DiegoCrUz-afk/Proyecto_Final_Electronica_UNIS/Reduccion2/README.md

# Reducción 2 · miniestación industrial (5 V directos)

Versión de **validación por fases** del proyecto (no es la entrega final): sensor IR, entradas E/G/RESET, pestillo de falla, lógica de decisión, LED de objeto, potencia con motor y LED rojo, alimentada con 5 V.

- **3D para armar y medir** (abre en el navegador): `2_Montaje_3D/Protoboards_3D_reduccion2.html` · en línea: https://diegocruz-afk.github.io/Proyecto_Final_Electronica_UNIS/Reduccion2/2_Montaje_3D/Protoboards_3D_reduccion2.html
- **Guía de pruebas** (40 pruebas, una por una, con la punta roja y la negra): `3_Pruebas/Guia_de_pruebas_Reduccion2.md`
- **Simulaciones y esquemáticos** (LTspice): `1_LTspice/`
- **Resumen de qué está validado y qué no**: `4_Documentacion/LEEME_Reduccion2.md`

Ojo: los valores esperados son de simulación (motor supuesto), no mediciones de la máquina. La potencia y todo lo que dependa del motor real (Steren MOT-125) **no está validado**.
