DiegoCrUz-afk/Proyecto_Final_Electronica_UNIS/CONTEXTO_PROYECTO.md

> Copia sin datos personales de CONTEXTO_SESION.md (sirve para que otra sesion de Claude Code entienda el proyecto). Los nombres de terceros y las rutas del PC estan censurados.

# Contexto: Proyecto Final Electronica UNIS (Miniestacion industrial automatizada)

Ultima actualizacion: 08/11/2026 (LEER la seccion 16 al final: v2 del 3D es la unica vigente, opto, maquina 3D, LED de objeto, motor Steren de 6 V; antes 02/11/2026 seccion 14) (ver seccion 13q al final) (LEER PRIMERO la seccion "12. ESTADO FINAL DE LA SESION 30-31/10/2026 Y PENDIENTES" al FINAL de este archivo, y antes la seccion "AVANCE 30-31/10"; reemplazan al punto 9 "DONDE NOS QUEDAMOS" en lo que se refiere a Multisim. La v6 de Multisim YA esta en el proyecto y en GitHub, commit 423621d). Carpeta: `C:\Users\<usuario>\Documents\Proyecto_Final_Electronica_UNIS`.
Enunciado original: `Enunciado_del_profesor.docx`. Proyecto anterior de referencia (amplificador): `..\electronica-1-amp\claude\CONTEXTO_SESION_ELECTRONICA.md`.

## COMO RETOMAR (leer primero)
- Estimacion de lo que falta: ~2 a 3 horas de trabajo (revisar esquematicos, esquematico jerarquico, Multisim, documento HTML explicativo, BOM, guia de pruebas). Lo mas largo es el documento explicativo.
- Multisim: pedir permiso explicito a Diego para ejecutar el codec ewd/ewe descargado; la prueba vence el 28/10/2026.
- Diego dio autonomia total ("tu elige todo lo mejor, usa LTspice o el MCP de Multisim, continua hasta terminar"). Prioridad de Diego: ENTENDER el esquematico.
- Nada esta corriendo en segundo plano. La simulacion grande ya termino (551 s). Se puede reiniciar el PC sin perder nada.
- Pendiente principal, en este orden: (1) revisar visualmente los 11 esquematicos (`scratch_img\*.png`, ver "Estado de los esquematicos"); (2) crear el esquematico jerarquico del sistema completo (`SISTEMA_COMPLETO.asc`) con simbolos de bloque; (3) Multisim (ver bloqueo abajo; la prueba vence el 28/10/2026); (4) documento explicativo HTML del esquematico por bloques con calculos y capturas; (5) BOM / lista de compras (sin inventar precios); (6) guia de pruebas/mediciones y video/defensa.
- Reglas de trabajo con Diego: responder en espanol, corto, lenguaje sencillo de alumno; no inventar mediciones (separar calculo / simulacion / medicion fisica); documentos sin look de IA; informe solo con datos reales y sin frases de "falta"; Multisim NO se menciona en el informe (solo en archivos de simulacion); componentes faciles de conseguir en Guatemala (La Electronica); no asumir existencias. Los nombres de los demas integrantes los dira Diego al final (hoy solo se sabe Diego; el otro integrante del proyecto anterior era [excompañero del proyecto anterior]; docente del curso anterior: [docente], sin confirmar para este).

## Herramientas, rutas y trampas (verificadas)
- LTspice 26.1.1: `%LOCALAPPDATA%\Programs\ADI\LTspice\LTspice.exe`. Lote: `-b archivo.cir|.asc`; netlist: `-netlist archivo.asc`. El MCP `spice` NO aparece en esta sesion; se usa la linea de comandos.
- Python 3.13: `py -3.13` (tiene PyMuPDF, reportlab; se instalaron numpy y matplotlib). Python 3.12-32 es el del multisim-mcp.
- Libreria de LTspice extraida: `%LOCALAPPDATA%\LTspice\lib` (sym\, sub\). Hay NE555.sub; NO hay modelos de LM358, LM393, LM2907, 74HC, IRLZ44N, BD139 (los modelos propios estan en `modelos.inc`).
- TRAMPA: la PRIMERA linea de un .cir es el titulo y se ignora (un `.include` en la linea 1 no se carga). Siempre empezar con `* comentario`.
- TRAMPA: `.step` con un solo valor da error; `.param` ya definido no se puede redefinir (usar `.step param`). `.meas` con tabla: el log tiene cabecera "step ..." (simlib ya lo maneja).
- TRAMPA: un proceso lanzado con `nohup ... &` desde Bash puede sobrevivir; para simulaciones largas usar `run_in_background` o lanzarlas y esperar (la de 4.6 s tarda ~9 min y genera un .raw de ~800 MB).
- TRAMPA: un interruptor `SW` de prueba con Vt=0/Vh=1m se queda pegado en 0 V; usar Vt=0.5 Vh=0.1.
- Pines de simbolos (verificados): res (16,16)/(16,96); cap, polcap, diode, zener, LED (16,0)/(16,64); npn C(64,0) B(0,48) E(64,96); pnp igual orden C,B,E (emisor abajo); nmos D(48,0) G(0,80) S(48,96); voltage (0,16)/(0,96); current (0,0)/(0,80); OpAmps/opamp2 In+(-32,80) In-(-32,48) V+(0,32) V-(0,96) OUT(32,64); Misc/NE555 GND(-112,-96) TRIG(-112,-32) OUT(-112,32) RST(-112,96) CV(112,96) THR(112,32) DIS(112,-32) VCC(112,-96). Rotaciones: R90 (a,b)->(-b,a); R180 (-a,-b); R270 (b,-a); M180 = espejo vertical.
- LTspice agrega al nombre de subcircuitos el prefijo `X§`; los simbolos propios no deben llevar `SpiceModel` (duplica el modelo en la linea).
- Multisim 14.3 instalado (prueba de 7 dias, VENCE 28/10/2026). `multisim-mcp 1.2.0` en `%LOCALAPPDATA%\Programs\Python\Python312-32\Scripts`, plantillas en `%LOCALAPPDATA%\multisim_pack` (tiene R, C, D, L, NPN, PNP, NMOS, PMOS, opamp5, compuertas dand5/dor5/dnot4, djk7, fuentes, osciloscopio, generador). `multisim-mcp doctor` dice: paquete de plantillas incompleto y codecs `.ms14` ausentes.
- BLOQUEO MULTISIM: el MCP necesita `ewd/ewe` (npm `electronics-workbench-decoder@0.2.0`, ISC, sin dependencias ni scripts de instalacion). El registro npm da ECONNRESET en este PC; se descargaron `ewd.js` y `ewe.js` desde jsDelivr a `%LOCALAPPDATA%\ewtools\dist\` (tamanos coinciden con el listado oficial: 530920 y 535843 bytes; sin llamadas de red/proceso en el codigo). El sistema (clasificador de permisos) BLOQUEO ejecutarlos ("code from external"). NO se debe evadir. Para seguir: pedir a Diego permiso explicito (p. ej. una regla de permiso de Bash o que ejecute el el mismo `multisim-mcp doctor` con `MULTISIM_MCP_EWD/EWE` apuntando a esos .js y `MULTISIM_MCP_TEMPLATE_DIR=%LOCALAPPDATA%\multisim_pack`). Alternativa sin codec: intentar abrir los `.cir` directamente en Multisim (File > Open) o armar a mano.

## AVANCE 26/10/2026 (noche) - hecho en esta sesion
- Revisados a ojo los 9 esquematicos pendientes: bien (Cout y Cd con + hacia el nodo correcto). Detalles esteticos pendientes: etiquetas que se montan en LOGICA/ERROR_AMP/TEMPERATURA/REFVEL (no cambian el circuito). Cpor, Cfv, Cfv2, Cac estan como capacitor sin polaridad (si se usan electroliticos, + hacia v5 / vf1 / vspd).
- Agregado LED rojo + Rl 470 en ALARMA (`Rl f nl 470`, `Dl nl 0 DLED` en sistema.inc y en el generador): el enunciado pide senal luminosa Y acustica. Las simulaciones largas son anteriores al LED (efecto ~8 mA en f, no se repitieron). `comprobar_esquematicos.py`: TODO COINCIDE (11 bloques).
- Creado `3_archivos_tecnicos\generar_sistema.py` -> `2_LTspice\SISTEMA_COMPLETO.asc` (jerarquico, simbolos BLOQUE_*.asy). `LTspice -netlist` lo arma y las conexiones de los 11 bloques coinciden con `sim\sistema_completo.cir`. OJO: LTspice en lote NO expande las hojas BLOQUE_*.asc ("sub-circuit name not defined"); no se probo abrirlo en la interfaz. Para simular se sigue usando `sim\sistema_completo.cir`.
- Prueba pendiente hecha: `sim\sistema_reset_calor.cir` (+ `run_reset_calor.py`, `analisis_reset_calor.py`): reset pulsado 3.40-3.55 s con NTC a 53-54 C NO limpia la falla; f sigue en 1 al enfriarse; reset a 4.20 s con 25 C limpia (1411 rpm a 4.5 s). Disparo termico a t=3.356 s.
- Actualizado `1_Arquitectura\Arquitectura_bloques.html` (sin LM2907, valores finales).
- Creado `4_Documentacion\Explicacion_por_bloques.html` (+ `img\`), `5_Compras_y_Pruebas\BOM_lista_de_compras.csv` (cantidades del esquematico, SIN precios; columnas de precio vacias) y `Guia_de_pruebas.md` (10 pruebas del enunciado con columnas "Medido" vacias).
- Pendiente: Multisim (no se hizo; sigue bloqueado y la prueba vence el 28/10/2026), nombres del equipo, video/defensa, precios reales, borrar `.raw` grandes (`sim\*.raw` ~2.5 GB, `scratch_img`), confirmar con el docente cubierta/encoder/motor, recalibrar con el motor real.

## AVANCE 26/10/2026 (noche, parte 2)
- Simulacion del sistema completo armada desde los esquematicos DIBUJADOS: `sim\armar_desde_asc.py` -> `bloques_desde_asc.inc`, `sistema_desde_asc.cir`, `analisis_desde_asc.py`. Resultados identicos a los de sistema.inc (1394 rpm, 789 rpm con objeto, disparo corriente 2.098 s, temperatura 49.9 C a 3.356 s, cubierta 1.4010 s, v5 5.012-5.018 V). Es la comprobacion de que lo dibujado funciona.
- MULTISIM RESUELTO: el multisim-mcp se maneja desde un cliente stdio propio (`3_archivos_tecnicos\multisim\scripts\mcp_call.py`; variables MULTISIM_MCP_EWD/EWE/TEMPLATE_DIR/WORK_DIR=C:\ms_work); el MCP NO esta registrado en Claude Code. Tool `run_spice_netlist` con commands "op" o "tran 2u 0.2" (sin punto). 11 archivos `multisim\BLOQUE_*.ms14` (abren en Multisim 14.3) y `LEEME_MULTISIM.md` con la tabla de resultados Multisim vs LTspice (todo coincide; 16/16 combinaciones logicas). Cambios de modelo: IRLZ44N -> NMOS nivel 1, NE555 -> 555 de comportamiento. `create_schematic_from_netlist` falla si se pasa `image_path` en ALARMA/POTENCIA (se omitio).
- Borrados los .raw grandes de `sim\` y `scratch_img` (el proyecto pesa ~300 MB). Imagenes de bloques en `4_Documentacion\img`.
- Limite real: el esquematico jerarquico SISTEMA_COMPLETO.asc no se ha abierto en la interfaz de LTspice (en lote no expande las hojas).

## Que es el proyecto
Minibanda transportadora de escritorio sin microcontroladores: motor DC 12 V (<=500 mA), fuente externa 12 V (>=2 A), electronica analogica + compuertas 74HC, montaje final soldado. Entradas: sensor IR (objeto), encoder, shunt, NTC, cubierta. Variables logicas E,G,P,F -> M,N,L,A. Entrega: maquina, esquematico, simulaciones, informe <=15 pags (sin anexos), BOM con costo, video 3-5 min, defensa individual; 10 pruebas en vivo.

## Archivos creados en esta sesion
- `1_Arquitectura\Arquitectura_bloques.html`: diagrama de bloques explicado, guia para leer esquematicos, ecuaciones logicas, lista preliminar de componentes (se escribio antes de decidir los valores finales: revisar contra los valores de abajo).
- `2_LTspice\1_regulador_5V.asc`: prueba del regulador con fuentes (version anterior, hecha a mano). `2_LTspice\BLOQUE_*.asc` (11 bloques) y simbolos `HC_AND2/HC_NAND2/HC_BUF/HC_SCHINV.asy`.
- `3_archivos_tecnicos\`: `modelos.inc` (modelos), `sistema.inc` (subcircuitos de los 11 bloques = FUENTE DE VERDAD del circuito), `simlib.py` (correr LTspice y leer .raw/.log), `asc_lib.py` (generar y dibujar .asc en SVG/PNG con Chrome), `crear_simbolos.py`, `generar_esquematicos.py` (genera los 11 .asc), `comprobar_esquematicos.py` (compara cada .asc con su subcircuito: conexiones y valores), `sim\` (decks y scripts de prueba: `b2_sensor.cir`, `b3_corriente.cir`, `t1_logica.py`, `t2_potencia.cir`, `t3_encoder.cir`, `t4_lazo.py`, `analisis_lazo.py`, `t5_err.cir`, `t7_bloques.py`, `t8_sensor.py`, `sistema_completo.cir`, `analisis_sistema.py`, `sistema_completo_resumen.npz`). El `sistema_completo.raw` (~800 MB) se puede borrar.
- `scratch_img\`: renders PNG/SVG temporales de los esquematicos (se pueden borrar al terminar).
- Los `.net`, `.raw`, `.log` generados en `2_LTspice` y `sim` son temporales.

## DISENO FINAL (valores simulados; nombres = refdes de sistema.inc)
Nodos: vin (12 V), vm (12 V tras D1), v5 (5 V), 0 (tierra). Entrada: V12 -> D1 1N4007 -> vm, Cin 1000 uF en vm. Todos los modelos propios estan marcados en `modelos.inc`.
1. REG5V (vm,v5): Rz 510, DZ Zener 5.6 V (1N4734A), Rtr trimpot 100 ohm en serie con el Zener (ajuste ~10 ohm), Q1 BD139 de paso, Cout 100 uF, C2 100 nF.
2. SENSOR_IR (v5,b,tin,p): LED IR con Rled 270 (~14 mA); fototransistor TCRT5000 (modelo: fuente de corriente en b: 2 uA sin objeto, 50 uA con objeto); R1 47k, R2 10k (Vb 0.82 V), Q2 2N3904 emisor comun, Rc 680, RE 150 (sin puentear), Cac 1 uF (puerto de prueba tin); umbral: Ra 10k + trimpot 10k + Rb 26.8k (20k+6.8k); LM393 con Rpu 10k y Rh 220k (histeresis).
3. SOBRECORRIENTE (vm,v5,sh,setn): Rsh 0.47 ohm 1 W (en POTENCIA), LM358 ganancia 7.8 (Rg 1k, Rf 6.8k), D1 1N4148 + Cpk 100 nF + Rbl 22k (detector de picos), Rd 10k + Cd 10 uF (retardo ~0.1 s), LM393 con referencia Ra 10k + trimpot 10k + Rb 10k (koc=0.2 -> Vref 2 V -> disparo ~0.7 A).
4. TEMPERATURA (v5,tnode,setn): NTC 10k (B 3950) de v5 a tnode, Rfix 10k a tierra; umbral Ra 22k + trimpot 10k + Rb 68k; LM393; Rh 1 Meg (histeresis ~2.6 C).
5. LOGICA (v5,ein,gin,rin,p,setn,m,n,l,f,fn): entradas con Rp 10k a tierra, Rs 10k + C 100 nF, dos inversores Schmitt 74HC14 por entrada; pestillo NAND 74HC00 (setn activa en bajo; reset_n = NAND(rst,setn): el reset solo actua si ya no hay falla); P' = NAND(P,P); 74HC08: M1=E.G, M=M1.F', N=M.P', L=M.P; A=F. Reset automatico al encender (Cpor 1 uF + Rpor 47k + Dpor). setn tiene pull-up 10k (Rsn) y es un AND cableado de los comparadores de corriente y temperatura (colector abierto).
6. PWM_GEN (v5,vctrl,pwm): NE555 astable (Ra5 1k, Rb5 10k, Ct 10 nF, Ccv 10 nF) ~6.9 kHz, rampa en el condensador (1.7-3.3 V); LM393 compara vctrl con la rampa; Rpu 10k.
7. POTENCIA (v5,vm,pwm,m,dm,sh): 74HC08 AND(pwm,m); seguidor complementario Q3 2N3904 / Q4 2N3906 desde 5 V; Rg 47, Rpd 10k; M1 IRLZ44N (nivel logico; NO usar IRF540N/IRFZ44N sin driver de 12 V); Dfw 1N5819 de dm a vm; Rsh 0.47.
8. ENCODER_FV (v5,enc,vspd): LED del optointerruptor Rled 220; fototransistor con Rpe 10k; LM393 (Ru1/Ru2 10k, Rhe 1 Meg); derivador Cd 1 nF + Rtg 10k + Dcl 1N4148; NE555 monoestable (Rt7 20k, Ct7 10 nF -> 220 us); buffer HC; filtro RC doble (10k+1 uF, 10k+1 uF). Vspd = 5 V x 220 us x f = 1.1 mV/Hz. Disco de 20 ranuras.
9. REFVEL (v5,l,vref): Rt 68k + trimpot Rp1 10k (kvn 0.8 -> Vref 0.526 V); Q5 2N3904 conectado por l con Rb5 10k pone Rp2 (10k, kvr 0.7) en paralelo -> reducida ~50 %.
10. ERROR_AMP (vm,v5,vref,vspd,vctrl): LM324 (4 amplificadores): 3 seguidores (Xbr, Xbs, Xbo) + resta Xu2b: vctrl = Kerr(vref-vspd)+Voff, Kerr=10 (R 10k/100k, Cf6 10 nF), Voff = 4.7k/5.1k desde 5 V = 2.6 V, Ro 1k + Cvc 100 nF. Lazo abierto = alimentar vctrl con un trimpot.
11. ALARMA (vm,f): Rb 1k, Q6 2N3904, buzzer 12 V (modelo Rbz 400 ohm). Ic/Ib = 7.5 (saturado).
Motor de simulacion (supuesto, NO es el motor real): Ra 12 ohm, La 3 mH, Ke=Kt=0.035 V.s/rad, J 1e-5, B 7.2e-6, carga 0.004 N.m (+0.004 de perturbacion), encoder 20 ranuras. Cuando se elija el motor real hay que recalibrar el trimpot de sobrecorriente y la referencia.
Chips: LM324 x1 (o 2 LM358) + LM358 x1 para el shunt; LM393 x2 (o LM339+LM393); NE555 x2; 74HC00, 74HC08 x2, 74HC14 x1. LM2907 NO se usa (se sustituyo por 555 monoestable + RC).

## RESULTADOS DE SIMULACION (todos son LTspice, no mediciones fisicas)
- Regulador (Vin 11-13 V, carga 30-120 mA, hFE 40-250): Zener 5.6 exacto 4.84-4.95 V (cumple 5 V +-5 %); Zener -5 % sin ajuste 4.56-4.68 V (NO cumple) y con Rtr 38-45 ohm 4.79-5.23 V (cumple); Zener +5 % 5.11-5.23 V (al limite). Disipacion del BD139 en el peor caso (13 V, 120 mA): 0.85-0.92 W -> disipador. En el sistema completo con motor: v5 = 5.012-5.018 V, vm minimo 11.13 V, I(D1) max 0.95 A.
- Sensor IR (hFE 100/200/400): sin objeto Vc 4.30/4.17/4.08 V, p=0.03 V; con objeto 50 uA Vc 3.22/2.86/2.61 V, p=4.93 V; umbrales 3.30 (baja) / 3.52 V (sube); Vce con objeto 2.1-2.8 V (sin saturacion; satura recien a >100 uA); corriente de 5 V del bloque ~15.5 mA. Ganancia AC -3.95 (11.9 dB, fase 180), Zin ~6.7 kohm (con Cac), Zout ~Rc 680 ohm.
- Sobrecorriente: disparo ~0.71 A (Vref 2.0 V); arranque 1.5 A durante 30 ms -> Vdl max 1.11 V (no dispara); 0.55 A sostenido no dispara (1.47 V); 0.9 A sostenido dispara a los 56 ms. En el sistema completo disparo a t=2.098 s (carga extra desde 1.9 s, Im max 0.82 A).
- Temperatura: umbral ajustable de 44.0 C a 56.8 C (cursor 0.02 a 0.98), centro 49.9 C; histeresis 2.5-2.7 C. En el sistema: disparo a 49.9 C.
- Logica: tabla de verdad de 16 combinaciones de E,G,P,F verificada con el circuito real (pestillo, reset, Schmitt): TODAS OK. El reset solo limpia cuando ya no hay falla.
- PWM y potencia (abierto): Vctrl 2.4 V -> ciclo 0.44 (teorico (2.4-1.67)/1.67); compuerta 0 a 4.36 V, Vds max 11.5 V.
- Encoder + F-V: lineal 1.1 mV/Hz (100 Hz 0.119 V, 500 Hz 0.557 V, 1 kHz 1.106 V), rizado 14-26 mV pp con el filtro doble.
- Lazo cerrado (motor supuesto): normal 147 rad/s (1403 rpm), error 2 % respecto a la referencia; reducida 82.4 rad/s (786 rpm) = 56 % de la normal; con carga extra baja 6.5 % (lazo ABIERTO con el mismo vctrl: baja 25.9 %); arranque al 95 % en 0.08 s, sobreimpulso 18 %, corriente de arranque 0.88 A; estabilizacion tras el cambio normal->reducida 0.19 s.
- Sistema completo (guion de eventos, 4.6 s): normal 1394 rpm Im 0.150 A; objeto presente: L=1, N=0, 789 rpm; objeto retirado 1415 rpm; cubierta abierta (t=1.40 s): M cae en 1.4010 s (motor 0 A); cubierta cerrada: reanuda 1392 rpm; falla de corriente: f=1 (alarma 4.8 V), M=0, motor parado, la falla sigue despues de quitar la carga; reset a 2.6 s limpia (1409 rpm); falla de temperatura a 49.9 C; el reset de 3.55-3.70 s fue efectivo porque el NTC ya habia bajado de ~47 C (esperado: el reset solo actua cuando la causa desaparecio). PENDIENTE: repetir la prueba de "reset con calor" pulsando el boton entre 3.40 y 3.55 s para mostrar que NO limpia mientras hace calor.
- Observacion: con el motor parado por falla, vctrl del amplificador de error sube a 7.65 V (sin integrador, no hay windup); al reanudar no hay golpe.

## ESTADO DE LOS ESQUEMATICOS
- `generar_esquematicos.py` genera los 11 `BLOQUE_*.asc` (con pines de bloque marcados con *); `comprobar_esquematicos.py` dice TODO COINCIDE (conexiones y valores iguales a sistema.inc; los capacitores se comparan sin polaridad: revisar a ojo los electroliticos: Cin, Cout, Cd, Cpor deben tener + hacia el nodo de mayor voltaje).
- Revisados visualmente: SENSOR_IR y POTENCIA (bien). Falta revisar a ojo: LOGICA, ENCODER_FV, ERROR_AMP, SOBRECORRIENTE, PWM_GEN, REG5V, TEMPERATURA, REFVEL, ALARMA (ya se re-renderizaron en `scratch_img`). Detalles a pulir: etiquetas que se montan, texto largo.
- Falta el esquematico del sistema completo (jerarquico con simbolos de bloque en `crear_simbolos.bloque()`, ya definida) y probar que `LTspice -netlist` lo arma. Los .asc de bloque son "puros" (sin fuentes): para simular se usa `sim\sistema_completo.cir`.

## Decisiones tomadas por la IA (Diego delego)
- Sin modulacion del LED IR (acople en continua, corriente inyectada en la base); regulador con trimpot de ajuste; LM2907 reemplazado por 555 monoestable; MOSFET de nivel logico con excitador complementario a 5 V (seguro: si falla el 5 V el MOSFET queda apagado); reset con POR; cubierta NO enclava (solo corta M); alarma = F.
- Falta confirmar con el docente: si la cubierta debe enclavarse; si el encoder puede ser un modulo con comparador; que motor usar.

## Inventario y compras
- Del proyecto anterior (cantidades sin confirmar): resistencias 10 a 1M casi todos los valores comunes; 2N3904 x5, 2N3906 x5, 1N4148 x10, 1N4007 x6, electroliticos 1 uF x5 y 10 uF x5, 100 uF, 1000 uF, 100 nF, 470 pF, BD139/BD140 x2 c/u, trimpot 3296W 100 ohm x2, 2N7000 x3, bocina 4 ohm. Equipo: NI ELVIS II, Rigol DP832, Analog Discovery 3, multimetro, bateria 9 V.
- Hay que comprar (no estan en el inventario): Zener 5.6 V 1N4734A, NE555 x2, LM324 (o LM358 x2), LM393 x2, 74HC00/08/08/14, IRLZ44N (o IRL540N/IRLZ34N), 1N5819 x2, Rsh 0.47 ohm 1 W, 220 ohm/270 ohm/47 ohm/22k/6.8k/56... (revisar con la lista), trimpots multivuelta 10k x5, NTC 10k, TCRT5000 (o LED IR + fototransistor), optointerruptor ranurado + disco de 20 ranuras, microswitch/lengueta, pulsador, interruptor, buzzer activo 12 V, LEDs, capacitores 10 nF/1 nF/1 uF, disipador TO-126/TO-220, motor DC 12 V con caja reductora, placa perforada, borneras, jack, fusible. Sin precios hasta tenerlos reales.

## Equipo
Diego + otros integrantes (Diego los dira al final).

## AVANCE 27/10/2026 (madrugada): jerarquia LTspice, Multisim completo y 3D
- LTspice jerarquico RESUELTO: los simbolos BLOQUE_*.asy NO deben llevar `SYMATTR Prefix/Value` (con eso LTspice lo trata como subcircuito normal). Cada hoja BLOQUE_*.asc lleva su `.param` (kir, koc, ktm, kvn/kvr, Kerr). `SISTEMA_COMPLETO.asc` trae fuente, eventos, NTC y motor y simula tal cual (`sim\run_jerarquico.py`, `analisis_jerarquico.py`): mismos resultados que sistema.inc.
- Multisim sistema completo: `multisim\scripts\ms_sistema.py` (555 de comportamiento, NMOS, compuertas suavizadas, `uic`); llego a 0.185 s (memoria): arranque, objeto, cubierta OK. Falla/temperatura/reset solo por bloque y en LTspice. Detalle en `multisim\LEEME_MULTISIM.md`.
- 3D: `6_Montaje_3D\Montaje_3D_miniestacion.html` (ver LEEME.md de esa carpeta). Codigo en `3_archivos_tecnicos\montaje3d\`. El modo funcionamiento usa `sim\sistema_desde_asc_resumen.npz`. Basado en el 3D del proyecto del amplificador (`electronica-1-amp`).
- Para abrir el 3D desde el navegador de Claude: `py -m http.server` en `6_Montaje_3D` y abrir http://127.0.0.1:8765/... (el Chrome headless se cuelga con WebGL).

## AVANCE 27/10/2026 (final de sesion)
- Diseno: MOSFET IRFZ44N (modelo IRFZ44N_P en modelos.inc) y shunt 0.5 ohm 5 W, porque La Electronica no vende IRLZ44N ni 0.47 ohm; sistema re-simulado OK (1393/789 rpm, disparos y reset). Compras solo en La Electronica (Tettsa = respaldo). Resistencias: todas con valores que Diego ya tiene (150=100+47, 270=220+47, 22k=20k+2k).
- LTspice: `2_LTspice\SISTEMA_COMPLETO.asc` = esquematico completo en una hoja con cables (se simula con Run, verificado); `SISTEMA_JERARQUICO.asc` = version por hojas. Cableado automatico: `asc_route.py`. Bloques con `.param` propios.
- PCB: `3_archivos_tecnicos\pcb\` (generar_pcb.py): 10 placas de cobre de 10x10 cm (la mas grande de la tienda), 1 cara, planchado; salida en `pcb\salida` (PDF espejo, componentes, taladros). Verificado por conectividad.
- 3D: `6_Montaje_3D\Placas_de_cobre_3D_miniestacion.html` (pistas, vista de cobre, modo funcionamiento) y `Montaje_3D_miniestacion.html` (prototipo con cables) con boton para cambiar entre ambos. PENDIENTE: version protoboard real (tiras de 5 agujeros).
- Compras: `5_Compras_y_Pruebas\Lista_de_compras_La_Electronica.pdf` (precios reales 27/10/2026).
- Multisim: los .ms14 generados salen con cajas genericas y layout feo; PENDIENTE hacerlos nitidos (el generador acepta OPAMP5 nativo con `X... LM358`, compuertas nativas con lineas `A... AND/NAND/NOT`, 555 con 8 nodos y modelo NE555; fuentes como `DC 12`). No usar V sin `DC`.

## ESTADO FINAL 27/10/2026 + PENDIENTES (leer primero al retomar)
Pedidos de Diego (todos vigentes): usar SOLO componentes de La Electronica (Tettsa = respaldo/investigar); usar las resistencias que ya tiene (valores del amplificador, ver arriba); placa de cobre de la tienda = 10x10 cm (la mas grande), sin perforar (Diego hace los agujeros, planchado); no crear archivos raros (.net/.raw/.op/.csv/.log) en las carpetas de entrega: solo lo que abre normal (.asc/.asy/.ms14/.pdf/.html/.png); verificar siempre que abre; ahorrar tokens (respuestas cortas).
HECHO: LTspice SISTEMA_COMPLETO.asc (hoja unica con cables, simula con Run; resultados 1393/789 rpm, disparos y reset OK) y SISTEMA_JERARQUICO.asc; 2_LTspice limpiada; PCB 10 placas 10x10 cm (pcb\salida); 3D de placas de cobre con pistas, vista de cobre y modo funcionamiento + 3D "prototipo con cables" con boton para alternar; lista de compras PDF (Q595.50, La Electronica); diseno con IRFZ44N y shunt 0.5 ohm 5 W.
PENDIENTE (orden): (1) 3D en PROTOBOARD REAL (2 a 4 protoboards, tiras de 5 agujeros, canal, rieles, cables numerados) como guia junto al esquematico, con boton a vista de placa de cobre; lo actual no se ve como protoboard. (2) Multisim NITIDO: .ms14 con piezas nativas (op-amps `X... LM358` 5 nodos; compuertas `A... AND/NAND/NOT`; 555 `X` 8 nodos NE555; fuentes `DC 12`), osciloscopio, y verificar que abren y corren en Multisim; los .ms14 actuales (3_archivos_tecnicos\multisim) salen con cajas genericas y desorden. En Multisim se pueden crear componentes si falta alguno. (3) Revisar a ojo que el esquematico de LTspice se entienda (p. ej. BLOQUE_ERROR_AMP desacomodado). (4) Consultar Tettsa (tienda.tettsa.gt) como respaldo. (5) Medir corriente del motor (la tienda no la publica; max 500 mA).
Herramientas: tienda = Chrome en laelectronica.com.gt con fetch a /search/suggest.json?q=... (leer salida en trozos de <800 caracteres); regenerar 3D: pcb\exportar_pcb3d.py y montaje3d\exportar_montaje3d.py; PCB: pcb\generar_pcb.py (~3 min); lista de compras: 5_Compras_y_Pruebas\generar_lista_de_compras.py.

## AVANCE 27/10 (mañana) - cierre
- Multisim: los 11 BLOQUE_*.ms14 con piezas nativas y acomodo ordenado; abren todos (open_circuit). Causas de los fallos: open_after_build=True fallaba en ERROR_AMP; el 555 se arma con partes (ne555() en multisim/scripts/ms_nativo.py); nodos/modelos con {B3904} se reemplazan por 200. Las imagenes necesitan open_circuit antes de get_circuit_image.
- Corregido en docs/3D: shunt 0.5 ohm 5 W, MOSFET IRFZ44N (Explicacion_por_bloques, Guia_de_pruebas, etiquetas 3D). LEEME del 3D reescrito (protoboards + 3 placas de cobre de una cara).
- pcb/salida verificado: solo placas A, B, C. Pendiente real: medir corriente del motor (<=500 mA) con el motor comprado.

## AVANCE 27/10 (cierre final)
- 555 en Multisim: armado con partes nativas (ne555() en 3_archivos_tecnicos/multisim/scripts/ms_nativo.py; posiciones en ms_lay.py). Probado en el motor de simulacion con comparadores/compuertas de comportamiento: PWM_GEN oscila ~6.6 kHz (LTspice 6.9 kHz); ENCODER_FV genera pulsos y vspd sube hacia ~0.56 V a 500 Hz. Los .ms14 no tienen sondas, asi que no se corrieron en el motor propio de Multisim. Los 11 .ms14 abren.
- LTspice: BLOQUE_ERROR_AMP recableado (Rf6, Cf6, R4 con cables; coordenadas en rejilla de 8; antes 700 caia fuera de rejilla y el router perdia la conexion). SISTEMA_COMPLETO/JERARQUICO regenerados; comprobar_esquematicos.py = TODO COINCIDE. Nodo voff queda por etiqueta.
- Limpieza: borrados .net (los crea comprobar_esquematicos.py en 2_LTspice, borrarlos despues), .cir de sim, __pycache__.
- Pendiente (para cuando se compren los materiales): medir corriente del motor (<=500 mA) y recalibrar.
- Revision visual de los 11 bloques LTspice (render con asc_lib.render_svg + fitz): todos conectados con cables. Se cablearon a mano TEMPERATURA (tnode, ref, Rh), SOBRECORRIENTE (ref), PWM_GEN (TRIG del 555 a tri), ENCODER_FV (Rhe a eref) y ERROR_AMP (voff). El router sigue listando esas redes como "sin cablear" porque no reconoce los cables manuales; comprobar_esquematicos.py da TODO COINCIDE.
- Multisim: create_schematic_from_netlist con probe_nets no genera salidas utilizables por run_transient (enum_outputs vacio), asi que los .ms14 no se pueden correr por herramienta; para correrlos en Multisim hay que poner un osciloscopio a mano.

## AVANCE 27/10 (esquematico unico)
- LTspice: SISTEMA_COMPLETO.asc ahora une los bloques con CABLES (22 redes entre bloques) y no solo etiquetas; v5, vm y GND siguen como etiquetas/simbolos. Se arreglaron coordenadas fuera de rejilla de dibujar_externos (generar_sistema.py) y asc_route.py ya no toca redes fuera de rejilla (las deja con etiqueta). Netlist verificado igual (98 redes, misma particion) con LTspice -netlist. PNG: 2_LTspice/SISTEMA_COMPLETO_esquematico.png (generado con asc_lib.render_svg + fitz, dpi 100).
- Multisim: MULTISIM_MCP_SHEET="ancho,alto" fija el tamano de hoja; ms_lay.layout() normaliza posiciones para que todo quede dentro (rieles a y=80, piezas desde x=100). ms_full.py arma SISTEMA_COMPLETO.ms14 (hoja 14061x1736, 153 piezas). No se simulo en el motor de Multisim (los .ms14 no tienen sondas).
- Verificacion de Multisim con su propio reporte de netlist (report_netlist): todas las redes coinciden con la esperada; v5 y GND difieren solo por las patas de alimentacion implicitas de las compuertas digitales. Guia de componentes: 4_Documentacion/Guia_de_componentes.html (generar_guia_componentes.py). PDF de placas copiados a 7_PCB_placas_de_cobre.
- LTspice: ahora v5, vm y GND tienen RIEL dibujado en cada bloque (asc_route.buses, se llama desde guardar()) y la hoja completa une los rieles v5 y vm entre bloques con cable; GND entre bloques queda con simbolos de tierra (el router no pudo unirlo). Netlist de la hoja completa verificado igual (98 redes). Pines fuera de rejilla (comparadores/NE555 en x=668, etc.) siguen con etiqueta. NE555 del bloque PWM movido a x=296 para quedar en rejilla.
- PCB regenerado (27/10 tarde): CLEAR 1.0 mm, pistas 1.0 mm, pads 1.8 mm, separacion minima entre pistas 2 celdas (2.54 mm centro a centro), margen 4 agujeros (10 mm), GND rayado cruzado 45 grados (zona rayada = tierra, pads de GND en azul en componentes), nombres de red junto a cada pad, y PLACA_X_guia_de_conexiones.pdf (a donde va cada pata + cables entre placas). Medidas: A 137.2x172.7 (21 puentes), B 137.2x193.0 (48), C 137.2x188.0 (33). generar_pcb.py tarda ~14 min. Los agujeros de la fila de arriba son los puntos de union entre placas (conectados a las piezas con puente de alambre, lineas magenta).
- Multisim: SC=1.9 en ms_lay.py, fuentes de prueba en columna izquierda, R/C horizontales solo si lo son en LTspice. Revision visual: legible pero con cables largos; Rg/Rpd de POTENCIA siguen muy juntas (conflicto de anclaje de simbolos horizontales).
- Multisim: ms_post.py retoca los .ms14 (decode_ms14 -> XML: Wire Width=3, Show Node Names=1, Pen-Width de cables=3 -> encode_ms14) para que los cables y los nombres de red se vean. decode_ms14 puede dejar un .xml junto al .ms14: borrarlo. Si se regeneran los .ms14 con ms_lay.py / ms_full.py hay que volver a correr ms_post.py y copiar.
- LTspice hoja completa: generar_sistema_plano.py ya NO une v5/vm entre bloques con cables largos y solo cablea redes entre bloques de hasta MAXLEN=1900 unidades (10 redes); las demas quedan con etiqueta. Netlist igual (98 redes). Multisim hoja completa: ms_full.py da a cada red entre bloques de 3+ pines un riel propio arriba (11 redes) y luego hay que correr ms_post.py; sigue con cables largos y cruces (limite del generador); la lectura clara es la de LTspice y los bloques sueltos.
- Multisim: ms_lay.separar() empuja las piezas que quedan montadas (tamanos aproximados por tipo) y el 555 armado usa una cuadricula de 5 columnas (300 x 250); luego ms_post.py. Revisado a ojo: POTENCIA (Rg/Rpd ya separadas), SENSOR_IR (Cac fuera de R2) y ENCODER_FV (partes del 555 separadas).
- PCB: Diego prefirio el diseno ANTERIOR del cobre (pistas 0.8 mm, separacion 0.5 mm, margen 3 agujeros, GND liso). Se volvio a ese diseno (132.1 x 167.6/188.0/182.9 mm; 19/49/29 puentes). Se conservaron solo los extras que no cambian el cobre: nombres de red en la vista de componentes, pads de GND azules y PLACA_X_guia_de_conexiones.pdf. La version con rayado/mas separacion esta guardada fuera del proyecto (no se entrega).

## Multisim: cables y rendimiento (27/10, tarde)
- ms_lay.py: cada red de 3+ pines tiene su propio carril (`canales()`), y `distintas_x()` evita que dos patas compartan columna (no se montan cables verticales). ms_post.py ya no activa "Show Node Names" (era lo que mas pesaba).
- Se regeneraron los 11 bloques + SISTEMA_COMPLETO y su PNG. Respaldo de la version que el usuario guardo a las 16:21: C:\ms_work\respaldo\SISTEMA_COMPLETO_usuario_1621.ms14 (fuera del proyecto).
- LED de banda (Rbanda 1k + Dbanda DLED, vm->nbanda->dm) agregado a BLOQUE_POTENCIA y SISTEMA_COMPLETO (ms_nativo.TB POTENCIA y ms_full ext). Se comprobo que el .ms14 que el usuario guardo (18:59) tenia las mismas posiciones que el generado, asi que se regenero (respaldo en C:\ms_work\respaldo\SISTEMA_COMPLETO_usuario_1859.ms14). Corriente del LED calculada a mano (~10 mA con el MOSFET encendido), no simulada.

## Decision: todo en protoboard (27/10)
- Ya no se hacen placas de cobre. Lista de compras sin placas de cobre, cloruro, papel, brocas ni pinheads (total Q503.75, antes Q629.25). Nada se compro en Tettsa. 7_PCB y la pagina 3D de cobre quedan como referencia.
- Lista: +2 paquetes Jumper 30 cm MxM (Q10 c/u, La Electronica, en existencia) para unir protoboards; total Q523.75. 3D: 20 uniones entre protoboards y 20 a piezas externas.
- Lista: quitados jumpers y borneras (el usuario ya tiene cable de protoboard y jumpers; sin placa no hay borneras). Total Q503.75 - borneras.

## Estado final (27/10/2026)
- Montaje: todo en protoboard (5 protoboards segun el 3D) con alambre de protoboard y jumpers que ya se tienen. No hay placas de cobre; la carpeta 7_PCB y la pagina 3D de cobre quedan solo de referencia.
- Compras: solo La Electronica, total Q493.75 (5_Compras_y_Pruebas/Lista_de_compras_La_Electronica.pdf).
- LTspice: 2_LTspice (esquematico completo + bloques + PNG). Multisim: 3_archivos_tecnicos/multisim (11 bloques + SISTEMA_COMPLETO; SISTEMA_COMPLETO_con_LED tiene el LED que indica banda funcionando; hoja agrandada para mover cables).
- Documentos: 4_Documentacion (guia de componentes, explicacion por bloques). Pruebas: 5_Compras_y_Pruebas/Guia_de_pruebas.md. 3D: 6_Montaje_3D.

## AVANCE 28-29/10/2026: lista solo protoboard, GitHub, Multisim
- Lista de compras SOLO protoboard (total Q495.00, PDF regenerado): jack de panel 5.5x2.5 (Q4, con cables), switch toggle SPDT 6 A (Q6), pulsador 6x6x15 de 4 pines (Q1), portafusible aereo 5x20 (Q5), CE100 de 25 V (Q1.25), estano 0.8 mm (Q3/m, agregado porque hay piezas con cables). Quitados del archivo de precios: placas de cobre, cloruro, papel, brocas, borneras. Generador sin codigo de placas. Arquitectura_bloques.html y 6_Montaje_3D/LEEME.md corregidos (montaje en protoboard).
- Precios y existencias revisados en laelectronica.com.gt (Chrome "DIEGO_CRUZ", 28/10). Todo lo de la lista existe. Sin confirmar: motorreductor 12 V 60 RPM (Q34) no aparecio en la busqueda (salio un N20 12 V 200 RPM a Q55). Fusible de 1 A de 5x20 no aparece (hay 0.5 A de 6x30 y 10 A de 5x20).
- Revision del esquematico contra la lista: cantidades y valores coinciden. Pendientes de decidir: (1) el LED de banda (Rbanda 1k + Dbanda) esta solo en Multisim, no en sistema.inc, y la lista trae un solo LED (el de alarma); (2) 5 LM393 en 5 chips y 3 chips 74HC08 (uno por bloque) se podrian reducir a 3 y 2 (unos Q13); (3) IRFZ44N con compuerta a ~4.3 V: medir Vds con el motor real.
- GitHub: commit 3903778 "Lista de compras solo para protoboard: quitar piezas de placa" subido a origin/main (DiegoCrUz-afk/Proyecto_Final_Electronica_UNIS). CONTEXTO_SESION.md y el enunciado estan en .gitignore y NO se suben (llevan nombres de terceros y rutas). El jack tambien se podria soldar con cables; no hay adaptador hembra a bornera en la tienda.
- Multisim 14.3 (prueba renovada por Diego a 48 dias). multisim.exe es de 32 bits: se aplico el parche Large Address Aware (hasta 4 GB) con `parche_multisim_4GB.ps1` (como administrador, con UAC). Respaldo del original: C:\ms_work\respaldo\multisim.exe.original; para deshacer, correr el script con -Deshacer. Diego dice que el parche ayudo. Se cerraron Epic, EOS overlay y Phone Experience (RAM libre 5.77 -> 6.12 GB).
- PROBLEMA ABIERTO: SISTEMA_COMPLETO.ms14 se cierra solo al empezar a crear un cable (se queda cargando y se cierra). Registro de Windows: acceso invalido (0xc0000005) en Od101dll.dll, mismo punto (desplazamiento 0x47278) el 28/10 19:08 y el 29/10 01:33 (este ya con el parche); el 27/10 20:03 fue parecido. Hoja del archivo: 18960 x 4754 (el dibujo llega a ~17460 x 2354); 1741 objetos, 494 cables, ancho de cable 3. Diego NO quiere dividir el esquematico ni achicar la hoja de ancho.
- Copias de prueba (fuera del proyecto, en C:\ms_work\prueba, abren bien en ~70 s): SISTEMA_C_hoja_18960x3000.ms14 (ancho completo, altura 3000), SISTEMA_A_ancho_global_1.ms14 (cables nuevos de ancho 1), SISTEMA_B_ancho_1_todo.ms14 (todos los cables de ancho 1). Falta que Diego diga cual NO se cierra al crear un cable. Si una funciona, pasarla como archivo principal con respaldo del original. Otra prueba: desactivar autowire en Options > Global Options > Preferences. No se pudo reproducir el cierre desde aqui (no hay control de la ventana de Multisim).
- Aviso: decode_ms14 deja un .xml junto al .ms14 que se lee (se borraron los de multisim\). El proyecto quedo con 0 archivos sin guardar en git tras todo esto.

## AVANCE 29-30/10/2026 (noche): cierre de Multisim, patas tapadas por cables, esquematico horizontal  (LEER COMPLETO)
Todo este bloque se hizo FUERA de la carpeta del proyecto. El proyecto y GitHub NO se tocaron (el esquematico bueno aun no esta en el proyecto).

### 1. El problema que costo que Claude entendiera (la explicacion que faltaba)
- Sintoma que veia Diego: en Multisim, una pieza (ej. R1 de 47k en SENSOR_IR) parece tener UNA pata sin cable (se ve un cuadrito azul en la pata de abajo y ningun cable sale de ahi). Al intentar tirar o mover un cable ahi, Multisim se congela y se cierra.
- Error mio al inicio: en el video vi la pata "sin cable" y dije que probablemente estaba suelta (sin conectar). ERA FALSO. Diego averiguo la causa real: la pata SI esta conectada, pero el cable de esa pata queda DIBUJADO ENCIMA de otro cable (o encima de la propia pieza), asi que visualmente parece que no hay cable. Eso pasa con muchas piezas, no solo con R1.
- Causa de fondo (confirmada en el PNG ampliado y en el esquematico regenerado): el generador ponia R/C en VERTICAL cuando eran verticales en LTspice. Una pieza vertical tiene las dos patas en la misma columna x; el cable de la pata de abajo sube por esa misma columna hacia el riel de arriba y pasa POR ENCIMA del cuerpo de la resistencia y de su otra pata. Por eso se ve "sin cable". Los cables montados unos sobre otros tambien son lo que no deja mover un cable a mano y probablemente lo que dispara el cierre.
- Solucion que Diego propuso y que funciono: poner TODAS las resistencias y capacitores en HORIZONTAL. Cada pata saca su cable hacia arriba por su propia columna y ningun cable tapa a otra pata.
- Por que costo entenderlo (para no repetirlo): (a) el video/captura solo muestra "pata sin cable", no "cable encima de la pieza"; (b) mi analisis automatico del XML calculaba mal la geometria: asumia pines horizontales segun Transformer-M00..M21 (identidad) y daba R1SEN horizontal, cuando en pantalla es vertical (la rotacion no esta en esos Transformer del CIITSymbolComp; solo coincidian 140 de 445 patas con extremos de cables). Conclusion: NO confiar en el XML decodificado para decidir que pata esta tapada; la verificacion confiable es VISUAL, sobre el PNG que genera Multisim (get_circuit_image) recortado y ampliado. Diego tenia razon al pedir "verificalo perfectamente" y al decir que yo no notaba esos cables.

### 2. Evidencia del cierre (para no volver a investigar)
- Video: `C:\Users\<usuario>\Videos\Captures\SISTEMA_COMPLETO - Multisim - [SISTEMA_COMPLETO _] 2026-10-29 22-26-16.mp4` (24 s). Se ve R1 con cuadrito azul en la pata de abajo, el cursor de cable (+) y la pantalla congelada desde 22.9 s hasta el final. Para verlo se sacaron fotogramas con OpenCV (instalado en una carpeta temporal de la sesion; Claude no lee .mp4 directo y ffmpeg no esta instalado).
- Registro de Windows (Application, Id 1000): multisim.exe 14.3.1500.0, modulo Od101dll.dll, excepcion 0xc0000005, desplazamiento 0x47278 en TODOS: 28/10 19:08, 29/10 01:33, 29/10 22:26 (el del video), 22:34 y 30/10 00:20. Mismo punto siempre, en la ruta de C:\ms_work y tambien en Documentos => NO depende de la carpeta; es un fallo interno de Multisim con este esquematico.
- Las 3 copias de prueba del archivo viejo (A, B, C en C:\ms_work\prueba) NO resolvieron el cierre (Diego probo C: mismo problema; B se abrio despues). Autowire off no se probo.

### 3. Lo que se hizo
- Se copiaron los scripts (mcp_call, ms_nativo, ms_lay, ms_full, ms_post) a una carpeta de sesion y se cambio SOLO en la copia: ms_lay.py agrega `vert.clear()` antes de `separar(pos, vert)` y ms_full.py cambia `vert += ["Rmot", "Rbanda"]` por `vert.clear()` (todo R/C horizontal), y las rutas de salida pasan a `C:\ms_work\horizontal\`. Se corrio ms_full (hoja 18005 x 2354, 156 piezas, incluye Rbanda/Dbanda = LED de banda) y luego ms_post (ancho de cable 1, nombres de red ocultos, 498 cables). Abre bien (open_circuit sin errores). Los scripts originales del proyecto NO se modificaron.
- Verificacion visual (get_circuit_image -> recortes): R1, R2, RcSEN, RESEN, RpuSEN, RhSEN, RfOC, RgOC, CacSEN y Q2 quedaron con las dos patas visibles y sin cables encima.
- Resultado para Diego: "funciono mil veces mejor": podia tocar un cable y se auto-ordenaba, sin cierres durante unos 20 min (22:57 a 23:15). Diego ademas arreglo a mano algunos cables de compuertas y guardo a las 23:15 (ese guardado es el bueno).
- Revision de lo guardado a las 23:15: R y C bien. Quedan MAL (cables encima o pegados a las patas; marcados con circulos en REVISION_marcado.png): 1 Xu1SEN (no verificado ampliado); LOGICA 2-9 Ag1-4LOG y Aa1-4LOG; PWM 10-13 A5bPWM, A5cPWM, A5dPWM, A5ePWM (cuatro compuertas seguidas con cables encimados) y 14 Xu6PWM; ERROR_AMP 15 XbrERR, 16 RzbrERR, 17 XbsERR, 18 XboERR, 19 RzboERR. Tambien hay muchos cables largos y cruces entre los rieles de arriba y los bloques de abajo (conectan bien pero cuesta leerlos).
- Tecnica de los circulos: centro = promedio de las patas leidas del XML; para los amplificadores (X...) hubo que sumar (+450, +190) porque el XML da mal su centro. La imagen es la hoja a escala 1:1 (18005 x 2354 px).

### 4. Archivos y rutas (donde esta cada cosa AHORA)
- CARPETA DE TRABAJO NUEVA (pedida por Diego, mas facil de encontrar): `C:\Users\<usuario>\Documents\Pruebas_Multisim\` con `esquematico_actual\SISTEMA_COMPLETO.ms14` (el bueno, copia del de las 23:15; Diego lo abre y guarda ahi), `imagenes_revision\REVISION.png` y `REVISION_marcado.png`, `respaldos\SISTEMA_COMPLETO_horizontal_usuario_2315.ms14`. Se le abrio en Multisim a las ~00:30 del 30/10.
- `C:\ms_work\` esta en la raiz del disco C: (por eso Diego no lo encontraba). Ahi quedan: `horizontal\` (original de 23:15 + "Security copy" automatica de Multisim), `revision\`, `respaldo\`, `post_h\`, `prueba\` (copias A/B/C del archivo viejo). El MCP de Multisim sigue usando C:\ms_work como carpeta de trabajo.
- Si Diego guarda en Documentos, el de `C:\ms_work\horizontal` queda desactualizado: trabajar siempre con el de Documentos.
- El proyecto aun tiene los viejos: `3_archivos_tecnicos\multisim\SISTEMA_COMPLETO.ms14`, `SISTEMA_COMPLETO_con_LED.ms14` y `SISTEMA_COMPLETO_multisim.png`.

### 5. Pendiente (en este orden)
1. Que Diego guarde con Ctrl+S tras cada arreglo y haga copias con hora; reportar si el cierre se repite en una pieza/pin concreto.
2. Arreglar los 19 puntos marcados (Diego a mano, o Claude en una COPIA editando el XML; nunca sobre el archivo abierto). Para verificar: abrir la copia con el MCP (open_circuit), get_circuit_image a bmp, convertir a PNG con OpenCV, recortar y ampliar, y revisar a ojo (no confiar en el analisis geometrico del XML).
3. Cuando Diego diga que termino (o lo pida ya): reemplazar en el proyecto el SISTEMA_COMPLETO.ms14 por el de Documentos, con respaldo de los 3 viejos en `C:\ms_work\respaldo`; quitar SISTEMA_COMPLETO_con_LED.ms14 (el nuevo ya trae el LED de banda); regenerar el PNG desde la version final; actualizar README.md y LEEME_MULTISIM.md; luego commit a GitHub. Se pidio confirmacion y Diego aun no la dio para el reemplazo.
4. Siguen los pendientes anteriores: LED de banda en sistema.inc, reducir chips, motorreductor y fusible, nombres del equipo, video/defensa, medir corriente del motor.

### 6. GitHub (esta sesion)
- Se invito a `[compañero]` como colaborador del repo `DiegoCrUz-afk/Proyecto_Final_Electronica_UNIS` con permiso de escritura (push). Invitacion pendiente hasta que la acepte en https://github.com/DiegoCrUz-afk/Proyecto_Final_Electronica_UNIS/invitations. El repo es publico.

### 7. Reglas aprendidas con Diego (esta sesion)
- Responder corto y sencillo; no afirmar cosas que solo se vieron en una captura sin decir que no estan verificadas en el archivo (lo de "pata sin conectar" fue un error mio).
- No tocar ni sobrescribir el archivo que Diego tiene abierto; trabajar en copias y avisar donde quedan. Abrirle el archivo en Multisim cuando lo pida (Start-Process con la ruta; tarda ~70 s).
- Claude no lee .mp4 directo: extraer fotogramas con OpenCV (`py -3.13`, instalar en carpeta temporal con pip --target). En Bash, los heredocs con `python3 -` se cuelgan: usar archivos .py.

### 8. Correccion automatica del .ms14 (30/10, madrugada) - archivo corregido v2
- Se trabaja SOLO sobre copias: `Pruebas_Multisim\esquematico_corregido\SISTEMA_COMPLETO_corregido_v2.ms14` (v1 = solo cables sobre patas). El guardado de Diego (`esquematico_actual`, 23:15) y su respaldo NO se tocaron. Scripts usados en `Pruebas_Multisim\scripts_correccion\` (reruta.py, juntos.py, ovfix.py; analisis ov.py, junt.py).
- Metodo: decode_ms14 -> editar XML como TEXTO (no reescribir con ElementTree) -> encode_ms14 -> open_circuit -> report_netlist (el parametro `path` de report_netlist es el ARCHIVO DE SALIDA: pasar un .ms14 lo SOBREESCRIBE) -> comparar redes (100 redes, mismos pines) -> render con get_circuit_image y revisar a ojo.
- Estructura del XML util: cada cable es CIITLinkComp con <Points> (coordenadas del mundo, pueden ser fraccionarias: conservar el texto original de los puntos que no se mueven), Connect1/Connect2 (ids de extremo) y Node (red). Los puntos de union son CODPinComp con Transformer-M20/M21 (posicion) y ConnectList (ids de los extremos). Conectividad electrica = ids/Node, NO la geometria; por eso se puede mover la geometria sin romper redes.
- reruta.py: 18 cables que pasaban sobre una pata se desplazaron (jog de 18-54 unidades); 41 no se pudieron. juntos.py: 24 puntos de union estaban lejos de donde se juntan sus cables (causa de "el punto no esta en su lugar"); se movieron al extremo comun de sus cables y se subio Pen-Width de 1 a 6 en todas las uniones (puntos visibles). 5 uniones con 2 cables a 2-3 unidades de diferencia no se tocaron.
- ovfix.py: en CADA amplificador (Xu1..Xu7, Xbr/Xbs/Xbo, X5...) los cables de alimentacion de redes distintas iban encimados 90 unidades por dentro del cuerpo (ej. Xu1 en x=2437: pata de arriba baja hasta el riel de abajo y pata de abajo sube al riel de arriba). Por eso Diego no podia mover el cable de Xu1. Se separaron con jogs: pares de redes distintas encimados bajaron de 14 a 2 (quedan 2: fuentes de prueba en y=4131 y otro par).
- Verificado en v2: abre (open_circuit sin error), 100 redes con los mismos pines que el original, y revision visual de Xu1 y ERROR_AMP.
- Pendiente tras v2: 51 extremos de cable que terminan en medio de otro sin punto de union (no se agregaron puntos: requiere partir cables), Ag1LOG/Ag2LOG y R3/R4 de PWM, y revisar v2 completo a ojo en Multisim; luego el reemplazo en el proyecto (confirmar con Diego).

### 9. DONDE NOS QUEDAMOS (cierre de la noche del 29-30/10, ~01:15) - LEER PRIMERO AL RETOMAR
Estado en una frase: el esquematico Multisim bueno es el de Diego (guardado 23:15) y hay una version corregida v2 hecha por Claude; Multisim se sigue cerrando de vez en cuando (mismo error interno) y falta decidir cual de los dos pasa al proyecto.

**Archivos (todo en `C:\Users\<usuario>\Documents\Pruebas_Multisim\`):**
- `esquematico_actual\SISTEMA_COMPLETO.ms14` = guardado de Diego de las 23:15 (R y C horizontales, con sus arreglos a mano). Respaldo identico en `respaldos\`.
- `esquematico_corregido\SISTEMA_COMPLETO_corregido_v1.ms14` (solo cables sobre patas) y `..._v2.ms14` (v1 + puntos de union movidos/mas grandes + cables de alimentacion de amplificadores separados). v2 es la ultima. Diego aun NO la ha podido usar bien: se cerro al abrirla (01:06:19, mismo error 0xc0000005 en Od101dll.dll, offset 0x47207). El mismo contenido de v2 SI abrio sin error con el MCP (open_circuit), asi que lo mas probable es que el cierre fue al interactuar; Diego no dijo que hizo.
- `imagenes_revision\`: REVISION.png (guardado 23:15), REVISION_marcado.png (19 circulos de piezas con cables encima), REVISION_uniones.png (puntos de union: magenta=sin cable, azul=1 cable, rojo=en cruce, amarillo=T sin punto), CORREGIDO_v1.png, CORREGIDO_v2.png.
- `scripts_correccion\`: reruta.py, juntos.py, ovfix.py (correcciones) y ov.py, junt.py (analisis). Los scripts del proyecto (3_archivos_tecnicos\multisim\scripts) NO se modificaron.
- El proyecto y GitHub siguen SIN cambios en Multisim: aun tiene los 3 archivos viejos (SISTEMA_COMPLETO.ms14, _con_LED.ms14, _multisim.png).

**Que probar manana (en orden):**
1. Abrir v2 con doble clic, ESPERAR a que cargue del todo (~70 s) y guardar con Ctrl+S antes de tocar nada. Decirle a Claude que hizo justo antes si se cierra (pieza y pin). Si v2 no se deja usar, volver a `esquematico_actual` (23:15), que si se pudo trabajar ~20 min sin cierres.
2. Revisar v2 a ojo en Multisim (Claude solo reviso Xu1 y ERROR_AMP): compuertas de LOGICA y PWM, ERROR_AMP, y que los puntos de union (ahora Pen-Width 6) se vean donde deben.
3. Pendientes de correccion que Claude NO resolvio: 51 extremos de cable que terminan en medio de otro sin punto (agregar punto requiere partir cables; riesgo alto), Ag1LOG/Ag2LOG, R3/R4 de PWM, 2 pares de cables encimados de redes distintas (fuentes de prueba y=4131 y otro). Xu1 si quedo separado.
4. Si Multisim sigue cerrandose con v2: probar desactivar autowire (Options > Global Options > Preferences), revisar el parche de 4 GB (`parche_multisim_4GB.ps1`, original en C:\ms_work\respaldo\multisim.exe.original), reducir el tamano de la hoja (Diego NO quiere dividir el esquematico ni achicar el ancho) o trabajar los cambios por bloques.
5. Cuando Diego elija la version final: reemplazar en el proyecto `3_archivos_tecnicos\multisim\SISTEMA_COMPLETO.ms14` (respaldo de los 3 viejos en `C:\ms_work\respaldo`), quitar `SISTEMA_COMPLETO_con_LED.ms14` (el nuevo ya trae el LED de banda), regenerar `SISTEMA_COMPLETO_multisim.png` desde la version final, actualizar README.md y LEEME_MULTISIM.md y hacer commit. Diego aun NO ha confirmado el reemplazo.

**Otros pendientes del proyecto (siguen igual):** aceptar la invitacion de GitHub ([compañero], pendiente de su lado); LED de banda en sistema.inc; reducir chips (5 LM393 a 3, 3x 74HC08 a 2); motorreductor 12 V 60 RPM y fusible 1 A 5x20 sin confirmar; nombres del equipo; video y defensa; medir corriente del motor real y recalibrar.

**Reglas para Claude al retomar:** responder corto y sencillo en espanol; no tocar el archivo que Diego tiene abierto ni sus guardados (trabajar en copias y decir donde quedan); verificar siempre a ojo con PNG ampliado, no solo con analisis del XML; confirmar con Diego antes de reemplazar archivos del proyecto o subir a GitHub; abrirle el .ms14 cuando lo pida con Start-Process (cargar ~70 s).

## AVANCE 30-31/10/2026: versiones v3 a v5 del esquematico Multisim  (LEER PRIMERO AL RETOMAR)
Estado en una frase: Diego da por BUENA y nitida la v5 (la que el guardo en Multisim); falta decidir si se corrigen las fuentes de prueba (ver 6) y luego pasarla a la carpeta principal del proyecto. NADA de esto se ha copiado aun al proyecto ni a GitHub (Diego pidio que se le cuente antes de pasarla). Todo el trabajo esta en `C:\Users\<usuario>\Documents\Pruebas_Multisim\`.

### 1. Archivos (Pruebas_Multisim\esquematico_corregido\)
- `SISTEMA_COMPLETO_corregido_v2.ms14`: la que Diego guardo a las 00:25 del 31/10 (base de v3). Las v1 y v2 que arme yo pesaban 2.5 MB y se le cerraban; la que guarda Multisim pesa ~1.4 MB y va fluida.
- `..._v3.ms14` (base: v2 guardada por Diego): arreglos en Xu3/RfixTMP, X5, A7dENC, A7eENC.
- `..._v4.ms14` (base: v3 guardada): arreglos en XbrERR, XbsERR y RprLOG.
- `..._v5.ms14` (base: v4 guardada): zona A7dENC / 4081BT_5V (A7eENC) / X7. ES LA ELEGIDA. Diego la guardo con retoques propios y dice que se ve nitida. Su version guardada se bajo a `C:\ms_work\v6\base.*` (31/10 01:38).
- Los archivos `... (Security copy)` son el respaldo automatico de Multisim (contenido anterior al guardado); se pueden ignorar.
- `imagenes_revision\`: V2_guardado_por_Diego.png, V3.png, V3_guardado_por_Diego.png, V4.png, V4_guardado_por_Diego.png, V5.png (hojas completas 18005x2354 a escala 1:1) y comparaciones `COMPARA_*`, `V4_COMPARA_*`, `V5_COMPARA_A7d_A7e_X7.png` (antes / despues).
- Carpetas de trabajo fuera del proyecto: `C:\ms_work\v3`, `v4`, `v5`, `v6` (base.ms14/.xml/.png, vN.ms14/.xml/.png y reportes de redes `*_net.txt`).

### 2. Que significa "no se ve la pata" y como se verifica (para no repetir errores)
- El problema nunca fue una pata sin conectar: es un CABLE DE OTRA RED (o de la misma) DIBUJADO ENCIMA de otro cable o de la pata, y se ve como si la pata no tuviera cable. Que un cable pase por encima del cuerpo de un componente NO le molesta a Diego; lo que le molesta es que los cables vayan uno encima de otro.
- Causa tipica: en los amplificadores (y en las fuentes) las dos patas estan una sobre otra en la misma columna x; el cable de la pata de arriba baja recto al riel de abajo y el de la pata de abajo sube recto al riel de arriba, y se montan encima del cuerpo y de la otra pata. Solucion usada: "ganchos": cada pata sale 6 a 18 unidades hacia fuera, se desplaza horizontalmente a una columna libre y recien ahi sube o baja. Columna libre = ningun otro cable vertical a menos de 10 unidades que se solape en y, y que no caiga dentro del cuerpo de un componente.
- VERIFICACION (la que vale): (a) `open_circuit` sin error; (b) `report_netlist` identico al de la version anterior (normalizando: quitar cabecera, fecha y nombre del documento, comparar columnas red/componente/pin ordenadas; diff = 0; son 448 filas); (c) `get_circuit_image` -> BMP -> PNG con PIL, recortar y ampliar y REVISAR A OJO. No confiar solo en el XML.
- TRAMPAS DE GEOMETRIA DEL XML (verificadas): las posiciones de pines de los AMPLIFICADORES salen del XML corridas: sumar (+396,+225) para Xu3 (y los Xu*, X5, X7, X1, X2...), (+432,+198) en otros; el pin real se ve en el PNG. Los simbolos de fuente de corriente (Iph) tambien salen corridos. Los pines de R, C, compuertas (A...LOG, A7d, A7e) y fuentes V SI coinciden con el dibujo. Ante la duda: PNG y coordenadas de los extremos de los cables (lista `<Points>` de cada CIITLinkComp).
- Al abrir y guardar, Multisim REASIGNA los ID de todos los cables (comparar versiones por la lista de puntos, no por ID) y a veces mete saltos de 2 a 4 unidades en algunos cables (cosmetico: entre mi v4 y la v4 guardada por Diego cambiaron 5 cables asi). Las conexiones no cambian.
- Un `.ms14` armado por mi con `encode_ms14` pesa ~2.6 MB y abre pesado; cuando Diego lo abre y lo guarda con Ctrl+S queda en ~1.4 MB y va fluido (como su v2). Siempre pedirle que guarde una vez al abrir una version nueva mia.

### 3. Que se cambio en cada version (solo geometria; las conexiones NO cambian)
- v3: (1) Xu3 (el amplificador junto a RfixTMP; Diego lo llamo Xu2 por error): el cable de su pata de arriba iba a 3 unidades del cable de RfixTMP, movido a x=4113 (era 4131). (2) X5aPWM: el cable de la pata de abajo subia recto por encima de la pata de arriba; ahora sale a la derecha (x=11228); un cable de otra red pasaba a 7 unidades bajo la pata y se desvio a y=1790. (3) A7dENC: los cables de las entradas de A7e pasaban por encima del inversor y a 4 unidades de la linea de tierra x=16814; ahora van por y=1642 con codo en x=16866. (4) A7eENC: la compuerta se corrio 63 unidades a la izquierda (Transformer-M20 16975 a 16912) para separarla de los cables de X7; se ajustaron sus 3 cables (2 entradas y salida).
- v4: XbrERR y XbsERR: ganchos de alimentacion (arriba y abajo) en columnas libres. RprLOG (Diego lo llamo Rp3: es la 3a Rp de LOGICA): los cables de tierra de RpeLOG y RpgLOG bajaban pegados a su pata izquierda y sobre su cuerpo; movidos a x=5560 y 5586.
- v5: zona A7dENC / A7eENC / X7: (1) una linea larga a y=1613 (x 17759 a 15674) atravesaba los cuerpos de X7 y X2; subida a y=1575. (2) El cable de la entrada - de X2 corria por la fila de componentes; ahora sube a y=1555 por x=17240. (3) Las dos entradas de A7e tenian rutas distintas (una con diagonal rara); ahora ambas por y=1642 / x=16866, y la salida de A7e sube por y=1625 (antes compartia linea con otro cable a y=1638). Quedan tres verticales juntas a la izquierda de X7 (ganchos de alimentacion mas la entrada); no se movio X7 por riesgo.
- Antes (secciones de arriba): v1 = solo cables sobre patas; v2 = puntos de union y separacion de la alimentacion de los amplificadores.

### 4. Salida N de Aa3LOG (74HC08 con N = M.P')
- Diego noto que su salida "no tiene cable". Es cierto y esta bien dentro del diseno: el pin 1Y de Aa3A no aparece en ninguna red del reporte (no existe la red `n`), y en LTspice (`sistema.inc`, `Xa3 m pn n v5 HC_AND2`) `n` se genera pero nada la usa. El enunciado pide N como salida (seleccion de velocidad normal) y la velocidad normal es lo que queda cuando L=0; por eso la compuerta cubre el requisito y entra en la tabla de verdad, pero electricamente no maneja nada.
- Opciones dadas a Diego (SIN decidir): (1) dejarla sin cable; (2) LED + resistencia como indicador de velocidad normal (agregar pieza a la lista de compras y a LTspice); (3) solo una etiqueta "N". Yo recomende la 2 o la 3. Esperar su respuesta.

### 5. Verificacion de "si todo funciona" (lo que SI y lo que NO esta comprobado)
- SI: LTspice (SISTEMA_COMPLETO.asc, hoja unica con cables, y el jerarquico) simula el sistema completo con los resultados de arriba (1393/789 rpm, disparos, reset). El esquematico de Multisim tiene las mismas redes con los mismos pines en todas las versiones (448 filas del reporte, diff = 0 entre v2, v3, v4, v5 y la v5 guardada por Diego). Cada version abre sin error con el MCP.
- NO: el SISTEMA_COMPLETO de Multisim no se ha SIMULADO en el motor de Multisim (los .ms14 no llevan sondas ni osciloscopio; por herramienta no se pueden correr); solo se corrieron por bloque (LEEME_MULTISIM.md). Tampoco hay prueba fisica (aun no hay materiales ni motor).
- Multisim se cierra a veces (0xc0000005 en Od101dll.dll); con las versiones horizontales y corregidas Diego pudo trabajar ratos largos. Las v3, v4 y v5 las abrio y guardo sin reportar cierres.

### 6. Hallazgo ABIERTO (31/10, antes de pasar la v5 al proyecto): fuentes de prueba con el cable "pasadito"
Diego pregunto si es normal que en las fuentes y senales de entrada se vea el cable pasando por encima. NO es normal: es el mismo problema de siempre. Revisado a ojo (PNG de la hoja) y con un render propio del XML (script temporal `rend.py`: dibuja cables, pines y cajas de simbolos de una region):
- Las fuentes de prueba Venc (x=1134, y 3060-3114), Ve (x=1134, y 3978-4014), Vg (x=306, y 4131-4167) y Vr (x=720, y 4131-4167) estan FUERA de la hoja (la hoja mide 18005 x 2354; ellas estan en y 3000 a 4300, debajo del marco), por eso get_circuit_image no las muestra y solo se ven en Multisim bajando por fuera de la hoja. El "0" de tierra esta en (504,4284).
- En cada una el cable de la pata de ABAJO sube recto hasta el riel de tierra y=2154, pasando por encima de su propio cuerpo y de su pata de arriba (de donde sale el cable de la senal hacia la derecha). Ve y Venc estan en la misma columna x=1134: el cable de tierra de Ve (1134,4014 a 2154) pasa por encima de Venc y de su cable de tierra (misma red, 0). Los cables de senal de Vg (306,4131 hacia 2112,4131) y de Vr (720,4131 hacia 2412,4131) van por la MISMA linea y=4131 durante 1392 unidades (redes distintas: gin y rin) y se ven como un solo cable. Son los "2 pares de redes distintas encimados" que ya figuraban desde v2.
- Iph (fuente de corriente de 50 uA del fototransistor, arriba a la izquierda, x~387, y 414-468): el cable de la pata de arriba (387,414 a 387,562) atraviesa todo el circulo hasta la union en y=466; en el PNG se ve la linea sobre el simbolo. V12 (720,1989-2025) esta bien (arriba y abajo por separado).
- PLAN PROPUESTO (no hecho, esperar OK de Diego): v6 = v5 guardada por Diego + ganchos en los cables de tierra de Ve, Venc, Vg, Vr (columnas libres a la izquierda, p. ej. x=1090 para Ve y x=1112 para Venc), separar la senal de Vr de la de Vg (y=4131 a otra y libre) y desplazar el cable de Iph. Verificar igual: abrir, report_netlist (diff 0) y PNG de las fuentes con rend.py (get_circuit_image NO muestra lo que esta fuera de la hoja).

### 7. Siguientes pasos (en orden)
1. Que Diego decida: (a) corregir las fuentes (punto 6) en una v6, (b) la salida N (punto 4).
2. Cuando Diego confirme: copiar la version final al proyecto como `3_archivos_tecnicos\multisim\SISTEMA_COMPLETO.ms14` (respaldo de los 3 archivos viejos en `C:\ms_work\respaldo`), quitar `SISTEMA_COMPLETO_con_LED.ms14` (la nueva ya trae el LED de banda Rbanda 1k + Dbanda), regenerar `SISTEMA_COMPLETO_multisim.png` desde la version final (open_circuit + get_circuit_image y convertir a PNG), actualizar README.md y `multisim\LEEME_MULTISIM.md`, y recien ahi `git commit` y push (no subir CONTEXTO_SESION.md ni el enunciado: estan en .gitignore). Confirmar con Diego antes de reemplazar y antes de subir.
3. Pendientes del proyecto que siguen igual: LED de banda en sistema.inc; reducir chips (5 LM393 a 3, 3 74HC08 a 2); motorreductor 12 V 60 RPM y fusible 1 A 5x20 sin confirmar; nombres del equipo; video y defensa; medir la corriente del motor real y recalibrar; aceptar la invitacion de GitHub ([compañero]).

### 8. Herramientas y comandos de esta sesion
- Cliente MCP propio: `3_archivos_tecnicos\multisim\scripts\mcp_call.py` (start() y call()); se corre con `py -3.12-32` (Python de 32 bits del multisim-mcp). Herramientas usadas: open_circuit, get_circuit_image (path = .bmp de ~170 MB; convertir a PNG con PIL en `py -3.13` con `Image.MAX_IMAGE_PIXELS=None`), report_netlist (`path` = archivo .txt de SALIDA; nunca pasar un .ms14: lo sobreescribe), decode_ms14 (`path`, `output_xml`), encode_ms14 (`source_xml`, `output_ms14`).
- Decodificar tambien se puede con `node %LOCALAPPDATA%\ewtools\dist\ewd.js archivo.ms14` (crea archivo.ms14.xml al lado). Diego autorizo ejecutar ewd/ewe.
- Editar el XML como TEXTO (no reescribirlo con ElementTree): cada cable es un `<Item ID="..." Class="CIITLinkComp">` con un bloque `<Points>`; se reemplaza solo ese bloque. Respetar el salto de linea del archivo (abrir con `newline=""`). Mover un simbolo = cambiar `Transformer-M20/M21` de su `<CIITSymbolComp ...>` y ajustar el primer y el ultimo punto de sus cables.
- En esta PC: `py -3.13` tiene PIL y OpenCV; `py -3.13 -I` NO ve los paquetes de usuario (no usar -I para esos scripts); los heredocs con `python3 -` se cuelgan en Bash, y un heredoc largo con apostrofes puede romper el comando: escribir el .py o .md con la herramienta Write y correrlo o anexarlo con cat.
- Abrirle un .ms14 a Diego: `Start-Process "<ruta>"` (carga ~70 s). Nunca tocar el archivo que Diego tiene abierto ni sus guardados: trabajar en copias y avisar donde quedan.

### 9. Reglas de trabajo con Diego (reforzadas esta sesion)
- Responder corto, sencillo y en espanol; decir con honestidad lo que NO esta verificado (no afirmar "pata suelta" ni "ya funciona" sin comprobarlo). Cuando Diego pregunta "revisaste bien?", mostrar la evidencia (redes, XML y PNG) en vez de reafirmar.
- Su criterio visual: importan los cables encimados sobre OTROS cables (esconden una conexion); los cables sobre componentes no le molestan; prefiere trabajar sobre SU archivo guardado y que Claude le diga exactamente que cambio. No dividir el esquematico ni achicar el ancho de la hoja.
- Pedir confirmacion antes de reemplazar archivos del proyecto o de subir a GitHub.

### 10. v6 (31/10, ~02:30): fuentes de prueba corregidas  (base: la v5 guardada por Diego, identica a C:\ms_work\v6\base.ms14)
- Archivo: `Pruebas_Multisim\esquematico_corregido\SISTEMA_COMPLETO_corregido_v6.ms14` (armado por Claude con encode: pesa ~2.6 MB, pedir a Diego que la guarde con Ctrl+S al abrirla). Imagenes: `imagenes_revision\V6.png`, `V6_FUENTES_render_despues.png` (render propio del XML de las 4 fuentes de prueba, fuera de la hoja) y `V6_Iph_zoom_despues.png`.
- Cambios (solo geometria, reporte de redes igual a la v5: diff 0): ganchos en los cables de tierra de Ve (columna x=1112), Venc (x=1097), Vg (x=263) y Vr (x=698), con el gancho saliendo hacia abajo de la pata de abajo; el cable de la pata de arriba de Iph (387,414) sale 10 unidades hacia arriba y baja por x=365 (ya no atraviesa el circulo); la senal de Vg ahora sale por y=4100 (antes compartia la linea y=4131 con la de Vr).
- Las fuentes Ve, Vg, Vr y Venc siguen FUERA de la hoja (y 3000 a 4300); no se movieron. Si Diego quiere, se pueden subir dentro de la hoja o agrandar la hoja.
- Pendiente: que Diego la revise en Multisim; si la aprueba, esa (guardada por el) pasa al proyecto segun el punto 7.

### 11. Ajuste dentro de la MISMA v6 (31/10, ~02:15): Ag4LOG y revision de puntos de union
- Diego pidio corregirlo en la v6 sin crear v7. Se reemplazo `esquematico_corregido\SISTEMA_COMPLETO_corregido_v6.ms14` (respaldo de la anterior en `Pruebas_Multisim\respaldos\SISTEMA_COMPLETO_corregido_v6_antes_de_Ag4.ms14`; el disco tenia la v6 sin cambios de Diego).
- Ag4LOG (74HC08 de LOGICA, entradas atadas a la misma red): el cable de la entrada de abajo (6727,1517) subia por x=6727 por encima de la entrada de arriba (6727,1499). Ahora sale a la izquierda por x=6709 y sube a y=430 (mismo patron que Ag3LOG). Redes iguales (diff 0). Imagenes: V6_Ag4LOG_antes.png / V6_Ag4LOG_despues.png / V6_corregida_Ag4.png.
- Revision de puntos de union en la v6 guardada (script temporal jdist.py: distancia de cada punto a los cables): 203 puntos, TODOS tienen 2 o mas cables cerca, al menos un cable que termina ahi y el cable mas cercano a <=1.5 unidades; ninguno huerfano. 5 puntos parecen "de un solo cable" pero el otro cable termina a 1-2 unidades (ok). (11772,1584) tiene el punto en x=11776 (4 unidades), se ve bien en el PNG. (5537,2154): el punto esta donde terminan 3 cables, y un cable de tierra de misma red pasa por encima (ok).
- Observacion NO tocada: Ag1LOG tiene el mismo patron (cable de la entrada de abajo (6558,826) sube por x=6558 sobre la entrada de arriba (6558,808), que es de OTRA red y llega desde la izquierda). No se corrigio porque Diego solo pidio Ag4LOG y los vecinos estan muy juntos (x=6533, 6566, 6584); si se pide, hace falta una columna libre.

## 12. ESTADO FINAL DE LA SESION 30-31/10/2026 Y PENDIENTES  (LEER PRIMERO AL RETOMAR; reemplaza al punto 7 de esta misma seccion)

### 12.1 Lo que quedo HECHO (todo verificado)
- El esquematico completo de Multisim ya esta en el proyecto y en GitHub: `3_archivos_tecnicos\multisim\SISTEMA_COMPLETO.ms14` = la v6 que Diego guardo en Multisim el 31/10 a las 02:08 (1.46 MB, formato liviano de Multisim; abre en ~70 s y Diego la uso sin cierres). Se verifico antes de copiarla: abre con el MCP sin error, reporte de redes igual al de la v6 verificada (448 filas, 0 diferencias) y PNG identico pixel por pixel.
- `SISTEMA_COMPLETO_multisim.png` regenerado desde esa version (18005 x 2354, 473 KB). `SISTEMA_COMPLETO_con_LED.ms14` BORRADO (la nueva ya trae el LED de banda: Rbanda 1k + Dbanda). `LEEME_MULTISIM.md` y `README.md` actualizados.
- GitHub: commit `423621d` "Multisim: esquematico completo ordenado a mano (v6), PNG nuevo y LEEME actualizado" subido a `origin/main` (antes `3903778`). Solo se subieron esos 5 archivos; `CONTEXTO_SESION.md` y el enunciado siguen en .gitignore (no se suben).
- Respaldos de lo que habia en el proyecto (fuera del repo): `C:\ms_work\respaldo\SISTEMA_COMPLETO_proyecto_antes_v6.ms14`, `SISTEMA_COMPLETO_con_LED_proyecto_antes_v6.ms14`, `SISTEMA_COMPLETO_multisim_proyecto_antes_v6.png`. Respaldo previo del archivo de Diego: `Pruebas_Multisim\respaldos\SISTEMA_COMPLETO_corregido_v6_antes_de_Ag4.ms14` y `SISTEMA_COMPLETO_horizontal_usuario_2315.ms14`.
- Carpeta de trabajo de Diego: `Documents\Pruebas_Multisim\` (esquematico_actual, esquematico_corregido con v1 a v6, imagenes_revision con todos los PNG antes/despues, respaldos, scripts_correccion). `C:\ms_work\` (raiz de C:) guarda las carpetas de trabajo v3, v4, v5, v6, v6b, final (XML decodificados, PNG, reportes de redes). Todo eso esta FUERA del proyecto y se puede borrar cuando ya no haga falta (pesa cientos de MB por los BMP de 170 MB).

### 12.2 Lo que SI se trabo en esta sesion (y como se resolvio; para no repetirlo)
1. Multisim se cerraba solo al crear o mover un cable (0xc0000005 en Od101dll.dll, siempre el mismo punto). Causa de fondo: cables dibujados unos sobre otros (R y C en vertical dejaban cables encima de patas; patas de alimentacion de amplificadores y compuertas en la misma columna). Con R y C en horizontal y los cables separados Diego pudo trabajar ratos largos sin cierres. Se sigue considerando un fallo interno de Multisim: si reaparece, anotar la pieza y el pin y guardar con Ctrl+S antes de tocar.
2. "No se ve la pata / el cable pasadito": NUNCA fue una pata suelta; es un cable dibujado encima de otro (ver seccion 2 de "AVANCE 30-31/10"). Se corrigio caso por caso en v3 (Xu3/RfixTMP, X5, A7dENC, A7eENC), v4 (XbrERR, XbsERR, RprLOG), v5 (zona A7dENC/A7eENC/X7) y v6 (fuentes de prueba Ve, Venc, Vg, Vr, Iph; y Ag4LOG dentro de la misma v6).
3. Lentitud de Multisim: el archivo que arma el encoder (2.6 MB) abre pesado; el que guarda Multisim con Ctrl+S (1.4 MB) va fluido. Siempre pedir a Diego que abra y guarde una vez cada version mia. No es problema de la carpeta (Documentos no esta en OneDrive; el cierre tambien ocurria en C:\ms_work). Sospecha SIN comprobar: Defender escaneando el archivo al guardar.
4. Errores mios para no repetir: (a) decir que una pata estaba suelta sin verificarlo; (b) confiar en el XML para decidir que pata esta tapada (las posiciones de amplificadores y de fuentes de corriente salen corridas); (c) pasar `.ms14` a `report_netlist` como path (lo sobreescribe); (d) asumir que una salida sin cable era un cable escondido (Aa3LOG: la salida N nunca tuvo cable; esta bien por diseno).
5. Herramientas: heredocs de Bash con apostrofes largos o `python3 -` se cuelgan o rompen; escribir los scripts/markdown con la herramienta Write y correrlos. `py -3.13 -I` no ve PIL.

### 12.3 PENDIENTES (en orden de prioridad)
A. DECISION de Diego sobre la pregunta abierta del final: Diego dijo "agrega el ms14 porque asi puedo abrirlo mas facil y sin trabarse". El .ms14 YA esta en el repo (`3_archivos_tecnicos\multisim\SISTEMA_COMPLETO.ms14`, la version liviana guardada por Multisim). Se le ofrecieron 3 lecturas, SIN respuesta: (1) copia en la raiz del proyecto junto al README (dos copias de 1.4 MB en el repo); (2) version que abra mas rapido (no depende de la carpeta; carga ~70 s por las 156 piezas y 498 cables); (3) que un companero lo baje suelto desde GitHub (boton "Download raw file"). Si responde 1: copiar a la raiz y hacer otro commit.
B. Salida N de Aa3LOG (74HC08, N = M.P' = velocidad normal): sin cable por diseno (ninguna etapa la usa; en LTspice tampoco). Opciones sin decidir: dejarla; LED + resistencia como indicador de velocidad normal (agregar a lista de compras, a sistema.inc y a LTspice y Multisim); o solo una etiqueta "N". Recomendado: LED o etiqueta, para que en la defensa se vean las cuatro salidas M, N, L, A.
C. Ag1LOG (LOGICA): mismo patron que tenia Ag4LOG; el cable de la entrada de abajo (6558,826) sube por x=6558 sobre la entrada de arriba (6558,808, otra red, llega desde la izquierda). No corregido: vecinos muy juntos (x=6533, 6566, 6584); hace falta una columna libre. Menor prioridad.
D. Fuentes de prueba Ve, Vg, Vr, Venc quedan FUERA de la hoja (y 3000 a 4300, hoja de 2354); si Diego quiere, subirlas dentro de la hoja o agrandar la hoja (MULTISIM_MCP_SHEET="ancho,alto").
E. A la izquierda de X7 quedan 3 verticales juntas (ganchos de alimentacion + entrada); separarlas implica mover X7 (riesgoso). Solo si Diego lo pide.
F. Multisim: el SISTEMA_COMPLETO NO esta simulado en el motor de Multisim (sin sondas/osciloscopio); solo por bloque. Si se quiere, poner un osciloscopio a mano y correr; Venc es senoidal 5 kHz (cambiarla a pulsos para probar el encoder).
G. Pendientes del proyecto que siguen igual: LED de banda en `sistema.inc` y en LTspice; reducir chips (5 LM393 a 3, 3 74HC08 a 2; ahorro ~Q13); motorreductor 12 V 60 RPM y fusible 1 A 5x20 sin confirmar en La Electronica (hay N20 12 V 200 RPM a Q55 y fusibles 0.5 A 6x30 y 10 A 5x20); IRFZ44N con compuerta a ~4.3 V (medir Vds con el motor real); nombres del equipo (hoy solo Diego; el otro integrante del proyecto anterior era [excompañero del proyecto anterior]); video 3-5 min y defensa individual; medir la corriente del motor real (<=500 mA) y recalibrar disparo de sobrecorriente y referencia; confirmar con el docente si la cubierta enclava, si el encoder puede ser modulo con comparador y que motor usar; aceptar la invitacion de GitHub ([compañero] la tiene pendiente de su lado); informe tecnico <=15 paginas y BOM con costo (la lista de compras en PDF suma Q495.00 segun el 28/10; revisar precios antes de entregar).
H. Limpieza opcional: borrar `C:\ms_work\v3, v4, v5, v6, v6b, final` (BMP de 170 MB) y los PNG intermedios de `Pruebas_Multisim\imagenes_revision` cuando Diego ya no los necesite; las carpetas de respaldo conviene conservarlas.

### 12.4 Como seguir trabajando "de la misma manera" (receta)
1. Pedir a Diego que guarde y cierre; trabajar SOLO sobre copias (nunca sobre el archivo que tiene abierto ni sobre sus guardados). Copiar su ultimo guardado a una carpeta nueva `C:\ms_work\vN\base.ms14`.
2. Bajar datos con el cliente MCP (`mcp_call.py`, `py -3.12-32`): open_circuit, report_netlist (path = .txt de salida), get_circuit_image (.bmp) y decode_ms14 -> `base.xml`. Convertir el BMP a PNG con PIL (`py -3.13`). Mirar a ojo el PNG recortado y ampliado de las zonas que Diego senala.
3. Ubicar cables y pines con scripts pequenos sobre el XML (listar cables por zona, pines de un simbolo con su transformacion; recordar las trampas de posiciones de amplificadores y de Iph). Disenar el cambio: gancho a una columna libre (ningun otro vertical a menos de 10-12 unidades, fuera de cuerpos de componentes) o cambiar la ruta de un cable.
4. Editar el XML como TEXTO (solo el bloque `<Points>` del cable; respetar saltos de linea), `encode_ms14` -> nuevo .ms14, `open_circuit`, `report_netlist` y comparar con el anterior (normalizado; diff debe ser 0), nuevo PNG y revision a ojo (antes/despues).
5. Guardar en `Pruebas_Multisim\esquematico_corregido\` (nombre nuevo o, si Diego pide "en la misma version", respaldar primero en `respaldos\` y reemplazar), copiar las imagenes a `imagenes_revision\`, abrirselo con `Start-Process` y pedirle que lo guarde con Ctrl+S (queda liviano). Anotar todo en este .md.
6. Antes de reemplazar archivos del proyecto o subir a GitHub: confirmar con Diego. Para subir: solo los archivos pedidos (`git add` explicito), commit con la linea `Co-Authored-By: Claude Sonnet 5.5 <noreply@anthropic.com>` y `git push origin main`.
7. Estilo: respuestas cortas, sencillas y en espanol; decir con honestidad que se verifico y que no (evidencia: redes, XML y PNG); no afirmar sin comprobar; mostrar los archivos y rutas exactas.

## 13. SESION 31/10/2026 (tarde): revision Multisim/BOM, guia con capturas y 3D ordenado  (todo en Pruebas_Multisim, NADA copiado al proyecto)
- `Pruebas_Multisim\Revision_componentes_y_Multisim.md`: resultados (Multisim = LTspice salvo diferencias explicadas; BOM coincide, falta LED de banda + 1k; sistema completo NO simulado en motor Multisim: fallo a 346 s).
- `Pruebas_Multisim\documento_esquematico\Guia_del_esquematico_por_bloques.html` (+img): capturas Multisim y LTspice por bloque + texto de Explicacion_por_bloques.
- `Pruebas_Multisim\montaje_3d\`: Protoboards_3D_ordenado.html, generar_protoboard.py (espaciar(), rail_y, GND izq-der), exportar_protoboard3d.py (asignar_alturas por capas), plantilla_proto3d.html (cables ortogonales), verificar_3d.py (OK). El 3D original del proyecto tenia GND en 6 grupos.
- Pendiente: Diego revisa el 3D y la guia; luego decidir si pasan al proyecto/GitHub.

### 13b. Mas cambios 31/10 (tarde-noche), todo en Pruebas_Multisim
- Guia_del_esquematico_por_bloques.html ahora usa SOLO recortes de la hoja v6 de Multisim (img\v6_*.png); sin imagenes de LTspice ni de los BLOQUE_*.ms14. Diego pidio no usar LTspice hasta que su esquematico completo quede legible.
- 3D (montaje_3d): clic en pieza ahora muestra "conectada con" por pata (tira de 5 agujeros + cables + otras tiras, sin pasar por rieles) y resalta esas piezas/cables (funcion conecta() en plantilla_proto3d.html). Cables bajos pegados a la placa con saltos solo sobre piezas (ruteo_bajo.py: candidatas L/Z, niveles de 1.2 mm, hops). 19 de 280 cables no encontraron lugar libre (niveles altos hasta ~22 mm). Los cables a dispositivos externos (ext) siguen altos (17 mm+). verificar_3d.py = OK.
- PENDIENTE: esquematico completo de LTspice legible como el de Multisim (hoy: SISTEMA_COMPLETO.asc 6217x8189 px, bloques dispersos en 2D, componentes diminutos). Falta definir con Diego: una fila ancha como Multisim o varias filas, y si todas las conexiones con cable.

### 13c. LTspice en una fila (31/10, noche) - Pruebas_Multisim\ltspice_fila\
- SISTEMA_COMPLETO_fila.asc (+ .png 17277x1600, generar_fila.py ~5 min, render.py): fuente/entradas/motor a la izquierda, 11 bloques en una fila (orden de Multisim), rieles globales v5/vm/GND arriba y abajo, redes entre bloques con cable (22) y rieles de cada bloque unidos al global. Netlist de LTspice = identico al de SISTEMA_COMPLETO.asc (90 redes, mismas particiones). NO se simulo (Run) esta version ni se abrio en la interfaz de LTspice; revisado solo en PNG: bloques legibles, pero hay cables largos que cruzan los textos de notas.
- 3D: al tocar un CABLE ahora muestra las patas que une (conectaCable/conectaDesde en plantilla_proto3d.html); probado con cables 102, 161, 235, 260.

### 13d. Revision y arreglo de SISTEMA_COMPLETO_fila.asc (31/10 noche, Pruebas_Multisim\ltspice_fila)
- Antes: 617 cables, 71 patas sin cable (unidas solo por etiqueta/simbolo GND), 28 redes con partes unidas solo por etiqueta, 7 extremos sueltos, 18 pares encimados. Ahora: GND, 5 V y 12 V con cable en todos los pines; 0 pares encimados; 2 extremos sueltos (9344-9488,944 y 17704-19296,464); netlist identico al original (90 redes). Quedan por etiqueta: vref (pata Xbr_ERR.1), pwm (entre PWM_GEN y POTENCIA) y 4 etiquetas de un solo pin (tc, tl, tin, pwm_tri_o: puntos de prueba/expresiones).
- LECCION: en LTspice NO fusionar cables colineales que se tocan en punta (rompe uniones en cruz). Solo quitar los contenidos dentro de otro. Verificar siempre con `LTspice -netlist` y comparar particiones (chk.py / test3.py en C:\ms_work\chk).
- Resistencias: LTspice 67 vs Multisim 80 (+6 del divisor de los 2 NE555, +3 Rz de salida, Rbanda, Rtin, etc.).
- Respaldo del paso anterior: SISTEMA_COMPLETO_fila_antes_de_arreglar.asc. NO se simulo con Run ni se abrio en la interfaz de LTspice.

### 13e. LTspice fila: vref y pwm con cable + leyenda (31/10 noche)
- ruta_extra.py unio con cable vref (Xbr_ERR.1) y pwm (Xu6_PWM.5 -> Xa5_POT.1) con un ruteador que cruza cables en perpendicular; netlist identico (90 redes). nombres_fuentes.py: leyenda de las piezas de prueba (V12, D1, Cin, Ve, Vg, Vr, Iph, Vtc+Bn, Bsl+Renc, motor Lm/Rm/Eb/Cw/Bw/Vtl/Cph/Bph) en el espacio vacio de la izquierda; quito etiquetas tin y pwm_tri_o.
- Quedan por etiqueta solo tc y tl (nombres de nodo usados en formulas de las fuentes Bn y Bw, un solo pin) y 2 extremos de cable sueltos.

### 13f. PASO A LA CARPETA PRINCIPAL (31/10 tarde) y LTspice con Run
- Pasado al proyecto (SIN commit/push todavia): 6_Montaje_3D\Protoboards_3D_miniestacion.html regenerado + LEEME.md; 3_archivos_tecnicos\protoboard\ (generar_protoboard.py, exportar_protoboard3d.py, plantilla_proto3d.html, ruteo_bajo.py, verificar_3d.py; rutas ahora relativas); 4_Documentacion\Guia_del_esquematico_por_bloques.html + img\v6_*.png. Respaldos de lo anterior: C:\ms_work\respaldo_principal. La lista de compras NO se toco.
- Los esquematicos de LTspice en una fila SIGUEN en Pruebas_Multisim\ltspice_fila (a pedido de Diego): SISTEMA_SOLO_CIRCUITO.asc (sin fuentes, con terminales vin/ein/gin/rin/b/tnode/enc/dm/tin; sin etiquetas sobre patas; no simula) y SISTEMA_COMPLETO_fila.asc (con fuentes; simula). LEEME.md ahi.
- Run de SISTEMA_COMPLETO_fila.asc (4.6 s, ~9 min, 2 corridas iguales, antes y despues de limpiar etiquetas): v5 5.012-5.018 V; normal 1402 rpm; objeto 777 rpm; objeto retirado 1393; M cae a 0 en 1.401 s; falla de corriente F=1 a 2.074 s; reset 2.8 s -> 1355 rpm; calor: F=1, setn=0.03 V a 3.5 s; reset con frio 4.5 s -> 1402 rpm.
- Verificado: las 90 piezas discretas del 3D (R, C, D, Q, MOSFET, shunt) coinciden una a una con las de SISTEMA_SOLO_CIRCUITO y quedan unidas en los mismos 43 grupos (script C:\ms_work\chk\cmp3d.py). Trimpots, CI y conectores no se compararon por esta via.
- Condensador "conectado a una etiqueta": era Cac_SEN (pata 2 = entrada de prueba AC 'tin', queda libre) y las etiquetas de nombre sobre patas de condensadores (Cef/Cgf/Crf_LOG, Ccv/Ct_PWM, Cfv_ENC, Cd_OC...), todas quitadas; el resto tenia cable.

### 13g. Se quito el condensador Cac (1 uF) de todo (31/10/2026)
- Motivo: Cac (pata `tin` libre) solo era una entrada de prueba AC; en la maquina real el fototransistor entra directo al nodo `b`. Su pata `tin` no iba a nada. Diego pidio quitarlo de todo y revisar Multisim (alli estaba como CacSEN + Rtin 100 Meg a tierra, que tambien se quitaron).
- sistema.inc: `.subckt SENSOR_IR v5 b p` (sin tin ni Cac). Tambien sim/bloques_desde_asc.inc, generar_sistema.py, generar_esquematicos.py, generar_guia_componentes.py y scripts ms_*.py.
- Regenerado con los scripts: protoboard (118 piezas, 278 cables, 81 redes, verificar_3d OK), PCB (placas A/B/C verificadas), Placas_de_cobre_3D, 2_LTspice (BLOQUE_SENSOR_IR, SISTEMA_JERARQUICO, SISTEMA_COMPLETO), Guia_de_componentes.html, lista de compras (solo cambia la cantidad de 1 uF: 5 -> 4; total igual Q495.00).
- Multisim: SISTEMA_COMPLETO.ms14 y BLOQUE_SENSOR_IR.ms14 sin Cac/Rtin (editado el XML con ewd/ewe, comprobado con report_netlist: solo desaparecen esas 2 piezas). Version nueva tambien en Pruebas_Multisim\esquematico_corregido\SISTEMA_COMPLETO_corregido_v7.ms14. Imagenes v6_SENSOR_IR.png y v6_SISTEMA_COMPLETO.png regeneradas (mismo recorte). Respaldo de todo el proyecto antes del cambio: C:\ms_work\respaldo_antes_de_quitar_cac.
- Guia_de_pruebas.md: la prueba 03 ahora inyecta la senoidal en `b` con un capacitor de 1 uF suelto (no va en la placa).
- LTspice fila (pruebas): quitar_cac.py; terminales renombradas (J1_JACK_12V, INTERRUPTOR_E, CUBIERTA_G, BOTON_RESET, SENSOR_IR_TCRT5000, NTC_10k, ENCODER_SALIDA, MOTOR_NEGATIVO); textos RIEL corregidos (les faltaba el ';').
- Sin commit ni push.

### 13h. PCB eliminado y esquematico mas legible (31/10/2026)
- Diego pidio eliminar todo lo de PCB (ya no se hace): borrados 7_PCB_placas_de_cobre, 3_archivos_tecnicos/pcb y 6_Montaje_3D/Placas_de_cobre_3D_miniestacion.html; README y 6_Montaje_3D/LEEME.md actualizados. Sigue en git (HEAD) y en C:\ms_work\respaldo_antes_de_quitar_cac.
- Esquematico mas legible: 2_LTspice\SISTEMA_SOLO_CIRCUITO_legible.asc/.png (script pruebas\ltspice_fila\legible.py): titulos de bloque sobre los rieles, notas largas abajo, valor de compuertas HC_* oculto (WINDOW 3 0 0 Left 0; asc_lib ahora lo lee/escribe/dibuja). Mismas 82 redes (comprobado con -netlist). No se movieron nombres de piezas (no se pudo comprobar como interpreta LTspice los WINDOW de piezas rotadas).
- OJO: Diego tenia SISTEMA_SOLO_CIRCUITO abierto en LTspice; por eso la version nueva se guardo con otro nombre en vez de pisar el archivo.
- Error mio: para probar WINDOW tome una captura de TODA la pantalla (se vio el chat de WhatsApp de Diego); la borre sin usarla. No volver a capturar pantalla completa.
- (13h, cont.) Letra mas chica: nombre y valor de las piezas en tamano 1 (WINDOW n x y just 1) para piezas R0 (posicion = la del .asy) y resistencias R90 (nombre arriba y valor abajo, centrados: antes el nombre de Rse/Rsg/Rsr_LOG se montaba sobre Cef/Cgf/Crf_LOG). Piezas R180/R270/cap R90/pnp M180 (7+2) quedan con letra normal por no conocer su posicion por defecto. Leyenda de terminales pequena al inicio (legible.py). asc_lib: Comp.win/hidden leidos, guardados y dibujados.

### 13i. Multisim ahora en 7_Multisim (31/10/2026)
- 3_archivos_tecnicos\multisim -> 7_Multisim (11 BLOQUE_*.ms14, SISTEMA_COMPLETO.ms14 + png, LEEME_MULTISIM.md, scripts\). Los scripts ms_*.py siguen apuntando a 3_archivos_tecnicos para sistema.inc/modelos.inc (no cambia). No renumerar las demas carpetas: los .asc de 2_LTspice incluyen ..\3_archivos_tecnicos\modelos.inc.
- exportar_montaje3d.py NO se puede borrar: exportar_protoboard3d.py lo importa (E.nets, E.MEAS, E.POWER, E.datos_sim).

### 13j. Revision completa (31/10/2026)
- Borrado: exportar_montaje3d.py (solo su bloque __main__ viejo) y plantilla_montaje3d.html; __pycache__. NO se borro sim\sistema_desde_asc_resumen.npz (lo lee exportar_montaje3d.datos_sim; se restauro de git). Quitado de plantilla_proto3d.html el enlace a las placas de cobre.
- Pruebas OK: sintaxis de todos los .py; JS del 3D; 3D (118 piezas, 278 cables, 81 redes; 118/118 piezas muestran sus conexiones; clic en cable muestra "este cable une estas patas"; sin errores de consola); regenerar esquematicos LTspice = archivos identicos; comprobar_esquematicos TODO COINCIDE (11 bloques); SISTEMA_SOLO_CIRCUITO = 3D (89 piezas, 43 grupos) = SISTEMA_COMPLETO.asc (82 redes); simulacion de 2_LTspice\SISTEMA_COMPLETO.asc (4.6 s): v5 5.012-5.018 V, 1402 rpm normal, 777 con objeto, M cae 1.401 s, falla 2.074 s; lista de compras (Q495.00) y guia de componentes regeneradas; enlaces de los html sin rotos.
- Multisim (7_Multisim): los 11 bloques + SISTEMA_COMPLETO abren y dan netlist. Redes de senal iguales a LTspice en REG5V, SENSOR_IR, SOBRECORRIENTE, TEMPERATURA, LOGICA, POTENCIA, REFVEL, ALARMA; ERROR_AMP/PWM_GEN/ENCODER_FV difieren por como se dibujan (media op-amp, 555 con piezas internas); hoja completa: 58 de 77 redes de senal coinciden por nombre automatico, el resto es por nombres distintos (no revisado una a una). ms_suite (motor de Multisim, por bloque): regulador, sensor, refvel, error, alarma, temperatura, logica 8/8 y 8/8. Se corrigio ms_suite: la prueba F=1 pulsaba setn dentro de la ventana del reset de encendido (3-4 ms); ahora a 300 ms.
- No se pudo: simular SISTEMA_COMPLETO.ms14 entero en Multisim (ya fallaba antes).

### 13k. Comprobaciones extra y Multisim corriendo el sistema (31/10/2026)
- Chips del 3D vs sistema.inc: los 28 circuitos integrados/compuertas del netlist tienen su lugar exacto (chip + compuerta + patas) en el 3D, sin repetir (script C:\ms_work\chk\ic_check.py). Los 6 trimpots coinciden (revisado a mano).
- Multisim, hoja completa: resistencias = mismos valores que LTspice; sobran solo piezas propias de Multisim (555 con piezas internas, 3 Rz de 1 mOhm, Rmot 12, Rn 10k del NTC, Rbanda 1k + Dbanda). FALTAN en la hoja de Multisim el diodo de entrada D1 (1N4007) y Cin (1000 uF): V12 entra directo a vm. (Ademas Multisim tiene el LED de banda que LTspice/3D/lista no tienen.)
- Pruebas\multisim_run: el SISTEMA COMPLETO corre en el motor de Multisim (run_spice_netlist con netlist de sistema.inc) 150 ms con `tran 50u 150m 0 100u uic` (con paso 10 us se atora en Q6 de la alarma). El MCP falla al convertir el result.raw ASCII de ~860 MB pero el archivo queda completo (C:\msre_exp\...): se lee con leer_raw_ascii.py. Resultado: v5 5.014-5.021, vm min 11.13, N/L/M correctos, M cae a 131.0 ms al abrir cubierta. La hoja .ms14 no tiene probes (enum_outputs vacio) -> run_transient de Multisim no aplica sin agregarlos.
- Corregida ms_suite (F=1 a 300 ms). Servidor http viejo del puerto 8765 sigue abierto (no es nuestro).

### 13l. Din y Cin agregados a la hoja de Multisim, solo en pruebas (31/10/2026)
- Pruebas_Multisim\multisim_agregar\SISTEMA_COMPLETO_con_Din_Cin.ms14: V12+ -> Din (D1N4007) -> vm; Cin 1000 uF vm-tierra. Netlist: 3 redes cambian de 99 (vin nueva, vm, tierra). Hoja de 7_Multisim intacta (mismo md5 que la copia original).
- Modelo de datos del .ms14 (XML): posicion real de una pata = transformada del simbolo aplicada a la transformada interna (CIITPinSymbolComp) aplicada a ptCenter; los cables se unen a patas por Connect1/Connect2 (IDs de CODPinComp); cada red tiene CODNodeTextComp con Links; no se puede cambiar Connect1 de un cable existente (el archivo no abre): se crea un cable nuevo y se borra el viejo.
- Falta decidir: copiar esa hoja a 7_Multisim (reemplazando SISTEMA_COMPLETO.ms14) y el LED de banda.

### 13m. Hoja principal de Multisim actualizada con Din y Cin (01/11/2026)
- 7_Multisim\SISTEMA_COMPLETO.ms14 = version con Din + Cin (respaldo anterior en C:\ms_work\respaldo_antes_Din_Cin). PNG de la hoja, v6_SISTEMA_COMPLETO.png y v6_REG5V.png (recorte x=106,y=378,678x1965) regenerados; la guia de Multisim tiene filas nuevas Din y Cin. LEEME_MULTISIM al dia.
- Pendiente: version "solo circuito" de Multisim (en pruebas, trabajarla como v7): quitar fuentes/NTC/motor/LED banda/3 Rz y cambiar las piezas internas de los 2 NE555 por una pieza 555 (idea: caja de 8 patas via create_schematic_from_netlist con XSUBN, o un 555 real colocado a mano).

### 13n. Multisim "solo circuito" v7 (pruebas, 01/11/2026)
- Pruebas_Multisim\multisim_solo_circuito\SISTEMA_SOLO_CIRCUITO_v7.ms14: sin fuentes, Rn, Rmot, Rbanda/Dbanda y 3 Rz (cable directo OUT-red); tierra nueva junto a Cin; netlist comprobado igual al esperado. LEEME ahi.
- NE555 de 1 pieza: NO logrado. Caja de 8 patas se obtiene con create_schematic_from_netlist usando un .subckt NE555 con un dispositivo A (queda como carrier XSUBN, patas P1..P8 = gnd,trig,out,rst,cv,thr,dis,vcc). Unir sus patas a rieles abre bien; unir patas de redes pequenas (pwm_tri/cv/dis, enc_*) hace que Multisim se cierre al abrir (WorkerUnavailableError). Causa no encontrada (descartado: geometria, NodeText/Links, puertos en nodos, junciones huerfanas, cambiar Connect).
- Aprendido: Multisim recalcula las redes a partir de los cables (Connect1/Connect2 -> ids de CODPinComp en ConnectList de patas o de juntas del dibujo), no de las listas Ports/Nodes; no se puede cambiar Connect1 de un cable existente.

### 13o. Estado al 01/11/2026 (final de sesion)
- Hecho: hoja de simulacion de 7_Multisim con Din + Cin (principal). v7 "solo circuito" en pruebas (sin fuentes/NTC/motor/LED banda/3 Rz, con tierra en Cin), redes verificadas.
- Pedido por Diego: poner un NE555 real (LM555CM, grupo Mixed > TIMER) a mano en la v7 y yo reviso despues (netlist + simulacion). Se abrio la v7 en su Multisim; el no veia la ventana (proceso multisim abierto pero sin ventana visible). Se cerraron procesos multisim viejos, Taskmgr y PhoneExperienceHost.
- FALTA: (1) que Diego ponga los 2 NE555 en la v7 (o decidir dejar la v7 con 555 internos); (2) yo verifico netlist/simulacion de esa v7; (3) decidir si la v7 va a 7_Multisim (y si reemplaza SISTEMA_COMPLETO.ms14 o queda aparte); (4) LEEME_MULTISIM mencionar v7; (5) imagenes BLOQUE_*.png de 4_Documentacion\img algo desactualizadas; (6) COMMIT Y PUSH sin hacer (CONTEXTO_SESION.md y Enunciado_del_profesor.docx NO se suben); (7) pendientes viejos: motorreductor 12 V 60 RPM / fusible 1 A, nombres del equipo, video/defensa, medir corriente real del motor (<=500 mA), confirmar con el profesor, informe <=15 paginas.

### 13p. Pendiente al reiniciar la PC (01/11/2026)
- PENDIENTE: Multisim "solo circuito" para la carpeta principal. Esta en pruebas: Pruebas_Multisim\multisim_solo_circuito\SISTEMA_SOLO_CIRCUITO_v7.ms14 (con los 555 con piezas internas). Opciones: A) copiarla tal cual a 7_Multisim; B) Diego pone 2 LM555CM a mano, guarda, y se verifica netlist/simulacion antes de copiar.
- LTspice: SISTEMA_COMPLETO.asc (simulacion) y SISTEMA_SOLO_CIRCUITO.asc (solo circuito) ya estan en 2_LTspice.
- Se hizo commit y push de la carpeta principal (ver git log).

### 13q. Multisim "solo circuito" terminado y subido (01/11/2026, tarde)
- `7_Multisim\SISTEMA_SOLO_CIRCUITO.ms14` (+ `SISTEMA_SOLO_CIRCUITO_multisim.png`) = la v8 que Diego guardo con Ctrl+S (1.29 MB). Sin fuentes/NTC/motor/LED banda/3 Rz; con Din + Cin; 2 LM555CM reales (U1 = PWM, U2 = encoder) ya cableados (se quitaron las 12 piezas internas de cada NE555); 9 textos libres junto a los terminales (Interruptor E, Cubierta G, Boton de reset R, NTC, Fototransistor TCRT5000 x2, Entrada 12 V (jack), Salida N (no se usa), OUT (no se usa)). Faltan sin texto: ENCODER_SALIDA (red enc, 10277,1625) y MOTOR_NEGATIVO (red dm, 13590,1185); Diego dijo "dejalo asi".
- Verificado: 79 redes de Multisim = las de LTspice SISTEMA_SOLO_CIRCUITO.asc (script C:\ms_work
8\cmp_lt3.py; las 3 de LTspice sin par son patas sueltas a proposito: Din A, Aa3LOG 1Y, U1 OUT); auditoria de cables 0 problemas (audit.py); los 11 BLOQUE y SISTEMA_COMPLETO abren; ms_suite por bloque OK (logica 8/8 y 8/8); LTspice SISTEMA_COMPLETO.asc simulado (7 min): v5 5.012-5.018 V, M cae a 1.401 s, falla de corriente 2.074 s, falla de temperatura 3.356 s (~50 C), reset limpia; PNG de LTspice al dia (identicos pixel a pixel); 0 enlaces rotos.
- Se regeneraron los 11 `4_Documentacion\img\BLOQUE_*.png` desde los .asc actuales (recortados) y se hizo tolerante `3_archivos_tecnicos\simnalisis_desde_asc.py` (si falta V(xpot:gate)).
- GitHub: commits c46e51a (circuito solo), 833be1f (PNG + LEEME/README), 477ecd9 (BLOQUE png + script). Todo subido a origin/main.
- Trabajo: Diego pidio trabajar SIEMPRE sobre la misma v8 (sin versiones nuevas por cada cambio). Scripts de trabajo en C:\ms_work
8 (cablear2.py, detour.py, textos.py, limpiar2.py, snap.py, cmp_lt3.py, audit.py, flot.py). El MCP de Multisim abre un archivo por sesion de forma fiable; hacer abrir + netlist + imagen en una sola sesion. Quedan procesos multisim viejos (lanzados por mis pruebas) que no se pudieron cerrar por permisos.
- NO verificado: simulacion de SISTEMA_SOLO_CIRCUITO en Multisim (no tiene fuentes); VDD/VSS de compuertas (Multisim los conecta solo).
- Pendientes que siguen: motorreductor 12 V 60 RPM y fusible 1 A sin confirmar; nombres del equipo; video 3-5 min y defensa; medir corriente del motor real (<=500 mA) y recalibrar; confirmar con el docente (cubierta enclava, encoder modulo, motor); informe <=15 paginas y BOM con costo (lista de compras Q495.00, revisar precios); aceptar invitacion de GitHub ([compañero]). 7_Multisim\scripts siguen apuntando a 3_archivos_tecnicos para sistema.inc.

## 14. SESION 02/11/2026: GitHub Pages y materiales por protoboard
- GitHub Pages activado (rama main, raiz) con `gh api`: el 3D se abre sin descargar en https://diegocruz-afk.github.io/Proyecto_Final_Electronica_UNIS/6_Montaje_3D/Protoboards_3D_miniestacion.html (responde 200). Enlace agregado al README (commit "README: enlace al 3D en GitHub Pages"). El repo es publico, asi que Pages tambien publica el resto de .html.
- `5_Compras_y_Pruebas\Materiales_por_protoboard.pdf` (4 pag.): piezas por protoboard A-E y total (118 piezas), sacadas de `const DATA` del HTML del 3D (A 23, B 32, C 25, D 20, E 18). Subido: commit c27dfaf. Traduce kinds internos (TB=Externo con cables, RW=shunt, TRIM=trimpot, TCRT=sensor IR, OPTO) y `{Kerr*10k}`=100k.
- Diferencia con la lista de compras: 5 LM393 / 3 74HC08 (se podrian reducir a 3 y 2); el LED de banda sigue solo en Multisim.
- Trampas: `py -3.13 -I` NO ve reportlab/PIL (usar sin -I para PDF); no encadenar `rm` con `;` tras generar un archivo (borre por error el .md intermedio); Bash en Windows imprime mal Ω/µ (usar PYTHONIOENCODING=utf-8 y escribir a archivo).
- Pendientes: los de la seccion 13q (motor/fusible, nombres del equipo, video/defensa, medir corriente del motor, confirmar con docente, informe <=15 pag, BOM con costos, invitacion GitHub [compañero]).

## 15. SESION 03/11/2026: indicadores LED (solo propuesta) y 3D v2 con menos cables
- LED de objeto (PROPUESTA, NO implementada, esperando confirmacion de Diego y color): 1 LED + 1 resistencia 1 kohm de v5 a `pn` (salida de Xg4 = P', bloque LOGICA, linea 121 de sistema.inc): `Rob v5 nob 1k` / `Dob nob pn DLED`. Se enciende cuando hay objeto (pn=0), ~3 mA. No conectar a P (pull-up 10k del LM393, muy debil). Va en la protoboard B (SENSOR_IR, SOBRECORRIENTE, TEMPERATURA, LOGICA segun generar_montaje3d.py). Alternativa de 5 LED (alimentacion, M, N, L, objeto) tambien propuesta, sin hacer. Lista de compras hoy: 1 solo LED rojo (alarma, 470 ohm en f). Los LED IR vienen dentro del TCRT5000 y del optointerruptor.
- 3D v2 (pedido de Diego: menos cables sin cambiar el esquematico). Probado en `Documents\Pruebas_Multisim\montaje_3d_v2\` y pasado al principal: `6_Montaje_3D\Protoboards_3D_miniestacion_v2.html` + `3_archivos_tecnicos\protoboard_v2\` (generar_protoboard.py modificado, exportar_protoboard3d.py con salida _v2.html, verificar_3d.py, ruteo_bajo.py, plantilla). La v1 y su generador quedan intactos (278 cables).
- Cambios del generador v2: try_attach tambien cuelga piezas de tiras de GND/5 V/12 V; place_free busca la posicion que deja mas patas en tiras con su red; se deja 1 agujero libre por tira (len(cols)>=4 se evita).
- Resultado v2: cables 278 -> 225 (193 senal/alimentacion, 12 puentes entre rieles, 20 externos); 5 protoboards, 118 piezas, 373 patas, 81 redes. verificar_3d OK; pata->red identica a la v1 (script revisar.py en la carpeta de pruebas); sin solapes de cuerpos; Chrome headless carga la pagina sin errores JS. NO se reviso a ojo (la extension de Chrome no estaba conectada y la captura headless no termina por el render continuo). El chequeo interno de generar_protoboard.py imprime "mezcladas" (el original tambien); vale el verificar_3d.
- README.md y 6_Montaje_3D/LEEME.md actualizados con la v2. SIN commit ni push todavia (pendiente: confirmar con Diego). El enlace de GitHub Pages de la v2 funciona solo despues del push.
- Posible mejora no hecha: patas directo a los rieles (exige cambiar el dibujo y la verificacion del 3D).
- Trampas: `sleep` largo en Bash esta bloqueado (usar Monitor); Chrome headless con `--screenshot` se cuelga con esta pagina WebGL.

## 16. SESION 07-08/11/2026: 3D v2 como unica version, opto, maquina 3D, LED de objeto, motor Steren
- DECISION: la v1 (`6_Montaje_3D\Protoboards_3D_miniestacion.html`) queda RETIRADA. Se conserva en el repo pero ya no se publica en GitHub Pages (se excluye en `_config.yml`) ni se actualiza, salvo que Diego lo pida. Todo el trabajo sigue en la v2 (`Protoboards_3D_miniestacion_v2.html`). Los generadores de la v1 siguen en `3_archivos_tecnicos\protoboard\`.
- Protoboards del 3D como las reales (foto de Diego): 63 filas numeradas con 0 abajo; letras J I H G F | E D C B A arriba y A-J abajo; rieles con azul (-) a la izquierda y rojo (+) a la derecha, cortados a la mitad y unidos con puentes dibujados; los agujeros se nombran como esta impreso (p. ej. F33). Riel izq: GND y 5 V; riel der: GND y 12 V.
- Opciones del 3D v2: Enfocar una placa (botones Solo A-E o teclas 1-5, 0 = todas; muestra otras placas solo si tienen cables hacia ella), ocultar cables que salen a otras placas o a dispositivos, ocultar cables de alimentacion, "Por donde empezar" por placa, WASD y flechas, Armado paso a paso por placa (pieza + el cable que ya se puede poner; al final conexiones con otras placas, puentes de alimentacion y dispositivos externos; las piezas anteriores se quedan puestas). Los cables a dispositivos entran directo a los agujeros (sin bornera).
- OPTO (optointerruptor ranurado, en U): va junto al disco del motor, NO en la protoboard; 4 cables lo unen a la placa D. A = anodo (+, red ENC.nled), K = catodo (GND): brazo del LED; C = colector (red enc), E = emisor (GND): brazo del fototransistor. Tiene polaridad. En la placa D hay 4 agujeros con marca plana de color y letra (v2: F33, F32, E33, E32), 2 a cada lado del canal. El disco de 20 ranuras se FABRICA (no se compra: en la lista solo sale como nota en la fila del OPTO); gira con el eje y su borde pasa por la ranura del opto fijo.
- Cables: 20 a dispositivos externos (sensor IR 4 en placa B, opto 4 en D, motor 2 en A: M+ H58 y M- H56, NTC 2 en B, micro-switch cubierta 2, interruptor E 2 y reset 2 en C, fuente 12 V 2 en A). Solo 2 van al motor; con el NTC (pegado a su carcasa) y el opto quedan 8 junto al motor.
- `ruteo_bajo.py` (v1 y v2): segunda pasada que vuelve a trazar los cables que tocan a otros usando las alturas reales de las patas. Medido con chequeo propio: pares de cables de redes distintas a menos de 1 mm, v1 7 -> 0 y v2 10 -> 0; ningun cable pasa por encima del opto. Costos: generar el 3D tarda ~3 min por version; en la v2 3 cables suben a mas de 21 mm (maximo ~42 mm). El ruteador sigue marcando 4 (v1) y 10 (v2) como "sin_lugar" con su criterio mas estricto. Ojo: ese archivo paso de CRLF a LF.
- Valores: `{Kerr*10k}` ahora se ve como 100k en el 3D (R4 y Rf6, Kerr = 10); R1 y R3 son 10k. `generar_esquematicos.py` y `sistema.inc` siguen con la formula (se usa para simular).
- LED de objeto: implementado SOLO en el 3D v2, placa B: `LOG.Rlo` 470 ohm de v5 a `LOG.lo` y `LOG.Dlo` LED verde de `LOG.lo` a `LOG.pn` (salida de la NAND que invierte P; 0 con objeto -> enciende, ~6 mA). En la propuesta de la seccion 15 la resistencia era 1 kohm (~3 mA): decidir cual. En la simulacion del 3D el LED se ilumina con V(p) > 2.5. NO esta en esquematicos, `sistema.inc`, simulaciones, Multisim ni lista de compras. Con el LED la v2 tiene 120 piezas, 82 redes y 229 cables, y los numeros de cable cambiaron (dispositivos externos 198-217).
- `Maquina_3D_banda.html` (generador `3_archivos_tecnicos\maquina3d\exportar_maquina3d.py`, lee los cables de la v2): banda, motor, disco, opto, sensor IR, micro-switch, NTC, fuente, interruptor, reset y las 5 protoboards, con los 20 cables numerados como en el 3D v2; WASD (Q/E suben y bajan, Shift rapido); vista desarmable tipo explosionada; clic en pieza o cable da sus datos. Los engranes extra (3:1) son una propuesta ilustrativa, NO estan en el diseno.
- `Motor_opto_desmontado.html`: diagrama de las piezas (motorreductor, disco, opto, cables), tabla de a donde va cada cable y avisos del motor. RETIRADO de GitHub Pages por decision de Diego (basta con la v2 y la maquina 3D desarmable); el archivo se conserva en el repo.
- MOTOR ELEGIDO por Diego: Steren MOT-125 "Motor reductor metalico con eje tipo D, 6 Vcc", Q59. Datos de la pagina: 0.014 A sin carga, relacion 100:1, torque 0.0687 N.m, eje D de 3 mm x 10 mm, 35.5 x 12 x 10 mm, 9 g; velocidad 100 r/min en las especificaciones y 320 RPM en la descripcion (se contradice); la ficha dice NO DISPONIBLE; no publica corriente a plena carga. NO coincide con el diseno ni con la lista de compras (12 V, 60 RPM, Q34): el circuito entrega hasta 12 V, asi que hay que limitar el PWM, regular a 6 V o usar un motor de 12 V, y recalibrar la sobrecorriente. Con 100 rpm y 20 ranuras salen ~33 pulsos/s (calculo), contra ~500 Hz que supone el encoder (vspd ~ 1.1 mV/Hz): revisar.
- GitHub: commit 2b23a91 (todo lo anterior). Despues: v1 fuera de Pages (`_config.yml`), README, `6_Montaje_3D\LEEME.md` y estos CONTEXTO actualizados.
- Trampas: heredoc de Bash con muchas comillas falla (escribir el script con la herramienta de archivos); `open(f, "w")` vacia el archivo ANTES de evaluar lo que se escribe (si la funcion falla queda en 0 bytes: calcular primero); el navegador de Claude no abre file:// (usar `py -3.13 -m http.server 8771` en `6_Montaje_3D`); regenerar el 3D tarda ~3 min (correr en segundo plano); Chrome WebGL con la camara quieta a veces muestra capturas viejas.
- Pendientes: los de 13q y 14, mas: decidir motor (6 V vs 12 V) y recalibrar; confirmar con el docente donde va el disco y como se acopla el motor a la banda (y si hacen engranes extra); decidir si el LED de objeto entra al diseno (resistencia 470 o 1 k, color) y, si si, pasarlo a esquematicos, `sistema.inc`, simulacion, Multisim y lista de compras; pasar R4/Rf6 a "100k" tambien en los esquematicos si se quiere.
