DiegoCrUz-afk/Proyecto_Final_Electronica_UNIS/7_PCB_placas_de_cobre/PLACA_A_cobre_para_planchado_ESPEJO.pdf

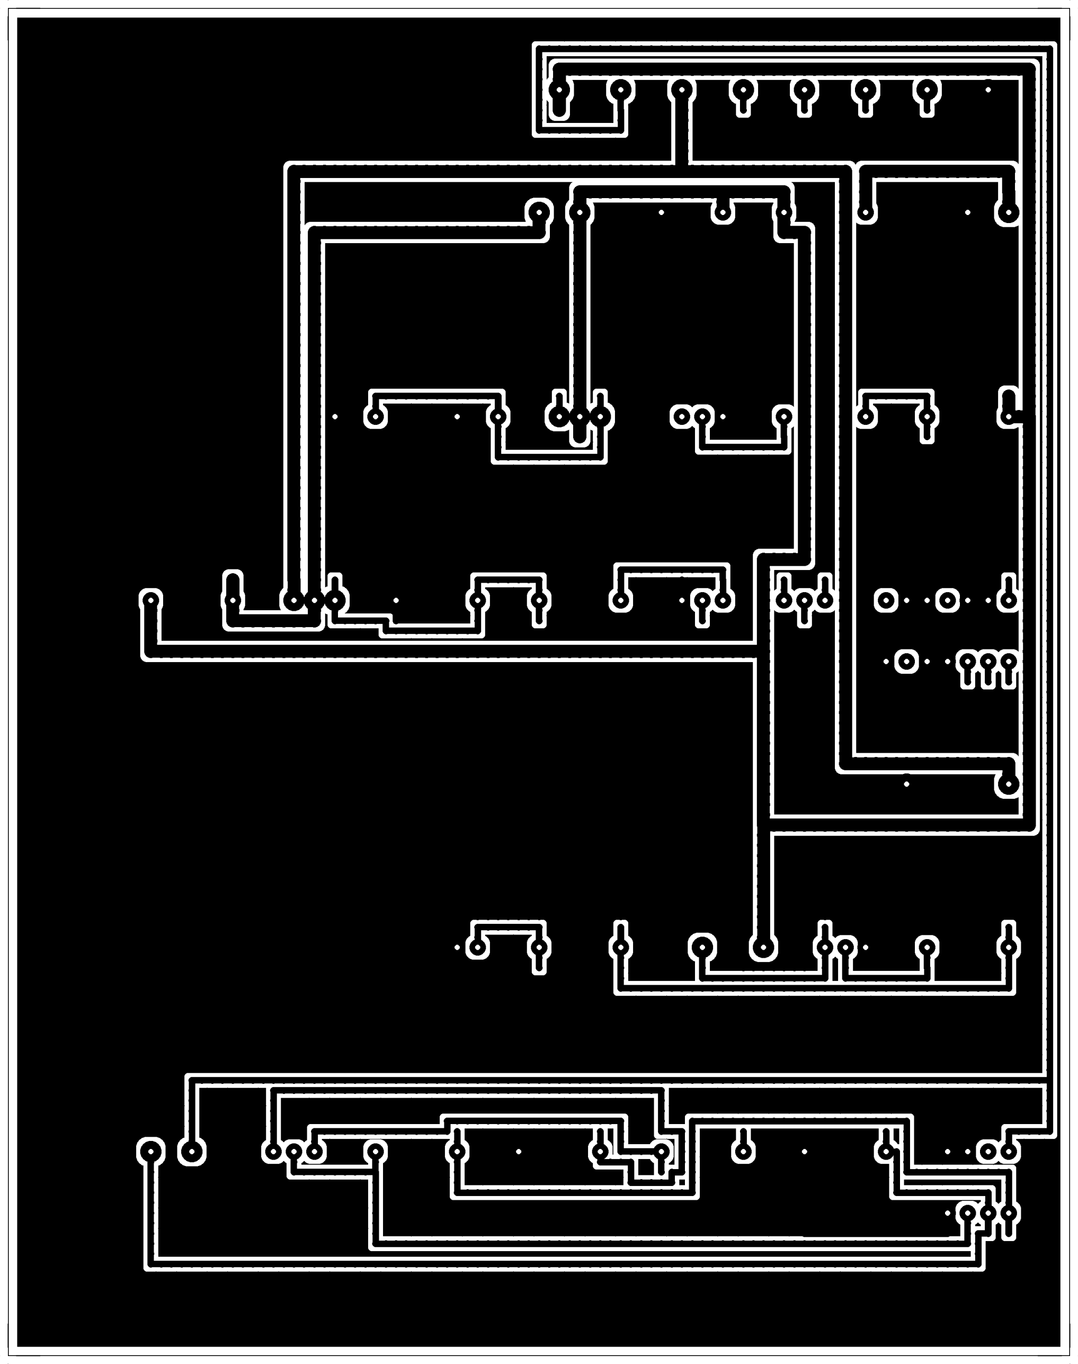
[picture p24: figure]

PLACA A cobre ESPEJADO (toner) - imprimir al 100 por ciento (sin ajustar a la pagina). Ancho 132.1 mm, alto 167.6 mm.
