DiegoCrUz-afk/Proyecto_Final_Electronica_UNIS/7_PCB_placas_de_cobre/PLACA_B_cobre_para_planchado_ESPEJO.pdf

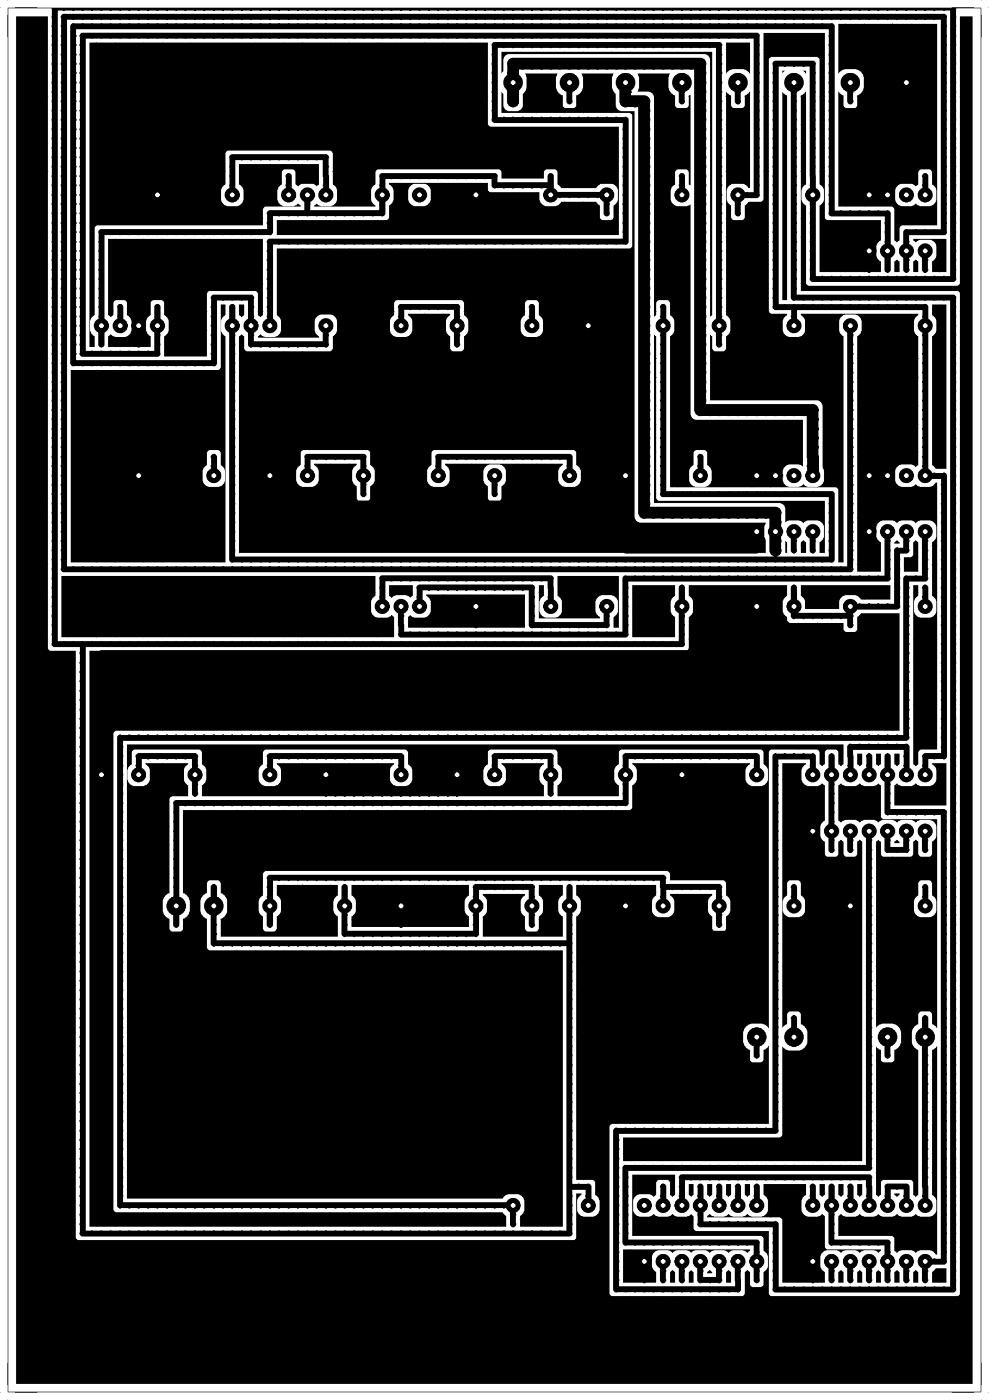
[picture p25: figure]

PLACA B cobre ESPEJADO (toner) - imprimir al 100 por ciento (sin ajustar a la pagina). Ancho 132.1 mm, alto 188.0 mm.
