DiegoCrUz-afk/Proyecto_Final_Electronica_UNIS/7_PCB_placas_de_cobre/PLACA_B_guia_de_conexiones.pdf

## PLACA B - a donde va cada pata (cada agujero)

Agujeros de la fila de arriba: son los puntos para unir las placas entre si con cable (GND, +5 V, +12 V y las senales). Cada uno se conecta a las piezas de esta placa (con pista o con el puente de alambre magenta que sale de el) y, por fuera, con un cable al agujero del mismo nombre de la otra placa.
Red | Agujero de esta placa | Se une con cable a
GND (tierra) | agujero rotulado 'GND (tierra)' en la fila de arriba | el mismo agujero rotulado 'GND (tierra)' de la placa A, placa C
f | agujero rotulado 'f' en la fila de arriba | el mismo agujero rotulado 'f' de la placa A
l | agujero rotulado 'l' en la fila de arriba | el mismo agujero rotulado 'l' de la placa C
m | agujero rotulado 'm' en la fila de arriba | el mismo agujero rotulado 'm' de la placa A
setn | agujero rotulado 'setn' en la fila de arriba | el mismo agujero rotulado 'setn' de la placa A
sh | agujero rotulado 'sh' en la fila de arriba | el mismo agujero rotulado 'sh' de la placa A
+5 V | agujero rotulado '+5 V' en la fila de arriba | el mismo agujero rotulado '+5 V' de la placa A, placa C
+12 V | agujero rotulado '+12 V' en la fila de arriba | el mismo agujero rotulado '+12 V' de la placa A, placa C

El cobre que rodea las pistas es GND (tierra). Los puentes P1, P2... son alambres por el lado de piezas (ver vista de componentes).

Pieza | Pata | Red | Se une con
ENT.TBE | 5V | +5 V | LOG.Cpor.1, SEN.TCRT.C, LOG.Rsn.1, ENT.TBR.5V, OC.Ra.1, ENT.TBG.5V y 11 mas
ENT.TBE | E | ein | LOG.Rse.1, LOG.Rpe.1
ENT.TBG | 5V | +5 V | ENT.TBR.5V, U8.14, U11.14, U9.14, LOG.Cpor.1, LOG.Rsn.1 y 11 mas [puente de alambre P33]
ENT.TBG | G | gin | LOG.Rpg.1, LOG.Rsg.1 [puente de alambre P10]
ENT.TBR | 5V | +5 V | ENT.TBG.5V, U9.14, U8.14, LOG.Cpor.1, LOG.Rsn.1, U11.14 y 11 mas [puente de alambre P33]
ENT.TBR | RST | rin | LOG.Rsr.1, LOG.Rpr.1 [puente de alambre P7]
LOG.Cef | 1 | LOG.ef | LOG.Rse.2, U11.1
LOG.Cef | 2 | GND (tierra) | toda la zona de cobre de GND (29 patas) [puente de alambre P43]
LOG.Cgf | 1 | LOG.gf | LOG.Rsg.2, U11.5
LOG.Cgf | 2 | GND (tierra) | toda la zona de cobre de GND (29 patas)
LOG.Cpor | 1 | +5 V | LOG.Rsn.1, ENT.TBE.5V, ENT.TBR.5V, OC.Ra.1, ENT.TBG.5V, U9.14 y 11 mas
LOG.Cpor | 2 | LOG.por | LOG.Rpor.1, LOG.Dpor.A
LOG.Crf | 1 | LOG.rf | LOG.Rsr.2, U11.11, LOG.Dpor.K
LOG.Crf | 2 | GND (tierra) | toda la zona de cobre de GND (29 patas) [puente de alambre P48]
LOG.Dpor | A | LOG.por | LOG.Rpor.1, LOG.Cpor.2
LOG.Dpor | K | LOG.rf | LOG.Crf.1, LOG.Rsr.2, U11.11
LOG.Rpe | 1 | ein | LOG.Rse.1, ENT.TBE.E
LOG.Rpe | 2 | GND (tierra) | toda la zona de cobre de GND (29 patas) [puente de alambre P44]
LOG.Rpg | 1 | gin | LOG.Rsg.1, ENT.TBG.G [puente de alambre P10]
LOG.Rpg | 2 | GND (tierra) | toda la zona de cobre de GND (29 patas)
LOG.Rpor | 1 | LOG.por | LOG.Cpor.2, LOG.Dpor.A
LOG.Rpor | 2 | GND (tierra) | toda la zona de cobre de GND (29 patas) [puente de alambre P40]
LOG.Rpr | 1 | rin | LOG.Rsr.1, ENT.TBR.RST [puente de alambre P6]

Pieza | Pata | Red | Se une con
LOG.Rpr | 2 | GND (tierra) | toda la zona de cobre de GND (29 patas)
LOG.Rse | 1 | ein | LOG.Rpe.1, ENT.TBE.E
LOG.Rse | 2 | LOG.ef | LOG.Cef.1, U11.1 [puente de alambre P8]
LOG.Rsg | 1 | gin | LOG.Rpg.1, ENT.TBG.G
LOG.Rsg | 2 | LOG.gf | LOG.Cgf.1, U11.5 [puente de alambre P9]
LOG.Rsn | 1 | +5 V | U9.14, LOG.Cpor.1, U8.14, ENT.TBR.5V, ENT.TBG.5V, ENT.TBE.5V y 11 mas [puente de alambre P31]
LOG.Rsn | 2 | setn | U8.4, U8.2, U14.1, X.setn [puente de alambre P20]
LOG.Rsr | 1 | rin | LOG.Rpr.1, ENT.TBR.RST [puente de alambre P7]
LOG.Rsr | 2 | LOG.rf | LOG.Crf.1, U11.11, LOG.Dpor.K [puente de alambre P14]
OC.Cd | + | OC.dl | OC.Rd.2, U14.2
OC.Cd | - | GND (tierra) | toda la zona de cobre de GND (29 patas) [puente de alambre P36]
OC.Cpk | 1 | OC.pk | OC.D1.K, OC.Rbl.1, OC.Rd.1 [puente de alambre P15]
OC.Cpk | 2 | GND (tierra) | toda la zona de cobre de GND (29 patas) [puente de alambre P45]
OC.D1 | A | OC.oa | OC.Rf.1, U4.1
OC.D1 | K | OC.pk | OC.Cpk.1, OC.Rbl.1, OC.Rd.1 [puente de alambre P16]
OC.Ra | 1 | +5 V | U14.8, SEN.Ra.1, SEN.R1.1, LOG.Cpor.1, U11.14, SEN.Rpu.1 y 11 mas
OC.Ra | 2 | OC.rt | OC.T1.1
OC.Rb | 1 | OC.rb2 | OC.T1.3
OC.Rb | 2 | GND (tierra) | toda la zona de cobre de GND (29 patas) [puente de alambre P39]
OC.Rbl | 1 | OC.pk | OC.Cpk.1, OC.D1.K, OC.Rd.1 [puente de alambre P15]
OC.Rbl | 2 | GND (tierra) | toda la zona de cobre de GND (29 patas) [puente de alambre P46]
OC.Rd | 1 | OC.pk | OC.D1.K, OC.Cpk.1, OC.Rbl.1 [puente de alambre P16]
OC.Rd | 2 | OC.dl | OC.Cd.+, U14.2
OC.Rf | 1 | OC.oa | OC.D1.A, U4.1 [puente de alambre P5]
OC.Rf | 2 | OC.fb | OC.Rg.1, U4.2 [puente de alambre P4]
OC.Rg | 1 | OC.fb | U4.2, OC.Rf.2 [puente de alambre P4]
OC.Rg | 2 | GND (tierra) | toda la zona de cobre de GND (29 patas) [puente de alambre P38]
OC.T1 | 1 | OC.rt | OC.Ra.2
OC.T1 | 3 | OC.rb2 | OC.Rb.1
OC.T1 | W | OC.ref | U14.3
SEN.Cac | 1 | tin | sale de esta placa (conector entre placas)
SEN.Cac | 2 | b | SEN.Q2.B, SEN.R2.1, SEN.R1.2, SEN.TCRT.E
SEN.Q2 | B | b | SEN.Cac.2, SEN.R2.1, SEN.R1.2, SEN.TCRT.E
SEN.Q2 | C | SEN.c | U1.2, SEN.Rc.2 [puente de alambre P13]
SEN.Q2 | E | SEN.e | SEN.RE.1
SEN.R1 | 1 | +5 V | SEN.Rled.1, X.+5V, SEN.Ra.1, U1.8, SEN.Rpu.1, SEN.Rc.1 y 11 mas [puente de alambre P29]
SEN.R1 | 2 | b | SEN.R2.1, SEN.Cac.2, SEN.Q2.B, SEN.TCRT.E
SEN.R2 | 1 | b | SEN.R1.2, SEN.Cac.2, SEN.Q2.B, SEN.TCRT.E
SEN.R2 | 2 | GND (tierra) | toda la zona de cobre de GND (29 patas) [puente de alambre P34]

SEN.RE | 1 | SEN.e | SEN.Q2.E
SEN.RE | 2 | GND (tierra) | toda la zona de cobre de GND (29 patas) [puente de alambre P47]
SEN.Ra | 1 | +5 V | SEN.Rc.1, SEN.Rled.1, SEN.R1.1, SEN.Rpu.1, U1.8, U14.8 y 11 mas
SEN.Ra | 2 | SEN.th1 | SEN.T1.1
SEN.Rb | 1 | SEN.th2 | SEN.T1.3
SEN.Rb | 2 | GND (tierra) | toda la zona de cobre de GND (29 patas) [puente de alambre P34]
SEN.Rc | 1 | +5 V | SEN.Ra.1, U1.8, U14.8, SEN.Rled.1, SEN.R1.1, SEN.Rpu.1 y 11 mas
SEN.Rc | 2 | SEN.c | U1.2, SEN.Q2.C
SEN.Rh | 1 | p | SEN.Rpu.2, U1.1, U9.13, U8.12, U8.13
SEN.Rh | 2 | SEN.th | SEN.T1.W, U1.3
SEN.Rled | 1 | +5 V | U1.8, SEN.R1.1, SEN.Ra.1, SEN.Rc.1, X.+5V, U14.8 y 11 mas [puente de alambre P27]
SEN.Rled | 2 | SEN.nled | SEN.TCRT.A
SEN.Rpu | 1 | +5 V | SEN.Ra.1, SEN.R1.1, X.+5V, SEN.Rc.1, SEN.Rled.1, SEN.TCRT.C y 11 mas [puente de alambre P30]
SEN.Rpu | 2 | p | SEN.Rh.1, U1.1, U9.13, U8.12, U8.13 [puente de alambre P23]
SEN.T1 | 1 | SEN.th1 | SEN.Ra.2
SEN.T1 | 3 | SEN.th2 | SEN.Rb.1
SEN.T1 | W | SEN.th | SEN.Rh.2, U1.3
SEN.TCRT | A | SEN.nled | SEN.Rled.2
SEN.TCRT | C | +5 V | SEN.Rpu.1, SEN.Ra.1, ENT.TBE.5V, SEN.R1.1, X.+5V, SEN.Rc.1 y 11 mas [puente de alambre P30]
SEN.TCRT | E | b | SEN.Q2.B, SEN.Cac.2, SEN.R2.1, SEN.R1.2
SEN.TCRT | K | GND (tierra) | toda la zona de cobre de GND (29 patas) [puente de alambre P47]
U1 | 1 | p | SEN.Rpu.2, SEN.Rh.1, U8.13, U8.12, U9.13 [puente de alambre P24]
U1 | 2 | SEN.c | SEN.Rc.2, SEN.Q2.C [puente de alambre P13]
U1 | 3 | SEN.th | SEN.Rh.2, SEN.T1.W
U1 | 4 | GND (tierra) | toda la zona de cobre de GND (29 patas) [puente de alambre P42]
U1 | 5 | GND (tierra) | toda la zona de cobre de GND (29 patas) [puente de alambre P42]
U1 | 6 | GND (tierra) | toda la zona de cobre de GND (29 patas)
U1 | 7 | NC | sin conexion (solo soldar la pata)
U1 | 8 | +5 V | SEN.Rled.1, SEN.Rc.1, SEN.R1.1, SEN.Ra.1, U14.8, X.+5V y 11 mas [puente de alambre P26]
U11 | 1 | LOG.ef | LOG.Rse.2, LOG.Cef.1 [puente de alambre P8]
U11 | 10 | LOG.rin_n | U11.13
U11 | 11 | LOG.rf | LOG.Rsr.2, LOG.Crf.1, LOG.Dpor.K [puente de alambre P14]
U11 | 12 | LOG.rst | U8.1
U11 | 13 | LOG.rin_n | U11.10
U11 | 14 | +5 V | ENT.TBG.5V, U14.8, ENT.TBR.5V, OC.Ra.1, U8.14, SEN.Rc.1 y 11 mas

U11 | 2 | LOG.ein_n | U11.3
U11 | 3 | LOG.ein_n | U11.2
U11 | 4 | LOG.e | U9.1
U11 | 5 | LOG.gf | LOG.Rsg.2, LOG.Cgf.1 [puente de alambre P9]
U11 | 6 | LOG.gin_n | U11.9
U11 | 7 | GND (tierra) | toda la zona de cobre de GND (29 patas) [puente de alambre P44]
U11 | 8 | LOG.g | U9.2
U11 | 9 | LOG.gin_n | U11.6
U14 | 1 | setn | X.setn, U8.2, U8.4, LOG.Rsn.2 [puente de alambre P22]
U14 | 2 | OC.dl | OC.Rd.2, OC.Cd.+
U14 | 3 | OC.ref | OC.T1.W
U14 | 4 | GND (tierra) | toda la zona de cobre de GND (29 patas)
U14 | 5 | GND (tierra) | toda la zona de cobre de GND (29 patas) [puente de alambre P41]
U14 | 6 | GND (tierra) | toda la zona de cobre de GND (29 patas)
U14 | 7 | NC | sin conexion (solo soldar la pata)
U14 | 8 | +5 V | SEN.Rc.1, SEN.Ra.1, U1.8, U11.14, OC.Ra.1, SEN.Rled.1 y 11 mas
U4 | 1 | OC.oa | OC.Rf.1, OC.D1.A [puente de alambre P5]
U4 | 2 | OC.fb | OC.Rg.1, OC.Rf.2 [puente de alambre P3]
U4 | 3 | sh | X.sh
U4 | 4 | GND (tierra) | toda la zona de cobre de GND (29 patas) [puente de alambre P36]
U4 | 5 | GND (tierra) | toda la zona de cobre de GND (29 patas) [puente de alambre P35]
U4 | 6 | GND (tierra) | toda la zona de cobre de GND (29 patas) [puente de alambre P37]
U4 | 7 | NC | sin conexion (solo soldar la pata)
U4 | 8 | +12 V | X.+12V
U8 | 1 | LOG.rst | U11.12
U8 | 10 | f | U8.6, X.f [puente de alambre P12]
U8 | 11 | LOG.pn | U9.10
U8 | 12 | p | U8.13, U9.13, U1.1, SEN.Rpu.2, SEN.Rh.1 [puente de alambre P25]
U8 | 13 | p | U8.12, U9.13, U1.1, SEN.Rpu.2, SEN.Rh.1 [puente de alambre P24]
U8 | 14 | +5 V | ENT.TBG.5V, U9.14, ENT.TBR.5V, LOG.Rsn.1, U11.14, LOG.Cpor.1 y 11 mas [puente de alambre P32]
U8 | 2 | setn | U8.4, LOG.Rsn.2, U14.1, X.setn [puente de alambre P21]
U8 | 3 | LOG.reset_n | U8.9
U8 | 4 | setn | U8.2, LOG.Rsn.2, U14.1, X.setn [puente de alambre P21]
U8 | 5 | fn | U8.8, U9.5 [puente de alambre P2]
U8 | 6 | f | U8.10, X.f [puente de alambre P11]
U8 | 7 | GND (tierra) | toda la zona de cobre de GND (29 patas) [puente de alambre P49]
U8 | 8 | fn | U8.5, U9.5 [puente de alambre P1]
U8 | 9 | LOG.reset_n | U8.3

U9 | 1 | LOG.e | U11.4
U9 | 10 | LOG.pn | U8.11
U9 | 11 | l | X.l
U9 | 12 | m | U9.9, U9.6, X.m [puente de alambre P19]
U9 | 13 | p | U8.12, U8.13, U1.1, SEN.Rpu.2, SEN.Rh.1 [puente de alambre P25]
U9 | 14 | +5 V | LOG.Rsn.1, U8.14, ENT.TBR.5V, ENT.TBG.5V, LOG.Cpor.1, U11.14 y 11 mas [puente de alambre P32]
U9 | 2 | LOG.g | U11.8
U9 | 3 | LOG.m1 | U9.4
U9 | 4 | LOG.m1 | U9.3
U9 | 5 | fn | U8.5, U8.8 [puente de alambre P2]
U9 | 6 | m | U9.9, U9.12, X.m [puente de alambre P17]
U9 | 7 | GND (tierra) | toda la zona de cobre de GND (29 patas) [puente de alambre P49]
U9 | 8 | n | sale de esta placa (conector entre placas)
U9 | 9 | m | U9.6, U9.12, X.m [puente de alambre P18]
X | +12V | +12 V | U4.8
X | +5V | +5 V | SEN.R1.1, SEN.Rpu.1, SEN.Rled.1, SEN.Ra.1, U1.8, SEN.Rc.1 y 11 mas [puente de alambre P28]
X | GND | GND (tierra) | toda la zona de cobre de GND (29 patas)
X | f | f | U8.10, U8.6 [puente de alambre P12]
X | l | l | U9.11
X | m | m | U9.12, U9.9, U9.6 [puente de alambre P19]
X | setn | setn | U14.1, LOG.Rsn.2, U8.4, U8.2 [puente de alambre P22]
X | sh | sh | U4.3
