DiegoCrUz-afk/Proyecto_Final_Electronica_UNIS/7_PCB_placas_de_cobre/PLACA_C_guia_de_conexiones.pdf

## PLACA C - a donde va cada pata (cada agujero)

Agujeros de la fila de arriba: son los puntos para unir las placas entre si con cable (GND, +5 V, +12 V y las senales). Cada uno se conecta a las piezas de esta placa (con pista o con el puente de alambre magenta que sale de el) y, por fuera, con un cable al agujero del mismo nombre de la otra placa.
Red | Agujero de esta placa | Se une con cable a
GND (tierra) | agujero rotulado 'GND (tierra)' en la fila de arriba | el mismo agujero rotulado 'GND (tierra)' de la placa A, placa B
l | agujero rotulado 'l' en la fila de arriba | el mismo agujero rotulado 'l' de la placa B
pwm | agujero rotulado 'pwm' en la fila de arriba | el mismo agujero rotulado 'pwm' de la placa A
+5 V | agujero rotulado '+5 V' en la fila de arriba | el mismo agujero rotulado '+5 V' de la placa A, placa B
+12 V | agujero rotulado '+12 V' en la fila de arriba | el mismo agujero rotulado '+12 V' de la placa A, placa B

El cobre que rodea las pistas es GND (tierra). Los puentes P1, P2... son alambres por el lado de piezas (ver vista de componentes).

Pieza | Pata | Red | Se une con
ENC.Ccvm | 1 | ENC.cvm | U7.5
ENC.Ccvm | 2 | GND (tierra) | toda la zona de cobre de GND (32 patas)
ENC.Cd | 1 | ENC.eq | U3.1, ENC.Rpq.2, ENC.Rhe.1 [puente de alambre P5]
ENC.Cd | 2 | ENC.tg | ENC.Rtg.2, ENC.Dcl.A, U7.2
ENC.Cfv | 1 | ENC.vf1 | ENC.Rfv.2, ENC.Rfv2.1
ENC.Cfv | 2 | GND (tierra) | toda la zona de cobre de GND (32 patas)
ENC.Cfv2 | 1 | vspd | ENC.Rfv2.2, U5.5
ENC.Cfv2 | 2 | GND (tierra) | toda la zona de cobre de GND (32 patas)
ENC.Ct7 | 1 | ENC.dis7 | ENC.Rt7.2, U7.6, U7.7
ENC.Ct7 | 2 | GND (tierra) | toda la zona de cobre de GND (32 patas)
ENC.Dcl | A | ENC.tg | ENC.Rtg.2, ENC.Cd.2, U7.2
ENC.Dcl | K | +5 V | ENC.Rt7.1, ENC.Rtg.1, ENC.Rpq.1, ENC.Ru1.1, U12.14, PWM.Rpu.1 y 12 mas
ENC.OPTO | A | ENC.nled | ENC.Rled.2
ENC.OPTO | C | enc | U3.2, ENC.Rpe.2
ENC.OPTO | E | GND (tierra) | toda la zona de cobre de GND (32 patas) [puente de alambre P26]
ENC.OPTO | K | GND (tierra) | toda la zona de cobre de GND (32 patas) [puente de alambre P27]
ENC.Rfv | 1 | ENC.mq | U12.3
ENC.Rfv | 2 | ENC.vf1 | ENC.Cfv.1, ENC.Rfv2.1
ENC.Rfv2 | 1 | ENC.vf1 | ENC.Cfv.1, ENC.Rfv.2
ENC.Rfv2 | 2 | vspd | ENC.Cfv2.1, U5.5
ENC.Rhe | 1 | ENC.eq | ENC.Rpq.2, ENC.Cd.1, U3.1
ENC.Rhe | 2 | ENC.eref | ENC.Ru2.1, ENC.Ru1.2, U3.3
ENC.Rled | 1 | +5 V | ENC.Rpe.1, ENC.Ru1.1, PWM.Ra5.1, U6.4, U3.8, U6.8 y 12 mas
ENC.Rled | 2 | ENC.nled | ENC.OPTO.A
ENC.Rpe | 1 | +5 V | U3.8, ENC.Rled.1, U6.4, U6.8, ENC.Ru1.1, U12.14 y 12 mas
ENC.Rpe | 2 | enc | U3.2, ENC.OPTO.C
ENC.Rpq | 1 | +5 V | PWM.Rpu.1, ENC.Ru1.1, ENC.Rt7.1, ENC.Dcl.K, ENC.Rled.1, ENC.Rpe.1 y 12 mas

Pieza | Pata | Red | Se une con
ENC.Rpq | 2 | ENC.eq | ENC.Rhe.1, ENC.Cd.1, U3.1 [puente de alambre P4]
ENC.Rt7 | 1 | +5 V | ENC.Dcl.K, ENC.Rpq.1, ENC.Rtg.1, PWM.Rpu.1, ENC.Ru1.1, U12.14 y 12 mas
ENC.Rt7 | 2 | ENC.dis7 | ENC.Ct7.1, U7.6, U7.7
ENC.Rtg | 1 | +5 V | ENC.Dcl.K, ENC.Ru1.1, ENC.Rt7.1, U12.14, U7.4, U7.8 y 12 mas [puente de alambre P12]
ENC.Rtg | 2 | ENC.tg | ENC.Dcl.A, ENC.Cd.2, U7.2
ENC.Ru1 | 1 | +5 V | ENC.Rled.1, ENC.Rpe.1, ENC.Rpq.1, ENC.Rtg.1, PWM.Ra5.1, U6.4 y 12 mas [puente de alambre P12]
ENC.Ru1 | 2 | ENC.eref | ENC.Ru2.1, ENC.Rhe.2, U3.3
ENC.Ru2 | 1 | ENC.eref | ENC.Ru1.2, ENC.Rhe.2, U3.3
ENC.Ru2 | 2 | GND (tierra) | toda la zona de cobre de GND (32 patas) [puente de alambre P15]
ERR.Cf6 | 1 | ERR.oa | ERR.Rf6.1, ERR.Ro.1, U5.14
ERR.Cf6 | 2 | ERR.inn | ERR.Rf6.2, ERR.R1.2, U5.13
ERR.Cv | 1 | ERR.voff | ERR.Rv2.1, ERR.Rv1.2, U5.10
ERR.Cv | 2 | GND (tierra) | toda la zona de cobre de GND (32 patas) [puente de alambre P16]
ERR.Cvc | 1 | vctrl | ERR.Ro.2, U13.3
ERR.Cvc | 2 | GND (tierra) | toda la zona de cobre de GND (32 patas)
ERR.R1 | 1 | ERR.vsb | U5.7, U5.6 [puente de alambre P1]
ERR.R1 | 2 | ERR.inn | ERR.Rf6.2, ERR.Cf6.2, U5.13 [puente de alambre P2]
ERR.R3 | 1 | ERR.vrb | U5.1, U5.2
ERR.R3 | 2 | ERR.inp | ERR.R4.1, U5.12
ERR.R4 | 1 | ERR.inp | ERR.R3.2, U5.12
ERR.R4 | 2 | ERR.vob | U5.8, U5.9
ERR.Rf6 | 1 | ERR.oa | ERR.Cf6.1, ERR.Ro.1, U5.14 [puente de alambre P3]
ERR.Rf6 | 2 | ERR.inn | ERR.Cf6.2, ERR.R1.2, U5.13
ERR.Ro | 1 | ERR.oa | U5.14, ERR.Rf6.1, ERR.Cf6.1 [puente de alambre P3]
ERR.Ro | 2 | vctrl | ERR.Cvc.1, U13.3
ERR.Rv1 | 1 | +5 V | X.+5V, REF.Rt.1, PWM.Ra5.1, U6.4, U6.8, U13.8 y 12 mas
ERR.Rv1 | 2 | ERR.voff | ERR.Rv2.1, U5.10, ERR.Cv.1
ERR.Rv2 | 1 | ERR.voff | ERR.Rv1.2, ERR.Cv.1, U5.10
ERR.Rv2 | 2 | GND (tierra) | toda la zona de cobre de GND (32 patas) [puente de alambre P17]
PWM.Ccv | 1 | PWM.cv | U6.5
PWM.Ccv | 2 | GND (tierra) | toda la zona de cobre de GND (32 patas) [puente de alambre P15]
PWM.Ct | 1 | PWM.tri | PWM.Rb5.2, U6.6, U6.2, U13.2
PWM.Ct | 2 | GND (tierra) | toda la zona de cobre de GND (32 patas) [puente de alambre P14]
PWM.Ra5 | 1 | +5 V | U6.4, U6.8, ENC.Rled.1, U13.8, ENC.Rpe.1, ENC.Ru1.1 y 12 mas [puente de alambre P10]
PWM.Ra5 | 2 | PWM.dis | PWM.Rb5.1, U6.7
PWM.Rb5 | 1 | PWM.dis | PWM.Ra5.2, U6.7
PWM.Rb5 | 2 | PWM.tri | PWM.Ct.1, U6.6, U6.2, U13.2 [puente de alambre P6]

PWM.Rpu | 1 | +5 V | ENC.Rpq.1, PWM.Ra5.1, ENC.Ru1.1, ENC.Rt7.1, ENC.Dcl.K, U6.4 y 12 mas
PWM.Rpu | 2 | pwm | U13.1, X.pwm
REF.Cr | 1 | vref | REF.T2.1, REF.T1.1, REF.Rt.2, U5.3 [puente de alambre P8]
REF.Cr | 2 | GND (tierra) | toda la zona de cobre de GND (32 patas) [puente de alambre P20]
REF.Q5 | B | REF.bq | REF.Rb5.2
REF.Q5 | C | REF.cq | REF.T2.W
REF.Q5 | E | GND (tierra) | toda la zona de cobre de GND (32 patas) [puente de alambre P20]
REF.Rb5 | 1 | l | X.l
REF.Rb5 | 2 | REF.bq | REF.Q5.B
REF.Rt | 1 | +5 V | X.+5V, ERR.Rv1.1, U13.8, U6.8, U3.8, PWM.Ra5.1 y 12 mas [puente de alambre P13]
REF.Rt | 2 | vref | REF.T1.1, U5.3, REF.T2.1, REF.Cr.1
REF.T1 | 1 | vref | REF.Rt.2, U5.3, REF.T2.1, REF.Cr.1
REF.T1 | 3 | NC | sin conexion (solo soldar la pata)
REF.T1 | W | GND (tierra) | toda la zona de cobre de GND (32 patas) [puente de alambre P21]
REF.T2 | 1 | vref | REF.Cr.1, REF.T1.1, REF.Rt.2, U5.3 [puente de alambre P8]
REF.T2 | 3 | NC | sin conexion (solo soldar la pata)
REF.T2 | W | REF.cq | REF.Q5.C
U12 | 1 | ENC.mono | U12.2, U7.3
U12 | 10 | GND (tierra) | toda la zona de cobre de GND (32 patas) [puente de alambre P29]
U12 | 11 | NC | sin conexion (solo soldar la pata)
U12 | 12 | GND (tierra) | toda la zona de cobre de GND (32 patas)
U12 | 13 | GND (tierra) | toda la zona de cobre de GND (32 patas)
U12 | 14 | +5 V | U7.4, U7.8, ENC.Rpe.1, ENC.Rtg.1, U3.8, ENC.Rled.1 y 12 mas
U12 | 2 | ENC.mono | U12.1, U7.3
U12 | 3 | ENC.mq | ENC.Rfv.1
U12 | 4 | GND (tierra) | toda la zona de cobre de GND (32 patas) [puente de alambre P28]
U12 | 5 | GND (tierra) | toda la zona de cobre de GND (32 patas) [puente de alambre P29]
U12 | 6 | NC | sin conexion (solo soldar la pata)
U12 | 7 | GND (tierra) | toda la zona de cobre de GND (32 patas)
U12 | 8 | NC | sin conexion (solo soldar la pata)
U12 | 9 | GND (tierra) | toda la zona de cobre de GND (32 patas)
U13 | 1 | pwm | X.pwm, PWM.Rpu.2
U13 | 2 | PWM.tri | U6.2, U6.6, PWM.Rb5.2, PWM.Ct.1 [puente de alambre P7]
U13 | 3 | vctrl | ERR.Ro.2, ERR.Cvc.1
U13 | 4 | GND (tierra) | toda la zona de cobre de GND (32 patas) [puente de alambre P24]
U13 | 5 | GND (tierra) | toda la zona de cobre de GND (32 patas) [puente de alambre P23]
U13 | 6 | GND (tierra) | toda la zona de cobre de GND (32 patas)
U13 | 7 | NC | sin conexion (solo soldar la pata)
U13 | 8 | +5 V | U6.8, U3.8, PWM.Ra5.1, U6.4, ENC.Rpe.1, ENC.Rled.1 y 12 mas [puente de alambre P11]

U3 | 1 | ENC.eq | ENC.Cd.1, ENC.Rpq.2, ENC.Rhe.1 [puente de alambre P5]
U3 | 2 | enc | ENC.OPTO.C, ENC.Rpe.2
U3 | 3 | ENC.eref | ENC.Ru1.2, ENC.Ru2.1, ENC.Rhe.2
U3 | 4 | GND (tierra) | toda la zona de cobre de GND (32 patas) [puente de alambre P26]
U3 | 5 | GND (tierra) | toda la zona de cobre de GND (32 patas) [puente de alambre P25]
U3 | 6 | GND (tierra) | toda la zona de cobre de GND (32 patas)
U3 | 7 | NC | sin conexion (solo soldar la pata)
U3 | 8 | +5 V | ENC.Rpe.1, U13.8, ENC.Rled.1, U7.8, U6.4, U6.8 y 12 mas
U5 | 1 | ERR.vrb | U5.2, ERR.R3.1
U5 | 10 | ERR.voff | ERR.Rv1.2, ERR.Rv2.1, ERR.Cv.1
U5 | 11 | GND (tierra) | toda la zona de cobre de GND (32 patas) [puente de alambre P22]
U5 | 12 | ERR.inp | ERR.R3.2, ERR.R4.1
U5 | 13 | ERR.inn | ERR.R1.2, ERR.Rf6.2, ERR.Cf6.2 [puente de alambre P2]
U5 | 14 | ERR.oa | ERR.Ro.1, ERR.Rf6.1, ERR.Cf6.1
U5 | 2 | ERR.vrb | U5.1, ERR.R3.1
U5 | 3 | vref | REF.Rt.2, REF.T1.1, REF.T2.1, REF.Cr.1
U5 | 4 | +12 V | X.+12V
U5 | 5 | vspd | ENC.Rfv2.2, ENC.Cfv2.1
U5 | 6 | ERR.vsb | U5.7, ERR.R1.1
U5 | 7 | ERR.vsb | U5.6, ERR.R1.1 [puente de alambre P1]
U5 | 8 | ERR.vob | U5.9, ERR.R4.2
U5 | 9 | ERR.vob | U5.8, ERR.R4.2
U6 | 1 | GND (tierra) | toda la zona de cobre de GND (32 patas)
U6 | 2 | PWM.tri | U6.6, U13.2, PWM.Rb5.2, PWM.Ct.1 [puente de alambre P7]
U6 | 3 | NC | sin conexion (solo soldar la pata)
U6 | 4 | +5 V | PWM.Ra5.1, U6.8, ENC.Rpe.1, ENC.Rled.1, U13.8, U3.8 y 12 mas [puente de alambre P9]
U6 | 5 | PWM.cv | PWM.Ccv.1
U6 | 6 | PWM.tri | U6.2, U13.2, PWM.Rb5.2, PWM.Ct.1 [puente de alambre P6]
U6 | 7 | PWM.dis | PWM.Ra5.2, PWM.Rb5.1
U6 | 8 | +5 V | PWM.Ra5.1, U13.8, U6.4, ENC.Rpe.1, U3.8, ENC.Rled.1 y 12 mas [puente de alambre P11]
U7 | 1 | GND (tierra) | toda la zona de cobre de GND (32 patas) [puente de alambre P28]
U7 | 2 | ENC.tg | ENC.Cd.2, ENC.Rtg.2, ENC.Dcl.A
U7 | 3 | ENC.mono | U12.1, U12.2
U7 | 4 | +5 V | U7.8, U12.14, ENC.Rpe.1, ENC.Rtg.1, U3.8, ENC.Rled.1 y 12 mas
U7 | 5 | ENC.cvm | ENC.Ccvm.1
U7 | 6 | ENC.dis7 | U7.7, ENC.Rt7.2, ENC.Ct7.1
U7 | 7 | ENC.dis7 | U7.6, ENC.Rt7.2, ENC.Ct7.1
U7 | 8 | +5 V | U7.4, U12.14, U3.8, ENC.Rpe.1, ENC.Rtg.1, U13.8 y 12 mas
X | +12V | +12 V | U5.4

X | +5V | +5 V | ERR.Rv1.1, REF.Rt.1, PWM.Ra5.1, U6.4, U6.8, U13.8 y 12 mas [puente de alambre P13]
X | GND | GND (tierra) | toda la zona de cobre de GND (32 patas) [puente de alambre P21]
X | l | l | REF.Rb5.1
X | pwm | pwm | U13.1, PWM.Rpu.2
