DiegoCrUz-afk/Proyecto_Final_Electronica_UNIS/3_archivos_tecnicos/pcb/salida/PLACA_A_guia_de_conexiones.pdf

## PLACA A - a donde va cada pata (cada agujero)

Agujeros de la fila de arriba: son los puntos para unir las placas entre si con cable (GND, +5 V, +12 V y las senales). Cada uno se conecta a las piezas de esta placa (con pista o con el puente de alambre magenta que sale de el) y, por fuera, con un cable al agujero del mismo nombre de la otra placa.
Red | Agujero de esta placa | Se une con cable a
GND (tierra) | agujero rotulado 'GND (tierra)' en la fila de arriba | el mismo agujero rotulado 'GND (tierra)' de la placa B, placa C
f | agujero rotulado 'f' en la fila de arriba | el mismo agujero rotulado 'f' de la placa B
m | agujero rotulado 'm' en la fila de arriba | el mismo agujero rotulado 'm' de la placa B
pwm | agujero rotulado 'pwm' en la fila de arriba | el mismo agujero rotulado 'pwm' de la placa C
setn | agujero rotulado 'setn' en la fila de arriba | el mismo agujero rotulado 'setn' de la placa B
sh | agujero rotulado 'sh' en la fila de arriba | el mismo agujero rotulado 'sh' de la placa B
+5 V | agujero rotulado '+5 V' en la fila de arriba | el mismo agujero rotulado '+5 V' de la placa B, placa C
+12 V | agujero rotulado '+12 V' en la fila de arriba | el mismo agujero rotulado '+12 V' de la placa B, placa C

El cobre que rodea las pistas es GND (tierra). Los puentes P1, P2... son alambres por el lado de piezas (ver vista de componentes).

Pieza | Pata | Red | Se une con
ALA.BZ | + | +12 V | REG.Q1.C, ENT.D1.K, REG.Rz.1, ENT.Cin.+, ENT.TBM.M+, POT.Dfw.K y 1 mas
ALA.BZ | - | ALA.cz | ALA.Q6.C
ALA.Dl | A | ALA.nl | ALA.Rl.2
ALA.Dl | K | GND (tierra) | toda la zona de cobre de GND (23 patas)
ALA.Q6 | B | ALA.ba | ALA.Rb.2
ALA.Q6 | C | ALA.cz | ALA.BZ.-
ALA.Q6 | E | GND (tierra) | toda la zona de cobre de GND (23 patas) [puente de alambre P16]
ALA.Rb | 1 | f | ALA.Rl.1, X.f [puente de alambre P7]
ALA.Rb | 2 | ALA.ba | ALA.Q6.B
ALA.Rl | 1 | f | ALA.Rb.1, X.f
ALA.Rl | 2 | ALA.nl | ALA.Dl.A
ENT.Cin | + | +12 V | ENT.D1.K, ENT.TBM.M+, X.+12V, REG.Q1.C, REG.Rz.1, ALA.BZ.+ y 1 mas
ENT.Cin | - | GND (tierra) | toda la zona de cobre de GND (23 patas)
ENT.D1 | A | vin | ENT.J1.+12V
ENT.D1 | K | +12 V | ENT.Cin.+, ENT.TBM.M+, X.+12V, REG.Q1.C, REG.Rz.1, ALA.BZ.+ y 1 mas
ENT.J1 | +12V | vin | ENT.D1.A
ENT.J1 | GND | GND (tierra) | toda la zona de cobre de GND (23 patas) [puente de alambre P19]
ENT.TBM | M+ | +12 V | ENT.Cin.+, X.+12V, REG.Q1.C, ENT.D1.K, REG.Rz.1, POT.Dfw.K y 1 mas
ENT.TBM | M- | dm | POT.M1.D, POT.Dfw.A
ENT.TBN | 5V | +5 V | TMP.Ra.1, U2.8, REG.C2.1, REG.Cout.+, REG.Q1.E, POT.Q3.C y 2 mas
ENT.TBN | NTC | tnode | TMP.Rfix.1, U2.2
POT.Dfw | A | dm | POT.M1.D, ENT.TBM.M-

Pieza | Pata | Red | Se une con
POT.Dfw | K | +12 V | REG.Q1.C, ENT.TBM.M+, X.+12V, ALA.BZ.+, ENT.Cin.+, ENT.D1.K y 1 mas
POT.M1 | D | dm | POT.Dfw.A, ENT.TBM.M-
POT.M1 | G | POT.gate | POT.Rpd.1, POT.Rg.2
POT.M1 | S | sh | POT.Rsh.1, X.sh
POT.Q3 | B | POT.pwmg | POT.Q4.B, U10.3 [puente de alambre P5]
POT.Q3 | C | +5 V | U10.14, REG.Q1.E, REG.Cout.+, REG.C2.1, TMP.Ra.1, X.+5V y 2 mas [puente de alambre P10]
POT.Q3 | E | POT.g | POT.Q4.E, POT.Rg.1 [puente de alambre P3]
POT.Q4 | B | POT.pwmg | POT.Q3.B, U10.3 [puente de alambre P4]
POT.Q4 | C | GND (tierra) | toda la zona de cobre de GND (23 patas) [puente de alambre P13]
POT.Q4 | E | POT.g | POT.Q3.E, POT.Rg.1 [puente de alambre P3]
POT.Rg | 1 | POT.g | POT.Q4.E, POT.Q3.E
POT.Rg | 2 | POT.gate | POT.Rpd.1, POT.M1.G
POT.Rpd | 1 | POT.gate | POT.Rg.2, POT.M1.G
POT.Rpd | 2 | GND (tierra) | toda la zona de cobre de GND (23 patas)
POT.Rsh | 1 | sh | POT.M1.S, X.sh
POT.Rsh | 2 | GND (tierra) | toda la zona de cobre de GND (23 patas) [puente de alambre P15]
REG.C2 | 1 | +5 V | REG.Cout.+, REG.Q1.E, X.+5V, POT.Q3.C, U10.14, ENT.TBN.5V y 2 mas
REG.C2 | 2 | GND (tierra) | toda la zona de cobre de GND (23 patas)
REG.Cout | + | +5 V | REG.Q1.E, REG.C2.1, X.+5V, POT.Q3.C, U10.14, TMP.Ra.1 y 2 mas
REG.Cout | - | GND (tierra) | toda la zona de cobre de GND (23 patas)
REG.DZ | A | REG.N1 | REG.Rtr.W
REG.DZ | K | REG.bz | REG.Rz.2, REG.Q1.B [puente de alambre P6]
REG.Q1 | B | REG.bz | REG.DZ.K, REG.Rz.2 [puente de alambre P6]
REG.Q1 | C | +12 V | ENT.TBM.M+, ENT.Cin.+, X.+12V, ENT.D1.K, REG.Rz.1, POT.Dfw.K y 1 mas
REG.Q1 | E | +5 V | REG.Cout.+, REG.C2.1, X.+5V, POT.Q3.C, U10.14, TMP.Ra.1 y 2 mas [puente de alambre P11]
REG.Rtr | 1 | GND (tierra) | toda la zona de cobre de GND (23 patas)
REG.Rtr | 3 | NC | sin conexion (solo soldar la pata)
REG.Rtr | W | REG.N1 | REG.DZ.A
REG.Rz | 1 | +12 V | REG.Q1.C, ENT.D1.K, ENT.Cin.+, ENT.TBM.M+, ALA.BZ.+, X.+12V y 1 mas
REG.Rz | 2 | REG.bz | REG.DZ.K, REG.Q1.B
TMP.Ra | 1 | +5 V | U2.8, ENT.TBN.5V, POT.Q3.C, U10.14, REG.Q1.E, REG.Cout.+ y 2 mas [puente de alambre P12]
TMP.Ra | 2 | TMP.rt | TMP.T1.1
TMP.Rb | 1 | TMP.rb2 | TMP.T1.3
TMP.Rb | 2 | GND (tierra) | toda la zona de cobre de GND (23 patas) [puente de alambre P18]
TMP.Rfix | 1 | tnode | U2.2, ENT.TBN.NTC

Pieza | Pata | Red | Se une con
TMP.Rfix | 2 | GND (tierra) | toda la zona de cobre de GND (23 patas) [puente de alambre P18]
TMP.Rh | 1 | setn | U2.1, X.setn [puente de alambre P8]
TMP.Rh | 2 | TMP.ref | TMP.T1.W, U2.3
TMP.T1 | 1 | TMP.rt | TMP.Ra.2
TMP.T1 | 3 | TMP.rb2 | TMP.Rb.1
TMP.T1 | W | TMP.ref | TMP.Rh.2, U2.3
U10 | 1 | pwm | X.pwm [puente de alambre P2]
U10 | 10 | GND (tierra) | toda la zona de cobre de GND (23 patas)
U10 | 11 | NC | sin conexion (solo soldar la pata)
U10 | 12 | GND (tierra) | toda la zona de cobre de GND (23 patas)
U10 | 13 | GND (tierra) | toda la zona de cobre de GND (23 patas)
U10 | 14 | +5 V | POT.Q3.C, U2.8, REG.Q1.E, REG.Cout.+, REG.C2.1, TMP.Ra.1 y 2 mas [puente de alambre P10]
U10 | 2 | m | X.m [puente de alambre P1]
U10 | 3 | POT.pwmg | POT.Q3.B, POT.Q4.B [puente de alambre P5]
U10 | 4 | GND (tierra) | toda la zona de cobre de GND (23 patas)
U10 | 5 | GND (tierra) | toda la zona de cobre de GND (23 patas) [puente de alambre P14]
U10 | 6 | NC | sin conexion (solo soldar la pata)
U10 | 7 | GND (tierra) | toda la zona de cobre de GND (23 patas)
U10 | 8 | NC | sin conexion (solo soldar la pata)
U10 | 9 | GND (tierra) | toda la zona de cobre de GND (23 patas) [puente de alambre P13]
U2 | 1 | setn | TMP.Rh.1, X.setn
U2 | 2 | tnode | TMP.Rfix.1, ENT.TBN.NTC
U2 | 3 | TMP.ref | TMP.Rh.2, TMP.T1.W
U2 | 4 | GND (tierra) | toda la zona de cobre de GND (23 patas)
U2 | 5 | GND (tierra) | toda la zona de cobre de GND (23 patas) [puente de alambre P17]
U2 | 6 | GND (tierra) | toda la zona de cobre de GND (23 patas)
U2 | 7 | NC | sin conexion (solo soldar la pata)
U2 | 8 | +5 V | TMP.Ra.1, U10.14, POT.Q3.C, ENT.TBN.5V, REG.Q1.E, REG.Cout.+ y 2 mas [puente de alambre P12]
X | +12V | +12 V | ENT.TBM.M+, ENT.Cin.+, REG.Q1.C, ENT.D1.K, REG.Rz.1, POT.Dfw.K y 1 mas
X | +5V | +5 V | REG.Q1.E, REG.Cout.+, REG.C2.1, POT.Q3.C, U10.14, TMP.Ra.1 y 2 mas [puente de alambre P11]
X | GND | GND (tierra) | toda la zona de cobre de GND (23 patas) [puente de alambre P19]
X | f | f | ALA.Rb.1, ALA.Rl.1 [puente de alambre P7]
X | m | m | U10.2 [puente de alambre P1]
X | pwm | pwm | U10.1 [puente de alambre P2]
X | setn | setn | TMP.Rh.1, U2.1 [puente de alambre P8]
X | sh | sh | POT.M1.S, POT.Rsh.1
