DiegoCrUz-afk/Proyecto_Final_Electronica_UNIS/3_archivos_tecnicos/pcb/salida/PLACA_C_cobre_para_planchado_ESPEJO.pdf

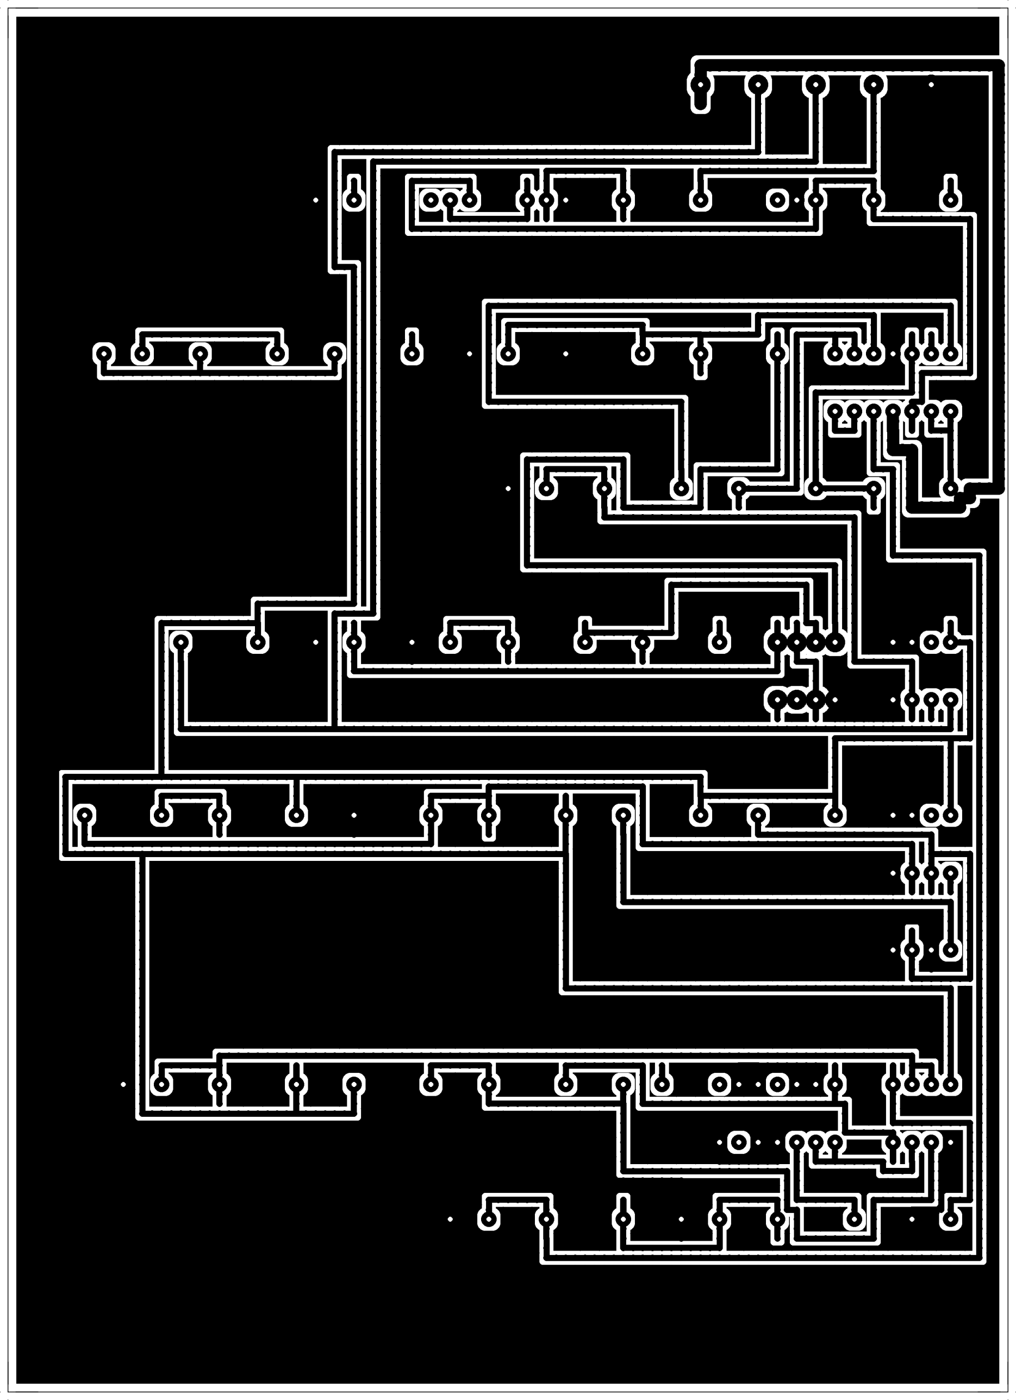
[picture p29: figure]

PLACA C cobre ESPEJADO (toner) - imprimir al 100 por ciento (sin ajustar a la pagina). Ancho 132.1 mm, alto 182.9 mm.
