DiegoCrUz-afk/Proyecto_Final_Electronica_UNIS/2_LTspice/SISTEMA_COMPLETO_esquematico.png

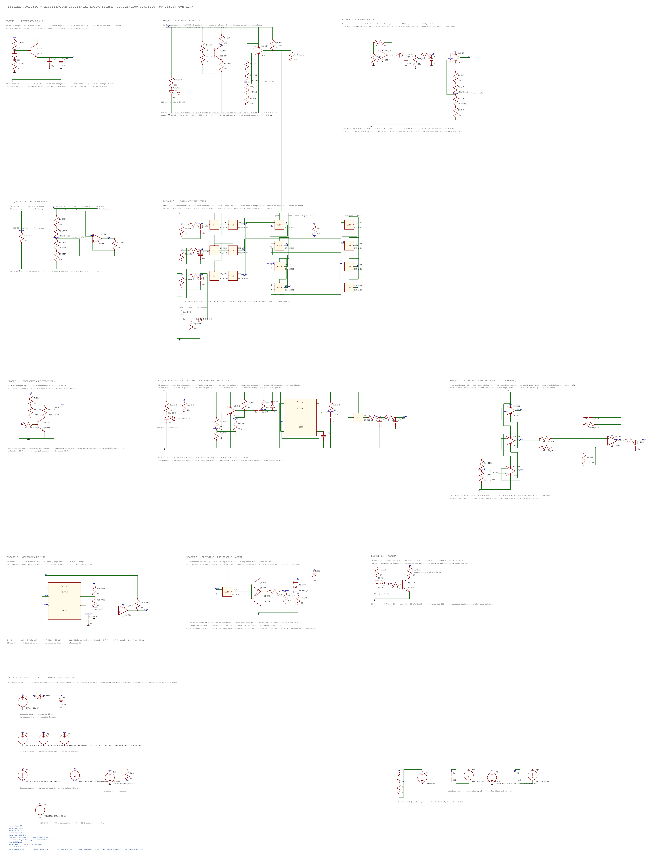
2_LTspice/SISTEMA_COMPLETO_esquematico.png
