DiegoCrUz-afk/Proyecto_Final_Electronica_UNIS/3_archivos_tecnicos/multisim/SISTEMA_COMPLETO_multisim.png

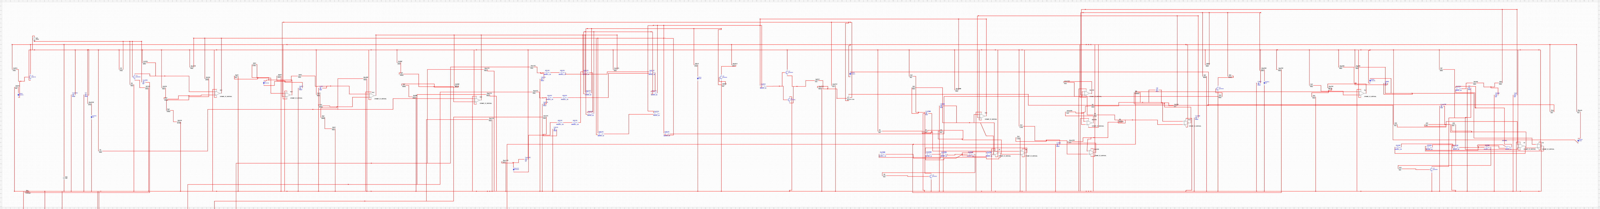
3_archivos_tecnicos/multisim/SISTEMA_COMPLETO_multisim.png
