DiegoCrUz-afk/Proyecto_Final_Electronica_UNIS/3_archivos_tecnicos/pcb/salida/PLACA_A_cobre_para_planchado_ESPEJO.png

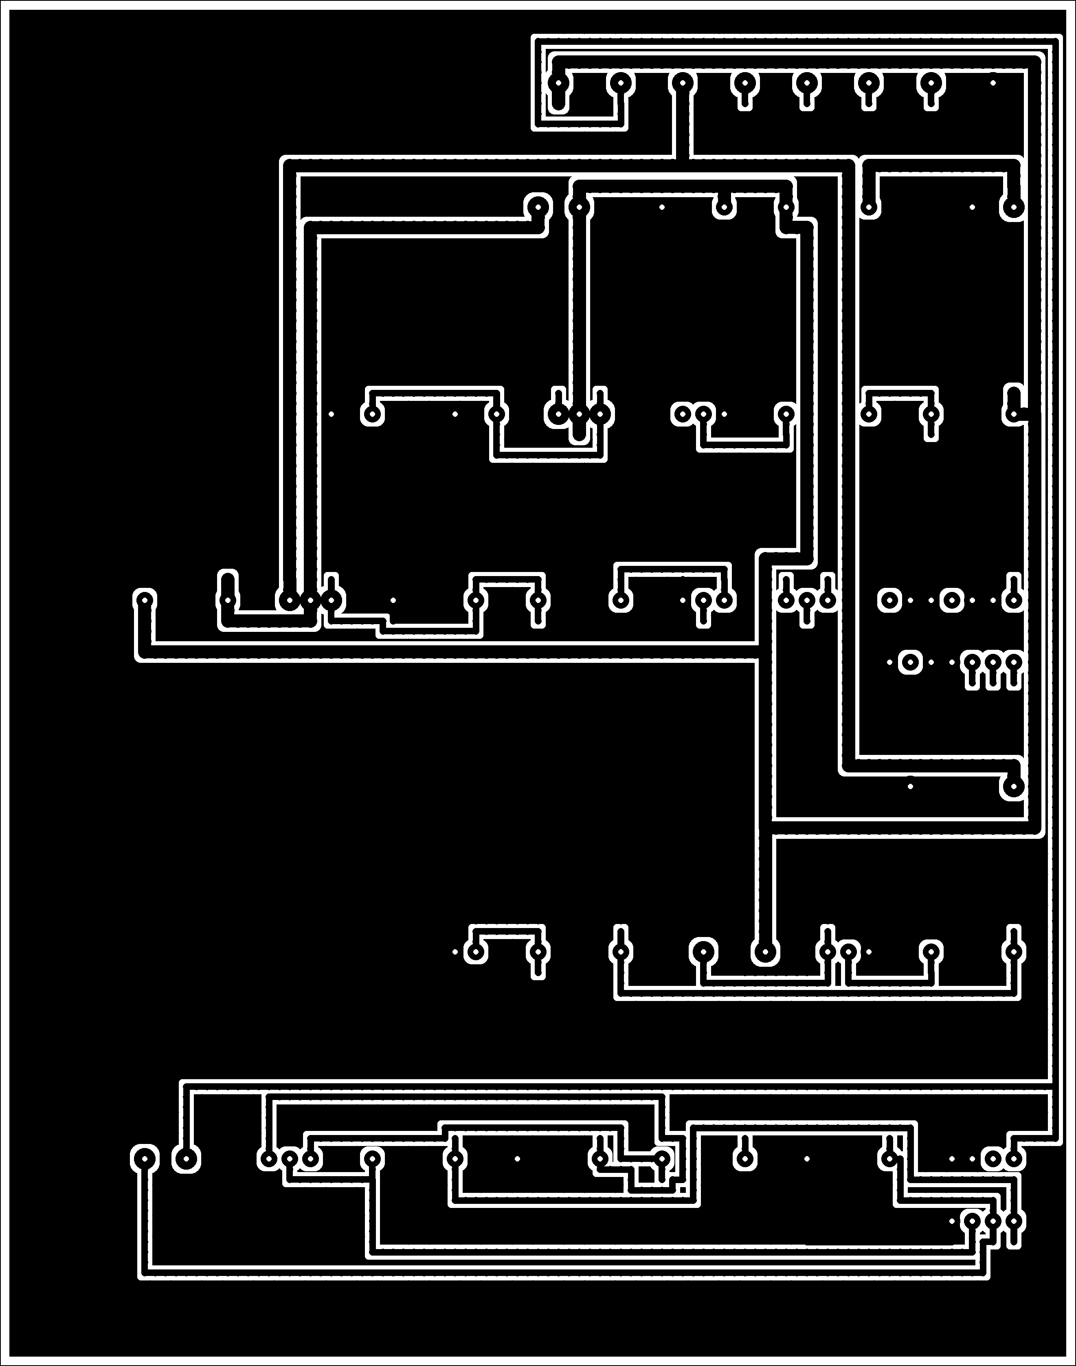
3_archivos_tecnicos/pcb/salida/PLACA_A_cobre_para_planchado_ESPEJO.png
