DiegoCrUz-afk/Proyecto_Final_Electronica_UNIS/3_archivos_tecnicos/pcb/salida/PLACA_A_cobre_vista_normal.png

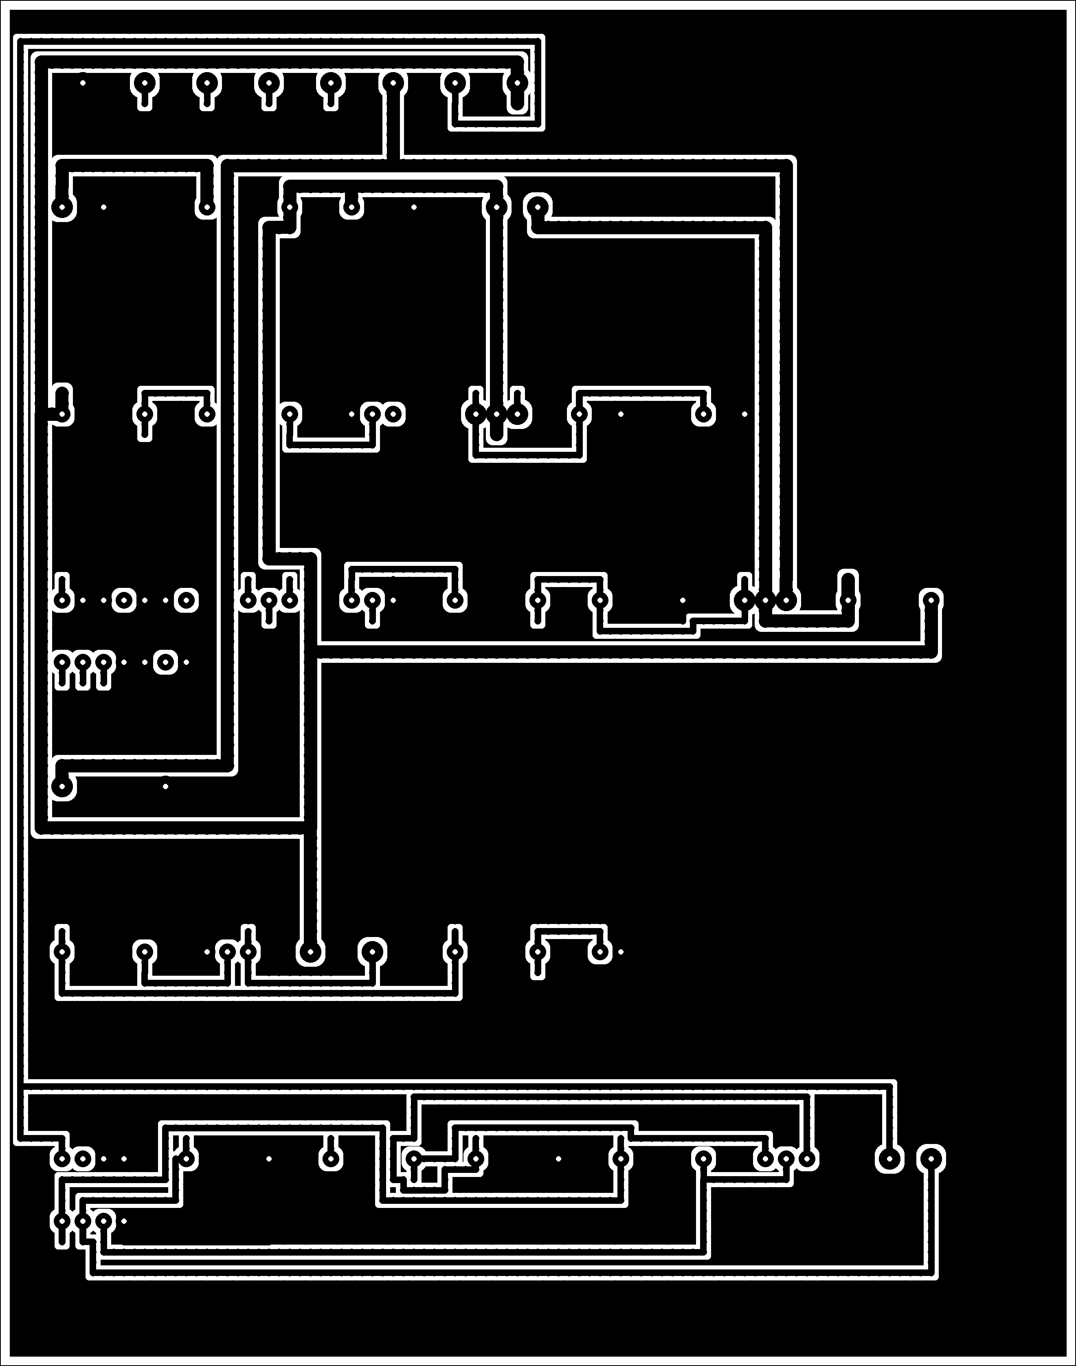
3_archivos_tecnicos/pcb/salida/PLACA_A_cobre_vista_normal.png
