DiegoCrUz-afk/Proyecto_Final_Electronica_UNIS/4_Documentacion/img/BLOQUE_ALARMA.png

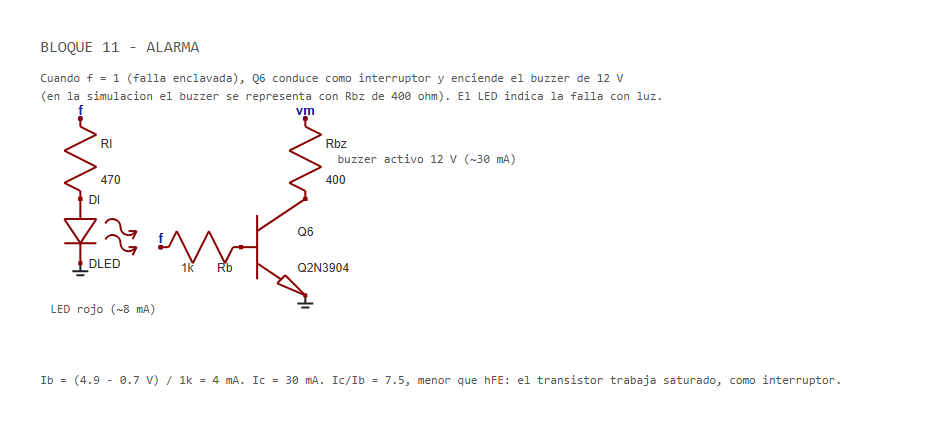
4_Documentacion/img/BLOQUE_ALARMA.png
