DiegoCrUz-afk/Proyecto_Final_Electronica_UNIS/4_Documentacion/img/BLOQUE_ERROR_AMP.png

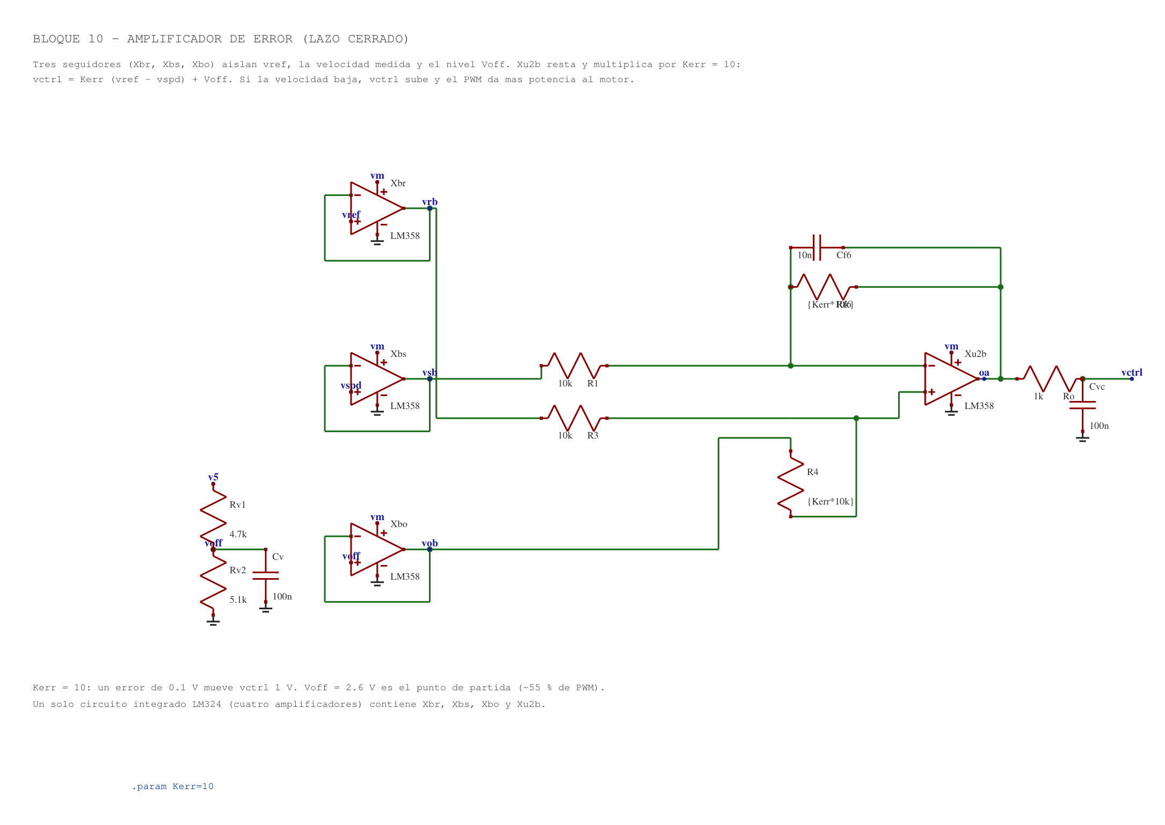
4_Documentacion/img/BLOQUE_ERROR_AMP.png
