DiegoCrUz-afk/Proyecto_Final_Electronica_UNIS/4_Documentacion/img/lt_ALARMA.png

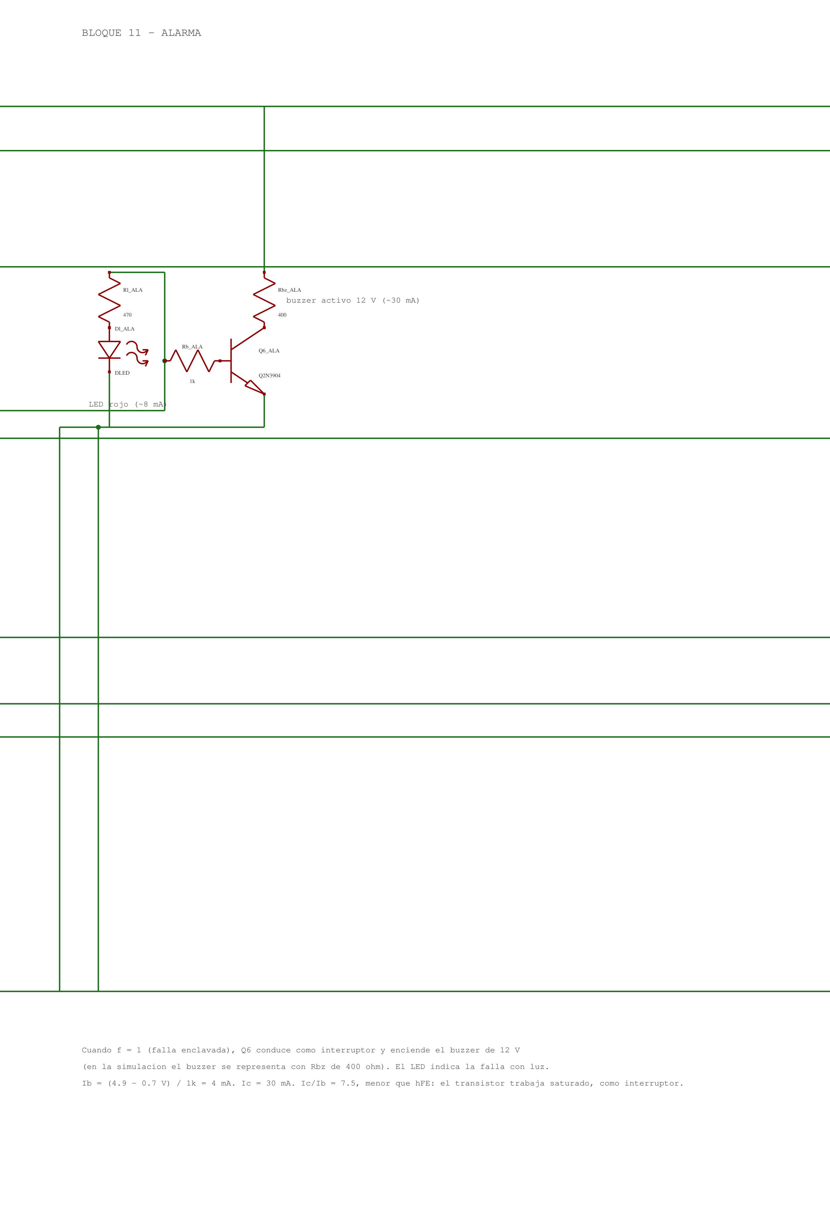
4_Documentacion/img/lt_ALARMA.png
