DiegoCrUz-afk/Proyecto_Final_Electronica_UNIS/4_Documentacion/img/lt_ENCODER_FV.png

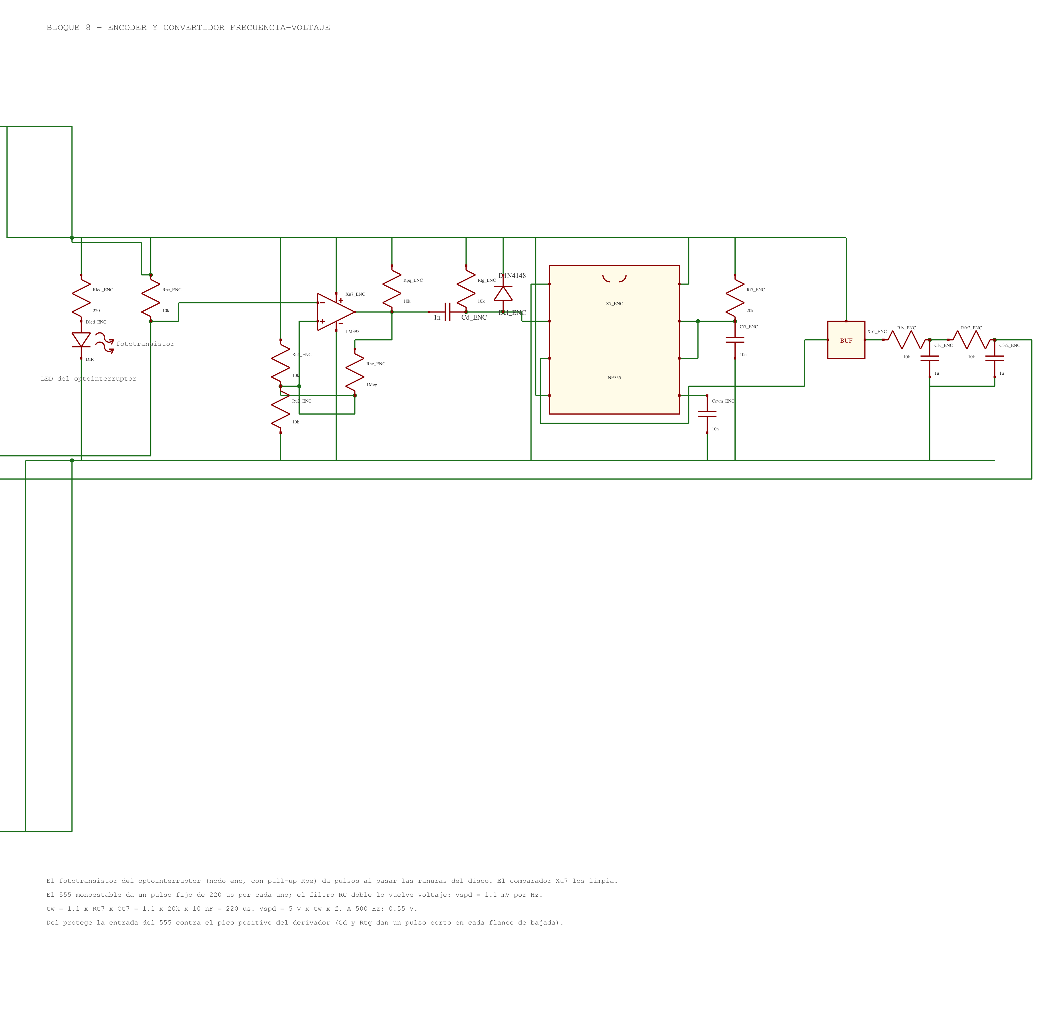
4_Documentacion/img/lt_ENCODER_FV.png
