DiegoCrUz-afk/Proyecto_Final_Electronica_UNIS/4_Documentacion/img/lt_ENTRADA.png

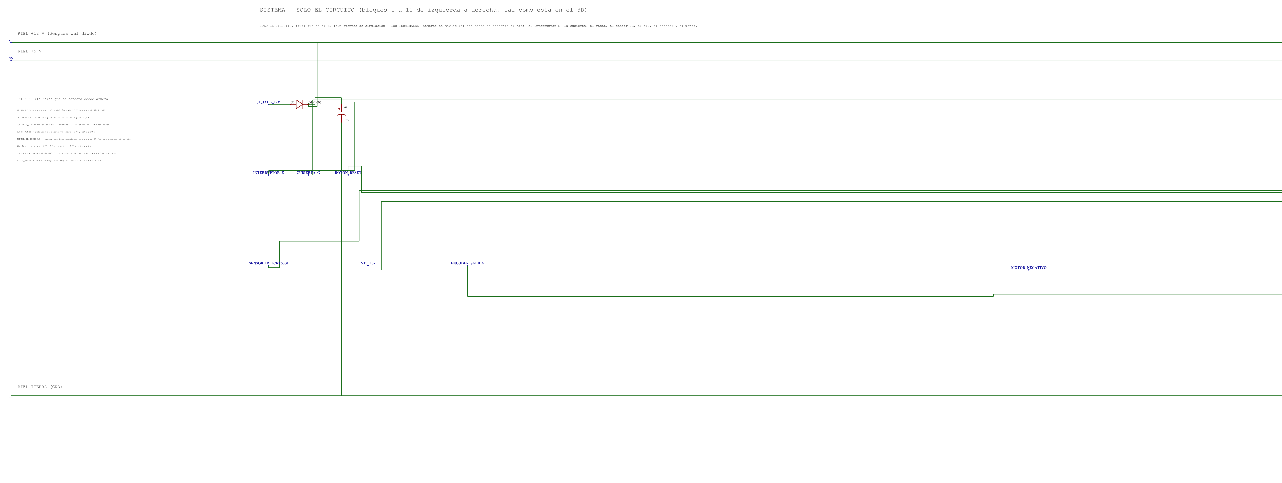
4_Documentacion/img/lt_ENTRADA.png
