DiegoCrUz-afk/Proyecto_Final_Electronica_UNIS/4_Documentacion/img/lt_LOGICA.png

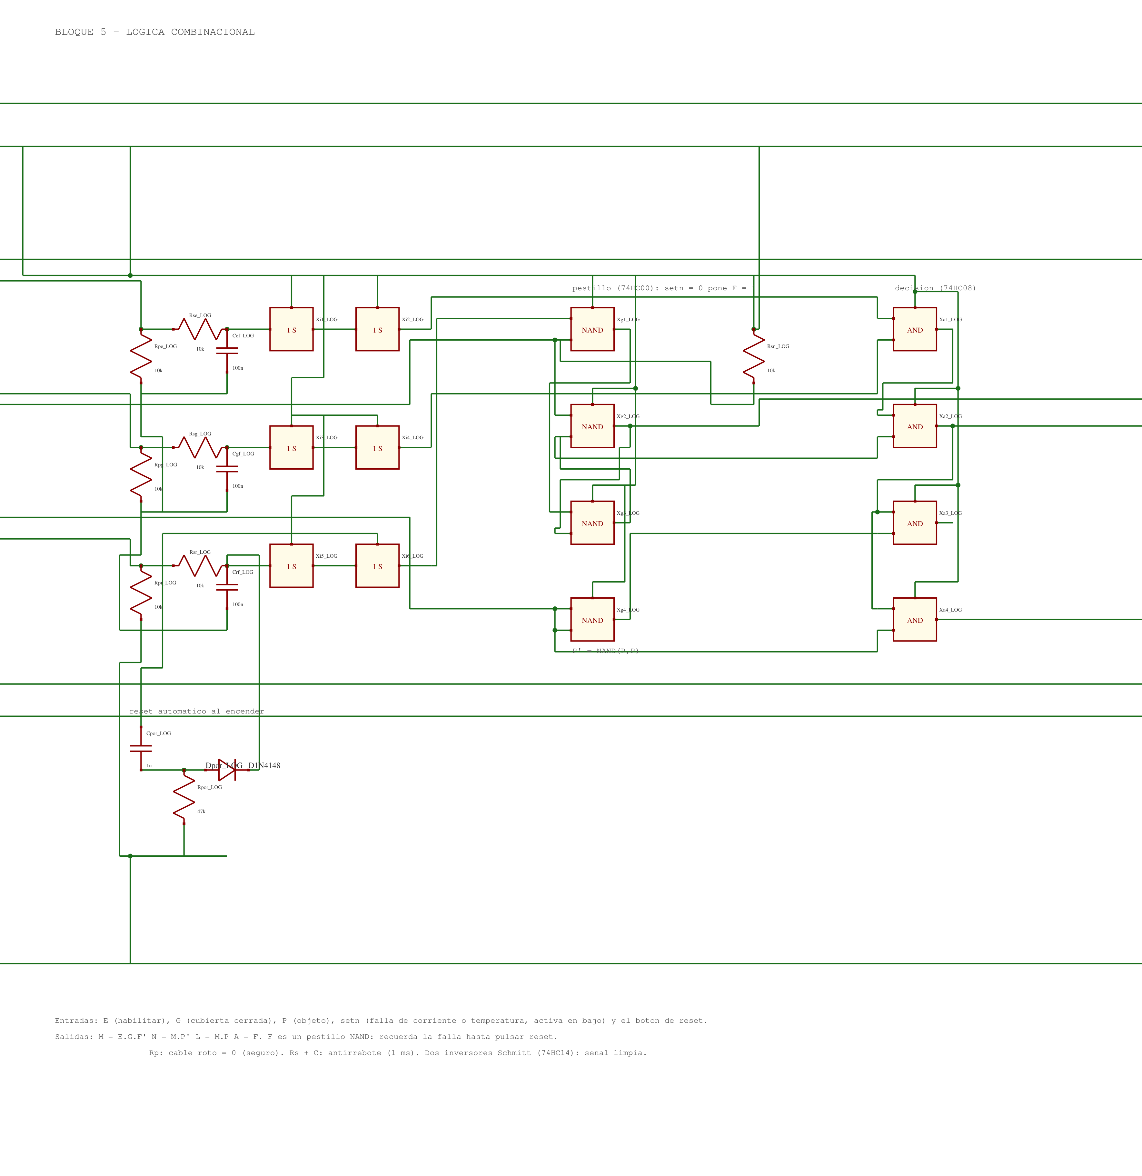
4_Documentacion/img/lt_LOGICA.png
