DiegoCrUz-afk/Proyecto_Final_Electronica_UNIS/4_Documentacion/img/lt_REG5V.png

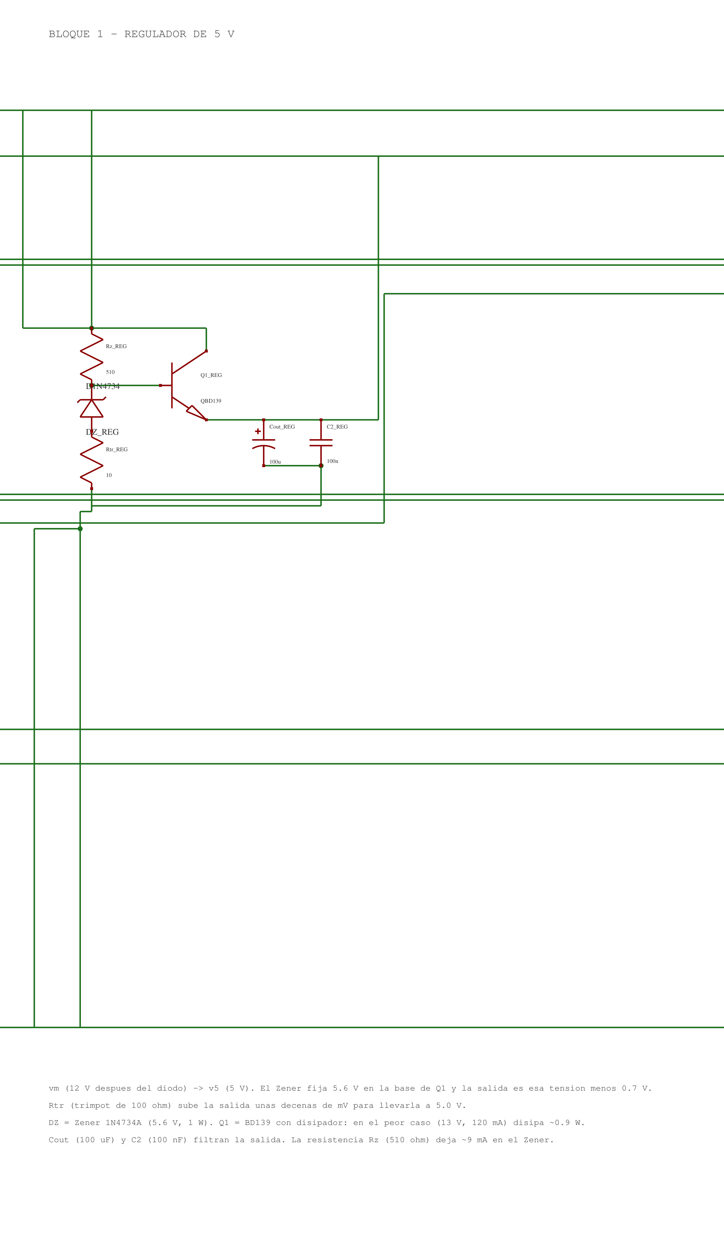
4_Documentacion/img/lt_REG5V.png
