DiegoCrUz-afk/Proyecto_Final_Electronica_UNIS/4_Documentacion/img/lt_SENSOR_IR.png

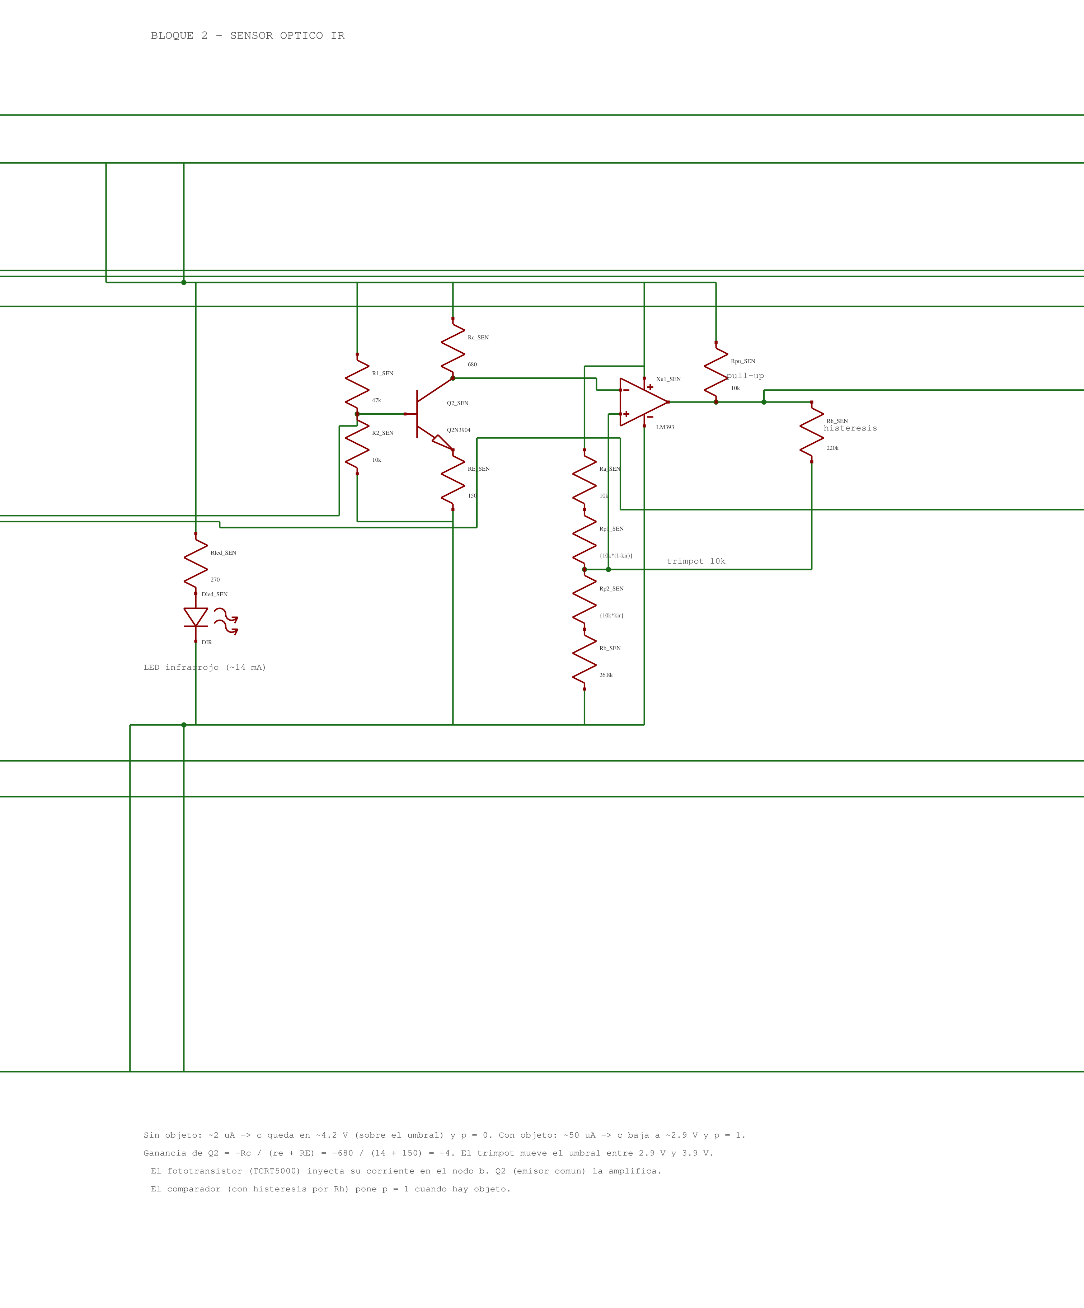
4_Documentacion/img/lt_SENSOR_IR.png
