DiegoCrUz-afk/Proyecto_Final_Electronica_UNIS/4_Documentacion/img/lt_TEMPERATURA.png

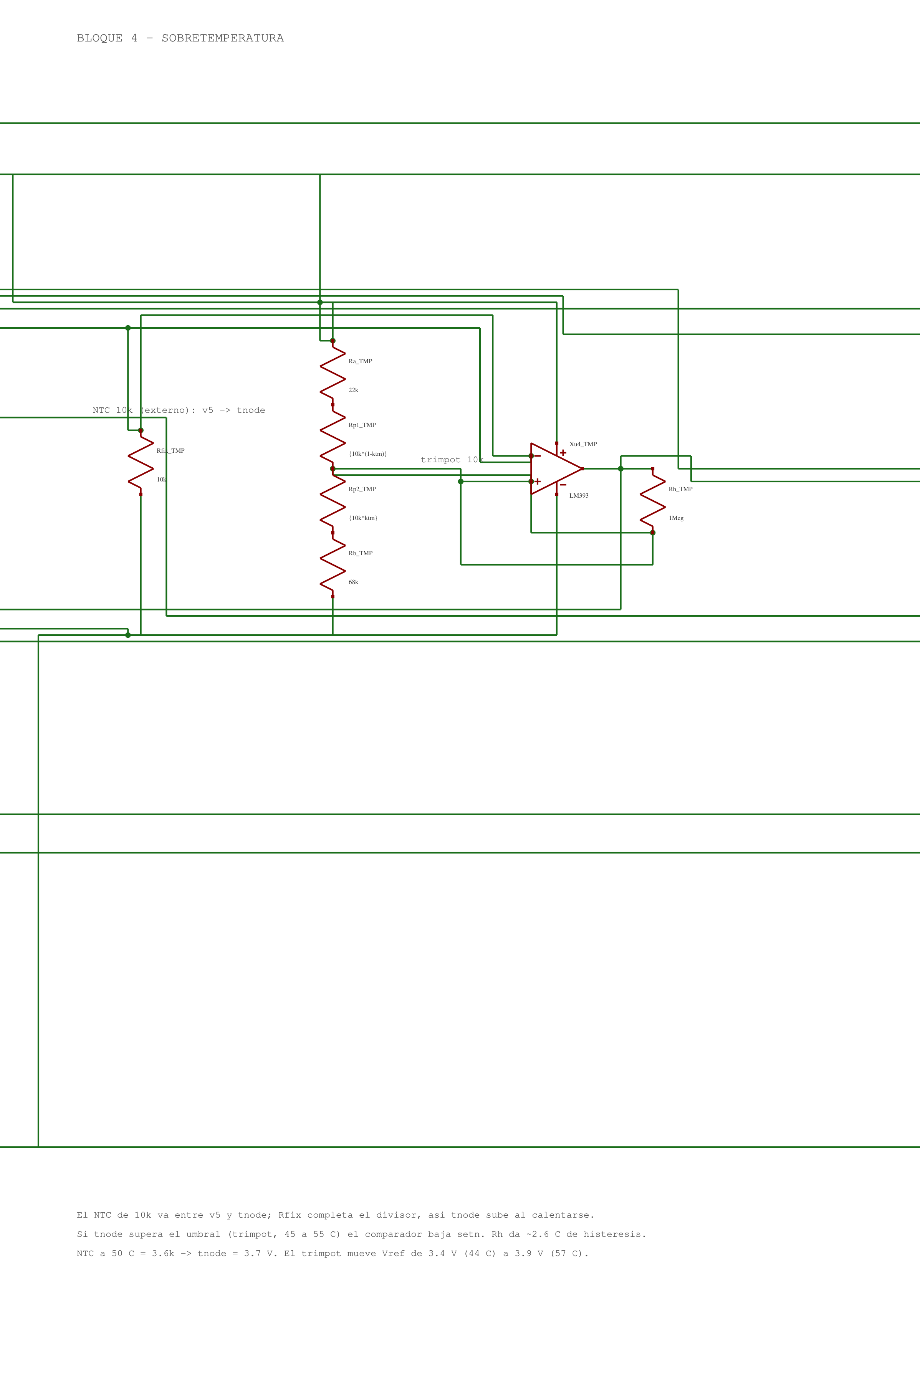
4_Documentacion/img/lt_TEMPERATURA.png
