DiegoCrUz-afk/Proyecto_Final_Electronica_UNIS/4_Documentacion/img/SISTEMA_COMPLETO.png

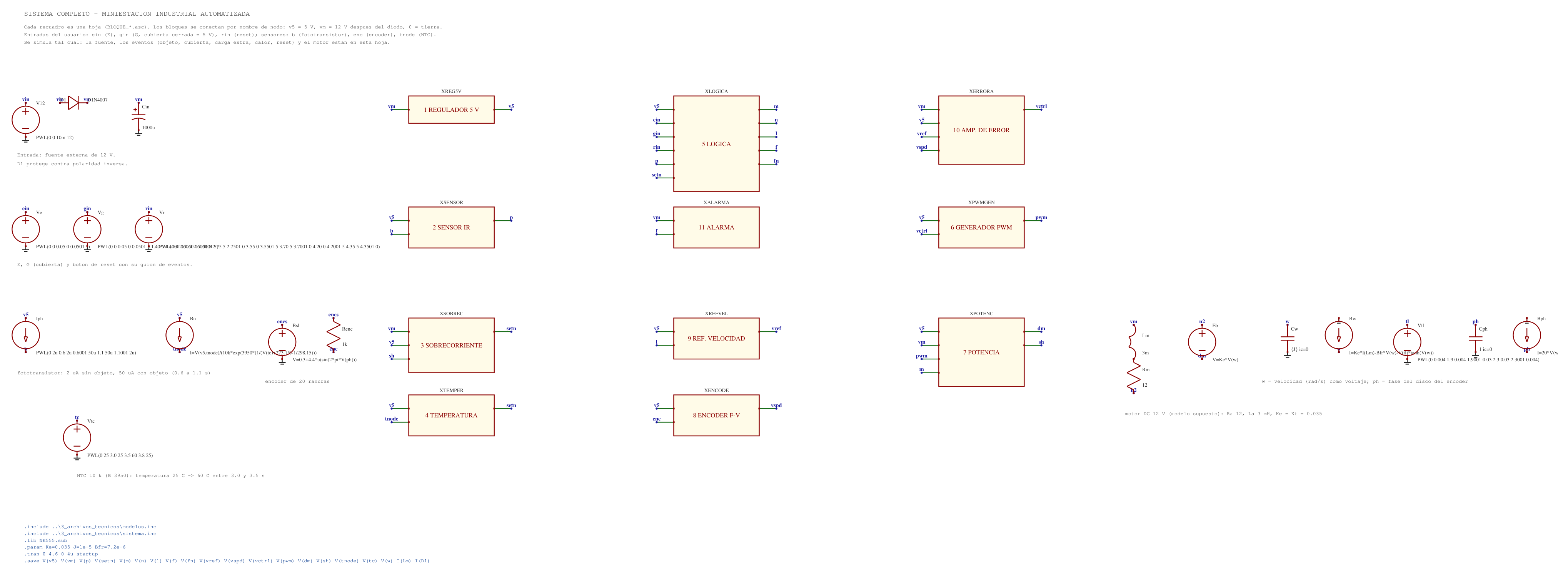
4_Documentacion/img/SISTEMA_COMPLETO.png
