DiegoCrUz-afk/Proyecto_Final_Electronica_UNIS/4_Documentacion/img/v6_LOGICA.png

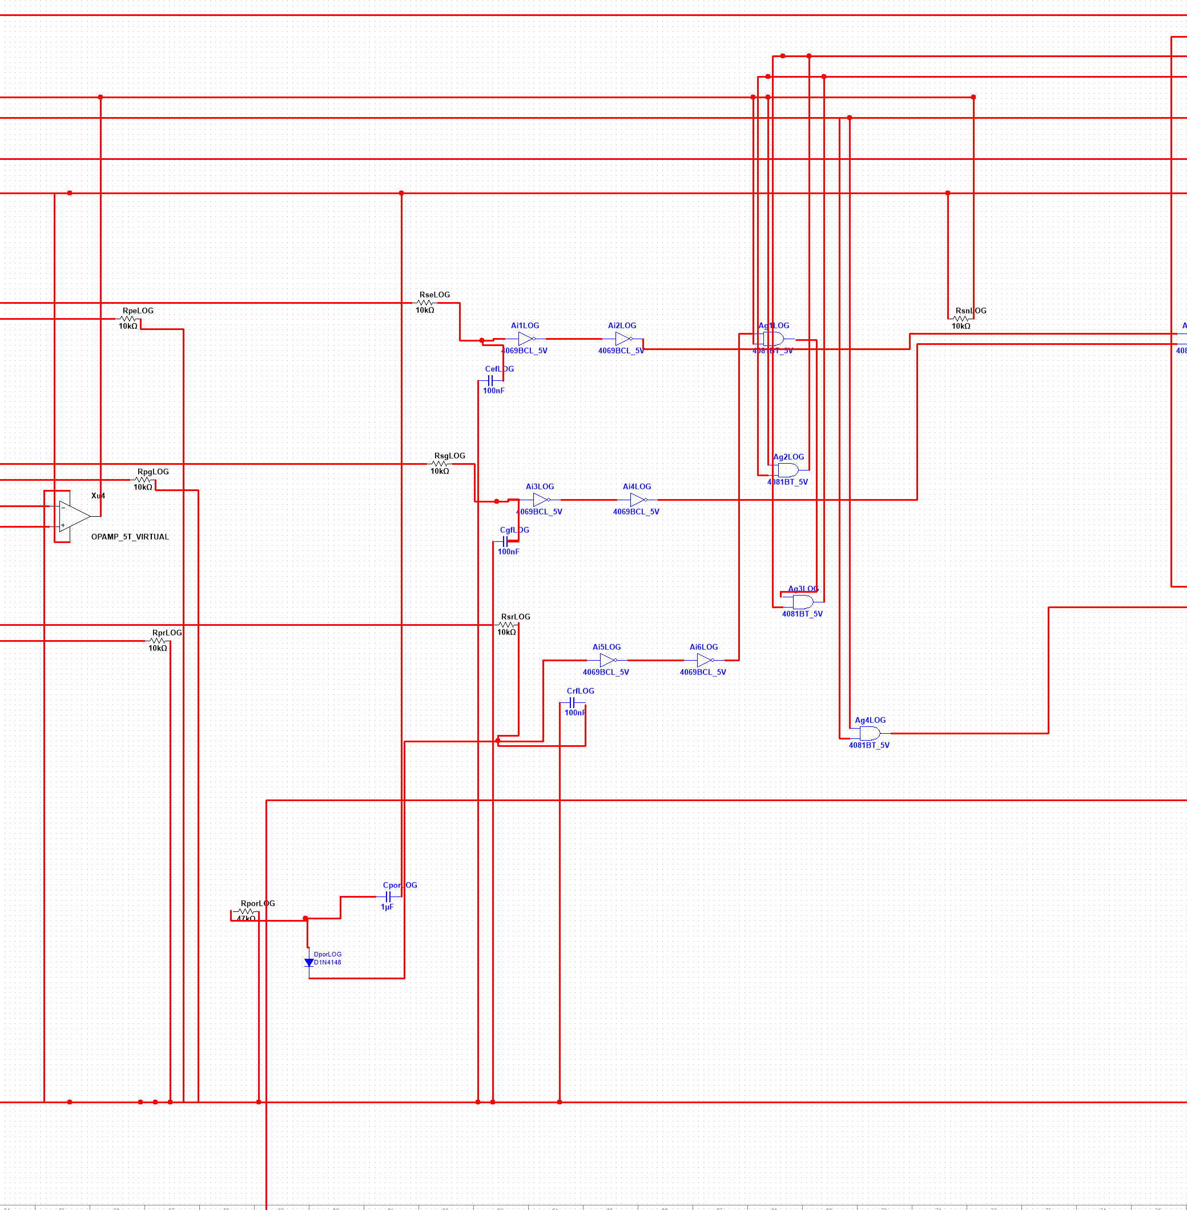
4_Documentacion/img/v6_LOGICA.png
