DiegoCrUz-afk/Proyecto_Final_Electronica_UNIS/4_Documentacion/img/v6_PWM_GEN.png

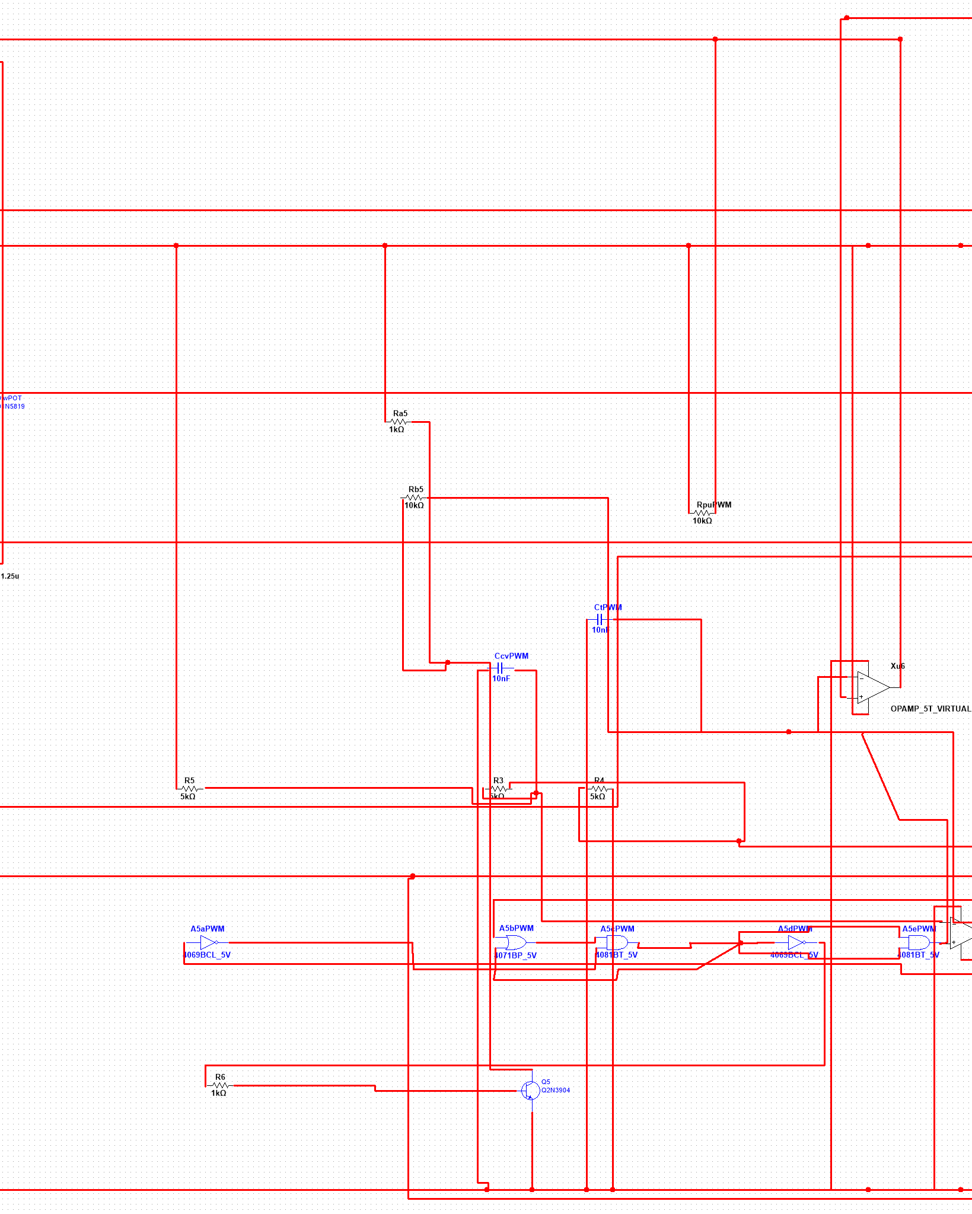
4_Documentacion/img/v6_PWM_GEN.png
