DiegoCrUz-afk/Proyecto_Final_Electronica_UNIS/4_Documentacion/img/v6_REFVEL.png

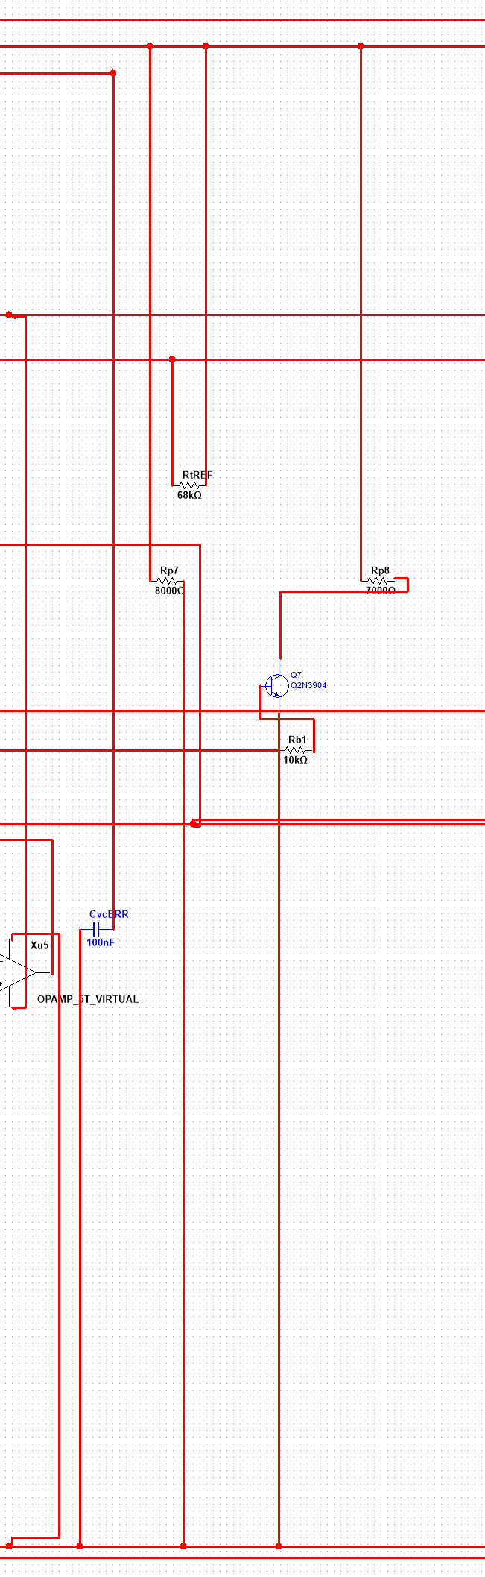
4_Documentacion/img/v6_REFVEL.png
