DiegoCrUz-afk/Proyecto_Final_Electronica_UNIS/4_Documentacion/img/v6_SENSOR_IR.png

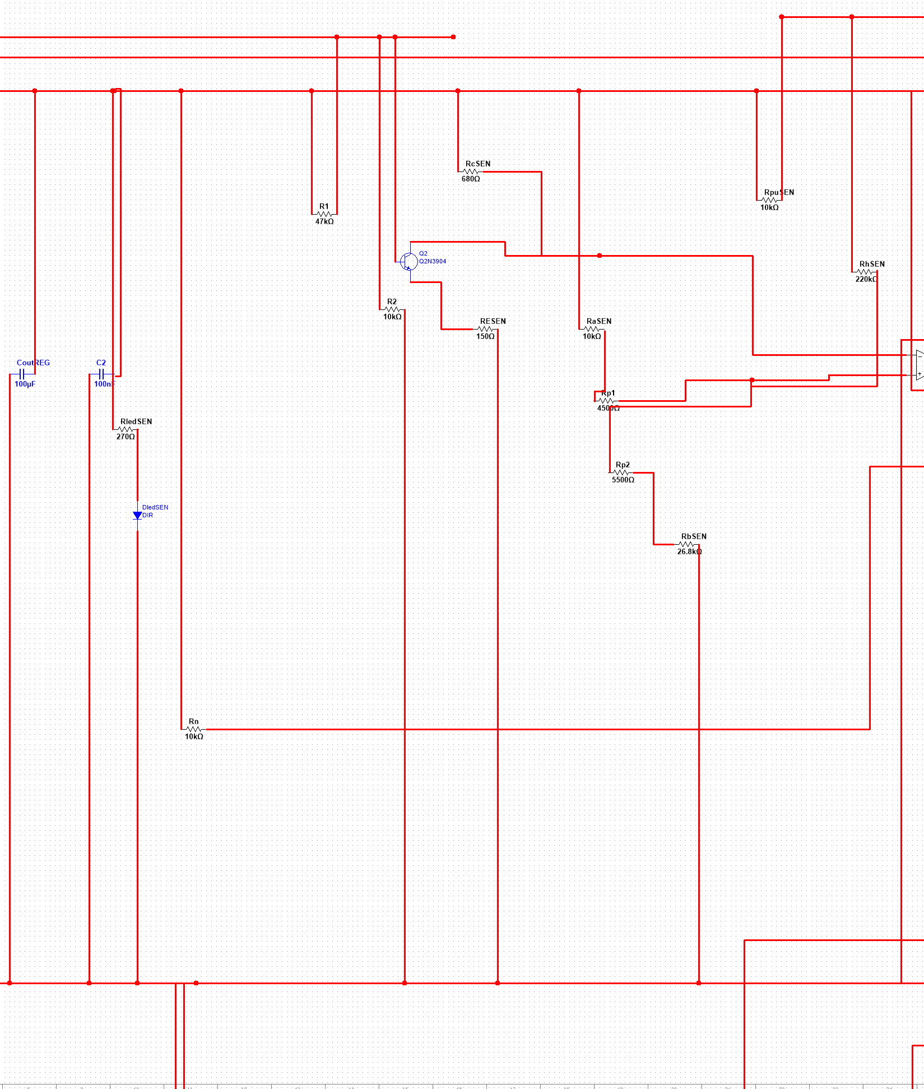
4_Documentacion/img/v6_SENSOR_IR.png
