DiegoCrUz-afk/Proyecto_Final_Electronica_UNIS/4_Documentacion/img_revision/Compuertas_74HC08_marcadas/zoom_74HC08_rojo.png

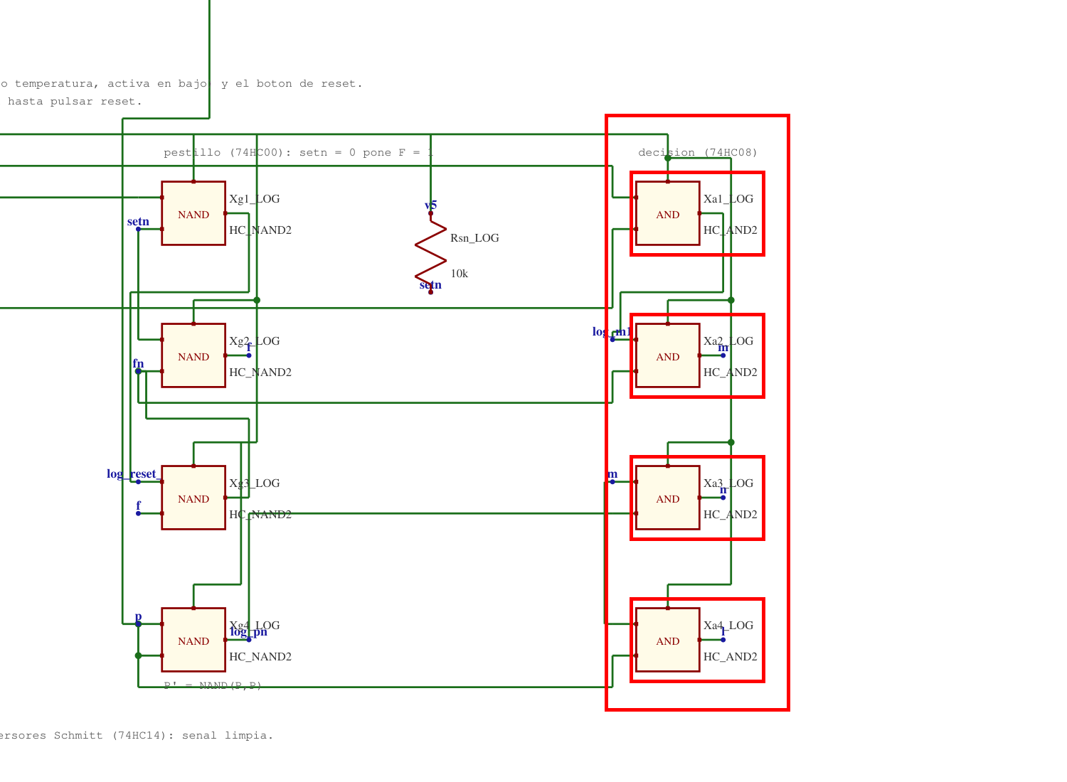
4_Documentacion/img_revision/Compuertas_74HC08_marcadas/zoom_74HC08_rojo.png
