DiegoCrUz-afk/Proyecto_Final_Electronica_UNIS/9_Entregables_profesor/02_Simulacion_y_capturas/Multisim/SISTEMA_SOLO_CIRCUITO_multisim.png

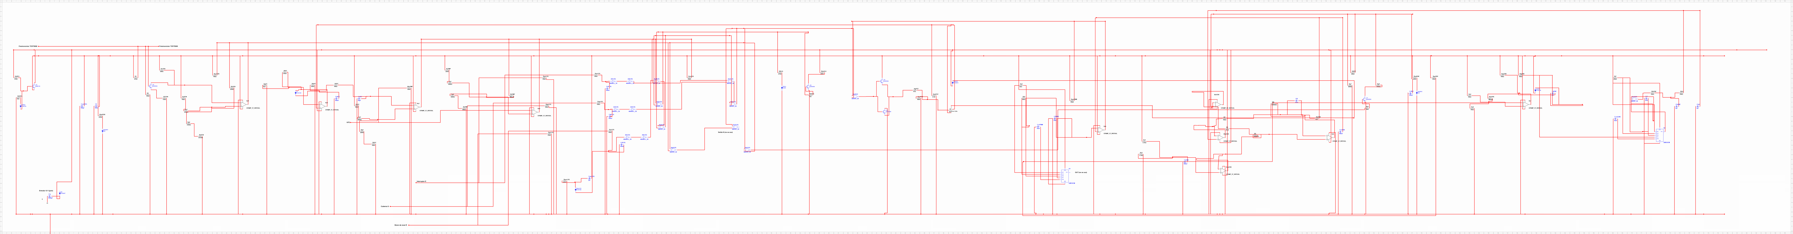
9_Entregables_profesor/02_Simulacion_y_capturas/Multisim/SISTEMA_SOLO_CIRCUITO_multisim.png
