DiegoCrUz-afk/Proyecto_Final_Electronica_UNIS/Entrega_Final/5_Fotos_y_Video/Modelo_3D/3D_placa_C.png

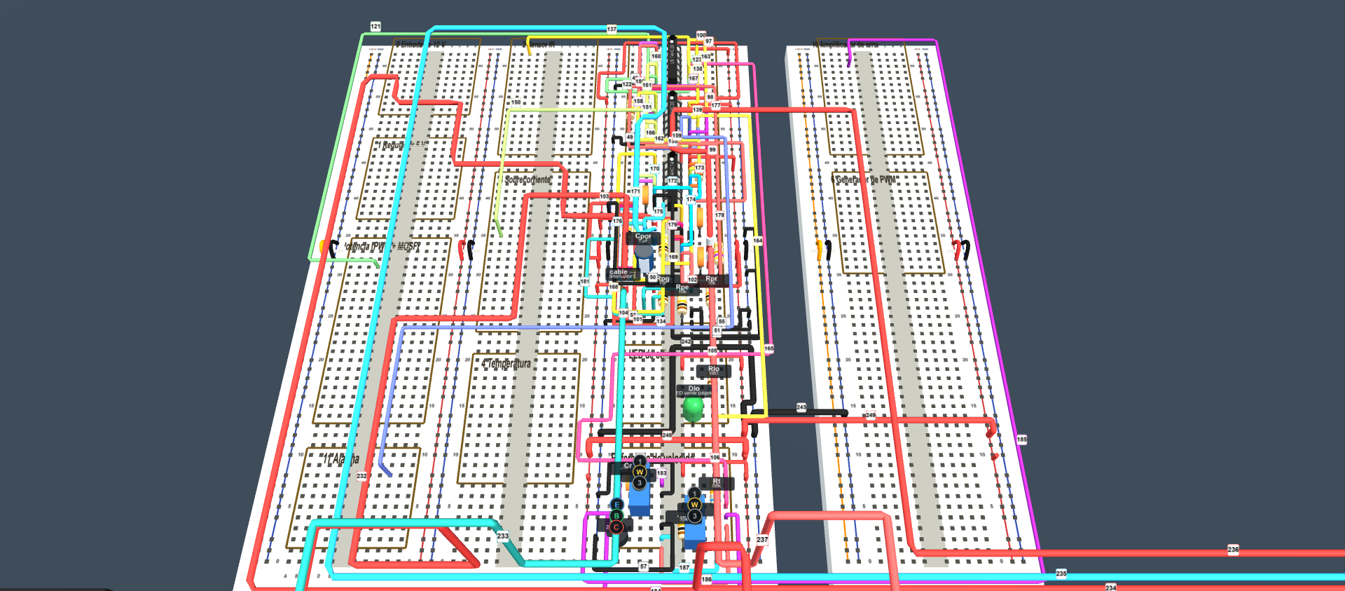
Entrega_Final/5_Fotos_y_Video/Modelo_3D/3D_placa_C.png
