DiegoCrUz-afk/Proyecto_Final_Electronica_UNIS/Reduccion2/1_LTspice/capturas/esq_BLOQUE_LOGICA.png

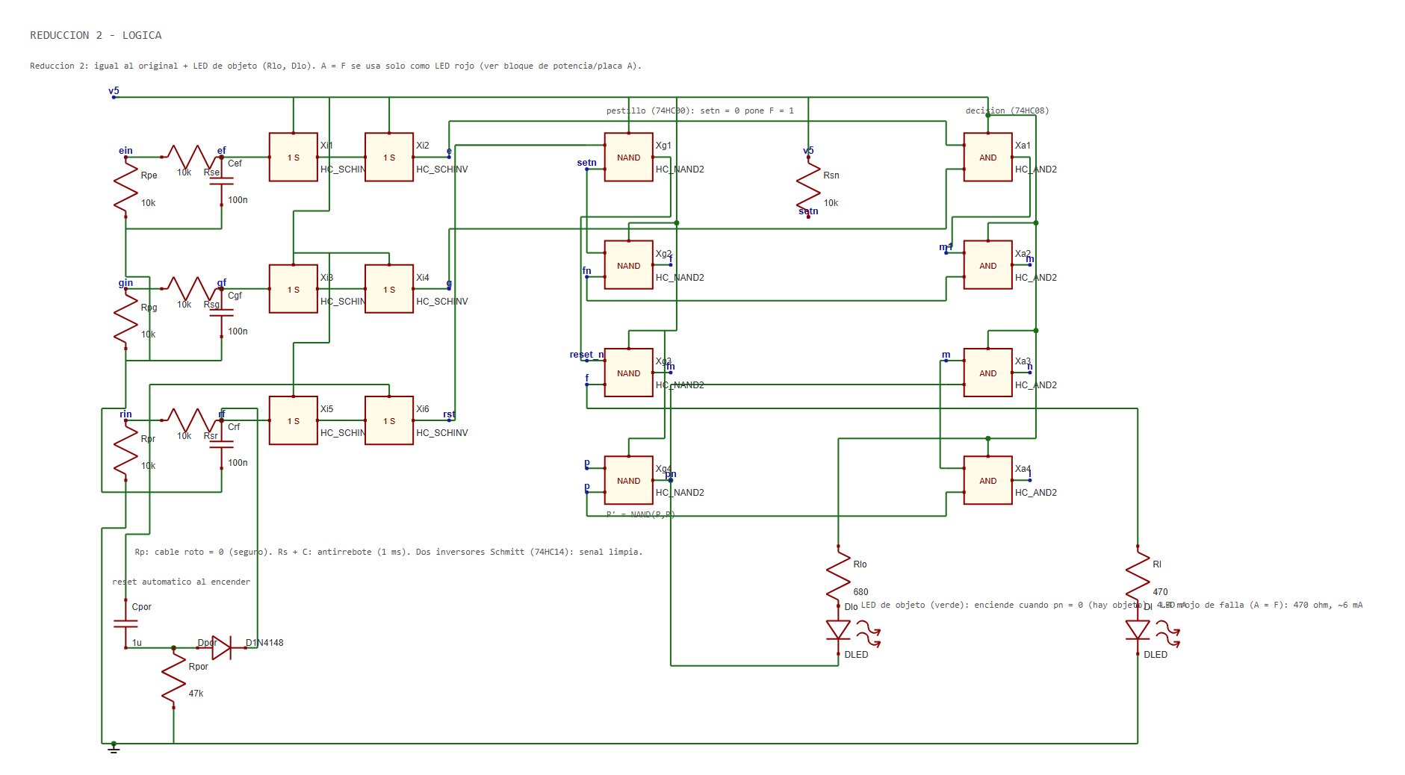
Reduccion2/1_LTspice/capturas/esq_BLOQUE_LOGICA.png
