DiegoCrUz-afk/Proyecto_Final_Electronica_UNIS/Reduccion2/1_LTspice/capturas/esq_BLOQUE_SENSOR_IR.png

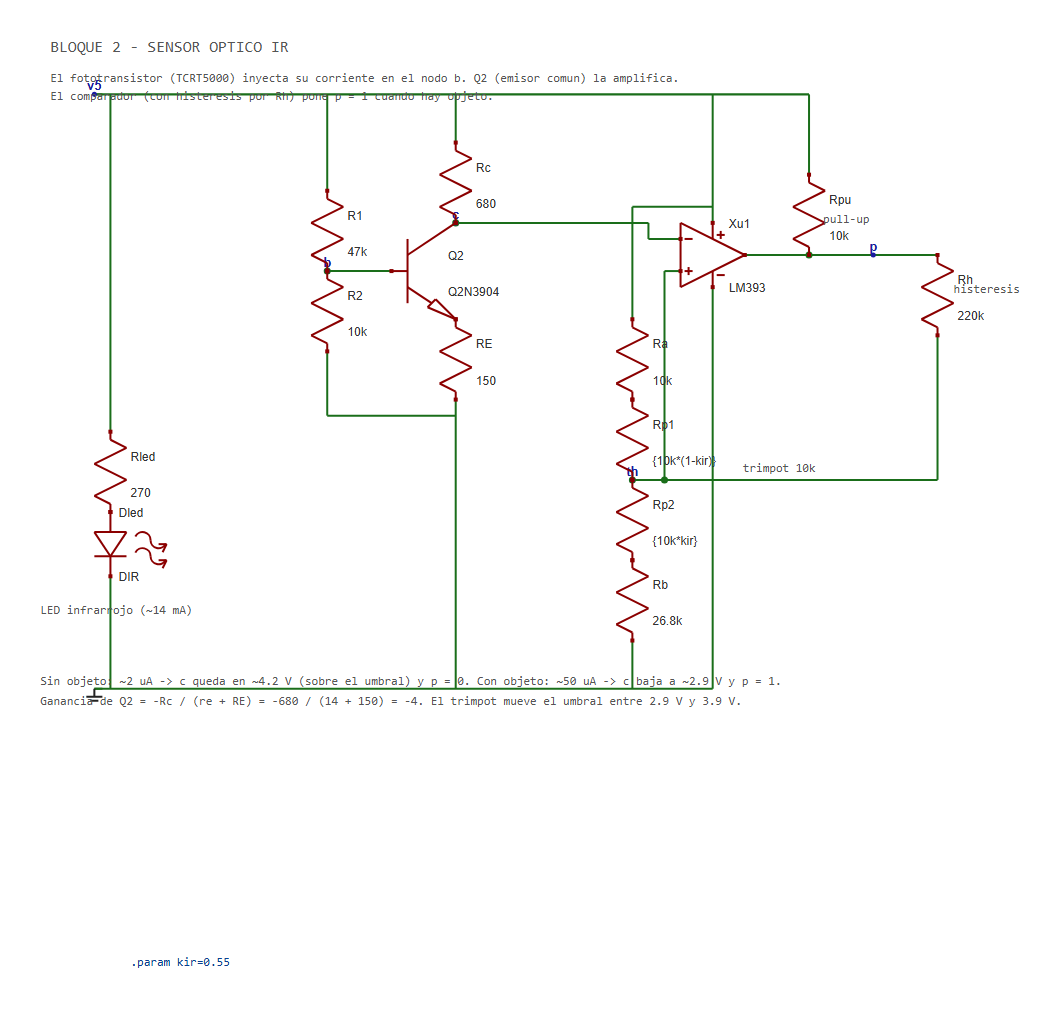
Reduccion2/1_LTspice/capturas/esq_BLOQUE_SENSOR_IR.png
