DiegoCrUz-afk/Proyecto_Final_Electronica_UNIS/Reduccion2/1_LTspice/capturas/logica.png

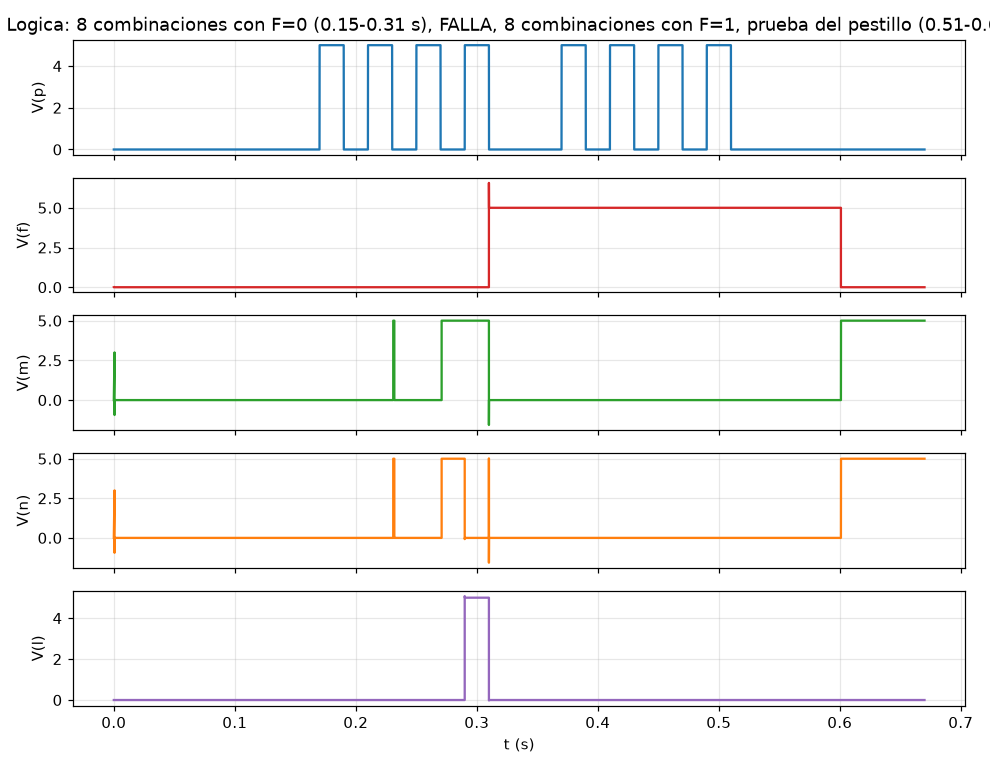
Reduccion2/1_LTspice/capturas/logica.png
