DiegoCrUz-afk/Proyecto_Final_Electronica_UNIS/Reduccion2/1_LTspice/capturas/potencia_Rs15_bjt.png

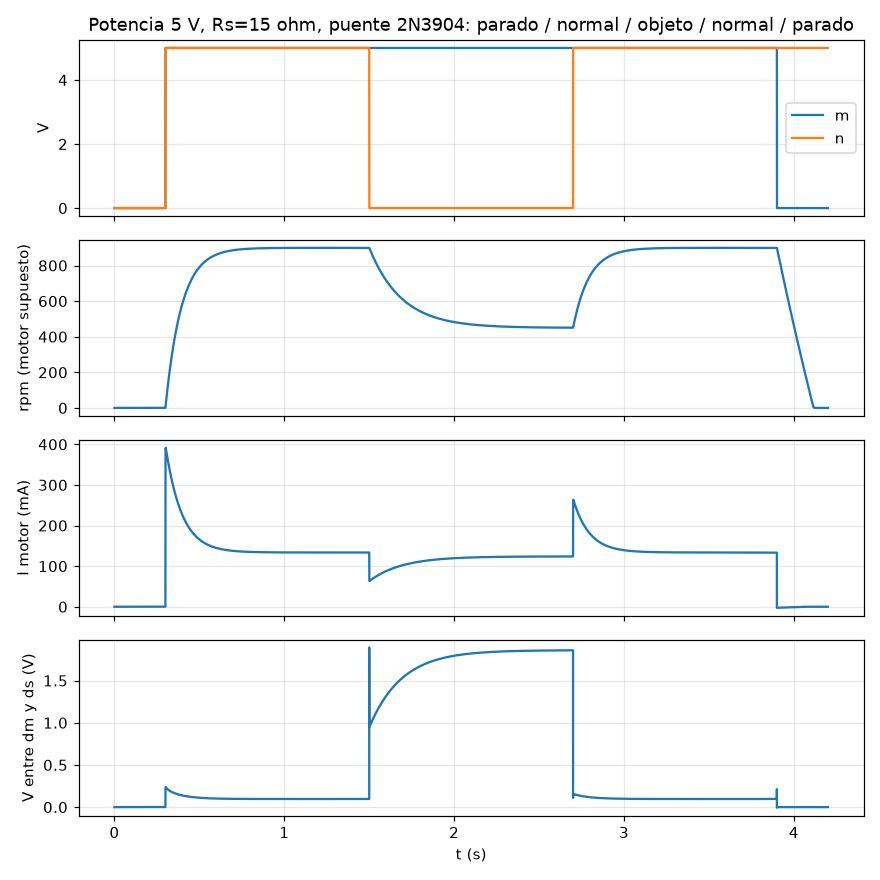
Reduccion2/1_LTspice/capturas/potencia_Rs15_bjt.png
