DiegoCrUz-afk/Proyecto_Final_Electronica_UNIS/Reduccion2/1_LTspice/capturas/sensor_ir.png

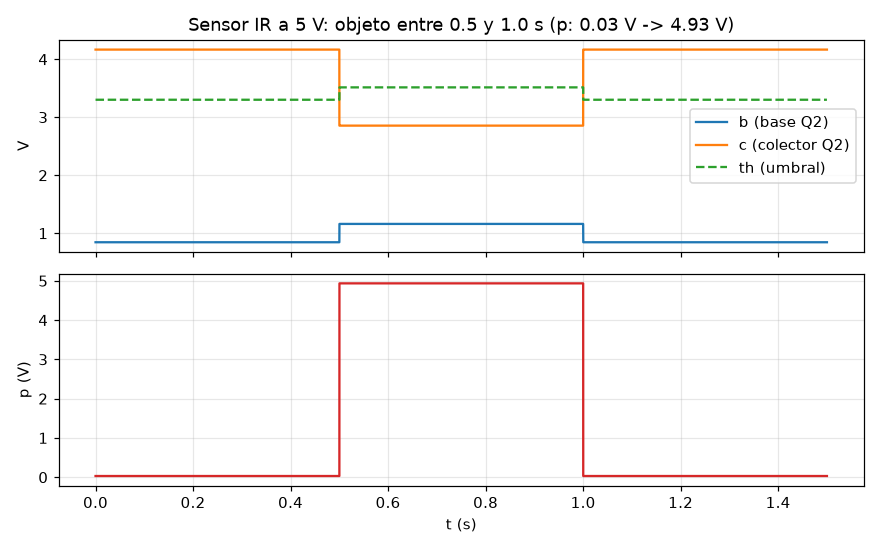
Reduccion2/1_LTspice/capturas/sensor_ir.png
