DiegoCrUz-afk/Proyecto_Final_Electronica_UNIS/Reduccion2/1_LTspice/capturas/SISTEMA_COMPLETO_R2_esquematico.png

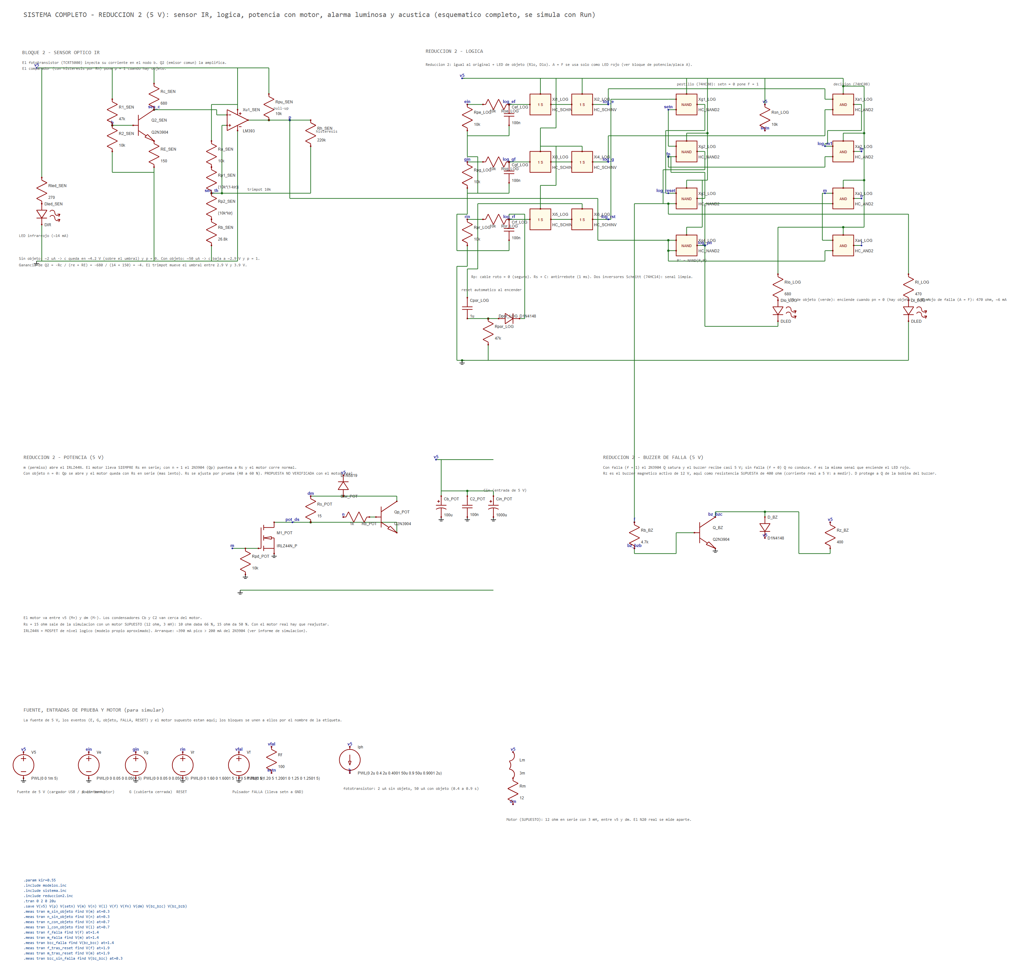
Reduccion2/1_LTspice/capturas/SISTEMA_COMPLETO_R2_esquematico.png
