DiegoCrUz-afk/Proyecto_Final_Electronica_UNIS/Entrega_Final/4_BOM_y_datasheets/BOM.md

# Lista de materiales (BOM) y costo

Precios de La Electrónica (Guatemala, laelectronica.com.gt), consultados el 12/11/2026. Pueden cambiar.

## Diseño 1

| Cant. | Pieza | Origen | Precio unit. (Q) | Subtotal (Q) | Nota |
|---|---|---|---|---|---|
| 5 | LM393P (comparador) | Comprado | 4.00 | 20.00 | uno por protoboard |
| 1 | LM358P (amplificador operacional) | Comprado | 5.00 | 5.00 |  |
| 1 | LM324N (amplificador operacional) | Comprado | 6.00 | 6.00 |  |
| 2 | NE555N (temporizador) | Comprado | 3.00 | 6.00 |  |
| 1 | 74HC00N (NAND) | Comprado | 5.00 | 5.00 |  |
| 3 | 74HC08N (AND) | Comprado | 5.00 | 15.00 |  |
| 1 | 74HC14N (Schmitt) | Comprado | 6.00 | 6.00 |  |
| 8 | Base para IC de 8 pines | Comprado | 1.00 | 8.00 | LM393 ×5, LM358, NE555 ×2 |
| 6 | Base para IC de 16 pines (para los chips de 14 patas) | Comprado | 1.50 | 9.00 | LM324 y 74HC ×5 |
| 4 | Transistor 2N3904 | Comprado | 1.00 | 4.00 |  |
| 1 | Transistor 2N3906 | Comprado | 1.00 | 1.00 |  |
| 1 | Transistor BD139 (paso del regulador) | Comprado | 2.75 | 2.75 |  |
| 1 | MOSFET IRFZ44N (potencia) | Comprado | 10.00 | 10.00 | MOSFET de potencia que vende la tienda |
| 1 | Diodo rectificador 1N4007 | Comprado | 0.75 | 0.75 |  |
| 3 | Diodo 1N4148 | Comprado | 0.75 | 2.25 |  |
| 1 | Diodo Schottky 1N5819 | Comprado | 1.00 | 1.00 |  |
| 1 | Diodo Zener 5.6 V 1 W (equivale al 1N4734A) | Comprado | 1.50 | 1.50 |  |
| 1 | LED rojo 5 mm (alarma) | Comprado | 1.00 | 1.00 |  |
| 1 | Sensor óptico TCRT5000L | Comprado | 6.00 | 6.00 |  |
| 1 | Optointerruptor infrarrojo (encoder) | Comprado | 7.00 | 7.00 |  |
| 1 | Termistor NTC 10 kΩ | Comprado | 4.50 | 4.50 |  |
| 5 | Trimpot 3296W 10 kΩ | Comprado | 4.00 | 20.00 |  |
| 1 | Trimpot 3296W 100 Ω | Comprado | 4.00 | 4.00 |  |
| 1 | Buzzer magnético activo 12 V, 85 dB | Comprado | 5.00 | 5.00 |  |
| 54 | Resistencias 1/4 W (10k×27, 1k×4, 1M×2, 22k×2, 47k×2, 68k×2, 100k×2 y 13 valores de una pieza cada uno) | Comprado | 0.75 | 40.50 |  |
| 1 | Resistencia shunt 0.5 Ω, 5 W | Comprado | 4.00 | 4.00 |  |
| 8 | Cerámico monolítico 100 nF | Comprado | 0.75 | 6.00 |  |
| 5 | Cerámico 10 nF | Comprado | 0.50 | 2.50 |  |
| 1 | Cerámico 1 nF | Comprado | 0.50 | 0.50 |  |
| 3 | Electrolítico 1 µF 63 V | Comprado | 1.00 | 3.00 |  |
| 1 | Electrolítico 10 µF 25 V | Comprado | 1.00 | 1.00 |  |
| 1 | Electrolítico 100 µF 25 V | Comprado | 1.25 | 1.25 |  |
| 1 | Electrolítico 1000 µF 16 V | Comprado | 2.75 | 2.75 |  |
| 1 | Jack DC para panel 5.5 × 2.5 mm | Comprado | 4.00 | 4.00 | entrada de 12 V |
| 1 | Interruptor toggle SPDT 6 A (E, marcha) | Comprado | 6.00 | 6.00 |  |
| 1 | Pulsador NA de 4 pines 6×6×15 mm (RESET) | Comprado | 1.00 | 1.00 |  |
| 1 | Final de carrera SPDT mediano (cubierta) | Comprado | 12.00 | 12.00 |  |
| 2 | Disipador de 24×15×10 mm para TO-220 | Comprado | 4.00 | 8.00 | BD139 e IRFZ44N |
| 1 | Portafusible aéreo para fusible 5×20 mm | Comprado | 5.00 | 5.00 |  |
| 1 | Motorreductor N20 12 V, 200 RPM | Comprado | 55.00 | 55.00 |  |
| 1 | Adaptador AC-DC 12 V 2 A | Comprado | 59.00 | 59.00 |  |
| 5 | Protoboard de 1 galleta (830 puntos) | Comprado | 39.00 | 195.00 | el montaje usa 5 protoboards |
| 1 | Jumpers 20 cm macho-macho, paquete de 10 (referencia de cables) | Comprado | 8.00 | 8.00 | el montaje usa 252 cables |
|  | COSTO TOTAL del proyecto (con precios de referencia) |  |  | 565.25 |  |
|  | LO QUE SE COMPRÓ (origen Comprado) |  |  | 565.25 |  |

**Costo total del proyecto: Q565.25. Lo que se compró: Q565.25.** Precios de La Electrónica. Las piezas de inventario llevan precio de referencia (o — si no se encontró).
