DiegoCrUz-afk/Proyecto_Final_Electronica_UNIS/5_Compras_y_Pruebas/Materiales_por_protoboard.pdf

# Materiales por protoboard

Segun el 3D (Protoboards_3D_miniestacion.html). Solo piezas montadas en protoboard; las marcadas "Externo" van con cables. No incluye motor, encoder, jack, fusible ni cables de protoboard.

## Protoboard A (23 piezas)

Pieza | Valor / modelo | Cant.
Buzzer | buzzer activo 12 V | 1
Capacitor | 100 nF | 1
Capacitor electrolitico | 100 µF | 1
Capacitor electrolitico | 1000 µF | 1
Circuito integrado | 74HC08 | 1
Diodo | 1N4007 | 1
Diodo | 1N5819 | 1
Externo (con cables) | Entrada 12 V (jack) | 1
Externo (con cables) | Motor 12 V | 1
LED | LED rojo | 1
MOSFET | IRFZ44N | 1
Resistencia | 10k | 1
Resistencia | 1k | 1
Resistencia | 47 | 1
Resistencia | 470 | 1
Resistencia | 510 | 1
Resistencia de potencia (shunt) | 0.5 ohm 5 W | 1
Transistor | 2N3904 | 2
Transistor | 2N3906 | 1
Transistor | BD139 | 1
Trimpot | 100 ohm | 1
Zener | Zener 1N4734A 5.6 V | 1

## Protoboard B (32 piezas)

Pieza | Valor / modelo | Cant.
Capacitor | 100 nF | 1
Capacitor electrolitico | 10 µF | 1
Circuito integrado | LM358 | 1
Circuito integrado | LM393 | 3
Diodo | 1N4148 | 1
Externo (con cables) | NTC 10 k | 1
Resistencia | 10k | 7
Resistencia | 150 | 1
Resistencia | 1M | 1

Pieza | Valor / modelo | Cant.
Resistencia | 1k | 1
Resistencia | 220k | 1
Resistencia | 22k | 2
Resistencia | 26.8k | 1
Resistencia | 270 | 1
Resistencia | 47k | 1
Resistencia | 6.8k | 1
Resistencia | 680 | 1
Resistencia | 68k | 1
Sensor IR | TCRT5000 | 1
Transistor | 2N3904 | 1
Trimpot | 10k | 3

## Protoboard C (25 piezas)

Pieza | Valor / modelo | Cant.
Capacitor | 1 µF | 1
Capacitor | 100 nF | 4
Circuito integrado | 74HC00 | 1
Circuito integrado | 74HC08 | 1
Circuito integrado | 74HC14 | 1
Diodo | 1N4148 | 1
Externo (con cables) | Interruptor E | 1
Externo (con cables) | Micro-switch cubierta | 1
Externo (con cables) | Pulsador reset | 1
Resistencia | 10k | 8
Resistencia | 47k | 1
Resistencia | 68k | 1
Transistor | 2N3904 | 1
Trimpot | 10k | 2

## Protoboard D (20 piezas)

Pieza | Valor / modelo | Cant.
Capacitor | 1 nF | 1
Capacitor | 1 µF | 2
Capacitor | 10 nF | 2
Circuito integrado | 74HC08 | 1
Circuito integrado | LM393 | 1
Circuito integrado | NE555 | 1
Diodo | 1N4148 | 1

Optointerruptor | optointerruptor ranurado | 1
Resistencia | 10k | 7
Resistencia | 1M | 1
Resistencia | 20k | 1
Resistencia | 220 | 1

## Protoboard E (18 piezas)

Pieza | Valor / modelo | Cant.
Capacitor | 10 nF | 3
Capacitor | 100 nF | 2
Circuito integrado | LM324 | 1
Circuito integrado | LM393 | 1
Circuito integrado | NE555 | 1
Resistencia | 100k | 2
Resistencia | 10k | 4
Resistencia | 1k | 2
Resistencia | 4.7k | 1
Resistencia | 5.1k | 1

## Total (118 piezas)

Pieza | Valor / modelo | Cant.
Buzzer | buzzer activo 12 V | 1
Capacitor | 1 nF | 1
Capacitor | 1 µF | 3
Capacitor | 10 nF | 5
Capacitor | 100 nF | 8
Capacitor electrolitico | 10 µF | 1
Capacitor electrolitico | 100 µF | 1
Capacitor electrolitico | 1000 µF | 1
Circuito integrado | 74HC00 | 1
Circuito integrado | 74HC08 | 3
Circuito integrado | 74HC14 | 1
Circuito integrado | LM324 | 1
Circuito integrado | LM358 | 1
Circuito integrado | LM393 | 5
Circuito integrado | NE555 | 2
Diodo | 1N4007 | 1
Diodo | 1N4148 | 3
Diodo | 1N5819 | 1

Externo (con cables) | Entrada 12 V (jack) | 1
Externo (con cables) | Interruptor E | 1
Externo (con cables) | Micro-switch cubierta | 1
Externo (con cables) | Motor 12 V | 1
Externo (con cables) | NTC 10 k | 1
Externo (con cables) | Pulsador reset | 1
LED | LED rojo | 1
MOSFET | IRFZ44N | 1
Optointerruptor | optointerruptor ranurado | 1
Resistencia | 100k | 2
Resistencia | 10k | 27
Resistencia | 150 | 1
Resistencia | 1M | 2
Resistencia | 1k | 4
Resistencia | 20k | 1
Resistencia | 220 | 1
Resistencia | 220k | 1
Resistencia | 22k | 2
Resistencia | 26.8k | 1
Resistencia | 270 | 1
Resistencia | 4.7k | 1
Resistencia | 47 | 1
Resistencia | 470 | 1
Resistencia | 47k | 2
Resistencia | 5.1k | 1
Resistencia | 510 | 1
Resistencia | 6.8k | 1
Resistencia | 680 | 1
Resistencia | 68k | 2
Resistencia de potencia (shunt) | 0.5 ohm 5 W | 1
Sensor IR | TCRT5000 | 1
Transistor | 2N3904 | 4
Transistor | 2N3906 | 1
Transistor | BD139 | 1
Trimpot | 100 ohm | 1
Trimpot | 10k | 5
Zener | Zener 1N4734A 5.6 V | 1
