DiegoCrUz-afk/Proyecto_Final_Electronica_UNIS/3_archivos_tecnicos/pcb/salida/PLACA_A_componentes.png

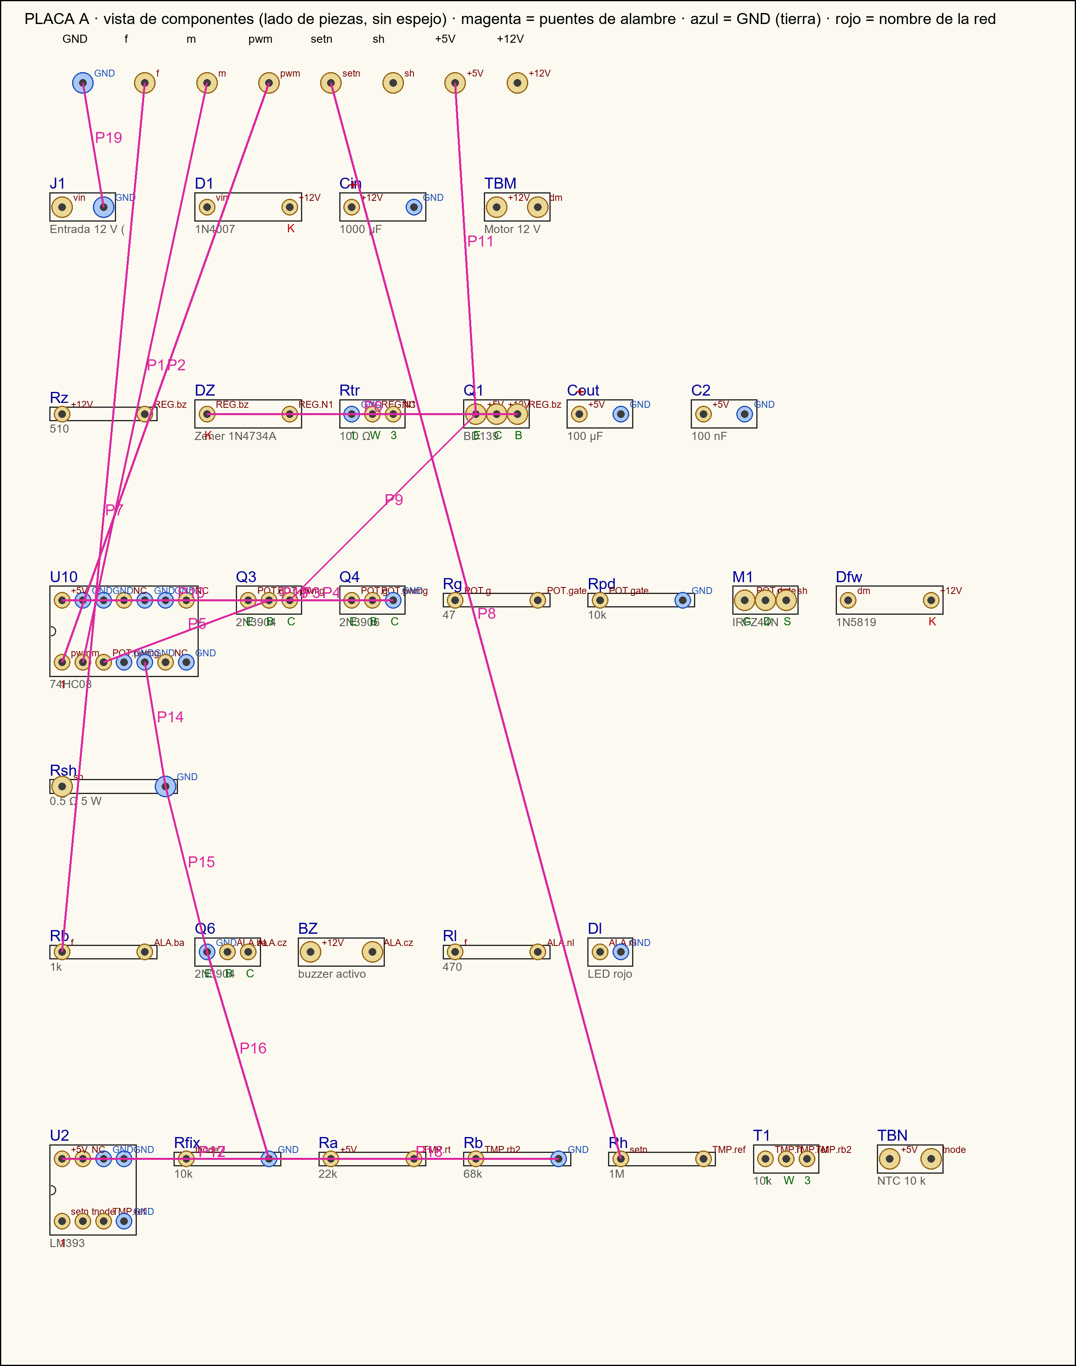
3_archivos_tecnicos/pcb/salida/PLACA_A_componentes.png
