DiegoCrUz-afk/Proyecto_Final_Electronica_UNIS/8_Maqueta_corte_laser/anterior_primera_version/Piezas_corte_laser/disco_encoder_R2010.dxf

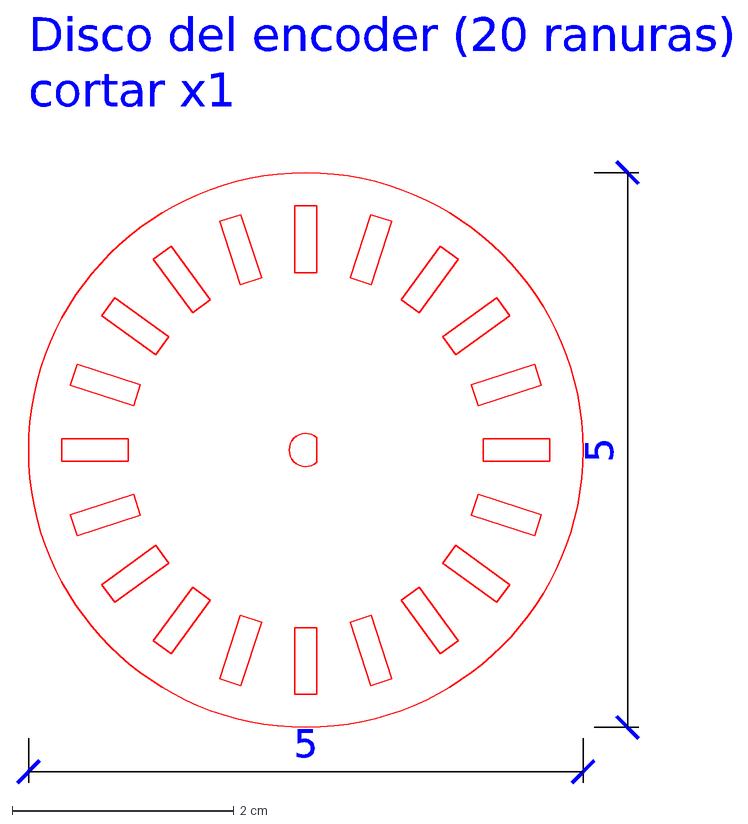
[picture p83: CAD file, 2026-11-11]
8_Maqueta_corte_laser/anterior_primera_version/Piezas_corte_laser/disco_encoder_R2010.dxf
5
Disco del encoder (20 ranuras)
cortar x1
