DiegoCrUz-afk/Proyecto_Final_Electronica_UNIS/8_Maqueta_corte_laser/DXF_respaldo/tapa_tubo_40mm.dxf

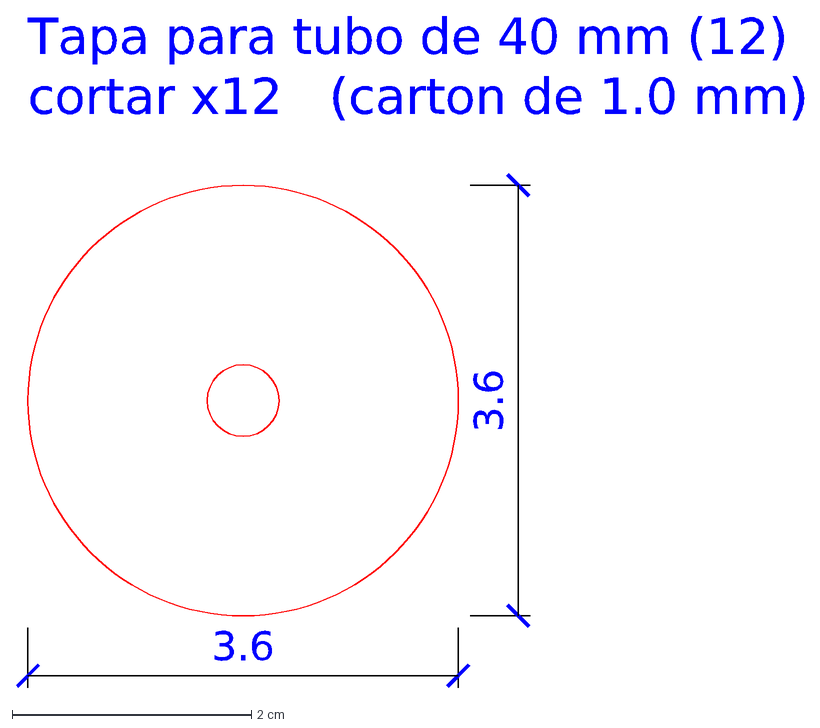
[picture p84: CAD file, 2026-11-11]
8_Maqueta_corte_laser/DXF_respaldo/tapa_tubo_40mm.dxf
3.6
Tapa para tubo de 40 mm (12)
cortar x12 (carton de 1.0 mm)
