DiegoCrUz-afk/Proyecto_Final_Electronica_UNIS/9_Entregables_profesor/03_Montaje_y_maqueta/Maqueta_corte_laser/DXF_respaldo/calza_opto.dxf

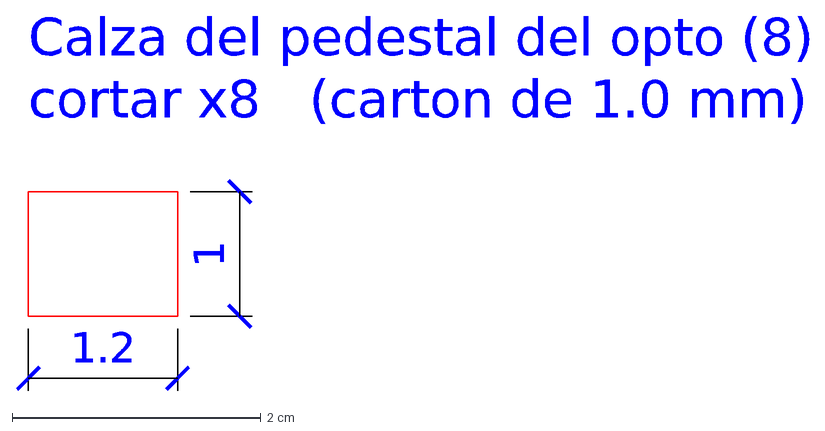
[picture p85: CAD file, 2026-11-11]
9_Entregables_profesor/03_Montaje_y_maqueta/Maqueta_corte_laser/DXF_respaldo/calza_opto.dxf
1.2
1
Calza del pedestal del opto (8)
cortar x8 (carton de 1.0 mm)
