DiegoCrUz-afk/Proyecto_Final_Electronica_UNIS/8_Maqueta_corte_laser/anterior_primera_version/Piezas_corte_laser/disco_rodillo_R2010.dxf

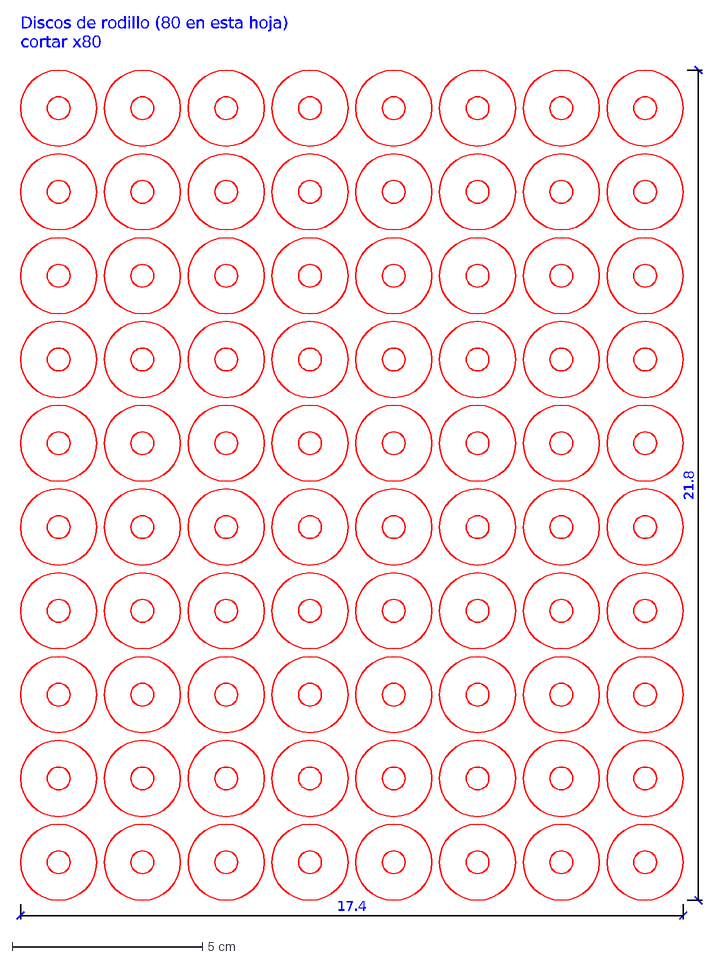
[picture p86: CAD file, 2026-11-11]
8_Maqueta_corte_laser/anterior_primera_version/Piezas_corte_laser/disco_rodillo_R2010.dxf
17.4
21.8
Discos de rodillo (80 en esta hoja)
cortar x80
