DiegoCrUz-afk/Proyecto_Final_Electronica_UNIS/8_Maqueta_corte_laser/DXF_respaldo/rueda.dxf

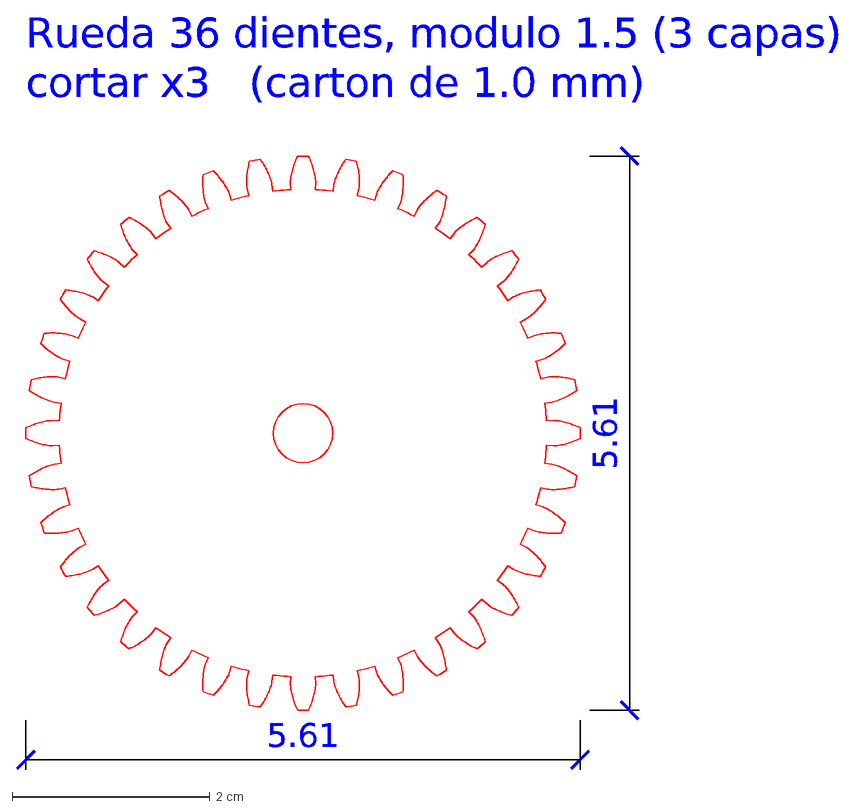
[picture p87: CAD file, 2026-11-11]
8_Maqueta_corte_laser/DXF_respaldo/rueda.dxf
5.61
Rueda 36 dientes, modulo 1.5 (3 capas)
cortar x3 (carton de 1.0 mm)
