DiegoCrUz-afk/Proyecto_Final_Electronica_UNIS/9_Entregables_profesor/03_Montaje_y_maqueta/Maqueta_corte_laser/DXF_respaldo/disco_encoder.dxf

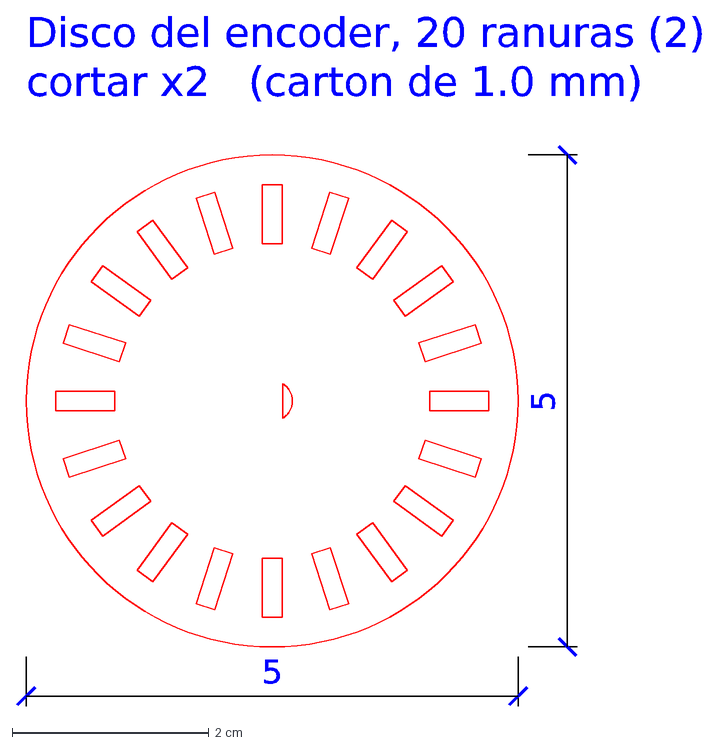
[picture p88: CAD file, 2026-11-11]
9_Entregables_profesor/03_Montaje_y_maqueta/Maqueta_corte_laser/DXF_respaldo/disco_encoder.dxf
5
Disco del encoder, 20 ranuras (2)
cortar x2 (carton de 1.0 mm)
