DiegoCrUz-afk/Proyecto_Final_Electronica_UNIS/8_Maqueta_corte_laser/anterior_primera_version/Piezas_corte_laser/soporte_motor_R2010.dxf

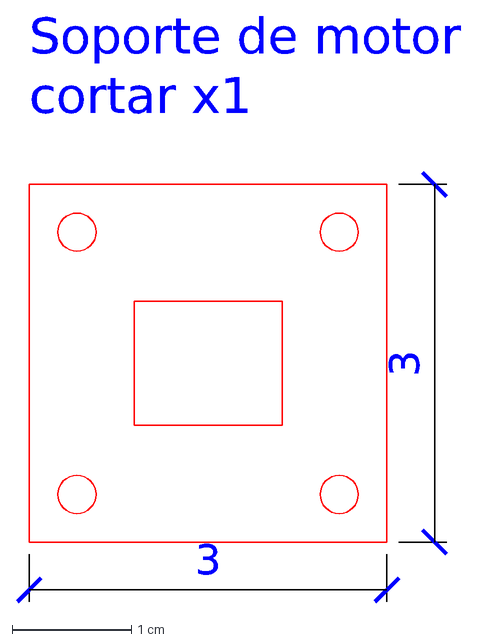
[picture p89: CAD file, 2026-11-11]
8_Maqueta_corte_laser/anterior_primera_version/Piezas_corte_laser/soporte_motor_R2010.dxf
3
Soporte de motor
cortar x1
