DiegoCrUz-afk/Proyecto_Final_Electronica_UNIS/8_Maqueta_corte_laser/DXF_respaldo/lateral.dxf

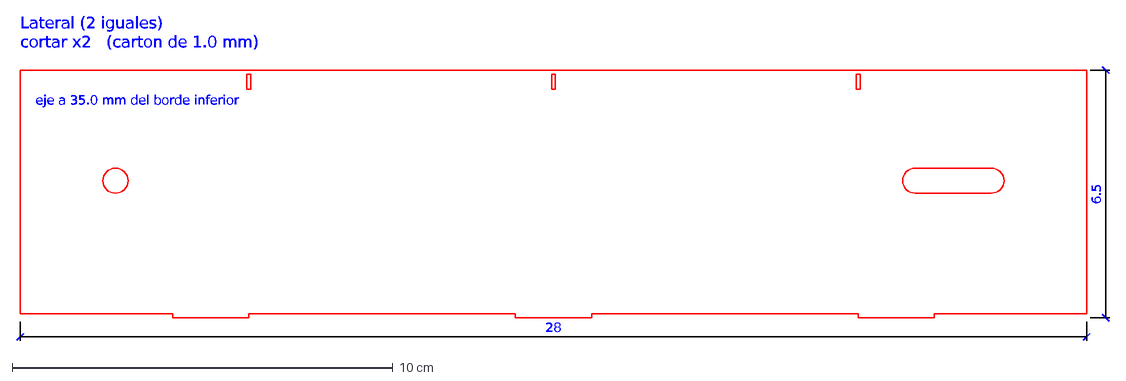
[picture p90: CAD file, 2026-11-11]
8_Maqueta_corte_laser/DXF_respaldo/lateral.dxf
eje a 35.0 mm del borde inferior
28
6.5
Lateral (2 iguales)
cortar x2 (carton de 1.0 mm)
