DiegoCrUz-afk/Proyecto_Final_Electronica_UNIS/9_Entregables_profesor/03_Montaje_y_maqueta/Maqueta_corte_laser/DXF_respaldo/pared_motor.dxf

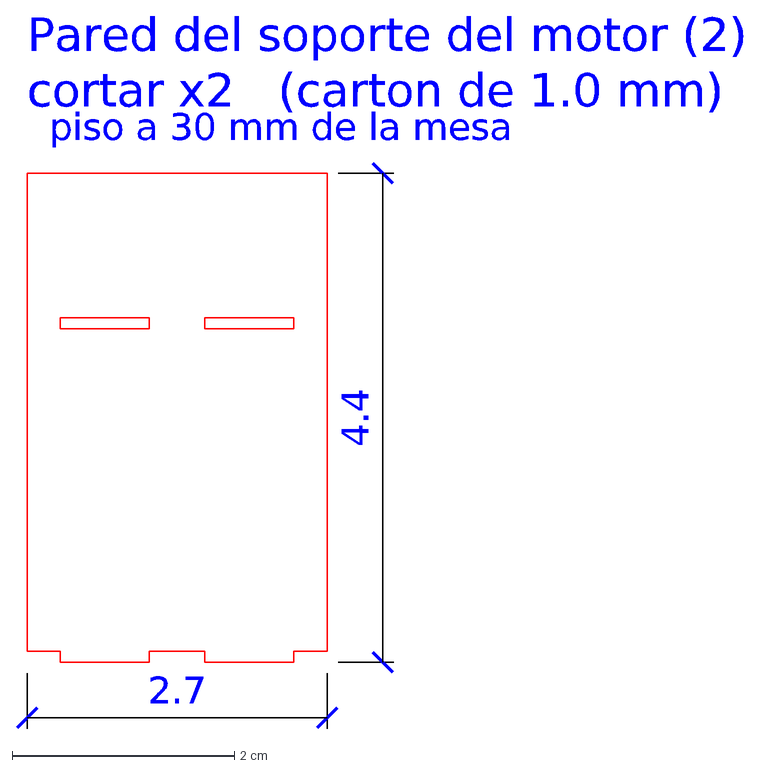
[picture p91: CAD file, 2026-11-11]
9_Entregables_profesor/03_Montaje_y_maqueta/Maqueta_corte_laser/DXF_respaldo/pared_motor.dxf
piso a 30 mm de la mesa
2.7
4.4
Pared del soporte del motor (2)
cortar x2 (carton de 1.0 mm)
