DiegoCrUz-afk/Proyecto_Final_Electronica_UNIS/8_Maqueta_corte_laser/anterior_primera_version/Piezas_corte_laser/pinon_R2010.dxf

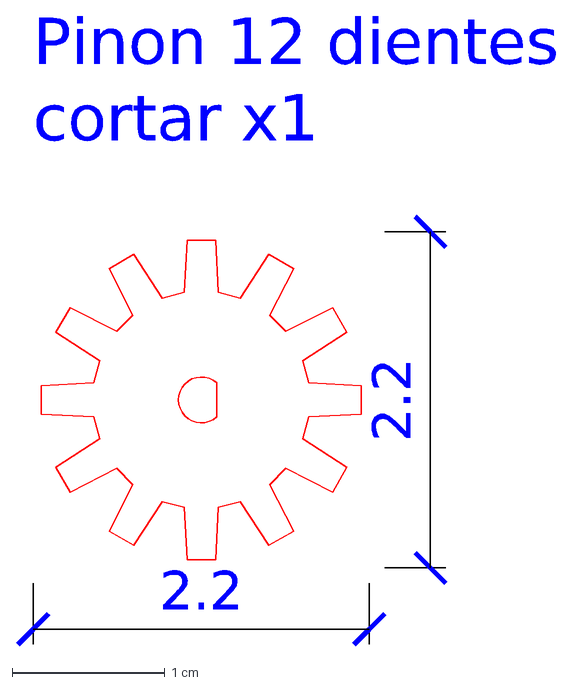
[picture p92: CAD file, 2026-11-11]
8_Maqueta_corte_laser/anterior_primera_version/Piezas_corte_laser/pinon_R2010.dxf
2.2
Pinon 12 dientes
cortar x1
