DiegoCrUz-afk/Proyecto_Final_Electronica_UNIS/8_Maqueta_corte_laser/DXF_respaldo/pinon.dxf

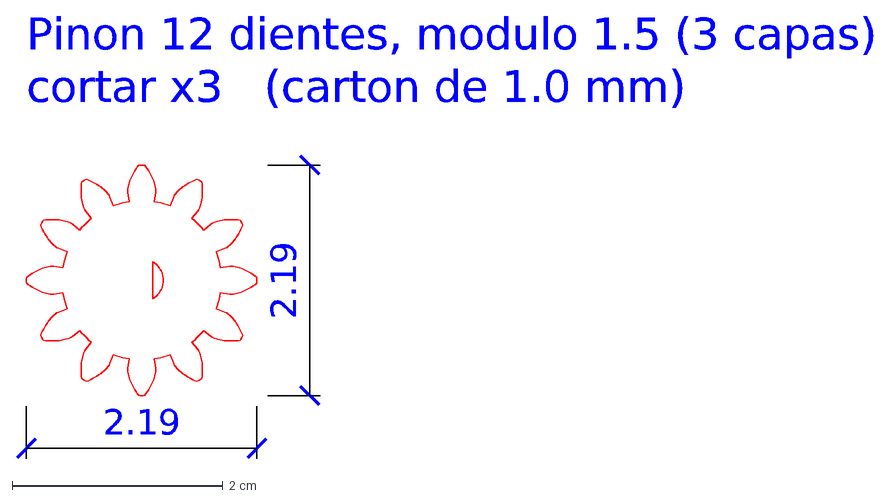
[picture p93: CAD file, 2026-11-11]
8_Maqueta_corte_laser/DXF_respaldo/pinon.dxf
2.19
Pinon 12 dientes, modulo 1.5 (3 capas)
cortar x3 (carton de 1.0 mm)
