DiegoCrUz-afk/Proyecto_Final_Electronica_UNIS/9_Entregables_profesor/03_Montaje_y_maqueta/Maqueta_corte_laser/DXF_respaldo/placa_base.dxf

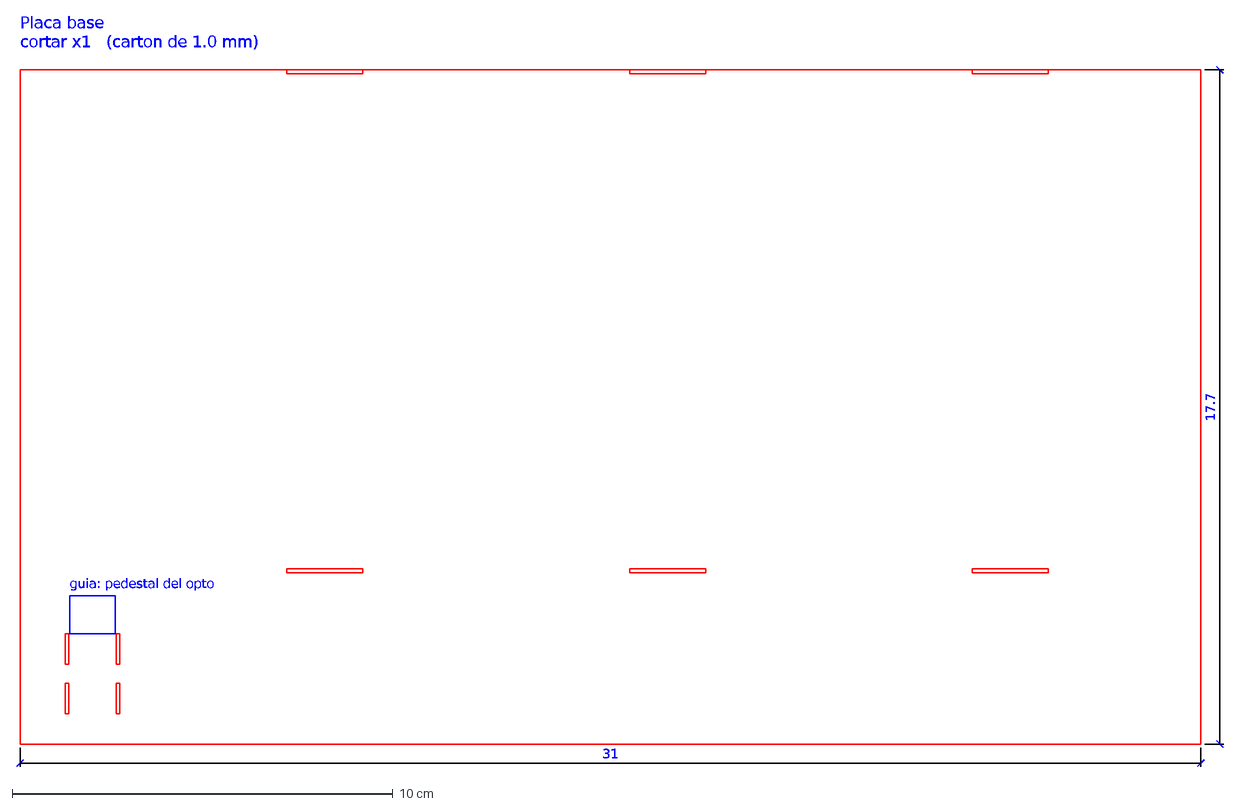
[picture p94: CAD file, 2026-11-11]
9_Entregables_profesor/03_Montaje_y_maqueta/Maqueta_corte_laser/DXF_respaldo/placa_base.dxf
guia: pedestal del opto
31
17.7
Placa base
cortar x1 (carton de 1.0 mm)
