DiegoCrUz-afk/Proyecto_Final_Electronica_UNIS/8_Maqueta_corte_laser/anterior_primera_version/Piezas_corte_laser/soporte_opto_R2010.dxf

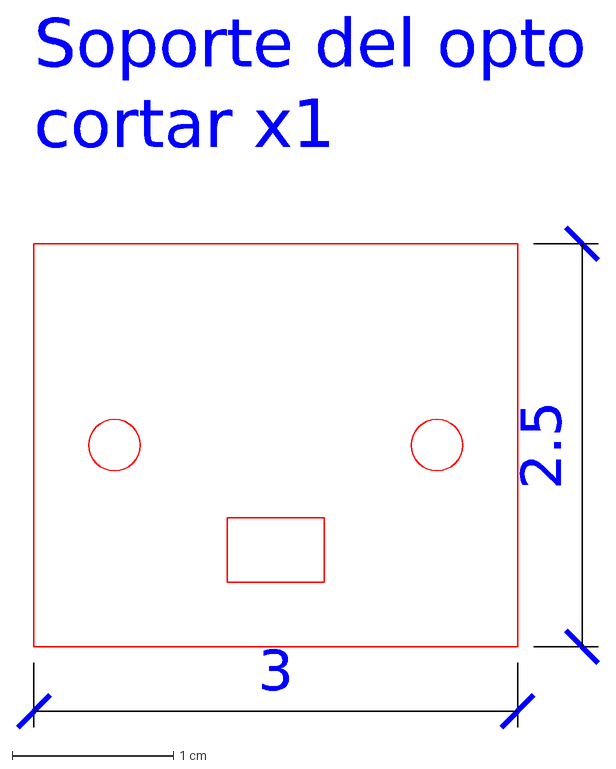
[picture p95: CAD file, 2026-11-11]
8_Maqueta_corte_laser/anterior_primera_version/Piezas_corte_laser/soporte_opto_R2010.dxf
3
2.5
Soporte del opto
cortar x1
