DiegoCrUz-afk/Proyecto_Final_Electronica_UNIS/8_Maqueta_corte_laser/DXF_respaldo/piso_motor.dxf

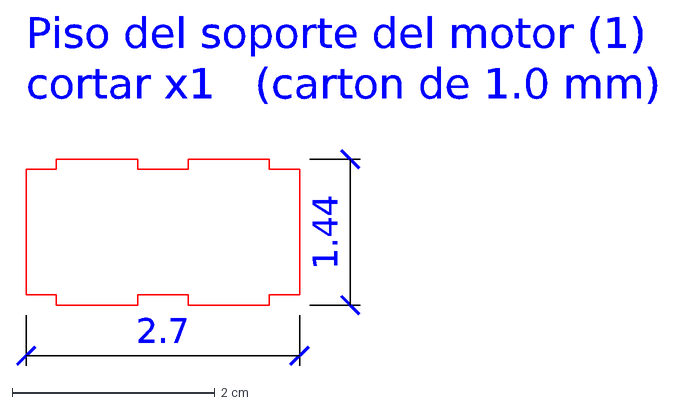
[picture p96: CAD file, 2026-11-11]
8_Maqueta_corte_laser/DXF_respaldo/piso_motor.dxf
2.7
1.44
Piso del soporte del motor (1)
cortar x1 (carton de 1.0 mm)
