DiegoCrUz-afk/Proyecto_Final_Electronica_UNIS/9_Entregables_profesor/03_Montaje_y_maqueta/Maqueta_corte_laser/DXF_respaldo/travesano.dxf

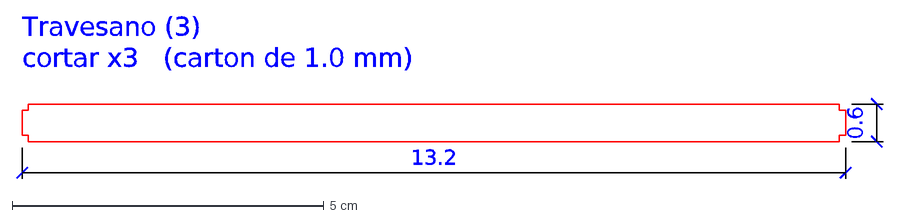
[picture p97: CAD file, 2026-11-11]
9_Entregables_profesor/03_Montaje_y_maqueta/Maqueta_corte_laser/DXF_respaldo/travesano.dxf
13.2
0.6
Travesano (3)
cortar x3 (carton de 1.0 mm)
