DiegoCrUz-afk/Proyecto_Final_Electronica_UNIS/8_Maqueta_corte_laser/anterior_primera_version/Piezas_corte_laser/lateral_R2010.dxf

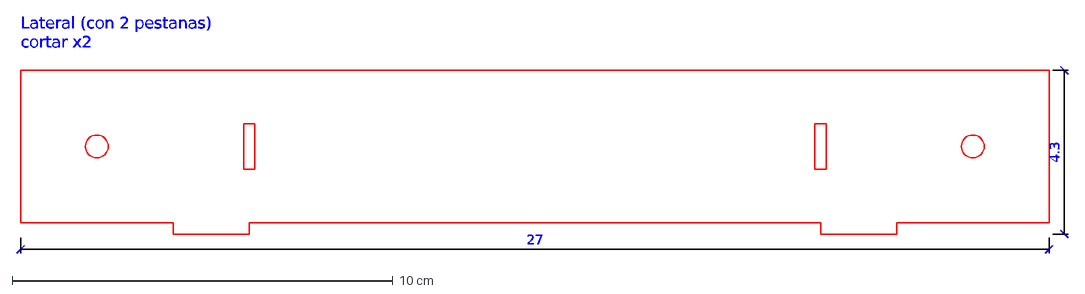
[picture p98: CAD file, 2026-11-11]
8_Maqueta_corte_laser/anterior_primera_version/Piezas_corte_laser/lateral_R2010.dxf
27
4.3
Lateral (con 2 pestanas)
cortar x2
