DiegoCrUz-afk/Proyecto_Final_Electronica_UNIS/9_Entregables_profesor/03_Montaje_y_maqueta/Maqueta_corte_laser/DXF_respaldo/tapa_tubo_20mm.dxf

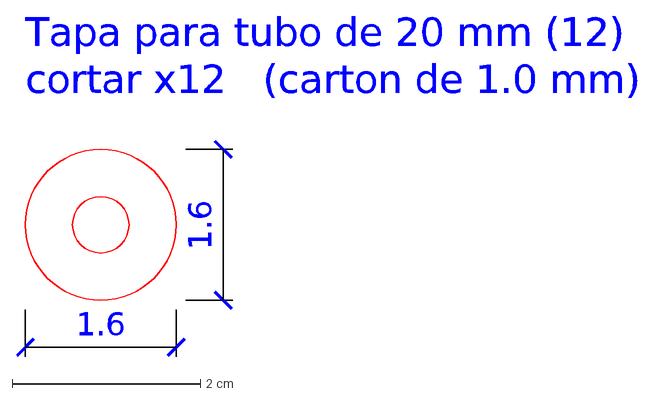
[picture p99: CAD file, 2026-11-11]
9_Entregables_profesor/03_Montaje_y_maqueta/Maqueta_corte_laser/DXF_respaldo/tapa_tubo_20mm.dxf
1.6
Tapa para tubo de 20 mm (12)
cortar x12 (carton de 1.0 mm)
