DiegoCrUz-afk/Proyecto_Final_Electronica_UNIS/8_Maqueta_corte_laser/anterior_primera_version/Piezas_corte_laser/rueda_R2010.dxf

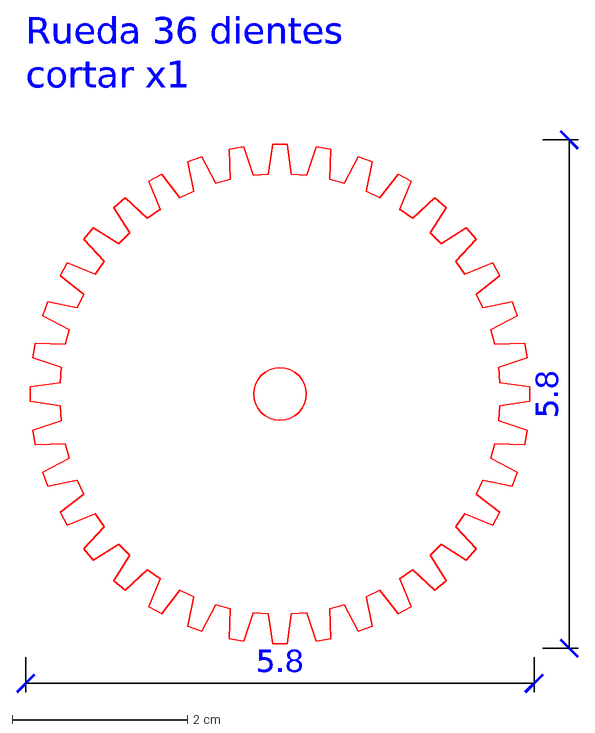
[picture p100: CAD file, 2026-11-11]
8_Maqueta_corte_laser/anterior_primera_version/Piezas_corte_laser/rueda_R2010.dxf
5.8
Rueda 36 dientes
cortar x1
