DiegoCrUz-afk/Proyecto_Final_Electronica_UNIS/9_Entregables_profesor/03_Montaje_y_maqueta/Maqueta_corte_laser/DXF_respaldo/tapa_tubo_30mm.dxf

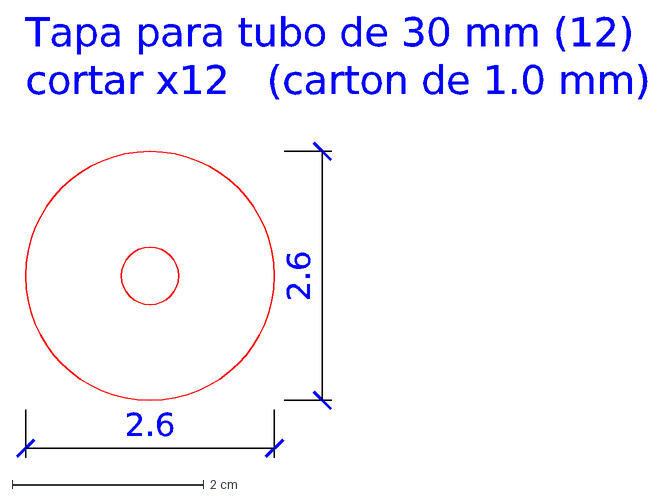
[picture p102: CAD file, 2026-11-11]
9_Entregables_profesor/03_Montaje_y_maqueta/Maqueta_corte_laser/DXF_respaldo/tapa_tubo_30mm.dxf
2.6
Tapa para tubo de 30 mm (12)
cortar x12 (carton de 1.0 mm)
