DiegoCrUz-afk/Proyecto_Final_Electronica_UNIS/(list of files, cad)

Other CAD files:
8_Maqueta_corte_laser/anterior_primera_version/Piezas_corte_laser_DWG/disco_rodillo.dwg
8_Maqueta_corte_laser/tapa_tubo_40mm.dwg
9_Entregables_profesor/03_Montaje_y_maqueta/Maqueta_corte_laser/tapa_tubo_30mm.dwg
8_Maqueta_corte_laser/anterior_primera_version/Piezas_corte_laser_DWG/placa_base.dwg
8_Maqueta_corte_laser/placa_base.dwg
9_Entregables_profesor/03_Montaje_y_maqueta/Maqueta_corte_laser/tapa_tubo_20mm.dwg
8_Maqueta_corte_laser/anterior_primera_version/Piezas_corte_laser_DWG/separador.dwg
8_Maqueta_corte_laser/calza_opto.dwg
9_Entregables_profesor/03_Montaje_y_maqueta/Maqueta_corte_laser/TODAS_las_piezas.dwg
8_Maqueta_corte_laser/anterior_primera_version/Piezas_corte_laser_DWG/soporte_opto.dwg
8_Maqueta_corte_laser/pared_motor.dwg
9_Entregables_profesor/03_Montaje_y_maqueta/Maqueta_corte_laser/rueda.dwg
8_Maqueta_corte_laser/anterior_primera_version/Piezas_corte_laser_DWG/pinon.dwg
8_Maqueta_corte_laser/travesano.dwg
9_Entregables_profesor/03_Montaje_y_maqueta/Maqueta_corte_laser/piso_motor.dwg
8_Maqueta_corte_laser/anterior_primera_version/Piezas_corte_laser_DWG/disco_encoder.dwg
9_Entregables_profesor/03_Montaje_y_maqueta/Maqueta_corte_laser/pinon.dwg
8_Maqueta_corte_laser/anterior_primera_version/Piezas_corte_laser_DWG/rueda.dwg
9_Entregables_profesor/03_Montaje_y_maqueta/Maqueta_corte_laser/DXF_respaldo/TODAS_las_piezas.dxf
9_Entregables_profesor/03_Montaje_y_maqueta/Maqueta_corte_laser/lateral.dwg
8_Maqueta_corte_laser/anterior_primera_version/Piezas_corte_laser_DWG/TODAS_las_piezas.dwg
9_Entregables_profesor/03_Montaje_y_maqueta/Maqueta_corte_laser/disco_encoder.dwg
8_Maqueta_corte_laser/anterior_primera_version/Piezas_corte_laser_DWG/lateral.dwg
8_Maqueta_corte_laser/anterior_primera_version/Piezas_corte_laser/TODAS_las_piezas_R2010.dxf
8_Maqueta_corte_laser/anterior_primera_version/Piezas_corte_laser_DWG/soporte_motor.dwg
