DiegoCrUz-afk/Proyecto_Final_Electronica_UNIS/9_Entregables_profesor/03_Montaje_y_maqueta/Lista_conexiones_v3.html

# Lista de conexiones · pata por pata

Miniestación industrial automatizada. Generada del mismo dato que el 3D v3, así que ambos dicen lo mismo. El agujero se lee placa-letra+fila (ejemplo B-F42 = placa B, columna F, fila 42; las filas se cuentan desde abajo como en el tablero). Una pata que dice "va a GND" se une con un cable corto al riel de tierra.

## Rieles y puentes entre placas (PRO'S KIT BX-4135 + protoboards sueltas)

Las placas A, B y C son las 3 protoboards de la BX-4135: el par de rieles de en medio lo comparten dos protoboards vecinas. Cada riel viene cortado a la mitad (filas 0 a 32 y 33 a 62): los dos puentes del medio los unen.

Placa | Riel izquierdo + | Riel izquierdo − | Riel derecho + | Riel derecho −
A (BX-4135) | +12 V | GND (0 V) | +5 V | GND (0 V)
B (BX-4135) | +5 V | GND (0 V) | +5 V | GND (0 V)
C (BX-4135) | +5 V | GND (0 V) | +5 V | GND (0 V)
D (suelta) | +12 V | GND (0 V) | +5 V | GND (0 V)
E (suelta) | +12 V | GND (0 V) | +5 V | GND (0 V)

### Puentes entre rieles

Cable | Red | De | A
[240] | GND (0 V) | A-riel GND izq fila 10 | A-riel GND der fila 8
[241] | GND (0 V) | A-riel GND der fila 10 | B-riel GND der fila 10
[242] | GND (0 V) | B-riel GND der fila 12 | C-riel GND der fila 12
[243] | GND (0 V) | C-riel GND der fila 14 | D-riel GND izq fila 14
[244] | GND (0 V) | D-riel GND izq fila 16 | D-riel GND der fila 16
[245] | GND (0 V) | D-riel GND der fila 18 | E-riel GND izq fila 18
[246] | GND (0 V) | E-riel GND izq fila 20 | E-riel GND der fila 20
[247] | +5 V | A-riel +5 V der fila 8 | B-riel +5 V der fila 8
[248] | +5 V | B-riel +5 V der fila 10 | C-riel +5 V der fila 10
[249] | +5 V | C-riel +5 V der fila 12 | D-riel +5 V der fila 12
[250] | +5 V | D-riel +5 V der fila 14 | E-riel +5 V der fila 14
[251] | +12 V | A-riel +12 V izq fila 11 | D-riel +12 V izq fila 8
[252] | +12 V | D-riel +12 V izq fila 10 | E-riel +12 V izq fila 10

## 0 Entrada de 12 V · placa A

### Componentes de este bloque (sepáralos antes de armar)

Cant. | Componente | Nombres
1 | 1000 µF | Cin
1 | 1N4007 | D1
1 | Entrada 12 V (jack) | J1
1 | Motor 12 V | TBM

### Conexiones pata por pata

Pieza | Pata | Nombre | Agujero | Va a
Cin 1000 µF | + | | A-H62 | +12 V (riel)
| - | | A-H59 | GND (0 V) (riel)
D1 1N4007 | A | | A-J56 | vin → J1 pata +12V
| K | | A-J52 | +12 V (riel)
J1 Entrada 12 V (jack) | +12V | | A-F56 | vin → D1 pata A
| GND | | A-F54 | GND (0 V) (riel)
TBM Motor 12 V | M+ | | A-G57 | +12 V (riel)
| M- | | A-G55 | dm → M1 pata D, Dfw pata A

### Cables de este bloque

Cable | Red | De | A
[1] | +12 V | A-J62 | A-riel +12 V izq fila 62
[2] | +12 V | A-F57 | A-riel +12 V izq fila 56
[3] | +12 V | A-F52 | A-riel +12 V izq fila 52
[10] | GND (0 V) | A-J59 | A-riel GND izq fila 59
[11] | GND (0 V) | A-H54 | A-riel GND izq fila 54
[82] | dm | A-H55 | A-J23
[83] | dm | A-I55 | A-F19
[228] | vin | A-F56 | dispositivo FUENTE · +12V
[229] | GND (0 V) | A-F54 | dispositivo FUENTE · GND
[230] | +12 V | A-G57 | dispositivo MOTOR · M+
[231] | dm | A-G55 | dispositivo MOTOR · M-

### Pruebas al terminar el bloque

Medida | Esperado | Si no coincide
12 V que entran por el jack V DC | 12 V (fuente externa) | 0 V: el jack no está conectado o la fuente está apagada.
vm: 12 V después del diodo D1 (cátodo) V DC | 11.1 a 11.3 V con el motor andando (simulación: mínimo 11.13 V) | 0 V: D1 puesto al revés. La banda (cátodo K) debe ir hacia vm, el riel de 12 V, y el otro extremo (ánodo A) hacia el jack; si la banda mira al jack, está al revés. 12 V sin caída con el motor parado es normal.

## 1 Regulador 5 V · placa A

### Componentes de este bloque (sepáralos antes de armar)

Cant. | Componente | Nombres
1 | 100 nF | C2
1 | 100 µF | Cout
1 | Zener 1N4734A 5.6 V | DZ
1 | BD139 | Q1
1 | 100 Ω | Rtr
1 | 510 | Rz

### Conexiones pata por pata

Pieza | Pata | Nombre | Agujero | Va a
C2 100 nF | 1 | | A-B45 | +5 V (riel)
| 2 | | A-B43 | GND (0 V) (riel)
Cout 100 µF | + | | A-D45 | +5 V (riel)
| - | | A-D43 | GND (0 V) (riel)
DZ Zener 1N4734A 5.6 V | K | | A-F42 | REG.bz → Rz pata 2, Q1 pata B
| A | | A-F38 | REG.N1 → Rtr pata W
Q1 BD139 | E | | A-J44 | +5 V (riel)
| C | | A-J43 | +12 V (riel)
| B | | A-J42 | REG.bz → Rz pata 2, DZ pata K
Rtr 100 Ω | 1 | | A-G39 | GND (0 V) (riel)
| W | | A-G38 | REG.N1 → DZ pata A
| 3 | | A-G37 | sin conexión
Rz 510 | 1 | | A-G46 | +12 V (riel)
| 2 | | A-G42 | REG.bz → DZ pata K, Q1 pata B

### Cables de este bloque

Cable | Red | De | A
[4] | +12 V | A-F43 | A-riel +12 V izq fila 43
[5] | +12 V | A-F46 | A-riel +12 V izq fila 46
[12] | GND (0 V) | A-A43 | A-riel GND der fila 43
[13] | GND (0 V) | A-I39 | A-riel GND izq fila 38
[84] | +5 V | A-F44 | A-riel +5 V der fila 44
[85] | +5 V | A-A45 | A-riel +5 V der fila 46

### Pruebas al terminar el bloque

Medida | Esperado | Si no coincide
v5: salida del regulador (emisor de Q1) V DC | 5.0 V (simulación: 5.012 a 5.018 V). Debe estar entre 4.75 y 5.25 V | Fuera de rango: ajusta el trimpot Rtr (100 Ω) y revisa Q1 y el Zener.
Base de Q1 (cátodo del Zener) V DC | ≈ 5.7 V | 0 V: el Zener está al revés o falta Rz. 12 V: Rz sin carga (Zener abierto).

## 7 Potencia (PWM + MOSFET) · placa A

### Componentes de este bloque (sepáralos antes de armar)

Cant. | Componente | Nombres
1 | 74HC08 | U10
1 | 1N5819 | Dfw
1 | IRFZ44N | M1
1 | 2N3904 | Q3
1 | 2N3906 | Q4
1 | 47 | Rg
1 | 10k | Rpd
1 | 0.5 Ω 5 W | Rsh

### Conexiones pata por pata

Pieza | Pata | Nombre | Agujero | Va a
U10 74HC08 | 1 | 1A | A-F32 | pwm → Rpu pata 2, U13 pata 1
| 2 | 1B | A-F31 | m → U9 pata 6, U9 pata 9, U9 pata 12
| 3 | 1Y | A-F30 | POT.pwmg → Q3 pata B, Q4 pata B
| 4 | 2A | A-F29 | GND (0 V) (riel)
| 5 | 2B | A-F28 | GND (0 V) (riel)
| 6 | 2Y | A-F27 | sin conexión
| 7 | GND | A-F26 | GND (0 V) (riel)
| 8 | 3Y | A-E26 | sin conexión
| 9 | 3A | A-E27 | GND (0 V) (riel)
| 10 | 3B | A-E28 | GND (0 V) (riel)
| 11 | 4Y | A-E29 | sin conexión
| 12 | 4A | A-E30 | GND (0 V) (riel)
| 13 | 4B | A-E31 | GND (0 V) (riel)
| 14 | VCC | A-E32 | +5 V (riel)
Dfw 1N5819 | A | | A-J19 | dm → M1 pata D, TBM pata M-
| K | | A-J15 | +12 V (riel)
M1 IRFZ44N | G | | A-F24 | POT.gate → Rg pata 2, Rpd pata 1
| D | | A-F23 | dm → Dfw pata A, TBM pata M-
| S | | A-F22 | sh → Rsh pata 1, U4 pata 3
Q3 2N3904 | E | | A-C25 | POT.g → Q4 pata E, Rg pata 1
| B | | A-C24 | POT.pwmg → Q4 pata B, U10 pata 3
| C | | A-C23 | +5 V (riel)
Q4 2N3906 | E | | A-E20 | POT.g → Q3 pata E, Rg pata 1
| B | | A-E19 | POT.pwmg → Q3 pata B, U10 pata 3
| C | | A-E18 | GND (0 V) (riel)
Rg 47 | 1 | | A-B25 | POT.g → Q3 pata E, Q4 pata E
| 2 | | A-B21 | POT.gate → Rpd pata 1, M1 pata G
Rpd 10k | 1 | | A-C21 | POT.gate → Rg pata 2, M1 pata G
| 2 | | A-C17 | GND (0 V) (riel)
Rsh 0.5 Ω 5 W | 1 | | A-F18 | sh → M1 pata S, U4 pata 3
| 2 | | A-F13 | GND (0 V) (riel)

### Cables de este bloque

Cable | Red | De | A
[6] | +12 V | A-H15 | A-riel +12 V izq fila 14
[14] | GND (0 V) | A-G29 | A-riel GND izq fila 29
[15] | GND (0 V) | A-G28 | A-riel GND izq fila 28
[16] | GND (0 V) | A-G26 | A-riel GND izq fila 26
[17] | GND (0 V) | A-D27 | A-riel GND der fila 26
[18] | GND (0 V) | A-D28 | A-riel GND der fila 28
[19] | GND (0 V) | A-D30 | A-riel GND der fila 30
[20] | GND (0 V) | A-D31 | A-riel GND der fila 31
[21] | GND (0 V) | A-B18 | A-riel GND der fila 18
[22] | GND (0 V) | A-B17 | A-riel GND der fila 17
[23] | GND (0 V) | A-H13 | A-riel GND izq fila 13
[82] | dm | A-H55 | A-J23
[83] | dm | A-I55 | A-F19
[86] | +5 V | A-D32 | A-riel +5 V der fila 31
[87] | +5 V | A-E23 | A-riel +5 V der fila 23
[119] | pwm | A-G32 | D-E31
[121] | m | A-G31 | C-G57
[124] | POT.pwmg | A-G30 | A-E24
[125] | POT.pwmg | A-A24 | A-B19
[126] | POT.gate | A-J24 | A-E21
[127] | sh | A-J22 | A-H18
[128] | sh | A-I18 | B-G39
[129] | POT.g | A-E25 | A-A20

### Pruebas al terminar el bloque

Medida | Esperado | Si no coincide
sh: caída en el shunt (0.5 Ω) V DC (usa el rango de mV) | ≈ 0.075 V con 0.15 A (motor andando); 0.33 V ≈ 0.67 A dispara | 0 V con el motor andando: shunt abierto. Mucho mayor: motor frenado o corto.
gate: compuerta del IRFZ44N osciloscopio | pulsos de 0 a ≈ 4.4 V; con M = 0 queda en 0 V | Siempre 0 V: M = 0 o falla U10. Siempre 4.4 V: el PWM está al 100 %.
dm: drenaje (motor) osciloscopio | conmuta entre ≈ 0.5 V y ≈ 11.5 V | Siempre 11.5 V: el MOSFET no conduce.
U10 74HC08: entre VCC (pata 14) y GND (pata 7) V DC | 5.0 V (entre 4.75 y 5.25 V) | 0 V: falta el cable de alimentación del chip o su GND. Si mide menos de 4.75 V, revisa el regulador de 5 V.

## 11 Alarma · placa A

### Componentes de este bloque (sepáralos antes de armar)

Cant. | Componente | Nombres
1 | buzzer activo 12 V | BZ
1 | LED rojo | Dl
1 | 2N3904 | Q6
1 | 1k | Rb
1 | 470 | Rl

### Conexiones pata por pata

Pieza | Pata | Nombre | Agujero | Va a
BZ buzzer activo 12 V | + | | A-J8 | +12 V (riel)
| - | | A-J5 | ALA.cz → Q6 pata C
Dl LED rojo | A | | A-B3 | ALA.nl → Rl pata 2
| K | | A-B1 | GND (0 V) (riel)
Q6 2N3904 | E | | A-C7 | GND (0 V) (riel)
| B | | A-C6 | ALA.ba → Rb pata 2
| C | | A-C5 | ALA.cz → BZ pata -
Rb 1k | 1 | | A-E8 | f → Rl pata 1, U8 pata 6, U8 pata 10
| 2 | | A-E4 | ALA.ba → Q6 pata B
Rl 470 | 1 | | A-G7 | f → Rb pata 1, U8 pata 6, U8 pata 10
| 2 | | A-G3 | ALA.nl → Dl pata A

### Cables de este bloque

Cable | Red | De | A
[7] | +12 V | A-F8 | A-riel +12 V izq fila 10
[24] | GND (0 V) | A-D7 | A-riel GND der fila 7
[25] | GND (0 V) | A-E1 | A-riel GND der fila 1
[130] | ALA.cz | A-F5 | A-D5
[131] | ALA.ba | A-D6 | A-D4
[132] | ALA.nl | A-D3 | A-F3
[133] | f | A-F7 | A-D8
[134] | f | A-C8 | C-D49

### Pruebas al terminar el bloque

Medida | Esperado | Si no coincide
f: falla enclavada (U8 pata 3) V DC | 0 V normal; ≈ 4.5 a 4.8 V con falla (queda hasta pulsar reset) | Se queda en 5 V después del reset: la causa de la falla aún existe.
Colector de Q6 (buzzer) V DC | 12 V apagado; ≈ 0.04 V con alarma (suena) | Siempre 12 V: revisa Rb y Q6.

## 2 Sensor IR · placa B

### Componentes de este bloque (sepáralos antes de armar)

Cant. | Componente | Nombres
1 | LM393 | U1
1 | 2N3904 | Q2
1 | 47k | R1
3 | 10k | R2, Ra, Rpu
1 | 150 | RE
1 | 26.8k | Rb
1 | 680 | Rc
1 | 220k | Rh
1 | 270 | Rled
1 | 10k | T1
1 | TCRT5000 | TCRT

### Conexiones pata por pata

Pieza | Pata | Nombre | Agujero | Va a
U1 LM393 | 1 | OUT A | B-F62 | p → Rpu pata 2, Rh pata 1, U8 pata 12, U8 pata 13, U9 pata 13
| 2 | IN- A | B-F61 | SEN.c → Q2 pata C, Rc pata 2
| 3 | IN+ A | B-F60 | SEN.th → Rh pata 2, T1 pata W
| 4 | GND | B-F59 | GND (0 V) (riel)
| 5 | IN+ B | B-E59 | GND (0 V) (riel)
| 6 | IN- B | B-E60 | GND (0 V) (riel)
| 7 | OUT B | B-E61 | sin conexión
| 8 | VCC | B-E62 | +5 V (riel)
Q2 2N3904 | E | | B-A51 | SEN.e → RE pata 1
| B | | B-A50 | b → R1 pata 2, R2 pata 1, TCRT pata E
| C | | B-A49 | SEN.c → Rc pata 2, U1 pata 2
R1 47k | 1 | | B-G54 | +5 V (riel)
| 2 | | B-G50 | b → R2 pata 1, Q2 pata B, TCRT pata E
R2 10k | 1 | | B-D50 | b → R1 pata 2, Q2 pata B, TCRT pata E
| 2 | | B-D46 | GND (0 V) (riel)
RE 150 | 1 | | B-C51 | SEN.e → Q2 pata E
| 2 | | B-C47 | GND (0 V) (riel)
Ra 10k | 1 | | B-C62 | +5 V (riel)
| 2 | | B-C58 | SEN.th1 → T1 pata 1
Rb 26.8k | 1 | | B-D56 | SEN.th2 → T1 pata 3
| 2 | | B-D52 | GND (0 V) (riel)
Rc 680 | 1 | | B-F55 | +5 V (riel)
| 2 | | B-F51 | SEN.c → Q2 pata C, U1 pata 2
Rh 220k | 1 | | B-I62 | p → Rpu pata 2, U1 pata 1, U8 pata 12, U8 pata 13, U9 pata 13
| 2 | | B-I58 | SEN.th → T1 pata W, U1 pata 3
Rled 270 | 1 | | B-I56 | +5 V (riel)
| 2 | | B-I52 | SEN.nled → TCRT pata A
Rpu 10k | 1 | | B-J57 | +5 V (riel)
| 2 | | B-J53 | p → Rh pata 1, U1 pata 1, U8 pata 12, U8 pata 13, U9 pata 13
T1 10k | 1 | | B-A58 | SEN.th1 → Ra pata 2
| W | | B-A57 | SEN.th → Rh pata 2, U1 pata 3
| 3 | | B-A56 | SEN.th2 → Rb pata 1
TCRT TCRT5000 | A | | B-J49 | SEN.nled → Rled pata 2
| K | | B-J48 | GND (0 V) (riel)
| C | | B-J47 | +5 V (riel)
| E | | B-J46 | b → R1 pata 2, R2 pata 1, Q2 pata B

### Cables de este bloque

Cable | Red | De | A
[26] | GND (0 V) | B-G59 | B-riel GND izq fila 59
[27] | GND (0 V) | B-D59 | B-riel GND der fila 59
[28] | GND (0 V) | B-D60 | B-riel GND der fila 60
[29] | GND (0 V) | B-E52 | B-riel GND der fila 52
[30] | GND (0 V) | B-E47 | B-riel GND der fila 47
[31] | GND (0 V) | B-E46 | B-riel GND der fila 46
[32] | GND (0 V) | B-F48 | B-riel GND izq fila 48
[88] | +5 V | B-D62 | B-riel +5 V der fila 62
[89] | +5 V | B-F57 | B-riel +5 V izq fila 56
[90] | +5 V | B-G55 | B-riel +5 V izq fila 55
[91] | +5 V | B-H54 | B-riel +5 V izq fila 54
[92] | +5 V | B-F47 | B-riel +5 V izq fila 47
[93] | +5 V | B-F56 | B-riel +5 V izq fila 58
[136] | p | B-G62 | B-H53
[137] | p | B-H62 | C-D61
[140] | SEN.c | B-G61 | B-H51
[141] | SEN.c | B-J51 | B-E49
[142] | SEN.th | B-G60 | B-F58
[143] | SEN.th | B-G58 | B-E57
[144] | b | B-E50 | B-H50
[145] | b | B-I50 | B-F46
[146] | SEN.nled | B-F49 | B-H52
[220] | SEN.nled | B-J49 | dispositivo TCRT · A
[221] | GND (0 V) | B-J48 | dispositivo TCRT · K
[222] | +5 V | B-J47 | dispositivo TCRT · C
[223] | b | B-J46 | dispositivo TCRT · E

### Pruebas al terminar el bloque

Medida | Esperado | Si no coincide
Base de Q2 (b) V DC | ≈ 0.85 V sin objeto, 1.15 V con objeto | 0 V: falta R1 (47 k). 5 V: falta R2 (10 k).
Colector de Q2 V DC | ≈ 4.2 V sin objeto, ≈ 2.9 V con objeto | 5 V: Q2 no conduce. Cerca de 1 V: Q2 saturado.
p: salida del comparador (U1 pata 1) V DC | ≈ 0.03 V sin objeto, ≈ 4.9 V con objeto | Siempre igual: ajusta el trimpot del umbral (SEN.T1) o revisa el TCRT5000.
U1 LM393: entre VCC (pata 8) y GND (pata 4) V DC | 5.0 V (entre 4.75 y 5.25 V) | 0 V: falta el cable de alimentación del chip o su GND. Si mide menos de 4.75 V, revisa el regulador de 5 V.

## 3 Sobrecorriente · placa B

### Componentes de este bloque (sepáralos antes de armar)

Cant. | Componente | Nombres
1 | LM393 | U14
1 | LM358 | U4
1 | 10 µF | Cd
1 | 100 nF | Cpk
1 | 1N4148 | D1
1 | 22k | Rbl
3 | 10k | Rd, Ra, Rb
1 | 6.8k | Rf
1 | 1k | Rg
1 | 10k | T1

### Conexiones pata por pata

Pieza | Pata | Nombre | Agujero | Va a
U14 LM393 | 1 | OUT A | B-F35 | setn → Rh pata 1, Rsn pata 2, U2 pata 1, U8 pata 2, U8 pata 4
| 2 | IN- A | B-F34 | OC.dl → Rd pata 2, Cd pata +
| 3 | IN+ A | B-F33 | OC.ref → T1 pata W
| 4 | GND | B-F32 | GND (0 V) (riel)
| 5 | IN+ B | B-E32 | GND (0 V) (riel)
| 6 | IN- B | B-E33 | GND (0 V) (riel)
| 7 | OUT B | B-E34 | sin conexión
| 8 | VCC | B-E35 | +5 V (riel)
U4 LM358 | 1 | OUT A | B-F41 | OC.oa → Rf pata 1, D1 pata A
| 2 | IN- A | B-F40 | OC.fb → Rg pata 1, Rf pata 2
| 3 | IN+ A | B-F39 | sh → M1 pata S, Rsh pata 1
| 4 | GND | B-F38 | GND (0 V) (riel)
| 5 | IN+ B | B-E38 | GND (0 V) (riel)
| 6 | IN- B | B-E39 | GND (0 V) (riel)
| 7 | OUT B | B-E40 | sin conexión
| 8 | VCC | B-E41 | +12 V (riel)
Cd 10 µF | + | | B-H34 | OC.dl → Rd pata 2, U14 pata 2
| - | | B-H32 | GND (0 V) (riel)
Cpk 100 nF | 1 | | B-G27 | OC.pk → D1 pata K, Rbl pata 1, Rd pata 1
| 2 | | B-G25 | GND (0 V) (riel)
D1 1N4148 | A | | B-F31 | OC.oa → Rf pata 1, U4 pata 1
| K | | B-F27 | OC.pk → Cpk pata 1, Rbl pata 1, Rd pata 1
Ra 10k | 1 | | B-A35 | +5 V (riel)
| 2 | | B-A31 | OC.rt → T1 pata 1
Rb 10k | 1 | | B-D29 | OC.rb2 → T1 pata 3
| 2 | | B-D25 | GND (0 V) (riel)
Rbl 22k | 1 | | B-H27 | OC.pk → D1 pata K, Cpk pata 1, Rd pata 1
| 2 | | B-H23 | GND (0 V) (riel)
Rd 10k | 1 | | B-J30 | OC.pk → D1 pata K, Cpk pata 1, Rbl pata 1
| 2 | | B-J26 | OC.dl → Cd pata +, U14 pata 2
Rf 6.8k | 1 | | B-I41 | OC.oa → D1 pata A, U4 pata 1
| 2 | | B-I37 | OC.fb → Rg pata 1, U4 pata 2
Rg 1k | 1 | | B-H40 | OC.fb → Rf pata 2, U4 pata 2
| 2 | | B-H36 | GND (0 V) (riel)
T1 10k | 1 | | B-C31 | OC.rt → Ra pata 2
| W | | B-C30 | OC.ref → U14 pata 3
| 3 | | B-C29 | OC.rb2 → Rb pata 1

### Cables de este bloque

Cable | Red | De | A
[8] | +12 V | B-D41 | A-riel +12 V izq fila 41
[33] | GND (0 V) | B-G38 | B-riel GND izq fila 38
[34] | GND (0 V) | B-D38 | B-riel GND der fila 38
[35] | GND (0 V) | B-D39 | B-riel GND der fila 40
[36] | GND (0 V) | B-J32 | B-riel GND izq fila 29
[37] | GND (0 V) | B-D32 | B-riel GND der fila 31
[38] | GND (0 V) | B-D33 | B-riel GND der fila 35
[39] | GND (0 V) | B-F36 | B-riel GND izq fila 36
[40] | GND (0 V) | B-E25 | B-riel GND der fila 25
[41] | GND (0 V) | B-F25 | B-riel GND izq fila 25
[42] | GND (0 V) | B-F23 | B-riel GND izq fila 23
[94] | +5 V | B-D35 | B-riel +5 V der fila 35
[128] | sh | A-I18 | B-G39
[147] | OC.oa | B-G41 | B-J31
[148] | OC.fb | B-G40 | B-F37
[149] | setn | B-G35 | B-G18
[150] | setn | B-I35 | C-G50
[152] | OC.dl | B-J34 | B-I26
[153] | OC.ref | B-J33 | B-E30
[154] | OC.pk | B-G30 | B-I27

### Pruebas al terminar el bloque

Medida | Esperado | Si no coincide
Salida del LM358 (ganancia 7.8) V DC | ≈ 0.55 V con 0.15 A (7.8 × sh) | 0 V: falta Rg o Rf mal. Sin ganancia: Rf abierta.
U14 LM393: entre VCC (pata 8) y GND (pata 4) V DC | 5.0 V (entre 4.75 y 5.25 V) | 0 V: falta el cable de alimentación del chip o su GND. Si mide menos de 4.75 V, revisa el regulador de 5 V.
U4 LM358: entre VCC (pata 8) y GND (pata 4) V DC | 11.1 a 11.3 V (los 12 V después de D1) | 0 V: falta el cable de alimentación del chip o su GND. Si mide menos de 4.75 V, revisa el regulador de 5 V.

## 4 Temperatura · placa B

### Componentes de este bloque (sepáralos antes de armar)

Cant. | Componente | Nombres
1 | LM393 | U2
1 | 22k | Ra
1 | 68k | Rb
1 | 10k | Rfix
1 | 1M | Rh
1 | 10k | T1
1 | NTC 10 k | TBN

### Conexiones pata por pata

Pieza | Pata | Nombre | Agujero | Va a
U2 LM393 | 1 | OUT A | B-F18 | setn → Rh pata 1, Rsn pata 2, U14 pata 1, U8 pata 2, U8 pata 4
| 2 | IN- A | B-F17 | tnode → Rfix pata 1, TBN pata NTC
| 3 | IN+ A | B-F16 | TMP.ref → Rh pata 2, T1 pata W
| 4 | GND | B-F15 | GND (0 V) (riel)
| 5 | IN+ B | B-E15 | GND (0 V) (riel)
| 6 | IN- B | B-E16 | GND (0 V) (riel)
| 7 | OUT B | B-E17 | sin conexión
| 8 | VCC | B-E18 | +5 V (riel)
TBN NTC 10 k | 5V | | B-F13 | +5 V (riel)
| NTC | | B-F11 | tnode → Rfix pata 1, U2 pata 2
Ra 22k | 1 | | B-A18 | +5 V (riel)
| 2 | | B-A14 | TMP.rt → T1 pata 1
Rb 68k | 1 | | B-B12 | TMP.rb2 → T1 pata 3
| 2 | | B-B8 | GND (0 V) (riel)
Rfix 10k | 1 | | B-J11 | tnode → TBN pata NTC, U2 pata 2
| 2 | | B-J7 | GND (0 V) (riel)
Rh 1M | 1 | | B-H18 | setn → Rsn pata 2, U14 pata 1, U2 pata 1, U8 pata 2, U8 pata 4
| 2 | | B-H14 | TMP.ref → T1 pata W, U2 pata 3
T1 10k | 1 | | B-D14 | TMP.rt → Ra pata 2
| W | | B-D13 | TMP.ref → Rh pata 2, U2 pata 3
| 3 | | B-D12 | TMP.rb2 → Rb pata 1

### Cables de este bloque

Cable | Red | De | A
[43] | GND (0 V) | B-G15 | B-riel GND izq fila 14
[44] | GND (0 V) | B-B15 | B-riel GND der fila 14
[45] | GND (0 V) | B-D16 | B-riel GND der fila 16
[46] | GND (0 V) | B-E8 | B-riel GND der fila 8
[47] | GND (0 V) | B-F7 | B-riel GND izq fila 6
[95] | +5 V | B-D18 | B-riel +5 V der fila 18
[96] | +5 V | B-G13 | B-riel +5 V izq fila 13
[149] | setn | B-G35 | B-G18
[155] | tnode | B-G17 | B-G11
[156] | TMP.ref | B-G16 | B-F14
[157] | TMP.ref | B-G14 | B-E13
[238] | +5 V | B-F13 | dispositivo NTC · 5V
[239] | tnode | B-F11 | dispositivo NTC · NTC

### Pruebas al terminar el bloque

Medida | Esperado | Si no coincide
tnode: divisor del NTC V DC | ≈ 2.5 V a 25 °C; ≈ 3.7 V a 50 °C (dispara a ≈ 49.9 °C) | 0 V: NTC desconectado o Rfix en corto. 5 V: Rfix abierta.
U2 LM393: entre VCC (pata 8) y GND (pata 4) V DC | 5.0 V (entre 4.75 y 5.25 V) | 0 V: falta el cable de alimentación del chip o su GND. Si mide menos de 4.75 V, revisa el regulador de 5 V.

## 5 Logica · placa C

### Componentes de este bloque (sepáralos antes de armar)

Cant. | Componente | Nombres
1 | 74HC14 | U11
1 | 74HC00 | U8
1 | 74HC08 | U9
3 | 100 nF | Cef, Cgf, Crf
1 | 1 µF | Cpor
1 | 1N4148 | Dpor
7 | 10k | Rpe, Rse, Rpg, Rsg, Rpr, Rsr, Rsn
1 | 47k | Rpor
1 | Interruptor E | TBE
1 | Micro-switch cubierta | TBG
1 | Pulsador reset | TBR

### Conexiones pata por pata

Pieza | Pata | Nombre | Agujero | Va a
U11 74HC14 | 1 | 1A | C-F44 | LOG.ef → Rse pata 2, Cef pata 1
| 2 | 1Y | C-F43 | LOG.ein_n → U11 pata 3
| 3 | 2A | C-F42 | LOG.ein_n → U11 pata 2
| 4 | 2Y | C-F41 | LOG.e → U9 pata 1
| 5 | 3A | C-F40 | LOG.gf → Rsg pata 2, Cgf pata 1
| 6 | 3Y | C-F39 | LOG.gin_n → U11 pata 9
| 7 | GND | C-F38 | GND (0 V) (riel)
| 8 | 4Y | C-E38 | LOG.g → U9 pata 2
| 9 | 4A | C-E39 | LOG.gin_n → U11 pata 6
| 10 | 5Y | C-E40 | LOG.rin_n → U11 pata 13
| 11 | 5A | C-E41 | LOG.rf → Rsr pata 2, Crf pata 1, Dpor pata K
| 12 | 6Y | C-E42 | LOG.rst → U8 pata 1
| 13 | 6A | C-E43 | LOG.rin_n → U11 pata 10
| 14 | VCC | C-E44 | +5 V (riel)
U8 74HC00 | 1 | 1A | C-F53 | LOG.rst → U11 pata 12
| 2 | 1B | C-F52 | setn → Rh pata 1, Rsn pata 2, U14 pata 1, U2 pata 1, U8 pata 4
| 3 | 1Y | C-F51 | LOG.reset_n → U8 pata 9
| 4 | 2A | C-F50 | setn → Rh pata 1, Rsn pata 2, U14 pata 1, U2 pata 1, U8 pata 2
| 5 | 2B | C-F49 | fn → U8 pata 8, U9 pata 5
| 6 | 2Y | C-F48 | f → Rb pata 1, Rl pata 1, U8 pata 10
| 7 | GND | C-F47 | GND (0 V) (riel)
| 8 | 3Y | C-E47 | fn → U8 pata 5, U9 pata 5
| 9 | 3A | C-E48 | LOG.reset_n → U8 pata 3
| 10 | 3B | C-E49 | f → Rb pata 1, Rl pata 1, U8 pata 6
| 11 | 4Y | C-E50 | LOG.pn → U9 pata 10, Dlo pata K
| 12 | 4A | C-E51 | p → Rpu pata 2, Rh pata 1, U1 pata 1, U8 pata 13, U9 pata 13
| 13 | 4B | C-E52 | p → Rpu pata 2, Rh pata 1, U1 pata 1, U8 pata 12, U9 pata 13
| 14 | VCC | C-E53 | +5 V (riel)
U9 74HC08 | 1 | 1A | C-F62 | LOG.e → U11 pata 4
| 2 | 1B | C-F61 | LOG.g → U11 pata 8
| 3 | 1Y | C-F60 | LOG.m1 → U9 pata 4
| 4 | 2A | C-F59 | LOG.m1 → U9 pata 3
| 5 | 2B | C-F58 | fn → U8 pata 5, U8 pata 8
| 6 | 2Y | C-F57 | m → U9 pata 9, U9 pata 12, U10 pata 2
| 7 | GND | C-F56 | GND (0 V) (riel)
| 8 | 3Y | C-E56 | n → —
| 9 | 3A | C-E57 | m → U9 pata 6, U9 pata 12, U10 pata 2
| 10 | 3B | C-E58 | LOG.pn → U8 pata 11, Dlo pata K
| 11 | 4Y | C-E59 | l → Rb5 pata 1
| 12 | 4A | C-E60 | m → U9 pata 6, U9 pata 9, U10 pata 2
| 13 | 4B | C-E61 | p → Rpu pata 2, Rh pata 1, U1 pata 1, U8 pata 12, U8 pata 13
| 14 | VCC | C-E62 | +5 V (riel)
TBE Interruptor E | 5V | | C-J28 | +5 V (riel)
| E | | C-J26 | ein → Rpe pata 1, Rse pata 1
TBG Micro-switch cubierta | 5V | | C-G36 | +5 V (riel)
| G | | C-G34 | gin → Rpg pata 1, Rsg pata 1
TBR Pulsador reset | 5V | | C-B33 | +5 V (riel)
| RST | | C-B31 | rin → Rpr pata 1, Rsr pata 1
Cef 100 nF | 1 | | C-C37 | LOG.ef → Rse pata 2, U11 pata 1
| 2 | | C-C35 | GND (0 V) (riel)
Cgf 100 nF | 1 | | C-H40 | LOG.gf → Rsg pata 2, U11 pata 5
| 2 | | C-H38 | GND (0 V) (riel)
Cpor 1 µF | + | | C-H32 | +5 V (riel)
| - | | C-H30 | LOG.por → Rpor pata 1, Dpor pata A
Crf 100 nF | 1 | | C-C32 | LOG.rf → Rsr pata 2, Dpor pata K, U11 pata 11
| 2 | | C-C30 | GND (0 V) (riel)
Dpor 1N4148 | A | | C-D36 | LOG.por → Cpor pata -, Rpor pata 1
| K | | C-D32 | LOG.rf → Rsr pata 2, Crf pata 1, U11 pata 11
Rpe 10k | 1 | | C-E28 | ein → Rse pata 1, TBE pata E
| 2 | | C-E24 | GND (0 V) (riel)
Rpg 10k | 1 | | C-F29 | gin → Rsg pata 1, TBG pata G
| 2 | | C-F25 | GND (0 V) (riel)
Rpor 47k | 1 | | C-A34 | LOG.por → Cpor pata -, Dpor pata A
| 2 | | C-A30 | GND (0 V) (riel)
Rpr 10k | 1 | | C-B29 | rin → Rsr pata 1, TBR pata RST
| 2 | | C-B25 | GND (0 V) (riel)
Rse 10k | 1 | | C-F35 | ein → Rpe pata 1, TBE pata E
| 2 | | C-F31 | LOG.ef → Cef pata 1, U11 pata 1
Rsg 10k | 1 | | C-J37 | gin → Rpg pata 1, TBG pata G
| 2 | | C-J33 | LOG.gf → Cgf pata 1, U11 pata 5
Rsn 10k | 1 | | C-J54 | +5 V (riel)
| 2 | | C-J50 | setn → Rh pata 1, U14 pata 1, U2 pata 1, U8 pata 2, U8 pata 4
Rsr 10k | 1 | | C-C45 | rin → Rpr pata 1, TBR pata RST
| 2 | | C-C41 | LOG.rf → Crf pata 1, Dpor pata K, U11 pata 11

### Cables de este bloque

Cable | Red | De | A
[48] | GND (0 V) | C-G56 | C-riel GND izq fila 56
[49] | GND (0 V) | C-G47 | C-riel GND izq fila 48
[50] | GND (0 V) | C-G38 | C-riel GND izq fila 37
[51] | GND (0 V) | C-E35 | C-riel GND der fila 35
[52] | GND (0 V) | C-E30 | C-riel GND der fila 30
[53] | GND (0 V) | C-G25 | C-riel GND izq fila 24
[54] | GND (0 V) | C-D24 | C-riel GND der fila 24
[55] | GND (0 V) | C-D25 | C-riel GND der fila 25
[97] | +5 V | C-D62 | C-riel +5 V der fila 62
[98] | +5 V | C-D53 | C-riel +5 V der fila 53
[99] | +5 V | C-D44 | C-riel +5 V der fila 44
[100] | +5 V | C-F54 | C-riel +5 V izq fila 54
[101] | +5 V | C-F36 | C-riel +5 V izq fila 36
[102] | +5 V | C-E33 | C-riel +5 V der fila 31
[103] | +5 V | C-I32 | C-riel +5 V izq fila 31
[104] | +5 V | C-G28 | C-riel +5 V izq fila 28
[121] | m | A-G31 | C-G57
[122] | m | C-H57 | C-D57
[123] | m | C-C57 | C-D60
[134] | f | A-C8 | C-D49
[135] | f | C-C49 | C-G48
[137] | p | B-H62 | C-D61
[138] | p | C-C61 | C-D52
[139] | p | C-C52 | C-D51
[150] | setn | B-I35 | C-G50
[151] | setn | C-H50 | C-G52
[158] | LOG.e | C-G62 | C-G41
[159] | LOG.g | C-G61 | C-D38
[160] | LOG.m1 | C-G60 | C-G59
[161] | fn | C-G58 | C-G49
[162] | fn | C-H49 | C-D47
[163] | LOG.pn | C-D58 | C-D50
[164] | LOG.pn | C-C50 | C-B13
[165] | l | C-D59 | C-A5
[166] | LOG.rst | C-G53 | C-D42
[167] | LOG.reset_n | C-G51 | C-D48
[168] | LOG.ef | C-G44 | C-E37
[169] | LOG.ef | C-D37 | C-I31
[170] | LOG.ein_n | C-G43 | C-G42
[171] | LOG.gf | C-G40 | C-H33
[172] | LOG.gin_n | C-G39 | C-D39
[173] | LOG.rin_n | C-D40 | C-D43
[174] | LOG.rf | C-D41 | C-E32
[175] | gin | C-F37 | C-H34
[176] | gin | C-I34 | C-I29
[177] | rin | C-E45 | C-E31
[178] | rin | C-D45 | C-E29
[179] | LOG.por | C-E36 | C-E34
[180] | LOG.por | C-B34 | C-I30
[181] | ein | C-H35 | C-G26
[182] | ein | C-H26 | C-D28
[232] | +5 V | C-J28 | dispositivo SW_E · 5V
[233] | ein | C-J26 | dispositivo SW_E · E
[234] | +5 V | C-G36 | dispositivo SW_G · 5V
[235] | gin | C-G34 | dispositivo SW_G · G
[236] | +5 V | C-B33 | dispositivo SW_R · 5V
[237] | rin | C-B31 | dispositivo SW_R · RST

### Pruebas al terminar el bloque

Medida | Esperado | Si no coincide
setn: 5 V normal, 0 V en falla V DC | 5.0 V sin falla; ≈ 0 V cuando dispara corriente o temperatura | 0 V siempre: umbral muy bajo; ajusta el trimpot de OC.T1 o TMP.T1.
M: permiso de motor (U9 pata 11 → ver la salida de Xa2) V DC | 5 V con E=1, G=1, sin falla; 0 V si abres la cubierta o hay falla | 0 V con todo bien: revisa E, G, F y U9.
U8 74HC00: entre VCC (pata 14) y GND (pata 7) V DC | 5.0 V (entre 4.75 y 5.25 V) | 0 V: falta el cable de alimentación del chip o su GND. Si mide menos de 4.75 V, revisa el regulador de 5 V.
U9 74HC08: entre VCC (pata 14) y GND (pata 7) V DC | 5.0 V (entre 4.75 y 5.25 V) | 0 V: falta el cable de alimentación del chip o su GND. Si mide menos de 4.75 V, revisa el regulador de 5 V.
U11 74HC14: entre VCC (pata 14) y GND (pata 7) V DC | 5.0 V (entre 4.75 y 5.25 V) | 0 V: falta el cable de alimentación del chip o su GND. Si mide menos de 4.75 V, revisa el regulador de 5 V.

## LED de objeto · placa C

### Componentes de este bloque (sepáralos antes de armar)

Cant. | Componente | Nombres
1 | LED verde (objeto) | Dlo
1 | 680 | Rlo

### Conexiones pata por pata

Pieza | Pata | Nombre | Agujero | Va a
Dlo LED verde (objeto) | A | | C-D15 | LOG.lo → Rlo pata 2
| K | | C-D13 | LOG.pn → U8 pata 11, U9 pata 10
Rlo 680 | 1 | | C-B19 | +5 V (riel)
| 2 | | C-B15 | LOG.lo → Dlo pata A

### Cables de este bloque

Cable | Red | De | A
[105] | +5 V | C-E19 | C-riel +5 V der fila 19
[164] | LOG.pn | C-C50 | C-B13

### Pruebas al terminar el bloque

Medida | Esperado | Si no coincide
LED de objeto: ánodo (pata A) V DC | ≈ 2.0 V con objeto (el LED enciende, unos 4.4 mA con la resistencia de 680 Ω); 5 V sin objeto (apagado) | Nunca enciende: LED al revés (la pata larga es A) o Rlo (680 Ω) abierta.

## 9 Referencia de velocidad · placa C

### Componentes de este bloque (sepáralos antes de armar)

Cant. | Componente | Nombres
1 | 100 nF | Cr
1 | 2N3904 | Q5
1 | 10k | Rb5
1 | 68k | Rt
2 | 10k | T1, T2

### Conexiones pata por pata

Pieza | Pata | Nombre | Agujero | Va a
Cr 100 nF | 1 | | C-I8 | vref → Rt pata 2, T1 pata 1, T2 pata 1, U5 pata 3
| 2 | | C-I6 | GND (0 V) (riel)
Q5 2N3904 | E | | C-J3 | GND (0 V) (riel)
| B | | C-J2 | REF.bq → Rb5 pata 2
| C | | C-J1 | REF.cq → T2 pata W
Rb5 10k | 1 | | C-E5 | l → U9 pata 11
| 2 | | C-E1 | REF.bq → Q5 pata B
Rt 68k | 1 | | C-B8 | +5 V (riel)
| 2 | | C-B4 | vref → T1 pata 1, T2 pata 1, Cr pata 1, U5 pata 3
T1 10k | 1 | | C-H7 | vref → Rt pata 2, T2 pata 1, Cr pata 1, U5 pata 3
| W | | C-H6 | GND (0 V) (riel)
| 3 | | C-H5 | sin conexión
T2 10k | 1 | | C-D4 | vref → Rt pata 2, T1 pata 1, Cr pata 1, U5 pata 3
| W | | C-D3 | REF.cq → Q5 pata C
| 3 | | C-D2 | sin conexión

### Cables de este bloque

Cable | Red | De | A
[56] | GND (0 V) | C-F6 | C-riel GND izq fila 6
[57] | GND (0 V) | C-F3 | C-riel GND izq fila 2
[106] | +5 V | C-E8 | C-riel +5 V der fila 8
[165] | l | C-D59 | C-A5
[183] | vref | C-F8 | C-F7
[184] | vref | C-J7 | C-A4
[185] | vref | C-J8 | D-G60
[186] | REF.cq | C-A3 | C-F1
[187] | REF.bq | C-B1 | C-F2

### Pruebas al terminar el bloque

Medida | Esperado | Si no coincide
vref: referencia de velocidad V DC | ≈ 0.53 V normal; ≈ 0.26 V reducida (con objeto) | Si la reducida no baja a la mitad: revisa Q5 y los trimpots REF.T1/REF.T2.

## 10 Amplificador de error · placa D

### Componentes de este bloque (sepáralos antes de armar)

Cant. | Componente | Nombres
1 | LM324 | U5
1 | 10 nF | Cf6
2 | 100 nF | Cv, Cvc
2 | 10k | R1, R3
2 | 100k | Rf6, R4
1 | 1k | Ro
1 | 4.7k | Rv1
1 | 5.1k | Rv2

### Conexiones pata por pata

Pieza | Pata | Nombre | Agujero | Va a
U5 LM324 | 1 | OUT 1 | D-F62 | ERR.vrb → R3 pata 1, U5 pata 2
| 2 | IN- 1 | D-F61 | ERR.vrb → R3 pata 1, U5 pata 1
| 3 | IN+ 1 | D-F60 | vref → Rt pata 2, T1 pata 1, T2 pata 1, Cr pata 1
| 4 | VCC | D-F59 | +12 V (riel)
| 5 | IN+ 2 | D-F58 | vspd → Rfv2 pata 2, Cfv2 pata +
| 6 | IN- 2 | D-F57 | ERR.vsb → R1 pata 1, U5 pata 7
| 7 | OUT 2 | D-F56 | ERR.vsb → R1 pata 1, U5 pata 6
| 8 | OUT 3 | D-E56 | ERR.vob → R4 pata 2, U5 pata 9
| 9 | IN- 3 | D-E57 | ERR.vob → R4 pata 2, U5 pata 8
| 10 | IN+ 3 | D-E58 | ERR.voff → Rv1 pata 2, Rv2 pata 1, Cv pata 1
| 11 | GND | D-E59 | GND (0 V) (riel)
| 12 | IN+ 4 | D-E60 | ERR.inp → R3 pata 2, R4 pata 1
| 13 | IN- 4 | D-E61 | ERR.inn → R1 pata 2, Rf6 pata 2, Cf6 pata 2
| 14 | OUT 4 | D-E62 | ERR.oa → Rf6 pata 1, Cf6 pata 1, Ro pata 1
Cf6 10 nF | 1 | | D-H55 | ERR.oa → Rf6 pata 1, Ro pata 1, U5 pata 14
| 2 | | D-H53 | ERR.inn → R1 pata 2, Rf6 pata 2, U5 pata 13
Cv 100 nF | 1 | | D-B50 | ERR.voff → Rv1 pata 2, Rv2 pata 1, U5 pata 10
| 2 | | D-B48 | GND (0 V) (riel)
Cvc 100 nF | 1 | | D-G50 | vctrl → Ro pata 2, U13 pata 3
| 2 | | D-G48 | GND (0 V) (riel)
R1 10k | 1 | | D-G57 | ERR.vsb → U5 pata 6, U5 pata 7
| 2 | | D-G53 | ERR.inn → Rf6 pata 2, Cf6 pata 2, U5 pata 13
R3 10k | 1 | | D-D55 | ERR.vrb → U5 pata 1, U5 pata 2
| 2 | | D-D51 | ERR.inp → R4 pata 1, U5 pata 12
R4 100k | 1 | | D-B60 | ERR.inp → R3 pata 2, U5 pata 12
| 2 | | D-B56 | ERR.vob → U5 pata 8, U5 pata 9
Rf6 100k | 1 | | D-F55 | ERR.oa → Cf6 pata 1, Ro pata 1, U5 pata 14
| 2 | | D-F51 | ERR.inn → R1 pata 2, Cf6 pata 2, U5 pata 13
Ro 1k | 1 | | D-I54 | ERR.oa → Rf6 pata 1, Cf6 pata 1, U5 pata 14
| 2 | | D-I50 | vctrl → Cvc pata 1, U13 pata 3
Rv1 4.7k | 1 | | D-C54 | +5 V (riel)
| 2 | | D-C50 | ERR.voff → Rv2 pata 1, Cv pata 1, U5 pata 10
Rv2 5.1k | 1 | | D-E50 | ERR.voff → Rv1 pata 2, Cv pata 1, U5 pata 10
| 2 | | D-E46 | GND (0 V) (riel)

### Cables de este bloque

Cable | Red | De | A
[9] | +12 V | D-G59 | D-riel +12 V izq fila 59
[58] | GND (0 V) | D-D59 | D-riel GND der fila 59
[59] | GND (0 V) | D-D46 | D-riel GND der fila 46
[60] | GND (0 V) | D-D48 | D-riel GND der fila 48
[61] | GND (0 V) | D-F48 | D-riel GND izq fila 48
[107] | +5 V | D-E54 | D-riel +5 V der fila 54
[185] | vref | C-J8 | D-G60
[188] | ERR.vrb | D-G62 | D-G61
[189] | ERR.vrb | D-H61 | D-E55
[190] | vspd | D-G58 | E-F35
[192] | ERR.vsb | D-H57 | D-H56
[193] | ERR.vob | D-D56 | D-D57
[194] | ERR.voff | D-D58 | D-A50
[195] | ERR.inp | D-D60 | D-E51
[196] | ERR.inn | D-D61 | D-J53
[197] | ERR.inn | D-C61 | D-G51
[198] | ERR.oa | D-D62 | D-I55
[199] | ERR.oa | D-J55 | D-J54
[200] | vctrl | D-H50 | D-G39

### Pruebas al terminar el bloque

Medida | Esperado | Si no coincide
vctrl: salida del amplificador de error V DC | ≈ 2.6 a 2.7 V en normal; sube a 7.6 V con el motor parado por falla | Fijo: el lazo no está cerrado.
U5 LM324: entre VCC (pata 4) y GND (pata 11) V DC | 11.1 a 11.3 V (los 12 V después de D1) | 0 V: falta el cable de alimentación del chip o su GND. Si mide menos de 4.75 V, revisa el regulador de 5 V.

## 6 Generador de PWM · placa D

### Componentes de este bloque (sepáralos antes de armar)

Cant. | Componente | Nombres
1 | LM393 | U13
1 | NE555 | U6
2 | 10 nF | Ct, Ccv
1 | 1k | Ra5
2 | 10k | Rb5, Rpu

### Conexiones pata por pata

Pieza | Pata | Nombre | Agujero | Va a
U13 LM393 | 1 | OUT A | D-F41 | pwm → Rpu pata 2, U10 pata 1
| 2 | IN- A | D-F40 | PWM.tri → Rb5 pata 2, Ct pata 1, U6 pata 2, U6 pata 6
| 3 | IN+ A | D-F39 | vctrl → Ro pata 2, Cvc pata 1
| 4 | GND | D-F38 | GND (0 V) (riel)
| 5 | IN+ B | D-E38 | GND (0 V) (riel)
| 6 | IN- B | D-E39 | GND (0 V) (riel)
| 7 | OUT B | D-E40 | sin conexión
| 8 | VCC | D-E41 | +5 V (riel)
U6 NE555 | 1 | GND | D-F35 | GND (0 V) (riel)
| 2 | TRIG | D-F34 | PWM.tri → Rb5 pata 2, Ct pata 1, U13 pata 2, U6 pata 6
| 3 | OUT | D-F33 | sin conexión
| 4 | RESET | D-F32 | +5 V (riel)
| 5 | CTRL | D-E32 | PWM.cv → Ccv pata 1
| 6 | THR | D-E33 | PWM.tri → Rb5 pata 2, Ct pata 1, U13 pata 2, U6 pata 2
| 7 | DISCH | D-E34 | PWM.dis → Ra5 pata 2, Rb5 pata 1
| 8 | VCC | D-E35 | +5 V (riel)
Ccv 10 nF | 1 | | D-C32 | PWM.cv → U6 pata 5
| 2 | | D-C30 | GND (0 V) (riel)
Ct 10 nF | 1 | | D-J40 | PWM.tri → Rb5 pata 2, U13 pata 2, U6 pata 2, U6 pata 6
| 2 | | D-J38 | GND (0 V) (riel)
Ra5 1k | 1 | | D-C41 | +5 V (riel)
| 2 | | D-C37 | PWM.dis → Rb5 pata 1, U6 pata 7
Rb5 10k | 1 | | D-D37 | PWM.dis → Ra5 pata 2, U6 pata 7
| 2 | | D-D33 | PWM.tri → Ct pata 1, U13 pata 2, U6 pata 2, U6 pata 6
Rpu 10k | 1 | | D-B35 | +5 V (riel)
| 2 | | D-B31 | pwm → U13 pata 1, U10 pata 1

### Cables de este bloque

Cable | Red | De | A
[62] | GND (0 V) | D-G38 | D-riel GND izq fila 38
[63] | GND (0 V) | D-D38 | D-riel GND der fila 38
[64] | GND (0 V) | D-D39 | D-riel GND der fila 40
[65] | GND (0 V) | D-G35 | D-riel GND izq fila 35
[66] | GND (0 V) | D-E30 | D-riel GND der fila 30
[108] | +5 V | D-D41 | D-riel +5 V der fila 41
[109] | +5 V | D-G32 | D-riel +5 V der fila 31
[110] | +5 V | D-C35 | D-riel +5 V der fila 35
[119] | pwm | A-G32 | D-E31
[120] | pwm | D-D31 | D-G41
[200] | vctrl | D-H50 | D-G39
[201] | PWM.tri | D-G40 | D-G34
[202] | PWM.tri | D-H34 | D-C33
[203] | PWM.dis | D-C34 | D-E37

### Pruebas al terminar el bloque

Medida | Esperado | Si no coincide
tri: rampa del 555 (U6 pata 6) osciloscopio | rampa de 1.7 a 3.3 V a ≈ 6.9 kHz (osciloscopio) | Sin rampa: revisa Ct (10 nF), Ra5 y Rb5.
pwm: salida del comparador osciloscopio | pulsos de 0 a 5 V, ≈ 6.9 kHz; ciclo ≈ 44 % con vctrl = 2.4 V | Sin pulsos: revisa U2 pata 7.
U13 LM393: entre VCC (pata 8) y GND (pata 4) V DC | 5.0 V (entre 4.75 y 5.25 V) | 0 V: falta el cable de alimentación del chip o su GND. Si mide menos de 4.75 V, revisa el regulador de 5 V.
U6 NE555: entre VCC (pata 8) y GND (pata 1) V DC | 5.0 V (entre 4.75 y 5.25 V) | 0 V: falta el cable de alimentación del chip o su GND. Si mide menos de 4.75 V, revisa el regulador de 5 V.

## 8 Encoder y F-V · placa E

### Componentes de este bloque (sepáralos antes de armar)

Cant. | Componente | Nombres
1 | 74HC08 | U12
1 | LM393 | U3
1 | NE555 | U7
1 | 1 nF | Cd
2 | 1 µF | Cfv, Cfv2
2 | 10 nF | Ct7, Ccvm
1 | 1N4148 | Dcl
1 | optointerruptor ranurado | OPTO
1 | 1M | Rhe
1 | 220 | Rled
7 | 10k | Rpe, Ru1, Ru2, Rpq, Rtg, Rfv, Rfv2
1 | 20k | Rt7

### Conexiones pata por pata

Pieza | Pata | Nombre | Agujero | Va a
U12 74HC08 | 1 | 1A | E-F50 | ENC.mono → U7 pata 3, U12 pata 2
| 2 | 1B | E-F49 | ENC.mono → U7 pata 3, U12 pata 1
| 3 | 1Y | E-F48 | ENC.mq → Rfv pata 1
| 4 | 2A | E-F47 | GND (0 V) (riel)
| 5 | 2B | E-F46 | GND (0 V) (riel)
| 6 | 2Y | E-F45 | sin conexión
| 7 | GND | E-F44 | GND (0 V) (riel)
| 8 | 3Y | E-E44 | sin conexión
| 9 | 3A | E-E45 | GND (0 V) (riel)
| 10 | 3B | E-E46 | GND (0 V) (riel)
| 11 | 4Y | E-E47 | sin conexión
| 12 | 4A | E-E48 | GND (0 V) (riel)
| 13 | 4B | E-E49 | GND (0 V) (riel)
| 14 | VCC | E-E50 | +5 V (riel)
U3 LM393 | 1 | OUT A | E-F56 | ENC.eq → Rpq pata 2, Rhe pata 1, Cd pata 1
| 2 | IN- A | E-F55 | enc → Rpe pata 2, OPTO pata C
| 3 | IN+ A | E-F54 | ENC.eref → Ru1 pata 2, Ru2 pata 1, Rhe pata 2
| 4 | GND | E-F53 | GND (0 V) (riel)
| 5 | IN+ B | E-E53 | GND (0 V) (riel)
| 6 | IN- B | E-E54 | GND (0 V) (riel)
| 7 | OUT B | E-E55 | sin conexión
| 8 | VCC | E-E56 | +5 V (riel)
U7 NE555 | 1 | GND | E-F62 | GND (0 V) (riel)
| 2 | TRIG | E-F61 | ENC.tg → Cd pata 2, Rtg pata 2, Dcl pata A
| 3 | OUT | E-F60 | ENC.mono → U12 pata 1, U12 pata 2
| 4 | RESET | E-F59 | +5 V (riel)
| 5 | CTRL | E-E59 | ENC.cvm → Ccvm pata 1
| 6 | THR | E-E60 | ENC.dis7 → Rt7 pata 2, Ct7 pata 1, U7 pata 7
| 7 | DISCH | E-E61 | ENC.dis7 → Rt7 pata 2, Ct7 pata 1, U7 pata 6
| 8 | VCC | E-E62 | +5 V (riel)
Ccvm 10 nF | 1 | | E-C42 | ENC.cvm → U7 pata 5
| 2 | | E-C40 | GND (0 V) (riel)
Cd 1 nF | 1 | | E-D43 | ENC.eq → Rpq pata 2, Rhe pata 1, U3 pata 1
| 2 | | E-D41 | ENC.tg → Rtg pata 2, Dcl pata A, U7 pata 2
Cfv 1 µF | + | | E-H39 | ENC.vf1 → Rfv pata 2, Rfv2 pata 1
| - | | E-H37 | GND (0 V) (riel)
Cfv2 1 µF | + | | E-H34 | vspd → Rfv2 pata 2, U5 pata 5
| - | | E-H32 | GND (0 V) (riel)
Ct7 10 nF | 1 | | E-D51 | ENC.dis7 → Rt7 pata 2, U7 pata 6, U7 pata 7
| 2 | | E-D49 | GND (0 V) (riel)
Dcl 1N4148 | A | | E-J61 | ENC.tg → Cd pata 2, Rtg pata 2, U7 pata 2
| K | | E-J57 | +5 V (riel)
OPTO optointerruptor ranurado | A | | E-F33 | ENC.nled → Rled pata 2
| K | | E-F32 | GND (0 V) (riel)
| C | | E-E33 | enc → Rpe pata 2, U3 pata 2
| E | | E-E32 | GND (0 V) (riel)
Rfv 10k | 1 | | E-F43 | ENC.mq → U12 pata 3
| 2 | | E-F39 | ENC.vf1 → Cfv pata +, Rfv2 pata 1
Rfv2 10k | 1 | | E-J39 | ENC.vf1 → Rfv pata 2, Cfv pata +
| 2 | | E-J35 | vspd → Cfv2 pata +, U5 pata 5
Rhe 1M | 1 | | E-I58 | ENC.eq → Rpq pata 2, Cd pata 1, U3 pata 1
| 2 | | E-I54 | ENC.eref → Ru1 pata 2, Ru2 pata 1, U3 pata 3
Rled 220 | 1 | | E-E31 | +5 V (riel)
| 2 | | E-E27 | ENC.nled → OPTO pata A
Rpe 10k | 1 | | E-H59 | +5 V (riel)
| 2 | | E-H55 | enc → OPTO pata C, U3 pata 2
Rpq 10k | 1 | | E-C56 | +5 V (riel)
| 2 | | E-C52 | ENC.eq → Rhe pata 1, Cd pata 1, U3 pata 1
Rt7 20k | 1 | | E-A62 | +5 V (riel)
| 2 | | E-A58 | ENC.dis7 → Ct7 pata 1, U7 pata 6, U7 pata 7
Rtg 10k | 1 | | E-A38 | +5 V (riel)
| 2 | | E-A34 | ENC.tg → Cd pata 2, Dcl pata A, U7 pata 2
Ru1 10k | 1 | | E-E39 | +5 V (riel)
| 2 | | E-E35 | ENC.eref → Ru2 pata 1, Rhe pata 2, U3 pata 3
Ru2 10k | 1 | | E-D57 | ENC.eref → Ru1 pata 2, Rhe pata 2, U3 pata 3
| 2 | | E-D53 | GND (0 V) (riel)

### Cables de este bloque

Cable | Red | De | A
[67] | GND (0 V) | E-G62 | E-riel GND izq fila 62
[68] | GND (0 V) | E-G53 | E-riel GND izq fila 53
[69] | GND (0 V) | E-B53 | E-riel GND der fila 53
[70] | GND (0 V) | E-B54 | E-riel GND der fila 54
[71] | GND (0 V) | E-G47 | E-riel GND izq fila 47
[72] | GND (0 V) | E-G46 | E-riel GND izq fila 46
[73] | GND (0 V) | E-G44 | E-riel GND izq fila 44
[74] | GND (0 V) | E-D45 | E-riel GND der fila 44
[75] | GND (0 V) | E-D46 | E-riel GND der fila 46
[76] | GND (0 V) | E-C48 | E-riel GND der fila 48
[77] | GND (0 V) | E-C49 | E-riel GND der fila 49
[78] | GND (0 V) | E-F37 | E-riel GND izq fila 37
[79] | GND (0 V) | E-E40 | E-riel GND der fila 40
[80] | GND (0 V) | E-G32 | E-riel GND izq fila 31
[81] | GND (0 V) | E-D32 | E-riel GND der fila 31
[111] | +5 V | E-G59 | E-riel +5 V der fila 59
[112] | +5 V | E-D62 | E-riel +5 V der fila 62
[113] | +5 V | E-B56 | E-riel +5 V der fila 56
[114] | +5 V | E-C50 | E-riel +5 V der fila 50
[115] | +5 V | E-F57 | E-riel +5 V der fila 58
[116] | +5 V | E-D39 | E-riel +5 V der fila 38
[117] | +5 V | E-D38 | E-riel +5 V der fila 37
[118] | +5 V | E-D31 | E-riel +5 V der fila 31
[190] | vspd | D-G58 | E-F35
[191] | vspd | E-G35 | E-F34
[204] | ENC.tg | E-G61 | E-E41
[205] | ENC.tg | E-B41 | E-D34
[206] | ENC.mono | E-G60 | E-G50
[207] | ENC.mono | E-H50 | E-G49
[208] | ENC.cvm | E-D59 | E-E42
[209] | ENC.dis7 | E-D60 | E-D61
[210] | ENC.dis7 | E-C60 | E-E58
[211] | ENC.dis7 | E-D58 | E-E51
[212] | ENC.eq | E-G56 | E-F58
[213] | ENC.eq | E-G58 | E-E52
[214] | ENC.eq | E-B52 | E-E43
[215] | enc | E-G55 | E-D33
[216] | ENC.eref | E-G54 | E-E57
[217] | ENC.eref | E-J54 | E-D35
[218] | ENC.mq | E-G48 | E-G43
[219] | ENC.nled | E-G33 | E-D27
[224] | ENC.nled | E-F33 | dispositivo OPTO · A
[225] | GND (0 V) | E-F32 | dispositivo OPTO · K
[226] | enc | E-E33 | dispositivo OPTO · C
[227] | GND (0 V) | E-E32 | dispositivo OPTO · E

### Pruebas al terminar el bloque

Medida | Esperado | Si no coincide
vspd: velocidad medida (sale del filtro doble) V DC | ≈ 0.51 V a 1394 rpm; 1.1 mV por Hz de encoder | 0 V con el motor girando: el encoder no da pulsos.
U3 LM393: entre VCC (pata 8) y GND (pata 4) V DC | 5.0 V (entre 4.75 y 5.25 V) | 0 V: falta el cable de alimentación del chip o su GND. Si mide menos de 4.75 V, revisa el regulador de 5 V.
U7 NE555: entre VCC (pata 8) y GND (pata 1) V DC | 5.0 V (entre 4.75 y 5.25 V) | 0 V: falta el cable de alimentación del chip o su GND. Si mide menos de 4.75 V, revisa el regulador de 5 V.
U12 74HC08: entre VCC (pata 14) y GND (pata 7) V DC | 5.0 V (entre 4.75 y 5.25 V) | 0 V: falta el cable de alimentación del chip o su GND. Si mide menos de 4.75 V, revisa el regulador de 5 V.
