DiegoCrUz-afk/Proyecto_Final_Electronica_UNIS/Reduccion2/2_Montaje_3D/Protoboards_3D_reduccion2.html

☰ Panel

🔌 Patas: SÍ (P) 🏷 Nombres: SÍ (N)

▲⤒ ◀▼▶⤓ ＋－

Arrastra = girar · WASD / flechas = moverte · Q/E = bajar/subir · N = nombres · P = patas · Rueda = zoom hacia el cursor · Doble clic = ir ahí · Clic en pieza o cable = detalles

Tu navegador no pudo abrir WebGL. Prueba con Chrome o Edge actualizado.

# Protoboards 3D · Reducción 2 (5 V)

Guía para armar la Reducción 2 (sensor IR, lógica, pestillo de falla, LED de objeto y potencia a 5 V directos). Placas A, B y C = las 3 protoboards de la PRO'S KIT BX-4135 (63 filas, letras J-F a la izquierda y E-A a la derecha, filas numeradas desde 0 abajo como en tu tablero; los rieles de en medio se comparten). Reparto parejo: A: entrada de 5 V, potencia y LED rojo · B: sensor IR y entradas E, G, RESET (74HC14) · C: pestillo, decisión (74HC00, 74HC08) y LED de objeto. Es una versión de validación por fases, no la entrega final.

## Vistas

## Enfocar una protoboard

Elige una protoboard (o teclas 1-3; 0 = todas): se muestra sola y aparecen únicamente las que tienen cables hacia ella.

Mostrar también las piezas de las placas conectadas Ocultar los cables que salen a otras placas o a dispositivos (queda solo esta placa) Ocultar los cables de alimentación (GND, 5 V)

▶ Armar esta placa paso a paso◀▶

## Moverte

✋ Modo mover: arrastrar desplaza

W A S D o flechas · Q / E bajar / subir · Shift más rápido · rueda zoom hacia donde apuntas · doble clic ir a ese punto

## Bloque (muestra solo uno)

Clic en un bloque para ver solo sus piezas y los cables que le llegan. Otra vez para quitar el filtro.

## Modo medición (encontrar el error)

Mides un bloque a la vez, de la entrada hacia el final. En cada medición el 3D marca dónde va la punta roja y la negra y te dice cuánto debería dar. Marca si salió bien o no: si no salió igual, te dice la causa probable y qué revisar. No cambia ninguna pieza ni cable.

▶ Empezar por la entrada↺ Borrar marcas

## Buscar pieza

Modo enfoque: al seleccionar, ocultar lo que no está conectado Piezas Puentes de alambre (lado de piezas) Cables entre placas y a dispositivos Nombres de piezas Etiquetas de agujeros (al seleccionar) …también de lejos (se amontonan) Número de cable [n] Filas, columnas y zonas Patas de IC y transistores Banda, motor, sensores e interruptores

## Armado paso a paso

Primero elige qué placa armar (o Todas) y luego pulsa Activar:

Activar◀▶▶ Auto

## Detalle

Haz clic en una pieza o en un cable.
