DiegoCrUz-afk/Proyecto_Final_Electronica_UNIS/3_archivos_tecnicos/montaje3d/plantilla_montaje3d.html

↔ Ver las placas de cobre (PCB) ☰ Panel

🔌 Patas: SÍ (P) 🏷 Nombres: SÍ (N)

▲⤒ ◀▼▶⤓ ＋－

Arrastra = girar · WASD / flechas = moverte · Q/E = bajar/subir · N = nombres · P = patas · Rueda = zoom hacia el cursor · Doble clic = ir ahí · Clic en pieza o cable = detalles

Tu navegador no pudo abrir WebGL. Prueba con Chrome o Edge actualizado.

# Montaje 3D · miniestación industrial

3 placas perforadas soldadas (A, B, C), una zona por bloque del esquemático. Los cables de señal van por arriba (numerados); la alimentación (GND, 5 V, 12 V) va por barras de cobre en el borde izquierdo de cada placa. Es una referencia de montaje calculada desde el esquemático; no es un montaje probado.

## Vistas

## Funcionamiento (simulación)

Reproduce la simulación real de LTspice del sistema completo (4.6 s): la banda, el motor y el objeto se mueven, la cubierta se abre, el NTC se calienta, la alarma se enciende y los cables cambian de color según la señal. Es la simulación con el motor supuesto, no una medición. El giro del disco se dibuja más lento que el real.

▶ Activar modo funcionamiento

▶Ver la banda

Saltar a un momento:

Colorear los cables según la señal (verde = 1 lógico, azul→rojo = nivel analógico)

## Moverte

✋ Modo mover: arrastrar desplaza

W A S D o flechas · Q / E bajar / subir · Shift más rápido · rueda zoom hacia donde apuntas · doble clic ir a ese punto

## Bloque (muestra solo uno)

Clic en un bloque para ver solo sus piezas y los cables que le llegan. Otra vez para quitar el filtro.

## Qué medir (multímetro / osciloscopio)

Toca una medida: el 3D te lleva al punto, marca la punta ROJA (+) y la punta NEGRA (−) en la barra de GND. Valores calculados o de simulación (LTspice y Multisim, motor supuesto); no son mediciones de la máquina. Pon tu medida real al lado.

## Buscar pieza

## Resaltar una red (quita el resto)

Clic en un color otra vez para quitar el filtro. GND, 5 V y 12 V van por las barras de cada placa.

## Mostrar

Modo enfoque: al seleccionar, ocultar lo que no está conectado Piezas Cables de señal Cables entre placas y a dispositivos Nombres de piezas Etiquetas de agujeros (al seleccionar) …también de lejos (se amontonan) Número de cable [n] Filas, columnas y zonas Patas de IC y transistores Ver el cobre de abajo (placa transparente) Banda, motor, sensores e interruptores

## Armado paso a paso

Activar◀▶▶ Auto

## Detalle

Haz clic en una pieza o en un cable.
