DiegoCrUz-afk/Proyecto_Final_Electronica_UNIS/Reduccion2/1_LTspice/resultado_logica.md

| E | G | P | F | M | N | L | esperado M N L | LED objeto (mA) | ok |
|---|---|---|---|---|---|---|---|---|---|
| 0 | 0 | 0 | 0 | 0 | 0 | 0 | 0 0 0 | 0.0 | OK |
| 0 | 0 | 1 | 0 | 0 | 0 | 0 | 0 0 0 | 4.4 | OK |
| 0 | 1 | 0 | 0 | 0 | 0 | 0 | 0 0 0 | 0.0 | OK |
| 0 | 1 | 1 | 0 | 0 | 0 | 0 | 0 0 0 | 4.4 | OK |
| 1 | 0 | 0 | 0 | 0 | 0 | 0 | 0 0 0 | 0.0 | OK |
| 1 | 0 | 1 | 0 | 0 | 0 | 0 | 0 0 0 | 4.4 | OK |
| 1 | 1 | 0 | 0 | 1 | 1 | 0 | 1 1 0 | 0.0 | OK |
| 1 | 1 | 1 | 0 | 1 | 0 | 1 | 1 0 1 | 4.4 | OK |
| 0 | 0 | 0 | 1 | 0 | 0 | 0 | 0 0 0 | 0.0 | OK |
| 0 | 0 | 1 | 1 | 0 | 0 | 0 | 0 0 0 | 4.4 | OK |
| 0 | 1 | 0 | 1 | 0 | 0 | 0 | 0 0 0 | 0.0 | OK |
| 0 | 1 | 1 | 1 | 0 | 0 | 0 | 0 0 0 | 4.4 | OK |
| 1 | 0 | 0 | 1 | 0 | 0 | 0 | 0 0 0 | 0.0 | OK |
| 1 | 0 | 1 | 1 | 0 | 0 | 0 | 0 0 0 | 4.4 | OK |
| 1 | 1 | 0 | 1 | 0 | 0 | 0 | 0 0 0 | 0.0 | OK |
| 1 | 1 | 1 | 1 | 0 | 0 | 0 | 0 0 0 | 4.4 | OK |

| Pestillo | F | M | esperado F,M | ok |
|---|---|---|---|---|
| L1_FALLA_pulsada | 1 | 0 | 1,0 | OK |
| L2_RESET_con_FALLA_pulsada | 1 | 0 | 1,0 | OK |
| L3_FALLA_suelta_sin_reset | 1 | 0 | 1,0 | OK |
| L4_RESET_con_FALLA_suelta | 0 | 1 | 0,1 | OK |

Errores: 0
