DiegoCrUz-afk/Proyecto_Final_Electronica_UNIS/2_LTspice/SISTEMA_COMPLETO.asc

Bn: bi; I=V(v5,tnode)/(10k*exp(3950*(1/(V(tc)+273.15)-1/298.15)))
Bph: bi; I=20*V(w)/(2*pi)
Bsl: bv; V=0.3+4.4*u(sin(2*pi*V(ph)))
Bw: bi; I=Ke*I(Lm)-Bfr*V(w)-V(tl)*tanh(V(w))
C2_REG: cap; 100n
Ccv_PWM: cap; 10n
Ccvm_ENC: cap; 10n
Cd_ENC: cap; 1n
Cd_OC: polcap; 10u
Cef_LOG: cap; 100n
Cf6_ERR: cap; 10n
Cfv2_ENC: cap; 1u
Cfv_ENC: cap; 1u
Cgf_LOG: cap; 100n
Cin: polcap; 1000u
Cout_REG: polcap; 100u
Cph: cap; 1 ic=0
Cpk_OC: cap; 100n
Cpor_LOG: cap; 1u
Cr_REF: cap; 100n
Crf_LOG: cap; 100n
Ct7_ENC: cap; 10n
Ct_PWM: cap; 10n
Cv_ERR: cap; 100n
Cvc_ERR: cap; 100n
Cw: cap; {J} ic=0
D1: diode; D1N4007
D1_OC: diode; D1N4148
Dcl_ENC: diode; D1N4148
Dfw_POT: diode; D1N5819
Dl_ALA: LED; DLED
Dled_ENC: LED; DIR
Dled_SEN: LED; DIR
Dpor_LOG: diode; D1N4148
DZ_REG: zener; D1N4734
Eb: bv; V=Ke*V(w)
Iph: current; PWL(0 2u 0.6 2u 0.6001 50u 1.1 50u 1.1001 2u)
Lm: ind; 3m
M1_POT: nmos; IRFZ44N_P
Q1_REG: npn; QBD139
Q2_SEN: npn; Q2N3904
Q3_POT: npn; Q2N3904
Q4_POT: pnp; Q2N3906
Q5_REF: npn; Q2N3904
Q6_ALA: npn; Q2N3904
R1_ERR: res; 10k
R1_SEN: res; 47k
R2_SEN: res; 10k
R3_ERR: res; 10k
R4_ERR: res; {Kerr*10k}
Ra5_PWM: res; 1k
Ra_OC: res; 10k
Ra_SEN: res; 10k
Ra_TMP: res; 22k
Rb5_PWM: res; 10k
Rb5_REF: res; 10k
Rb_ALA: res; 1k
Rb_OC: res; 10k
Rb_SEN: res; 26.8k
Rb_TMP: res; 68k
Rbl_OC: res; 22k
Rbz_ALA: res; 400
Rc_SEN: res; 680
Rd_OC: res; 10k
RE_SEN: res; 150
Renc: res; 1k
Rf6_ERR: res; {Kerr*10k}
Rf_OC: res; 6.8k
Rfix_TMP: res; 10k
Rfv2_ENC: res; 10k
Rfv_ENC: res; 10k
Rg_OC: res; 1k
Rg_POT: res; 47
Rh_SEN: res; 220k
Rh_TMP: res; 1Meg
Rhe_ENC: res; 1Meg
Rl_ALA: res; 470
Rled_ENC: res; 220
Rled_SEN: res; 270
Rm: res; 12
Ro_ERR: res; 1k
Rp1_OC: res; {10k*(1-koc)}
Rp1_REF: res; {10k*kvn}
Rp1_SEN: res; {10k*(1-kir)}
Rp1_TMP: res; {10k*(1-ktm)}
Rp2_OC: res; {10k*koc}
Rp2_REF: res; {10k*kvr}
Rp2_SEN: res; {10k*kir}
Rp2_TMP: res; {10k*ktm}
Rpd_POT: res; 10k
Rpe_ENC: res; 10k
Rpe_LOG: res; 10k
Rpg_LOG: res; 10k
Rpor_LOG: res; 47k
Rpq_ENC: res; 10k
Rpr_LOG: res; 10k
Rpu_PWM: res; 10k
Rpu_SEN: res; 10k
Rse_LOG: res; 10k
Rsg_LOG: res; 10k
Rsh_POT: res; 0.5
Rsn_LOG: res; 10k
Rsr_LOG: res; 10k
Rt7_ENC: res; 20k
Rt_REF: res; 68k
Rtg_ENC: res; 10k
Rtr_REG: res; 10
Ru1_ENC: res; 10k
Ru2_ENC: res; 10k
Rv1_ERR: res; 4.7k
Rv2_ERR: res; 5.1k
Rz_REG: res; 510
V12: voltage; PWL(0 0 10m 12)
Ve: voltage; PWL(0 0 0.05 0 0.0501 5)
Vg: voltage; PWL(0 0 0.05 0 0.0501 5 1.40 5 1.4001 0 1.60 0 1.6001 5)
Vr: voltage; PWL(0 0 2.60 0 2.6001 5 2.75 5 2.7501 0 3.55 0 3.5501 5 3.70 5 3.7001 0 4.20 0 4.2001 5 4.35 5 4.3501 0)
Vtc: voltage; PWL(0 25 3.0 25 3.5 60 3.8 25)
Vtl: voltage; PWL(0 0.004 1.9 0.004 1.9001 0.03 2.3 0.03 2.3001 0.004)
X5_PWM: NE555
X7_ENC: NE555
Xa1_LOG: HC_AND2
Xa2_LOG: HC_AND2
Xa3_LOG: HC_AND2
Xa4_LOG: HC_AND2
Xa5_POT: HC_AND2
Xb1_ENC: HC_BUF
Xbo_ERR: opamp2; LM358
Xbr_ERR: opamp2; LM358
Xbs_ERR: opamp2; LM358
Xg1_LOG: HC_NAND2
Xg2_LOG: HC_NAND2
Xg3_LOG: HC_NAND2
Xg4_LOG: HC_NAND2
Xi1_LOG: HC_SCHINV
Xi2_LOG: HC_SCHINV
Xi3_LOG: HC_SCHINV
Xi4_LOG: HC_SCHINV
Xi5_LOG: HC_SCHINV
Xi6_LOG: HC_SCHINV
Xu1_SEN: opamp2; LM393
Xu2_OC: opamp2; LM358
Xu2b_ERR: opamp2; LM358
Xu3_OC: opamp2; LM393
Xu4_TMP: opamp2; LM393
Xu6_PWM: opamp2; LM393
Xu7_ENC: opamp2; LM393
Named nets: vm, 0, reg_bz, v5, b, sen_c, sen_th, sh, oc_dl, oc_ref, setn, tnode, tmp_ref, ein, log_ef, log_e, gin, log_gf, log_g, rin, log_rf, log_rst, f, fn, log_reset_n, log_pn, p, m, log_m1, n, l, vref, enc, enc_eref, enc_eq, enc_tg, enc_mono, enc_dis7, enc_vf1, vspd, err_vrb, err_vsb, err_vob, err_voff, err_oa, vctrl, pwm_tri, pwm_tri_o, pwm_cv, pwm, pot_gate, dm, vin, tc, encs, n2, w, tl, ph
BLOQUE 1 - REGULADOR DE 5 V
vm (12 V despues del diodo) -> v5 (5 V). El Zener fija 5.6 V en la base de Q1 y la salida es esa tension menos 0.7 V.
Rtr (trimpot de 100 ohm) sube la salida unas decenas de mV para llevarla a 5.0 V.
DZ = Zener 1N4734A (5.6 V, 1 W). Q1 = BD139 con disipador: en el peor caso (13 V, 120 mA) disipa ~0.9 W.
Cout (100 uF) y C2 (100 nF) filtran la salida. La resistencia Rz (510 ohm) deja ~9 mA en el Zener.
BLOQUE 2 - SENSOR OPTICO IR
El fototransistor (TCRT5000) inyecta su corriente en el nodo b. Q2 (emisor comun) la amplifica.
El comparador (con histeresis por Rh) pone p = 1 cuando hay objeto.
LED infrarrojo (~14 mA)
trimpot 10k
histeresis
pull-up
Sin objeto: ~2 uA -> c queda en ~4.2 V (sobre el umbral) y p = 0. Con objeto: ~50 uA -> c baja a ~2.9 V y p = 1.
Ganancia de Q2 = -Rc / (re + RE) = -680 / (14 + 150) = -4. El trimpot mueve el umbral entre 2.9 V y 3.9 V.
BLOQUE 3 - SOBRECORRIENTE
La caida en el shunt (0.5 ohm, nodo sh) la amplifica el LM358: ganancia 1 + Rf/Rg = 7.8.
D1 y Cpk guardan el pico; Rd y Cd retrasan ~0.1 s (ignora el arranque); el comparador baja setn si hay falla.
trimpot 10k
Corriente de disparo ~ (Vref + 0.6 V) / (0.5 ohm x 7.8). Con Vref = 2 V: ~0.67 A. El trimpot Rp ajusta Vref.
Cd = 10 uF con Rd = 10k da ~0.1 s de retardo: el arranque del motor (~30 ms) no dispara, una sobrecarga sostenida si.
BLOQUE 4 - SOBRETEMPERATURA
El NTC de 10k va entre v5 y tnode; Rfix completa el divisor, asi tnode sube al calentarse.
Si tnode supera el umbral (trimpot, 45 a 55 C) el comparador baja setn. Rh da ~2.6 C de histeresis.
NTC 10k (externo): v5 -> tnode
trimpot 10k
NTC a 50 C = 3.6k -> tnode = 3.7 V. El trimpot mueve Vref de 3.4 V (44 C) a 3.9 V (57 C).
BLOQUE 5 - LOGICA COMBINACIONAL
Entradas: E (habilitar), G (cubierta cerrada), P (objeto), setn (falla de corriente o temperatura, activa en bajo) y el boton de reset.
Salidas: M = E.G.F' N = M.P' L = M.P A = F. F es un pestillo NAND: recuerda la falla hasta pulsar reset.
Rp: cable roto = 0 (seguro). Rs + C: antirrebote (1 ms). Dos inversores Schmitt (74HC14): senal limpia.
reset automatico al encender
pestillo (74HC00): setn = 0 pone F = 1
P' = NAND(P,P)
decision (74HC08)
BLOQUE 9 - REFERENCIA DE VELOCIDAD
Rt y el trimpot Rp1 fijan la referencia normal (~0.53 V).
Si l = 1, Q5 conecta Rp2 y baja vref a la mitad (velocidad reducida).
Rp1 y Rp2 son dos trimpots de 10k (normal y reducida): en la simulacion kvn y kvr indican la posicion del cursor.
Reducida = 50 % de la normal (el enunciado pide entre 40 % y 60 %).
BLOQUE 8 - ENCODER Y CONVERTIDOR FRECUENCIA-VOLTAJE
El fototransistor del optointerruptor (nodo enc, con pull-up Rpe) da pulsos al pasar las ranuras del disco. El comparador Xu7 los limpia.
El 555 monoestable da un pulso fijo de 220 us por cada uno; el filtro RC doble lo vuelve voltaje: vspd = 1.1 mV por Hz.
LED del optointerruptor
fototransistor
tw = 1.1 x Rt7 x Ct7 = 1.1 x 20k x 10 nF = 220 us. Vspd = 5 V x tw x f. A 500 Hz: 0.55 V.
Dcl protege la entrada del 555 contra el pico positivo del derivador (Cd y Rtg dan un pulso corto en cada flanco de bajada).
BLOQUE 10 - AMPLIFICADOR DE ERROR (LAZO CERRADO)
Tres seguidores (Xbr, Xbs, Xbo) aislan vref, la velocidad medida y el nivel Voff. Xu2b resta y multiplica por Kerr = 10:
vctrl = Kerr (vref - vspd) + Voff. Si la velocidad baja, vctrl sube y el PWM da mas potencia al motor.
Kerr = 10: un error de 0.1 V mueve vctrl 1 V. Voff = 2.6 V es el punto de partida (~55 % de PWM).
Un solo circuito integrado LM324 (cuatro amplificadores) contiene Xbr, Xbs, Xbo y Xu2b.
BLOQUE 6 - GENERADOR DE PWM
El NE555 oscila (~7 kHz): el nodo tri sube y baja entre 1.7 y 3.3 V (rampa).
El comparador pone pwm = 1 mientras vctrl > tri: a mayor vctrl, pulsos mas anchos.
f = 1.44 / ((Ra5 + 2 Rb5) Ct) = 1.44 / (21k x 10 nF) = 6.9 kHz. Ciclo de trabajo = (vctrl - 1.7 V) / 1.7 V: vctrl = 2.5 V da ~50 %.
El pin 3 del 555 (tri_o) no se usa: la rampa se toma del condensador Ct.
BLOQUE 7 - SEGURIDAD, EXCITADOR Y MOSFET
La compuerta AND deja pasar el PWM solo si M = 1: la seguridad manda sobre el PWM.
Q3 y Q4 (seguidor complementario) cargan y descargan la compuerta de M1. Dfw protege contra el pico del motor.
El motor va entre vm y dm. Con M1 encendido la corriente baja por el motor, M1 y el shunt Rsh (0.5 ohm, 5 W).
Al apagar M1 el motor sigue empujando corriente: pasa por Dfw (Schottky 1N5819) de dm a vm.
M1 = IRFZ44N: con 4.3 V en la compuerta conduce con ~0.07 ohm (con 10 V seria 0.02). Rg limita la corriente de la compuerta.
BLOQUE 11 - ALARMA
Cuando f = 1 (falla enclavada), Q6 conduce como interruptor y enciende el buzzer de 12 V
(en la simulacion el buzzer se representa con Rbz de 400 ohm). El LED indica la falla con luz.
buzzer activo 12 V (~30 mA)
LED rojo (~8 mA)
Ib = (4.9 - 0.7 V) / 1k = 4 mA. Ic = 30 mA. Ic/Ib = 7.5, menor que hFE: el transistor trabaja saturado, como interruptor.
ENTRADAS DE PRUEBA, FUENTE Y MOTOR (para simular)
La fuente de 12 V, los eventos (objeto, cubierta, carga extra, calor, reset) y el motor estan aqui; los bloques se unen a ellos por el nombre de la etiqueta azul.
Entrada: fuente externa de 12 V.
D1 protege contra polaridad inversa.
E, G (cubierta) y boton de reset con su guion de eventos.
fototransistor: 2 uA sin objeto, 50 uA con objeto (0.6 a 1.1 s)
NTC 10 k (B 3950): temperatura 25 C -> 60 C entre 3.0 y 3.5 s
encoder de 20 ranuras
motor DC 12 V (modelo supuesto): Ra 12, La 3 mH, Ke = Kt = 0.035
w = velocidad (rad/s) como voltaje; ph = fase del disco del encoder
SISTEMA COMPLETO - MINIESTACION INDUSTRIAL AUTOMATIZADA (esquematico completo, se simula con Run)
.param Kerr=10
.param kir=0.55
.param koc=0.2
.param ktm=0.5
.param kvn=0.8 kvr=0.7
.include ..\3_archivos_tecnicos\modelos.inc
.include ..\3_archivos_tecnicos\sistema.inc
.lib NE555.sub
.param Ke=0.035 J=1e-5 Bfr=7.2e-6
.tran 0 4.6 0 4u startup
.save V(v5) V(vm) V(p) V(setn) V(m) V(n) V(l) V(f) V(fn) V(vref) V(vspd) V(vctrl) V(pwm) V(dm) V(sh) V(tnode) V(tc) V(w) I(Lm) I(D1)
