DiegoCrUz-afk/Proyecto_Final_Electronica_UNIS/2_LTspice/SISTEMA_JERARQUICO.asc

Bn: bi; I=V(v5,tnode)/(10k*exp(3950*(1/(V(tc)+273.15)-1/298.15)))
Bph: bi; I=20*V(w)/(2*pi)
Bsl: bv; V=0.3+4.4*u(sin(2*pi*V(ph)))
Bw: bi; I=Ke*I(Lm)-Bfr*V(w)-V(tl)*tanh(V(w))
Cin: polcap; 1000u
Cph: cap; 1 ic=0
Cw: cap; {J} ic=0
D1: diode; D1N4007
Eb: bv; V=Ke*V(w)
Iph: current; PWL(0 2u 0.6 2u 0.6001 50u 1.1 50u 1.1001 2u)
Lm: ind; 3m
Renc: res; 1k
Rm: res; 12
V12: voltage; PWL(0 0 10m 12)
Ve: voltage; PWL(0 0 0.05 0 0.0501 5)
Vg: voltage; PWL(0 0 0.05 0 0.0501 5 1.40 5 1.4001 0 1.60 0 1.6001 5)
Vr: voltage; PWL(0 0 2.60 0 2.6001 5 2.75 5 2.7501 0 3.55 0 3.5501 5 3.70 5 3.7001 0 4.20 0 4.2001 5 4.35 5 4.3501 0)
Vtc: voltage; PWL(0 25 3.0 25 3.5 60 3.8 25)
Vtl: voltage; PWL(0 0.004 1.9 0.004 1.9001 0.03 2.3 0.03 2.3001 0.004)
XALARMA: BLOQUE_ALARMA
XENCODE: BLOQUE_ENCODER_FV
XERRORA: BLOQUE_ERROR_AMP
XLOGICA: BLOQUE_LOGICA
XPOTENC: BLOQUE_POTENCIA
XPWMGEN: BLOQUE_PWM_GEN
XREFVEL: BLOQUE_REFVEL
XREG5V: BLOQUE_REG5V
XSENSOR: BLOQUE_SENSOR_IR
XSOBREC: BLOQUE_SOBRECORRIENTE
XTEMPER: BLOQUE_TEMPERATURA
Named nets: vm, v5, b, p, sh, setn, tnode, ein, gin, rin, m, n, l, f, fn, vref, enc, vspd, vctrl, pwm, dm, vin, 0, tc, encs, n2, w, tl, ph
SISTEMA COMPLETO - MINIESTACION INDUSTRIAL AUTOMATIZADA
Cada recuadro es una hoja (BLOQUE_*.asc). Los bloques se conectan por nombre de nodo: v5 = 5 V, vm = 12 V despues del diodo, 0 = tierra.
Entradas del usuario: ein (E), gin (G, cubierta cerrada = 5 V), rin (reset); sensores: b (fototransistor), enc (encoder), tnode (NTC).
Se simula tal cual: la fuente, los eventos (objeto, cubierta, carga extra, calor, reset) y el motor estan en esta hoja.
Entrada: fuente externa de 12 V.
D1 protege contra polaridad inversa.
E, G (cubierta) y boton de reset con su guion de eventos.
fototransistor: 2 uA sin objeto, 50 uA con objeto (0.6 a 1.1 s)
NTC 10 k (B 3950): temperatura 25 C -> 60 C entre 3.0 y 3.5 s
encoder de 20 ranuras
motor DC 12 V (modelo supuesto): Ra 12, La 3 mH, Ke = Kt = 0.035
w = velocidad (rad/s) como voltaje; ph = fase del disco del encoder
.include ..\3_archivos_tecnicos\modelos.inc
.include ..\3_archivos_tecnicos\sistema.inc
.lib NE555.sub
.param Ke=0.035 J=1e-5 Bfr=7.2e-6
.tran 0 4.6 0 4u startup
.save V(v5) V(vm) V(p) V(setn) V(m) V(n) V(l) V(f) V(fn) V(vref) V(vspd) V(vctrl) V(pwm) V(dm) V(sh) V(tnode) V(tc) V(w) I(Lm) I(D1)
