DiegoCrUz-afk/Proyecto_Final_Electronica_UNIS/2_LTspice/1_regulador_5V.asc

C2: cap; 100n
Cin: polcap; 1000u
Cout: polcap; 100u
D1: diode; 1N4007
DZ: zener; D1N4734
Iload: current; {Il}
Q1: npn; QBD139
Rtr: res; {Rtr}
Rz: res; {Rz}
V1: voltage; 12
Named nets: 0, vm, bz, v5
REGULADOR DE 5 V (hito 2): diodo contra polaridad inversa + Zener + BJT de paso BD139
vm = 12 V despues del diodo (rama de potencia). bz = base del BD139 = voltaje del Zener. v5 = salida regulada.
.param Rz=510 Rtr=10 Il=0.12 Vz=5.6 BBD=100
.model D1N4734 D(Is=1f Rs=2 Cjo=100p Bv={Vz} Ibv=10m Nbv=2 mfg=aprox type=Zener)
.model QBD139 NPN(IS=1E-13 BF={BBD} NF=1 ISE=1E-13 NE=1.5 IKF=0.8 VAF=100 BR=10 RB=5 RE=0.1 RC=0.2 CJE=100p CJC=30p TF=1n Vceo=80 Icrating=1.5)
.step param Il list 0.03 0.075 0.12
.dc V1 11 13 0.5
