DiegoCrUz-afk/Proyecto_Final_Electronica_UNIS/2_LTspice/BLOQUE_ENCODER_FV.asc

Ccvm: cap; 10n
Cd: cap; 1n
Cfv2: cap; 1u
Cfv: cap; 1u
Ct7: cap; 10n
Dcl: diode; D1N4148
Dled: LED; DIR
Rfv2: res; 10k
Rfv: res; 10k
Rhe: res; 1Meg
Rled: res; 220
Rpe: res; 10k
Rpq: res; 10k
Rt7: res; 20k
Rtg: res; 10k
Ru1: res; 10k
Ru2: res; 10k
X7: NE555
Xb1: HC_BUF
Xu7: opamp2; LM393
Named nets: v5, enc, eref, eq, tg, mono, dis7, vf1, vspd, 0
BLOQUE 8 - ENCODER Y CONVERTIDOR FRECUENCIA-VOLTAJE
El fototransistor del optointerruptor (nodo enc, con pull-up Rpe) da pulsos al pasar las ranuras del disco. El comparador Xu7 los limpia.
El 555 monoestable da un pulso fijo de 220 us por cada uno; el filtro RC doble lo vuelve voltaje: vspd = 1.1 mV por Hz.
LED del optointerruptor
fototransistor
tw = 1.1 x Rt7 x Ct7 = 1.1 x 20k x 10 nF = 220 us.  Vspd = 5 V x tw x f.  A 500 Hz: 0.55 V.
Dcl protege la entrada del 555 contra el pico positivo del derivador (Cd y Rtg dan un pulso corto en cada flanco de bajada).
