DiegoCrUz-afk/Proyecto_Final_Electronica_UNIS/2_LTspice/BLOQUE_ERROR_AMP.asc

Cf6: cap; 10n
Cv: cap; 100n
Cvc: cap; 100n
R1: res; 10k
R3: res; 10k
R4: res; {Kerr*10k}
Rf6: res; {Kerr*10k}
Ro: res; 1k
Rv1: res; 4.7k
Rv2: res; 5.1k
Xbo: opamp2; LM358
Xbr: opamp2; LM358
Xbs: opamp2; LM358
Xu2b: opamp2; LM358
Named nets: vref, vm, vrb, vspd, vsb, voff, vob, v5, 0, oa, vctrl
BLOQUE 10 - AMPLIFICADOR DE ERROR (LAZO CERRADO)
Tres seguidores (Xbr, Xbs, Xbo) aislan vref, la velocidad medida y el nivel Voff. Xu2b resta y multiplica por Kerr = 10:
vctrl = Kerr (vref - vspd) + Voff. Si la velocidad baja, vctrl sube y el PWM da mas potencia al motor.
Kerr = 10: un error de 0.1 V mueve vctrl 1 V.  Voff = 2.6 V es el punto de partida (~55 % de PWM).
Un solo circuito integrado LM324 (cuatro amplificadores) contiene Xbr, Xbs, Xbo y Xu2b.
.param Kerr=10
