DiegoCrUz-afk/Proyecto_Final_Electronica_UNIS/2_LTspice/BLOQUE_REFVEL.asc

Cr: cap; 100n
Q5: npn; Q2N3904
Rb5: res; 10k
Rp1: res; {10k*kvn}
Rp2: res; {10k*kvr}
Rt: res; 68k
Named nets: v5, vref, l, 0
BLOQUE 9 - REFERENCIA DE VELOCIDAD
Rt y el trimpot Rp1 fijan la referencia normal (~0.53 V).
Si l = 1, Q5 conecta Rp2 y baja vref a la mitad (velocidad reducida).
Rp1 y Rp2 son dos trimpots de 10k (normal y reducida): en la simulacion kvn y kvr indican la posicion del cursor.
Reducida = 50 % de la normal (el enunciado pide entre 40 % y 60 %).
.param kvn=0.8 kvr=0.7
