DiegoCrUz-afk/Proyecto_Final_Electronica_UNIS/2_LTspice/BLOQUE_SENSOR_IR.asc

Cac: cap; 1u
Dled: LED; DIR
Q2: npn; Q2N3904
R1: res; 47k
R2: res; 10k
Ra: res; 10k
Rb: res; 26.8k
Rc: res; 680
RE: res; 150
Rh: res; 220k
Rled: res; 270
Rp1: res; {10k*(1-kir)}
Rp2: res; {10k*kir}
Rpu: res; 10k
Xu1: opamp2; LM393
Named nets: tin, b, c, th, p, v5, 0
BLOQUE 2 - SENSOR OPTICO IR
El fototransistor (TCRT5000) inyecta su corriente en el nodo b. Q2 (emisor comun) la amplifica.
El comparador (con histeresis por Rh) pone p = 1 cuando hay objeto.
LED infrarrojo (~14 mA)
trimpot 10k
histeresis
pull-up
Sin objeto: ~2 uA -> c queda en ~4.2 V (sobre el umbral) y p = 0.   Con objeto: ~50 uA -> c baja a ~2.9 V y p = 1.
Ganancia de Q2 = -Rc / (re + RE) = -680 / (14 + 150) = -4.  El trimpot mueve el umbral entre 2.9 V y 3.9 V.
.param kir=0.55
