DiegoCrUz-afk/Proyecto_Final_Electronica_UNIS/2_LTspice/BLOQUE_SOBRECORRIENTE.asc

Cd: polcap; 10u
Cpk: cap; 100n
D1: diode; D1N4148
Ra: res; 10k
Rb: res; 10k
Rbl: res; 22k
Rd: res; 10k
Rf: res; 6.8k
Rg: res; 1k
Rp1: res; {10k*(1-koc)}
Rp2: res; {10k*koc}
Xu2: opamp2; LM358
Xu3: opamp2; LM393
Named nets: sh, vm, 0, dl, ref, v5, setn
BLOQUE 3 - SOBRECORRIENTE
La caida en el shunt (0.5 ohm, nodo sh) la amplifica el LM358: ganancia 1 + Rf/Rg = 7.8.
D1 y Cpk guardan el pico; Rd y Cd retrasan ~0.1 s (ignora el arranque); el comparador baja setn si hay falla.
trimpot 10k
Corriente de disparo ~ (Vref + 0.6 V) / (0.5 ohm x 7.8). Con Vref = 2 V: ~0.67 A. El trimpot Rp ajusta Vref.
Cd = 10 uF con Rd = 10k da ~0.1 s de retardo: el arranque del motor (~30 ms) no dispara, una sobrecarga sostenida si.
.param koc=0.2
