DiegoCrUz-afk/Proyecto_Final_Electronica_UNIS/Reduccion2/1_LTspice/BLOQUE_BUZZER.asc

D: diode; D1N4148
Q: npn; Q2N3904
Rb: res; 4.7k
Rz: res; 400
Named nets: f, bzb, bzc, 0, v5
REDUCCION 2 - BUZZER DE FALLA (5 V)
Con falla (f = 1) el 2N3904 Q satura y el buzzer recibe casi 5 V; sin falla (f = 0) Q no conduce. f es la misma senal que enciende el LED rojo.
Rz es el buzzer magnetico activo de 12 V, aqui como resistencia SUPUESTA de 400 ohm (corriente real a 5 V: a medir). D protege a Q de la bobina del buzzer.
