DiegoCrUz-afk/Proyecto_Final_Electronica_UNIS/Reduccion2/1_LTspice/SISTEMA_COMPLETO_R2.asc

C2_POT: cap; 100n
Cb_POT: polcap; 100u
Cef_LOG: cap; 100n
Cgf_LOG: cap; 100n
Cin_POT: polcap; 1000u
Cpor_LOG: cap; 1u
Crf_LOG: cap; 100n
D_BZ: diode; D1N4148
Dfw_POT: diode; D1N5819
Dl_LOG: LED; DLED
Dled_SEN: LED; DIR
Dlo_LOG: LED; DLED
Dpor_LOG: diode; D1N4148
Iph: current; PWL(0 2u 0.4 2u 0.4001 50u 0.9 50u 0.9001 2u)
Lm: ind; 3m
M1_POT: nmos; IRLZ44N_P
Q2_SEN: npn; Q2N3904
Q_BZ: npn; Q2N3904
Qp_POT: npn; Q2N3904
R1_SEN: res; 47k
R2_SEN: res; 10k
Ra_SEN: res; 10k
Rb_BZ: res; 4.7k
Rb_POT: res; 1k
Rb_SEN: res; 26.8k
Rc_SEN: res; 680
RE_SEN: res; 150
Rf: res; 100
Rh_SEN: res; 220k
Rl_LOG: res; 470
Rled_SEN: res; 270
Rlo_LOG: res; 680
Rm: res; 12
Rp1_SEN: res; {10k*(1-kir)}
Rp2_SEN: res; {10k*kir}
Rpd_POT: res; 10k
Rpe_LOG: res; 10k
Rpg_LOG: res; 10k
Rpor_LOG: res; 47k
Rpr_LOG: res; 10k
Rpu_SEN: res; 10k
Rs_POT: res; 15
Rse_LOG: res; 10k
Rsg_LOG: res; 10k
Rsn_LOG: res; 10k
Rsr_LOG: res; 10k
Rz_BZ: res; 400
V5: voltage; PWL(0 0 1m 5)
Ve: voltage; PWL(0 0 0.05 0 0.0501 5)
Vf: voltage; PWL(0 5 1.20 5 1.2001 0 1.25 0 1.2501 5)
Vg: voltage; PWL(0 0 0.05 0 0.0501 5)
Vr: voltage; PWL(0 0 1.60 0 1.6001 5 1.70 5 1.7001 0)
Xa1_LOG: HC_AND2
Xa2_LOG: HC_AND2
Xa3_LOG: HC_AND2
Xa4_LOG: HC_AND2
Xg1_LOG: HC_NAND2
Xg2_LOG: HC_NAND2
Xg3_LOG: HC_NAND2
Xg4_LOG: HC_NAND2
Xi1_LOG: HC_SCHINV
Xi2_LOG: HC_SCHINV
Xi3_LOG: HC_SCHINV
Xi4_LOG: HC_SCHINV
Xi5_LOG: HC_SCHINV
Xi6_LOG: HC_SCHINV
Xu1_SEN: opamp2; LM393
Named nets: b, sen_c, sen_th, p, v5, 0, ein, log_ef, log_e, gin, log_gf, log_g, rin, log_rf, log_rst, setn, fn, log_reset_n, log_pn, m, log_m1, n, l, pot_ds, dm, f, bz_bzb, bz_bzc, vfal
BLOQUE 2 - SENSOR OPTICO IR
El fototransistor (TCRT5000) inyecta su corriente en el nodo b. Q2 (emisor comun) la amplifica.
El comparador (con histeresis por Rh) pone p = 1 cuando hay objeto.
LED infrarrojo (~14 mA)
trimpot 10k
histeresis
pull-up
Sin objeto: ~2 uA -> c queda en ~4.2 V (sobre el umbral) y p = 0. Con objeto: ~50 uA -> c baja a ~2.9 V y p = 1.
Ganancia de Q2 = -Rc / (re + RE) = -680 / (14 + 150) = -4. El trimpot mueve el umbral entre 2.9 V y 3.9 V.
Rp: cable roto = 0 (seguro). Rs + C: antirrebote (1 ms). Dos inversores Schmitt (74HC14): senal limpia.
reset automatico al encender
pestillo (74HC00): setn = 0 pone F = 1
P' = NAND(P,P)
decision (74HC08)
LED rojo de falla (A = F): 470 ohm, ~6 mA
LED de objeto (verde): enciende cuando pn = 0 (hay objeto), 4.4 mA
REDUCCION 2 - LOGICA
Reduccion 2: igual al original + LED de objeto (Rlo, Dlo). A = F se usa solo como LED rojo (ver bloque de potencia/placa A).
REDUCCION 2 - POTENCIA (5 V)
m (permiso) abre el IRLZ44N. El motor lleva SIEMPRE Rs en serie; con n = 1 el 2N3904 (Qp) puentea a Rs y el motor corre normal.
Con objeto n = 0: Qp se abre y el motor queda con Rs en serie (mas lento). Rs se ajusta por prueba (40 a 60 %). PROPUESTA NO VERIFICADA con el motor real.
Cin (entrada de 5 V)
El motor va entre v5 (M+) y dm (M-). Los condensadores Cb y C2 van cerca del motor.
Rs = 15 ohm sale de la simulacion con un motor SUPUESTO (12 ohm, 3 mH): 10 ohm daba 66 %, 15 ohm da 50 %. Con el motor real hay que reajustar.
IRLZ44N = MOSFET de nivel logico (modelo propio aproximado). Arranque: ~390 mA pico > 200 mA del 2N3904 (ver informe de simulacion).
REDUCCION 2 - BUZZER DE FALLA (5 V)
Con falla (f = 1) el 2N3904 Q satura y el buzzer recibe casi 5 V; sin falla (f = 0) Q no conduce. f es la misma senal que enciende el LED rojo.
Rz es el buzzer magnetico activo de 12 V, aqui como resistencia SUPUESTA de 400 ohm (corriente real a 5 V: a medir). D protege a Q de la bobina del buzzer.
FUENTE, ENTRADAS DE PRUEBA Y MOTOR (para simular)
La fuente de 5 V, los eventos (E, G, objeto, FALLA, RESET) y el motor supuesto estan aqui; los bloques se unen a ellos por el nombre de la etiqueta.
Fuente de 5 V (cargador USB / power bank)
E (interruptor)
G (cubierta cerrada)
RESET
Pulsador FALLA (lleva setn a GND)
fototransistor: 2 uA sin objeto, 50 uA con objeto (0.4 a 0.9 s)
Motor (SUPUESTO): 12 ohm en serie con 3 mH, entre v5 y dm. El N20 real se mide aparte.
SISTEMA COMPLETO - REDUCCION 2 (5 V): sensor IR, logica, potencia con motor, alarma luminosa y acustica (esquematico completo, se simula con Run)
.param kir=0.55
.include modelos.inc
.include sistema.inc
.include reduccion2.inc
.tran 0 2 0 20u
.save V(v5) V(p) V(setn) V(m) V(n) V(l) V(f) V(fn) V(dm) V(bz_bzc) V(bz_bzb)
.meas tran m_sin_objeto find V(m) at=0.3
.meas tran n_sin_objeto find V(n) at=0.3
.meas tran n_con_objeto find V(n) at=0.7
.meas tran l_con_objeto find V(l) at=0.7
.meas tran f_falla find V(f) at=1.4
.meas tran m_falla find V(m) at=1.4
.meas tran bzc_falla find V(bz_bzc) at=1.4
.meas tran f_tras_reset find V(f) at=1.9
.meas tran m_tras_reset find V(m) at=1.9
.meas tran bzc_sin_falla find V(bz_bzc) at=0.3
