DiegoCrUz-afk/Proyecto_Final_Electronica_UNIS/Reduccion2/1_LTspice/BLOQUE_LOGICA.asc

Cef: cap; 100n
Cgf: cap; 100n
Cpor: cap; 1u
Crf: cap; 100n
Dl: LED; DLED
Dlo: LED; DLED
Dpor: diode; D1N4148
Rl: res; 470
Rlo: res; 680
Rpe: res; 10k
Rpg: res; 10k
Rpor: res; 47k
Rpr: res; 10k
Rse: res; 10k
Rsg: res; 10k
Rsn: res; 10k
Rsr: res; 10k
Xa1: HC_AND2
Xa2: HC_AND2
Xa3: HC_AND2
Xa4: HC_AND2
Xg1: HC_NAND2
Xg2: HC_NAND2
Xg3: HC_NAND2
Xg4: HC_NAND2
Xi1: HC_SCHINV
Xi2: HC_SCHINV
Xi3: HC_SCHINV
Xi4: HC_SCHINV
Xi5: HC_SCHINV
Xi6: HC_SCHINV
Named nets: ein, ef, e, gin, gf, g, rin, rf, rst, setn, f, fn, reset_n, pn, p, v5, m, m1, n, l, 0
Rp: cable roto = 0 (seguro).  Rs + C: antirrebote (1 ms).  Dos inversores Schmitt (74HC14): senal limpia.
reset automatico al encender
pestillo (74HC00): setn = 0 pone F = 1
P' = NAND(P,P)
decision (74HC08)
LED rojo de falla (A = F): 470 ohm, ~6 mA
LED de objeto (verde): enciende cuando pn = 0 (hay objeto), 4.4 mA
REDUCCION 2 - LOGICA
Reduccion 2: igual al original + LED de objeto (Rlo, Dlo). A = F se usa solo como LED rojo (ver bloque de potencia/placa A).
