DiegoCrUz-afk/Proyecto_Final_Electronica_UNIS/9_Entregables_profesor/02_Simulacion_y_capturas/LTspice/BLOQUE_TEMPERATURA.asc

Ra: res; 22k
Rb: res; 68k
Rfix: res; 10k
Rh: res; 1Meg
Rp1: res; {10k*(1-ktm)}
Rp2: res; {10k*ktm}
Xu4: opamp2; LM393
Named nets: tnode, v5, ref, setn, 0
BLOQUE 4 - SOBRETEMPERATURA
El NTC de 10k va entre v5 y tnode; Rfix completa el divisor, asi tnode sube al calentarse.
Si tnode supera el umbral (trimpot, 45 a 55 C) el comparador baja setn. Rh da ~2.6 C de histeresis.
NTC 10k (externo): v5 -> tnode
trimpot 10k
NTC a 50 C = 3.6k -> tnode = 3.7 V. El trimpot mueve Vref de 3.4 V (44 C) a 3.9 V (57 C).
.param ktm=0.5
