DiegoCrUz-afk/Proyecto_Final_Electronica_UNIS/(list of files, drawings)

Other design files:
3_archivos_tecnicos/multisim/BLOQUE_ENCODER_FV.ms14
3_archivos_tecnicos/multisim/BLOQUE_POTENCIA.ms14
3_archivos_tecnicos/multisim/BLOQUE_SENSOR_IR.ms14
3_archivos_tecnicos/multisim/SISTEMA_COMPLETO.ms14
3_archivos_tecnicos/multisim/SISTEMA_COMPLETO_con_LED.ms14
3_archivos_tecnicos/pcb/salida/pcb_datos.json
7_Multisim/BLOQUE_ALARMA.ms14
7_Multisim/BLOQUE_ERROR_AMP.ms14
7_Multisim/BLOQUE_PWM_GEN.ms14
7_Multisim/BLOQUE_SOBRECORRIENTE.ms14
7_Multisim/BLOQUE_TEMPERATURA.ms14
7_Multisim/SISTEMA_SOLO_CIRCUITO.ms14
9_Entregables_profesor/02_Simulacion_y_capturas/Multisim/BLOQUE_LOGICA.ms14
9_Entregables_profesor/02_Simulacion_y_capturas/Multisim/BLOQUE_REFVEL.ms14
9_Entregables_profesor/02_Simulacion_y_capturas/Multisim/BLOQUE_REG5V.ms14
9_Entregables_profesor/02_Simulacion_y_capturas/Multisim/BLOQUE_SENSOR_IR.ms14
Entrega_Final/2_Esquematicos/SISTEMA_COMPLETO.ms14
