DiegoCrUz-afk/Proyecto_Final_Electronica_UNIS/(commit log)

2026-10-28 Proyecto final: miniestacion industrial (LTspice, Multisim, 3D protoboard, lista de compras)
2026-10-29 Lista de compras solo para protoboard: quitar piezas de placa
    - Jack, interruptor, pulsador y portafusible cambiados por versiones
    con cables o que entran en protoboard; se agrega estano
    - Precios corregidos (100 uF); se quitan del archivo de precios las
    placas de cobre, cloruro, papel, brocas y borneras
    - Arquitectura y LEEME del 3D: montaje en protoboard
    - Generador sin codigo de placas; total Q495.00
2026-10-31 Multisim: esquematico completo ordenado a mano (v6), PNG nuevo y LEEME actualizado
    - SISTEMA_COMPLETO.ms14 reemplazado por la version v6: R y C en horizontal, cables
    de alimentacion de amplificadores y compuertas separados, fuentes de prueba sin
    cables encima, LED de banda incluido.
    - Se quita SISTEMA_COMPLETO_con_LED.ms14 (la nueva ya trae el LED).
    - SISTEMA_COMPLETO_multisim.png regenerado desde la version final.
    - LEEME_MULTISIM.md y README.md actualizados.
2026-11-01 Quita Cac y PCB, agrega hoja LTspice solo circuito, guia LTspice, 7_Multisim con Din y Cin, 3D regenerado
2026-11-01 Multisim: circuito solo (sin fuentes), con LM555CM reales cableados y textos en los terminales
    Agrega 7_Multisim/SISTEMA_SOLO_CIRCUITO.ms14. Sus 79 redes coinciden con
    2_LTspice/SISTEMA_SOLO_CIRCUITO.asc; sin cables encimados ni sobre patas ajenas.
    LEEME_MULTISIM y README actualizados.
2026-11-01 Multisim: agrega la imagen (PNG) de SISTEMA_SOLO_CIRCUITO y la menciona en LEEME y README
2026-11-03 Lista de materiales por protoboard (PDF)
2026-11-04 3D v2: montaje en protoboards con menos cables (225 en vez de 278), misma conexion de redes
2026-11-04 CONTEXTO_PROYECTO.md: agrega seccion 15 (3D v2 y propuesta de LED de objeto), sin datos personales
2026-11-07 3D: opcion para enfocar una protoboard (muestra solo las placas conectadas)
2026-11-08 3D: WASD tras usar el panel, ocultar cables que salen o de alimentacion, armado paso a paso por protoboard
2026-11-08 3D: cables directo a los agujeros (sin bornera) y piezas de pasos anteriores se quedan en el paso a paso
2026-11-08 3D: en paso a paso por placa la camara muestra toda la placa (no se acerca a cada pieza)
2026-11-08 3D: enfocar placa ya no arrastra todas las placas por los cables de alimentacion
2026-11-08 3D: selector de placa dentro de Armado paso a paso
2026-11-08 3D: protoboard como las reales (letras, numeros, rieles cortados con puentes), paso a paso pieza+cable y conexiones a otras placas al final
2026-11-08 3D: opto como pieza real junto al motor, cables sin encimarse, LED de objeto (v2), valores calculados, maquina 3D desarmable
    - ruteo_bajo: segunda pasada que repara cables encimados (0 pares tocandose)
    - opto: 2+2 a los lados del canal, cables propios sin pasar sobre las patas, letras y carteles A K C E
    - v2: LED verde de objeto con R 470 entre v5 y pn (placa B), se enciende en la simulacion
    - R4 y Rf6 muestran 100k en vez de la formula
    - nuevo Maquina_3D_banda.html (WASD, cables numerados, vista desarmable) y Motor_opto_desmontado.html
2026-11-08 Pages: la v1 del 3D deja de publicarse (se conserva en el repo); README, LEEME y CONTEXTO actualizados
2026-11-08 Pages: se quita tambien el diagrama del motor (queda en el repo)
2026-11-09 3D v3: placas A-C en la BX-4135, bloques con pruebas, cables a ras sin cruces
    - Placas A, B y C son las 3 protoboards de la PRO'S KIT BX-4135 (rieles de en medio compartidos); D y E sueltas.
    - Colocacion por bloques con la huella real de cada pieza; busqueda del acomodo con menos cable.
    - Cables a ras de la placa por agujeros libres (maximo 9 mm), sin atravesar piezas ni otros cables (chequeo_choques.py: 0 y 0).
    - Muesca del CI en el extremo correcto, pines VCC y GND rotulados, disipador de 5 agujeros.
    - Panel por bloque (piezas y pruebas), paso a paso por bloques con pruebas; cables a la banda de ultimo.
    - Lista 2D de conexiones pata por pata (Lista_conexiones_v3.html).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
2026-11-09 Maquina 3D de la banda: cables y numeros tomados del 3D v3
2026-11-09 3D v3: polaridad de los 1 uF, LED de objeto 680 ohm, piezas externas como son, textos corregidos
    - Capacitores de 1 uF (lista de compras: electroliticos) con polaridad + / - (misma posicion).
    - LED de objeto: Rlo = 680 ohm (4.4 mA, VOL de la NAND 0.22 V, simulado en LTspice).
    - Interruptor toggle SPDT, final de carrera SPDT y pulsador NA 6x6x15 dibujados con sus patas y cual se suelda.
    - Prueba del diodo D1 corregida (la banda debe ir hacia vm, no hacia el jack).
    - Pruebas de VCC por chip y del LED de objeto; scripts que comparan el 3D con el esquematico completo.
    - README y LEEME: la v3 es la vigente.
2026-11-10 Reduccion 2 (5 V): 3D de protoboards con pruebas por bloque, guia de pruebas, simulaciones y esquematicos LTspice
2026-11-10 Reduccion 2: rieles izquierdos de las placas B y C siempre visibles, verificacion de conexiones contra datasheets, LEEME actualizado
2026-11-10 Reduccion 2: trimpot con tornillo visible y etiquetas 1 / W / 3 en el 3D
2026-11-10 Reduccion 2: tornillo del trimpot chico y del lado de la pata 1 (Bourns 3296)
2026-11-11 Reduccion 2: buzzer de falla (bloque 7) en el 3D sin mover lo armado, esquematico completo SISTEMA_COMPLETO_R2, guia de 46 pruebas
2026-11-11 Entregables, modo medicion del 3D v3, piezas de corte laser e integrantes del grupo
    - 9_Entregables_profesor: informe tecnico (PDF y Word, con portada de integrantes), simulaciones y capturas, guia de pruebas, guion de video, presentacion y preguntas de defensa
    - 3D v3: modo medicion (46 mediciones por bloque) y piezas externas como las de las fotos
    - 8_Maqueta_corte_laser: piezas en DWG 2010 (cm, carton de 1 mm) y DXF de respaldo
    - Scripts que generan los entregables y las piezas; README actualizado
2026-11-13 Entrega_Final del Diseno 1: informe, esquematicos, simulaciones, BOM con precios, datasheets, 3D y presentacion
